developlcy-oss/Lv2_Cartlidar_Assignment/workspace/ros2_ws/src/opencr_firmware/README.md

# opencr_firmware — OpenCR 보드 펌웨어 (Firmware 팀)

로봇에는 OpenCR 이 **2대** 있고, 같은 소스(`opencr_firmware.ino`)를 **역할별로 따로 빌드**해서 올린다.
두 보드의 펌웨어는 서로 바꿔 올리면 안 된다 — 빌드할 때 역할을 꼭 지정해야 하고(기본값 없음), 지정하지 않으면 빌드가 실패한다.

## 한눈에 — 주행 보드 vs 팔 보드

| | **주행 보드 (역할 1)** | **팔 보드 (역할 2)** |
|---|---|---|
| 빌드 | `tools/build_firmware.sh wheel` | `tools/build_firmware.sh arm` |
| 결과 파일 | `~/opencr_builds/opencr_wheel_v5.bin` | `~/opencr_builds/opencr_arm_v5.bin` |
| 빌드 옵션 | `OPENCR_BOARD_ROLE=1` | `OPENCR_BOARD_ROLE=2` |
| 모터 | 바퀴 XM430-W210 **4개, ID 1~4** | 팔 XM430-W350 6개, ID 11~16 |
| 모드 | Velocity (바퀴 각속도 rad/s) | Position (관절각 rad) |
| 그 밖 | IMU · 배터리 전압 | — |
| 패킷 칸 | 바퀴 칸 0~3 (칸 4 · 5 는 비움) | 팔 칸 6~11 |
| 설정 (`config.h`) | "주행 보드 전용" 구역 | "팔 보드 전용" 구역 |
| 명령 무수신 200 ms | 바퀴 0 | 그 자리에서 HOLD (토크 유지) |
| 호스트에서 명령하는 노드 | `drive_node` (`/cmd_vel` → diff_drive_controller) | `manipulator_node` (arm_controller) |

두 보드는 USB VID/PID · 시리얼 번호가 같아서 포트 이름으로는 구별되지 않는다.
**보드가 보내는 STATE 의 `role` 값(1 = 주행, 2 = 팔)으로 구별한다** — 호스트 플러그인(`opencr_hardware`)도 이 값으로 보드를 찾는다.

지금 보드에 무엇이 올라가 있는지 확인 (포트에 쓰지 않음):

```bash
python3 ../opencr_hardware/scripts/opencr_arm_tool.py monitor --port /dev/ttyACM0 --seconds 2
# 출력의 role=1 → 주행 펌웨어, role=2 → 팔 펌웨어. (주행 보드면 끝에 "팔 보드 v5 가 아님" 으로 끝나는 것이 정상)
```

## 빌드 · 업로드

필요: arduino-cli, OpenCR 보드 패키지 (1.5.3 에서 확인), Dynamixel2Arduino (0.8.2 에서 확인).

```bash
cd workspace/ros2_ws/src/opencr_firmware
tools/build_firmware.sh wheel                          # 주행 보드 펌웨어만 빌드
tools/build_firmware.sh arm                            # 팔 보드 펌웨어만 빌드
tools/build_firmware.sh wheel --upload /dev/ttyACM0    # 빌드 후 업로드 — 보드 역할을 yes 로 한 번 더 확인
```

- Arduino IDE 의 업로드 버튼은 쓰지 않는다 (역할 옵션을 넣을 수 없어 빌드가 실패함).
- 업로드가 `opencr_ld` 에서 멈추면 보드를 **Recovery Mode** 로 넣고 다시 실행: PUSH SW2 를 누른 채 Reset 을 눌렀다 떼고, SW2 를 뗀다 (STATUS LED 가 빠르게 깜빡임).
- PC 에서 포트 권한: `dialout` 그룹 + `../opencr_hardware/udev/99-opencr.rules` (ModemManager 가 포트를 잡지 않게 함).

## 주행 보드 (역할 1)

- 바퀴 4개 (2026-10-26 6륜에서 가운데 2개를 뺌). 칸 순서와 모터 ID:

  | 칸 | 바퀴 | ID | 방향 `WHEEL_DIR` |
  |---|---|---|---|
  | 0 | 왼쪽 앞 | 1 | +1 ★ |
  | 1 | 왼쪽 뒤 | 2 | +1 ★ |
  | 2 | 오른쪽 앞 | 3 | −1 ★ |
  | 3 | 오른쪽 뒤 | 4 | −1 ★ |

  호스트 쪽 같은 순서: `../opencr_hardware/urdf/opencr.ros2_control.xacro` (`wheel_count` 기본 4) · `config/controllers_4wd.yaml`.
- **모터 ID 다시 매기기가 필요하다**: 6륜 때 ID 는 왼쪽 1 · 2 · 3, 오른쪽 4 · 5 · 6 이었다. 가운데(2 · 5)를 뺐으므로 남은 모터를
  3 → 2, 4 → 3, 6 → 4 로 바꾼다 (`tools/dxl_setup`, 모터를 **한 대씩** 연결해서. 같은 ID 가 두 대 있으면 둘 다 바뀜).
  바꾸는 순서 주의: 4 → 3 을 하기 전에 3 → 2 를 먼저 (3 이 비어 있어야 함). 6 → 4 는 4 → 3 다음.
- `WHEEL_DIR` (★): 왼쪽 +1 · 오른쪽 −1 은 모터가 서로 마주 보게 달렸다는 가정이다. **바퀴를 띄운 상태에서 실제 회전 방향을 확인**하고 고친다.
  기준 URDF (urdfv2 `teamrobot.urdf`) 의 바퀴 축은 4개 모두 +y 라 + = 앞. 방향 반전은 `WHEEL_DIR` 로만 하고,
  **모터 Drive Mode 의 반전 비트는 0 으로 둔다** (urdfv2 문서의 "Drive Mode 반전" 은 이 펌웨어에서는 하지 않음 — 둘 다 하면 다시 거꾸로).
- `WHEEL_GEAR = 1.0` **고정** — 펌웨어는 모터 축 기준으로 명령 · 상태를 주고받는다. 증속벨트 (v7 1:2.0, 이전 1:1.5) 같은 기어비는
  호스트 `OpenCRHardware` 가 URDF `wheel_gear` 파라미터로 변환한다 (`drive:=belt|direct`). 여기서 바꾸면 두 번 적용된다.
  `WHEEL_VEL_LIMIT_RAW = 313` (★) = 71.7 rpm = 모터 7.51 rad/s → 바퀴 direct ≈ 0.248 m/s · belt ≈ 0.503 m/s (12 V, v7 1:2.0)
  (URDF 바퀴 한계는 11.1 V 기준 direct 7.33 · belt 14.661 rad/s (v7), #15).
  근거: 2026-11-11 T4 (12.1 V 어댑터, 바퀴 띄움) — 네 바퀴를 같은 속도로 앞 · 뒤 6 s 돌려 회전 수가 맞는 최대가 모터 7.61,
  7.71 부터 가장 약한 바퀴가 먼저 포화되어 어긋남 → 한 단계 아래 7.51. 한계가 포화보다 낮아야 D6 비례 축소가 회전 반경을 지킨다.
  배터리 (11.1 V 이하) 에서는 포화가 더 낮아질 것 (전압 비례 추정 약 7.0 · 10.5 V 약 6.6) → 배터리로 다시 재고 정한다 ★.
- 한계 초과 명령 (D6): 한 바퀴라도 넘으면 **모든 바퀴를 같은 비율로 줄인다** (좌우 속도비 = 회전 반경 유지). 개별 clamp 는 안전망으로 남김.
- 부팅 때 바퀴 모터 설정을 맞춘다 (`prepareWheelConfig`, 토크 OFF 상태에서 다를 때만 EEPROM 에 씀):
  **Drive Mode bit0 (반전) → 0**, **Velocity Limit (주소 44) < 313 이면 → 313**. 쓴 뒤 다시 읽어 맞지 않으면
  `ERR_MOTOR_CONFIG` + `ERR_FAULT` 로 토크를 거부한다. 따로 손으로 설정할 필요 없음 (지금 값 확인: `tools/dxl_setup` 의 `x <id>`).
- 부팅 때 바퀴 토크를 끄고 시작한다. 토크는 호스트가 `TORQUE_ON` 을 보낼 때 켜진다.
- **아직 실물에서 돌려 보지 않았다** (주행 보드 없이 SIL 시험만 함). 첫 실기는 바퀴를 띄우고 저속으로.
- **RC-100 리모컨 (2026-11-13, 주행 시험 조작용)**: 주행 보드의 BT-410 슬레이브 (**UART2 커넥터 = Serial4**, 57600, ROBOTIS `RC100` 라이브러리, 마스터는 RC-100B 에) 에서
  버튼을 읽어 STATE 의 빈 팔 칸에 싣기만 한다 — `pos[6]` = 버튼 비트, `pos[7]` = 마지막 패킷 뒤 ms + 1 (0 = 받은 적 없음,
  `opencr_protocol.h` `RC100_SLOT_*`). 길이 · 오프셋 · 버전 (v5) 은 그대로이고 예전 호스트는 이 칸을 읽지 않는다.
  **펌웨어는 리모컨으로 바퀴를 직접 움직이지 않는다** — 호스트 `rc100_joy` 가 `/joy` 로 바꿔 기존 조이스틱 경로 (teleop · E-stop) 로 보낸다
  (`ros2 launch opencr_hardware base_bringup.launch.py rc100:=true`, 방향 = 이동 · 1 = E-stop · 2 + 3 = 풀기). 시험: SIL `WheelForwardsRc100Buttons`.
  실물 (2026-11-13): RC-100B 는 누르는 동안 약 50 ~ 60 ms 마다 같은 패킷을 되풀이하고, 떼면 버튼 0 패킷을 보낸다.

## 팔 보드 (역할 2)

- 관절 칸 · 모터 ID (2026-10-26 실물 확인, **벤치 임시 매핑 ★** — 팀 규격과 다름, `../../../docs/opencr_v5_change_request.md`).
  칸 = STATE 의 관절 칸 (CMD 의 `arm_pos[0..5]` 와 같은 순서):

  | 칸 | 관절 | ID | 범위 (rad) |
  |---|---|---|---|
  | 6 | joint1 (허리) | 11 | −π ~ π (2026-10-27 arm_bench) |
  | 7 | joint2 (어깨) | 12 | −2.14 ~ 1.6 (대기 자세 포함, A안) |
  | 8 | joint3 (팔꿈치) | 13 | −1.6 ~ 1.60 |
  | 9 | joint4 (손목 굽힘) | 16 | −1.92 ~ 2.0 |
  | 10 | joint5 (손목 롤) | 14 | −2.8 ~ 2.8 |
  | 11 | 6 번째 칸 = **그리퍼 개폐 모터** (이름은 gripper_roll 그대로, 열림 1550 · 닫힘 2650 tick, 닫을수록 증가) | 15 | −0.7946 ~ 0.9541 (양 끝 20 tick 여유) |

  호스트 쪽 같은 범위: `../opencr_hardware/urdf/robot.urdf.xacro` (URDF 팔 한계) · `opencr.ros2_control.xacro` (명령 한계) — `test_robot_description` 이 확인.

- 모터 EEPROM 의 Min/Max Position Limit 도 위 범위와 같게 맞춰 두었다. **부팅 점검이 이를 확인**한다 —
  모터 한계가 펌웨어 범위보다 좁으면 범위 밖 목표를 모터가 조용히 버리기 때문에 (실제로 joint2 가 그랬음) FAULT 로 막는다.
- 위치 게인 (P/I/D, 모터 RAM) 은 `config.h` 의 `ARM_POS_*_GAIN` 을 부팅 때마다 쓰고 다시 읽어 확인한다 (다르면 FAULT).
  지금은 공장값 (P 800 · I 0 · D 0) — 중력 처짐 때문에 실물 튜닝 예정 ★. 6 번째 칸 (그리퍼) 은 I = 0 고정.
- **그리퍼 막힘 보호 (2026-10-27 arm_bench, `safety_core.h` GripGuard)**: 그리퍼 목표가 현재보다 `GRIP_STALL_TICKS` (45) 넘게 앞서 있는데
  `GRIP_STALL_MS` (300 ms) 동안 `GRIP_PROGRESS_TICKS` (8) 도 못 움직이면 = 물체를 잡음 → 목표를 "막힌 자리 + `GRIP_SQUEEZE_TICKS` (33)" 로 고정해 약하게 쥔다.
  호스트가 그보다 덜 닫는 쪽 (열기) 을 명령하면 풀린다. 빈 손으로 멀리 움직이는 중에는 (계단 명령이라도) 막힘이 아니다. HOLD 중에도 돈다.
  ESTOP · 토크 OFF 요청 HOLD 때 그리퍼 목표가 현재에서 45 tick 안이면 (쥐는 중) 그대로 둔다 — 퍽을 놓치지 않게.
  실물에서 퍽을 PWM 100 % 로 1.5 s 쥐다가 MOTOR_HW (과부하 추정) 가 나서 넣음. 위치 P 800 기준 1 tick ≈ PWM 6.25 (33 tick ≈ 23 %).
- 부팅 점검: 그리퍼 모터 EEPROM **PWM Limit ≤ `GRIP_PWM_LIMIT_MAX` (400 = 45 %)** — 공장값 885 면 FAULT (`tools/dxl_setup` 의 `w 15 400`).
- 팔은 명령이 끊기거나 ESTOP 이 와도 **토크를 끄지 않고 그 자리에서 HOLD** 한다 (무거운 그리퍼가 떨어지지 않게).
  HOLD 는 호스트의 REARM (리셋 버튼) 으로만 풀린다. 팔 토크를 끄는 방법은 사실상 전원 차단뿐 — 팔을 받친 뒤 끈다.
- 실기 시험 기록 · 알려진 문제: `../../../docs/arm_bench_test_2026-10-26.md` (중력 처짐 · 게인), `arm_bench_test_2026-10-27.md` (범위 · 그리퍼 결합 · 막힘 보호 실물 시험).
- ROS 없이 팔 보드만 시험: `../opencr_hardware/scripts/opencr_arm_tool.py` (monitor = 읽기만, move = 0.1 rad/s 이하 저속, `--yes` 필요).

## 공통 동작 (프로토콜 v5)

프레임 `FF FD | TYPE | LEN | PAYLOAD | CRC16-LE`, CMD 55 B · STATE 192 B (OpenCR 2대용 `role` 바이트 포함). 자세한 것은 `opencr_protocol.h`.

| 상황 | 주행 보드 | 팔 보드 |
|---|---|---|
| 정상 CMD (역할 · 유한값 · 범위 · seq 통과) | 바퀴 속도 적용 | HOLD 가 아니면 관절 목표 적용 |
| 200 ms 무수신 · 잘못된 CMD 만 옴 | 바퀴 0 (`ERR_CMD_TIMEOUT`) | HOLD (`ERR_HOLD`) |
| `FLAG_ESTOP` | 바퀴 0 | 현재 위치에서 HOLD |
| 부팅 점검 실패 (ID · 모델 · Homing 0 · 위치 한계) | `ERR_MOTOR_CONFIG` + `ERR_FAULT`, 토크 거부 | 같음 |

- `FLAG_REARM` (0x08) 상승 에지 = 팔 HOLD 해제. `ERR_HOLD` 0x40 · `ERR_FAULT` 0x80 은 v5 에서 추가.

### 배터리 · 부저 (두 보드, 2026-11-11)

보드마다 전용 배터리 (LiPo 3S 11.1 V 1800 mAh 5C, 만충 12.6 V — XM430 입력 10 ~ 14.8 V 안). 각 보드가 자기 전원 입력 전압을 10 ms 마다 재서
STATE `battery_v` 로 보내고 (예전에는 주행 보드만), 같은 전압으로 OpenCR 부저 (`BDPIN_BUZZER`, `tone()` — 타이머 인터럽트라 루프를 막지 않음) 를 울린다.
판단은 `battery_alarm.h` (1 초 평균 전압, 기준은 `config.h` "배터리 · 부저").

| 상태 | 조건 | 부저 |
|---|---|---|
| 배터리 없음 (USB 만) | 6 V 미만 | 울리지 않음 |
| 켤 때 · 다시 꽂을 때 | 1.5 s 뒤 평균이 자리 잡으면 | 잔량 1500 Hz: 75 % 이상 4 번 · 50 % 이상 3 번 · 25 % 이상 2 번 · 그 아래 1 번 |
| 저전압 (셀 3.70 V, 휴지 약 12 %) | 11.1 V 미만이 10 s | 2000 Hz 1 번, 30 s 마다 |
| 방전 직전 (셀 3.50 V) | 10.5 V 미만이 3 s | 2500 Hz 3 번, 2 s 마다 |

- 가속 때 잠깐 처지는 전압 (몇 초) 에는 울리지 않는다. 한 단계 위로 돌아오려면 기준 + 0.2 V 위가 3 s 이어져야 한다.
- **비프만 한다** — 모터는 건드리지 않는다. 멈추는 것은 호스트: `/diagnostics` `opencr/battery` 가 위험 (ERROR) → mission 정지.
- 쓰는 중 확인: `ros2 topic echo /battery/wheel` · `/battery/arm` (`sensor_msgs/BatteryState`, 1 Hz) 또는 `/diagnostics` 의 `opencr/battery`
  (주행 · 팔 전압 · 잔량 %). 잔량 % 는 휴지 전압 표 추정이라 주행 중에는 낮게 나온다 ★.
- 기준 전압 · 셀 수는 호스트 `../opencr_hardware/urdf/opencr.ros2_control.xacro` 의 `battery_warn_v · battery_error_v · battery_cells` 와 같아야 한다 (`test_robot_description` 이 비교).
- 전압 측정값은 멀티미터와 아직 비교하지 않았다 ★. 부저를 끄려면 `BATTERY_BEEP_ENABLE 0` (판단 · STATE 전압은 그대로).
- 물리 E-stop 회로는 아직 없다 (`ESTOP_PIN` 은 배선 전이라 풀업으로 "해제" 로 읽힘). 소프트웨어 ESTOP 은 물리 비상정지를 대신하지 않는다.
- 팀 규격 `../../../docs/interfaces.md` 의 승인본 (dev) 은 v3 (OpenCR 1대) 이다. 이 브랜치의 USB 패킷 절은 v5 제안이고,
  바뀐 점은 `../../../docs/opencr_v5_change_request.md` (Controller 팀장 승인 전 — dev/main 병합 금지).

## 파일

| 파일 | 내용 |
|---|---|
| `opencr_firmware.ino` | 펌웨어 본체 (두 역할 공용, `OPENCR_BOARD_ROLE` 로 나뉨) |
| `config.h` | ID · 방향 · 한계 · 주소 · 단위 (공통 / 주행 전용 / 팔 전용 구역) |
| `opencr_protocol.h` | 패킷 정의 — `../opencr_hardware/include/opencr_hardware/opencr_protocol.hpp` 와 **바이트 단위로 같아야 함** (시험이 비교) |
| `safety_core.h` | 안전 판단 (CMD 검증 · 타임아웃 · ESTOP · HOLD/REARM · FAULT · 그리퍼 막힘 GripGuard), Arduino 의존 없음 |
| `battery_alarm.h` | 배터리 잔량 표 · 저전압 비프 판단 (Arduino 의존 없음, 호스트도 같은 잔량 표를 씀) |
| `tools/build_firmware.sh` | 역할별 빌드 · 업로드 |
| `tools/dxl_setup/` | 모터 사전 설정 도구 (탐색 `s` · 정보 `r` · 진단 덤프 `x` · ID `i` · 통신 속도 `b` · 위치 한계 `m` · Homing Offset `o` · PWM 한계 `w`). 토크 ON 명령 없음 |

## 시험

ROS 2 (ros2_control) 가 있는 PC:

```bash
cd workspace/ros2_ws
colcon build --packages-up-to opencr_hardware && colcon test --packages-select opencr_hardware && colcon test-result --verbose
```

`test_firmware_sil` · `test_host_firmware_sil` 은 **실제 이 펌웨어 소스**를 PC 에서 컴파일해 가짜 모터 · 가짜 USB 와 돌린다 (두 역할 모두).
`test_battery_alarm` 은 `battery_alarm.h` (잔량 표 · 비프 판단, 실제 config.h 값) 와 호스트 진단 판정 (`../opencr_hardware/src/battery_status.hpp`) 을 본다.
실물 모터 동작을 보장하지는 않는다. ROS 가 없는 PC 에서 돌리는 방법은 저장소 루트 `CLAUDE.md` 의 "빌드 · 테스트".

## 아직 정하지 않은 것 (★)

- 바퀴: 모터 ID 다시 매기기 (실물), `WHEEL_DIR` 실측, 첫 부팅 때 STATE 에 `ERR_MOTOR_CONFIG` 가 없는지 확인 (실물),
  호스트 diff_drive 한계는 `opencr_hardware/config/drive_<direct|belt>.yaml` 에서 바퀴 한계에 맞춤 (D6 — 펌웨어는 비례 축소로 처리),
  실행 후 `ros2 param get /diff_drive_controller wheel_separation` 이 0.317 (belt) · 0.2744 (direct) 인지 확인 (spawner 두 번째 설정 파일 덮어쓰기, 실물 미확인),
  증속벨트 전류 보호 (설계 README: Present Current 약 0.6 A 초과 시 정지 — 제자리 회전 전류 실측 후 값 결정).
- 팔: 6 번째 칸 (그리퍼 개폐) 의 규격 반영 (Controller — `gripper_roll` 이름 · 팔 궤적의 기본값 0.0), 쥐는 힘 33 tick 확인 · 오래 쥘 때 온도,
  위치 게인 튜닝 (중력 처짐), 정밀 영점, J1 ±180° 배선 꼬임. (그리퍼 다시 결합 · 시작 자세 A안은 2026-10-27 끝)
- 공통: 물리 E-stop 배선, v5 · 4륜의 팀 규격 승인, D3 · D4 (`../../../docs/firmware_safety_analysis.md`).
