developlcy-oss/Lv2_Cartlidar_Assignment/workspace/ros2_ws/src/mission_planner/README.md

# mission_planner — 주사위 기억 로봇 할당 · 적재 · 경로 계획기

발제 v5 (2026-11-04) 미션용. ROS 없이도 돌아가는 Python 모듈 + 명령. 위치 추정 (AMCL · loc_monitor) 은 `localization` 패키지.

| 하는 일 | 파일 |
|---|---|
| 경기장 SDF → 정적 점유 지도 2 장 (주행용 `map_nav`, AMCL 용 `map_amcl`) | `mission_planner/arena.py`, `maps/` |
| 접근 자세표 (시작 박스 · L1 ~ L3 · 출발 구역) | `mission_planner/poses.py`, `config/approach_poses.yaml` |
| 신호 · 바코드 → 그룹, 퍽 → 그룹 할당 (전체 탐색, 비교용 순차 선택) | `mission_planner/allocation.py` |
| 팔레트 적재 · 방문 순서 (일반화 TSP, Held-Karp) | `mission_planner/gtsp.py`, `planner.py` |
| 주행 비용 (A* + 시야선 당기기 + 회전) | `mission_planner/pathcost.py` |

## 쓰는 법

```bash
colcon build --packages-select mission_planner && source install/setup.bash
mission_make_maps                                   # worlds/dice_mission.sdf 가 바뀌면 (지도 · 자세표 다시)
mission_plan --problem config/problem_q1_example.yaml --mode hybrid --out /tmp/plan   # plan.json · signal.json · allocation.json
mission_plan --problem <문제>.yaml --mode compare   # 두 운영 방식 비용 비교
mission_submit --problem <문제>.yaml --out <저장소>/submission/review   # 발제 후 검토 제출물 5 종 (problem.md · signals.json · placement.csv · 할당 정답표 · 검증 기록)
mission_challenge_b --out <저장소>/challenge/B      # 도전 B 제출물 (cases.json · expected.json · results.csv · report.md)
python3 -m pytest test                               # 시험 19 개 (할당 6 건 = 도전 B 형식, GTSP 최적성, 지도 · 자세, 계획)
```

문제 파일 (`config/problem_q1_example.yaml` 형식): `signal` (12 점멸), `barcode` (P2-01 ~ 04), `pucks` (id 0 ~ 11 · color red/green · shape cylinder/box · box 1 ~ 6 · side −1/+1).
`placement.csv` 가 나오면 같은 뜻으로 옮겨 쓴다 (설명용 예제의 색 · 모양은 임의).

## 지도 (문서 좌표)

- 원본 `worlds/dice_mission.sdf` = `urdf_and_usd/waffle_4wd_description/worlds/dice_mission.sdf` 복사본 (발제 좌표 mm / 1000, 원점 = 왼쪽 아래 기둥 중심, +Y 위).
- `map_nav`: 바닥 위 0 ~ 0.45 m 와 겹치는 충돌 형상 전부 (벽판 · 기둥 · 박스 70 mm · 장소 상자 · 신호등 · 바코드 받침). 0.025 m 칸.
- `map_amcl`: LiDAR 스캔면 (바닥 위 0.0748 m = LDS-03 브라켓 v2 base_link z 0.0675 + 0.00725, #249) 을 지나는 것만. 박스 · 장소 상자 (0.07 m) 는 스캔에 안 보여 뺌 (틈 4.75 mm, 실물 확인 필요).

## 접근 자세

- 로봇 외곽 (base_link): 앞 +0.1328 · 뒤 −0.2135 (뒤 카메라 기둥) · 폭 ±0.1676 (바퀴), J1 축 x 0.096. 판정은 격자가 아니라 SDF 원래 형상과 사각형 겹침 (분리축).
- 시작 박스: **두 퍽 (박스 중심 X ±40 mm) 을 잇는 선에 수직인 ±Y 면** (S = 남쪽에서 북쪽 보고, N = 북쪽에서). 두 퍽이 J1 앞 0.266 m · 옆 ±0.04 m (거리 0.270) 로 같아 한 번 서서 둘 다 집음.
  ±Y 가 둘 다 막힌 박스만 ±X 면 (inline → 두 퍽 0.227 / 0.306 m).
  지금 맵: B1 S · B2 S · B3 S/N · B4 S/N · B5 N · **B6 W (inline)** (B6 북쪽은 벽, 남쪽은 B2 와 0.53 m 라 대기 자세가 안 들어감).
- L1 · L2 · L3: 장소 태그 면 (L1 서쪽, L2 북쪽, L3 남쪽). 칸마다 J1 거리 → 수직 (≤ 0.23) / 45° 기울여 (≤ 0.35, 팀 URDF IK).
  L2 는 2026-11-04 확정으로 L1 · L3 과 같은 205 상자 (이전 820 받침대). 세 장소 모두 칸 J1 거리 0.206 ~ 0.332 m (45°, Isaac 칸 놓기 미검증).
- final = 집기 · 놓기 자세 = drive FINE 정렬 자리 (렌즈 → 면 0.13 = 앞 끝 − 면 0.1272, #64 안 A: TFmini 는 0.10 m 안을 못 재 더 붙지 않음), stage = nav2 목표 (standoff = 외곽 + 0.05 가 비고 그 자리에서 제자리 한 바퀴 (여유 0.005) 돌 수 있는 가장 큰 값, 0.45 부터 0.01 m 씩, #135), 출발 구역 = 로봇 중심 (0.734, 0.95), −X.

## 계획 (planner)

할당: R = 빨강, G = 초록, 12 개 모두 → Y 에 넣을 빨강 수 = 빨강 − R, 초록 수 = 초록 − G 로 정해짐. 남는 자유 (Y 모양 · ID) 를 전부 나열해 경로 비용 최소를 고름.
비교용 `allocate_greedy` (ID 순 순차 선택) 는 "한 모양 부족" 사례 (cases_b V3) 에서 실패함.

| mode | 내용 | 팔레트 |
|---|---|---|
| `hybrid` (기본, 팀 결정 2026-11-12) | 박스를 돌며 싣다가 어떤 L 의 퍽이 다 실리면 그 L 에 들러 한 번에 다 내리고 이어 감 (L 은 한 번씩) | 퍽 단위 LIFO (나중 배달 퍽이 아래 = 뒤 열). 칸은 `slots.assign` (아래 #230) |
| `per_location` | L 마다 그 그룹 퍽 박스들을 돌고 → L 에 놓기 (3 번 왕복) | 한 번에 6 개 이하 → 2 · 1 열 8 칸만 |
| `single_load` | 12 개 모두 싣고 → L 3 곳 | **팔레트 v5 (10 칸, 2026-11-13) 에서는 못 씀 → MissionError**. v3 (12 칸) 때: 3 열 → 2 열 → 1 열로 싣고 1 → 2 → 3 열로 꺼냄 |

방문 순서 = 일반화 TSP (박스 = 묶음, 접근 면 = 선택지, Held-Karp 정확해). L 순서 · 열 나누기는 전부 나열.
hybrid: L 배달 순서 (a, b, c) 마다 경로는 꼭 `HOME → C1 → B1 → A → La → C2 → B2 → Lb → C3 → Lc` 꼴 (런 = 한 그룹을 박스 순서 자유로 집기,
C2 는 B1 이 비었을 때만). 그룹마다 Held-Karp 표 (`hybrid._hk`, 같은 그룹 구성은 재사용) 를 numpy 로 만들고 (C1, B1) 모든 조합을 배열로 한 번에 셈.
비용 = 경로 + 3 열 칸 × `ROW3_PENALTY_M` 2.8 m (칸당 약 14 s × 0.2 m/s, 가정). 퍽 단위 완전 탐색 (상태 = 실은 퍽 집합) 과 무작위 14 문제에서 경로가 같음,
계산은 할당 전부 봐도 0.01 s 안팎 (PC, 완전 탐색은 할당 3 개에 약 25 s). 비용표 (`hybrid.Nodes`) 는 World 만들 때 (노드 시작) 미리 셈.
비용 = stage 사이 A* (로봇 반지름 0.19 m 부풀림, 시야선 당김) 길이 + 회전 0.1 m/rad + 들어가고 나오기 2 × (standoff − gap).
놓는 칸 순서 = J1 에서 먼 칸부터. 마지막 L 에서 나머지 L 을 다시 들러 새 관측 (재검증) → 출발 구역.

Q1 예제 (설명용 색 · 모양): hybrid 55.8, per_location 62.6 (경로 비용 m, 팔레트 v5 2026-11-13. v3 12 칸 때 hybrid 53.1 · single_load 54.4).
시간 가정 (0.2 m/s, 정차 15 s, 3 열 칸 +7 s) 으로 Q1 + 무작위 13 문제 평균: hybrid 412 s, per_location 470 s, single_load 481 s (14 문제 모두 hybrid 가 가장 빠름).

## AMCL

실행 · 설정은 `localization` 패키지 (`ros2 launch localization localization.launch.py`, `config/amcl.yaml`, 2026-11-04 이 패키지의 AMCL launch · 설정은 지움 — 둘 다 `/map` 을 내서 함께 띄우면 안 되므로).
아래는 이 패키지가 처음 정한 값의 비교 기록 (지금 팀 설정은 Omni 모델 등 5 개 값이 다름, #91). 시험 (`test/amcl_sim.py`: SDF 형상 광선 추적 스캔 + 지도에 없는 박스 위 퍽 12 개 + 오도메트리 눈금 오차 직진 2 % · 회전 6 %, Q1 경로 44 m, 4 배속):

| 설정 | 위치 오차 평균 / 95 % / 최대 | 방향 오차 최대 | 갱신 |
|---|---|---|---|
| **이 설정** (`map_amcl`) | **16 / 24 / 35 mm** | **1.7°** | 1778 |
| 같은 설정 + 박스 넣은 지도 | 17 / 25 / 35 mm | 1.8° | 1778 |
| nav2 기본값 (sigma_hit 0.2, alpha 0.2, update_min_d 0.25 …) | 32 / 69 / 134 mm | 6.0° | 505 |
| 오도메트리만 | 최종 1110 mm | | |

시뮬레이션 결과 (가짜 스캔) — 실물은 벽판 설치 오차 · LDS 잡음 · 바퀴 미끄럼으로 커질 수 있음. 출발 구역에서 시작 자세를 정확히 놓는 것이 전제 (전역 위치 찾기 안 함).

## mission_node 연동 (plan 모드)

```bash
ros2 launch mission_planner planner.launch.py pucks_file:=<퍽 등록표>.yaml [mode:=hybrid] [log_dir:=/tmp/mission_log]
ros2 launch mission mission_bringup.launch.py                    # 기본 source:=plan = mission_plan.yaml 덧씌움 (옛 태그 미션표는 source:=tag)
ros2 service call /mission/start std_srvs/srv/Trigger
```

흐름: `observe` (팔 TAG_VIEW → READ_SIGNAL | READ_BARCODE → /perception/signal CONFIRMED + /perception/barcode READ)
→ `plan` (/mission_planner/plan, std_srvs/Trigger → 단계 문장) → 계획 단계 실행.
robot_interfaces 는 동결 (바꿀 때는 docs/interfaces.md PR + Controller 승인, #160 에서 AlignBase `box_only` 추가). 계획 단계 (`mission_planner/mission_lines.py`):

| 단계 | mission_node 동작 |
|---|---|
| `goto x y yaw` | /drive/navigate (지도 좌표) + 팔 STOW |
| `approach 0.13` | 기존 approach (COARSE → READY → FINE, TFmini 하한 0.13). 집기 (퍽이 있는 박스) 앞 |
| `approach_box 0.13` | 장소 상자 앞 (놓기 · verify, #160): 주행 자세 → /drive/align `box_only` (퍽 없이 지금 방향 유지 + TFmini 로 면 0.13 m). 남는 좌우 · 각도는 measure_box |
| `skill manipulator <이름>` | /manipulator/execute_skill (manipulator_node). 집기 · 놓기는 모두 집게 45°: `target_look:base_footprint:x:y:z` (집기 전 팔 카메라로 퍽을 내려다보고 재서 붙잡음, 회전 뒤 예상 위치 `poses.puck_after_turn`, #82) → `toppick_tilt` (그 위치로 45° 집기), `pallet_load_<열>_<칸>_tilt`, `pallet_unload_<열>_<칸>_tilt` (속도 규칙 #75), `place_<L>_<dx>_<dy>_tilt` (dx, dy = m1 · 0 · p1) |
| `skill drive turn_<p\|m>17` · `turn_0` | /drive/execute_skill — drive_node (#77, 실제 회전 중심 보정 `base.icr_x` = control robot_geometry.yaml). 상자 퍽을 집기 전 FINE 정렬 방향에서 로봇 중심 둘레로 ±17° 제자리 회전 (J1→퍽 = 박스 축 = 퍽 면, ±3°), 집고 실은 뒤 `turn_0` 으로 되돌림. inline (박스 6) 은 회전 없음 |
| `verify L cx cy z expect9 yshape` | 팔 TAG_VIEW → READ_TAG+SEARCH_FRONT → /perception/check_dice (지도 좌표 칸) + /perception/pucks 로 칸별 퍽 ID · 위치 → 기록, 틀려도 계속 (stop_on_fail false) |
| `wait 3` | 복귀 뒤 정지 |

기록: 미션 (/mission/start 로 새로 시작) 마다 mission_node `<log_dir>/<YYMMDD_HHMM>/` 한 폴더 (bringup 기본 log_dir `~/Lv2_Cartlidar_Assignment/mission_log`, 같은 분이면 `_2`, PAUSED 재개는 같은 폴더) 에
mission_log.jsonl (observe · survey · plan · verify (칸 판정 · 칸별 퍽 ID · 위치) · verify_ids (마지막 verify 뒤 12 개 ID 중복 · 누락 판정) · snapshot · finish),
images/ (팔 카메라 사진 사건당 3 장: 이동 전 `<NN>_before_r<회차>_B<박스>_<k>.jpg` = survey_view, 이동 후 `<NN>_after_<L>_<k>.jpg` = verify),
planner/ (계획기 log_dir = `<log_dir>/planner` 의 signal.json · allocation.json · plan.json · mission_lines.txt 를 plan 성공 뒤 복사),
pucks_survey.yaml · 측량 완료 파일 사본. 영상 전체 녹화는 하지 않는다 (최종 제출 전체 영상은 따로).
실패: 점멸 MISMATCH · 미등록 바코드 · 풀 수 없는 문제 = 재시도 없이 FAILED (발제: 오류 기록 후 안전 정지). 그 밖의 단계는 max_retries 재시도.

연동 시험 (`test/mock_robot.py` = 가짜 drive · manipulator · perception): Q1 예제로 /mission/start → DONE (단계 93, 주행 18 · 정렬 30 · drive skill 8 (turn) · manipulator skill 48 · check_dice 3, 26 s),
skill 거절 → 재시도 2 번 뒤 FAILED, 미등록 바코드 → 바로 FAILED.
장소 상자 재기 (#73, 2026-11-04, mock 이 상자를 2 cm · 5° 밀고 돌려 odom 으로 냄, map -> odom 10°): L1 · L2 · L3 마다 첫 pallet_unload 앞 measure_box 1 번,
place_<L>_* 12 개 → place_at:odom (손 계산과 같음), check_dice 3 번 odom 칸 → DONE. --box_fail (측정 실패) → 지도 좌표 그대로 DONE.

Gazebo 주행 연동 (`test/gazebo_mission.sh`, 2026-11-07): 주행만 진짜 (Gazebo 경기장 · Nav2 + AMCL · drive_node), 팔 · 인식 · 정렬 · 회전은 `mock_robot.py --real_nav`.
Q1 예제 105 단계 **DONE** (sim 약 455 s): goto 18 번 모두 도착 (AMCL 추정 기준 xy 31 ~ 112 mm, 중앙값 48 mm, yaw 최대 5.3°),
재시도 1 번 ([14] 첫 시도 "Goal was in lethal cost").
지난번 (2026-11-06) 에는 B3:N → L3 접근이 북쪽 통로 기둥 옆에서 갇혀 [88] 에서 FAILED. 대기 자리 standoff 0.35 → 0.40 으로 해결 (#135).
남은 여유는 작음: 기둥 옆 71 mm, 제자리 회전 8 mm. 실제 회전 중심 확인 전 (#49).

## 남은 것 · 주의

- `placement.csv` 가 나오면 문제 파일로 옮겨 계획을 다시 돌릴 것. 경기장 설치 실측이 발제 좌표와 다르면 SDF (generate_world.py) 를 고치고 `mission_make_maps`.
- 모든 집기 · 놓기 45° (2026-11-03): 팔레트 v5 10 칸 (열마다 4 · 4 · 2, 2026-11-13) 은 Isaac 놓기 · 꺼내기 24/24 (#75 때 v3 12 칸도 24/24). 박스 위 집기 · L 칸 놓기 45° 와 상자 퍽 ±17° 회전 집기는 Isaac · 실물 확인 전.
  J1 거리 범위 0.12 ~ 0.35 m (윗면 70 mm). 모든 final = FINE 자리 (앞 끝 - 면 0.1272, #64 안 A): 박스 퍽 J1 0.270 m, inline 0.227 / 0.306, L1 · L2 · L3 칸 0.206 ~ 0.332 m.
  TopPick 다시 학습 필요 (#78): tilt_prob 1.0, 실제 배치 gap 0.1272, 회전 뒤 상자 퍽은 옆 퍽이 접선 방향. 회전 skill 은 drive #77.
- per_location 은 팔레트 2 · 1 열 8 칸만 씀 (3 열 놓기는 쥔 구간 0.4 rad/s 라 칸당 약 6 s 더 걸림). hybrid 는 동시에 8 개를 넘을 때만 3 열 (벌점으로 피함).
- 누운 퍽 순서 (#193): 등록표 `pose` (standing | lying, 없으면 standing — 측량 등록표 그대로) 를 읽어 같은 박스는 세운 퍽을 먼저 집음.
  같은 정차는 세운 퍽부터 (모든 방식). hybrid 는 런 나누기에서 어기는 후보를 빼서 늘 지킴 (무작위 40 문제: 18 문제 경로가 바뀜, 평균 +0.66 m · 최대 +4.1 m).
  per_location · single_load 는 정차 사이 순서를 보장하지 않아 어기면 경고. inline 박스 (B6 W 면) 에서 먼 세운 퍽을 먼저 집게 되면 경고 (실물 확인).
  미션 줄은 누운 퍽도 아직 `toppick_tilt` (누운 퍽 스킬 연결은 #193 에서 정함, 계획 경고로 알림).
- 싣지 않을 팔레트 칸 (`avoid_slots`, #219): `'열:칸,…'` (예 `2:1,2:2`). 팔레트 v3 · 예전 DRIVE 때 팔꿈치가 G_2 · G_3 퍽에 닿아 만든 우회책.
  2026-11-13 DRIVE = E2 (1796d70, v5 퍽 15 mm) 로 닿는 칸이 없어 기본 빈 값 그대로 씀. 실물에서 닿는 칸이 나오면 그때 지정.
  `mission_plan --avoid_slots` · `planner.launch.py avoid_slots:=` · bringup `planner_avoid_slots:=`, 기본 빈 값 (모두 씀).
  hybrid 는 칸 배정에서 건너뛰고 1 · 2 열 칸 수 (3 열 벌점 기준) · 최대 적재를 줄임, per_location 은 칸 목록에서 빼고 모자라면 3 열,
  single_load 는 v5 10 칸이라 늘 오류. G_2 · G_3 을 빼면 Q1 은 그대로, 무작위 30 문제 hybrid 평균 +0.78 m (최대 +4.5 m), 3 열 사용은 같음.
- 팔레트 칸 모양 · 막는 쌍 (#230, **팔레트 v5 로 다시 정함 2026-11-13**): 칸마다 모양이 정해져 있음 (`slots.SLOT_SHAPE` = control `pallet_place_traj.json`, 10 칸).
  v5 Isaac (팀 URDF · 놓기 궤적, `urdf_and_usd/policy/pallet_v5` 시험본): 칸마다 원기둥 · 직육면체 모두 놓기 · 꺼내기 24/24 → **모양 다름만으로는 실패 없음**.
  이웃 퍽이 손가락에 닿아 밀리는 것은 1 열 바로 옆 칸뿐 (손가락 ↔ 이웃 직육면체 −1.0 mm, 벌림 34 mm 로 줄여도 −0.1) →
  막는 쌍 `slots.BLOCKERS` (꺼낼 칸 ← 먼저 비어야 할 칸): **1_0 ← 1_1, 1_1 ← 1_0, 1_2 ← 1_3**. 2 · 3 열은 칸 사이 5.2 mm 라 +1.5 mm 이상 (v3 의 3_0 ← 3_1 · 2_1 ← 2_2 등은 없어짐).
  같은 열 · 뒤 열을 모두 채운 최악 조건 꺼내기: v3 11/48 · v5 17/40 (원기둥은 Isaac 쥐기 잡음이 커서 상자 퍽 · 이웃이 밀렸는지로 판단).
  벌점 (`hybrid.py`): 2 · 3 열 모양 다름 `SHAPE_PENALTY_M` 2.8 m (3 열 칸 하나 값), 1 열 모양 다름 `SHAPE_PENALTY_ROW1_M` 28 m (원기둥 칸에 든 직육면체가 옆 칸을 막음),
  막힌 채 꺼내기 `BLOCK_PENALTY_M` 28 m. v3 때는 모양 다름 · 막힘 모두 28 m (팔 쪽 추정).
  `slots.assign` (방식 공용) 이 싣기 · 내리기 차례는 그대로 두고 칸을 고름: 열 규칙은 꼭, 그다음 (모양 · 막힘 벌점 + 3 열 칸 × 2.8 m) → 예전 배정과의 차이 순으로 작게
  (분기 한정 탐색, 열 안 차례가 자유면 퍽마다 열 3 가지만 분기하고 열 안은 벌점이 가장 적은 칸). 같은 장소에서 함께 내리는 퍽은 막는 칸이 빈 것부터, 같으면 `UNLOAD_PREF`.
  hybrid 탐색은 모양별 동시 적재가 그 모양 칸 수를 넘으면 퍽마다 `SHAPE_PENALTY_M` (추정) 이라 점수 상위 할당 10 개는 실제 칸 배정 값으로 다시 고름.
  같은 열 안 차례 `row_rule`: `free` (기본) | `fixed` (ROW_ORDER 1,2,0,3, 없는 칸은 건너뜀). 모양 맞추기 끄기 `mission_plan --no_shape_slots` (비교용). 못 맞춘 퍽 · 막힌 퍽은 경고.
  Q1 + 무작위 100 문제 (v5): 막힌 꺼내기 0 (hybrid · per_location), 3 열 사용 hybrid 0.57 · per_location 0.18 칸 (v3 28 m 때 0.85 · 0.51),
  모양 다름은 2 · 3 열에만 (hybrid 1 열 1 번), 경로 평균 hybrid 49.6 m (v3 49.4).
- 시작 박스가 돌아 놓일 때 (#226, 가정 ±45°): 박스 접근마다 `turn_range_deg` (접근 자세표 · pick 단계) = 집기 자리에서 로봇 중심 둘레로 돌아도
  외곽 + 1 cm 가 안 닿는 범위 (박스 요 −45 ~ +45° 를 15° 마다 돌려 본 교집합). 지금 경기장은 모든 박스 접근이 ±45° (가까운 것은 대상 박스뿐,
  여유 5 cm 면 ±28°). mission 이 잰 상자 요 β 로 `turn_deg + β` 를 정하고 이 범위 · drive `turn.max_deg` 30° 로 자르면 됨.
  상자가 돌면 퍽도 박스 중심 둘레로 0.08 sin(β/2) (45° 에서 31 mm) 옮겨지므로 target_look 예상 자리는 잰 상자로 다시 셈 (match_distance 0.04).
- 45° 로 놓은 상자 퍽은 칸에서 J1→칸 방향으로 돌아 앉음 (L1 · L3 최대 23°, L2 16°). 칸 판정에 퍽 방향이 들어가는지 확인.
- manipulator: 위 skill 이름은 manipulator_node 에 있음 (PR #94, 팔레트 구간 순서는 #75 Isaac 확인본). 팔레트 궤적 원본은 `urdf_and_usd/policy/manipulator/pallet_place_traj.json`.
- approach FINE 자리를 그대로 집기 · 놓기 자세로 씀 (#64 안 A). TFmini 는 0.10 m 안을 못 재 obstacle_stop 이 막으므로 더 붙지 않음.
  BOX_VIEW (상자 내려다보기) 가 이 자리 (상자 중심 base x 0.3625) 에서 윗면을 다 보는지 실물 확인 (perception place_box.prior 도 0.3625).
- observe · verify 팔 자세 (TAG_VIEW) 는 바코드 · 칸을 볼 수 있는지 실물 확인 (mission_plan.yaml observe.arm_pose · verify.arm_pose).
