developlcy-oss/Lv2_Cartlidar_Assignment/challenge/B/report.md

# 도전 B. 퍽 할당 알고리즘 비교

- 날짜: 2026-11-09 · 환경: Python 3.12.3 · x86_64
- 사례: `cases_b.yaml` 6 건 (유효 4 · 불가능 2). 불가능 사례는 소프트웨어 오류 시험용 (공식 출제 아님)
- 입력 순서: 퍽 ID 0 ~ 11 (박스 = id // 2 + 1, 짝수 X − 40 · 홀수 X + 40). ID 와 색은 고정 대응 아님
- 정렬 규칙: P2-01 · P2-03 오름차순, P2-02 · P2-04 내림차순, 동률이면 R → Y → G
- 실행 시간: 사례마다 200 번 돌린 평균 (ms)

## 방식

| 방식 | 코드 | 내용 |
|---|---|---|
| 순차 선택 (기본) | `mission_planner/allocation.py` `allocate_greedy` | R 은 빨강을, G 는 초록을 ID 순으로 먼저 가져가고 남은 것을 Y 로. 남은 것이 섞이면 실패 |
| 탐색 (개선) | `mission_planner/allocation.py` `y_options` + `enumerate_allocations` | Y 에 들어갈 빨강 수 = 빨강 − R, 초록 수 = 초록 − G 로 정해짐 → Y 모양 (2 가지) 마다 같은 색 · 모양 안에서 ID 조합 전부 나열. 불가능이면 먼저 명시적 오류 |

## 결과

| 사례 | 방식 | 판정 | 시간 ms | L1 | L2 | L3 | Y 모양 | 실패 원인 |
|---|---|---|---|---|---|---|---|---|
| V1_Q1_오름차순 | sequential | **실패** | 0.0017 |  |  |  |  | 순차 선택 실패: 남은 Y 후보 모양 ['box', 'cylinder'] |
| V1_Q1_오름차순 | search | 통과 | 0.0043 | 0 4 | 2 6 8 10 | 1 3 5 7 9 11 | cylinder |  |
| V2_동률_내림차순 | sequential | **실패** | 0.0016 |  |  |  |  | 순차 선택 실패: 남은 Y 후보 모양 ['box', 'cylinder'] |
| V2_동률_내림차순 | search | 통과 | 0.0047 | 2 3 4 5 | 0 1 6 7 | 8 9 10 11 | cylinder |  |
| V3_한모양_부족_순차실패 | sequential | **실패** | 0.0017 |  |  |  |  | 순차 선택 실패: 남은 Y 후보 모양 ['box', 'cylinder'] |
| V3_한모양_부족_순차실패 | search | 통과 | 0.0049 | 0 2 5 | 8 9 10 11 | 1 3 4 6 7 | cylinder |  |
| V4_내림차순_Y6 | sequential | 통과 | 0.0013 | 3 4 5 9 10 11 | 0 1 2 | 6 7 8 | box |  |
| V4_내림차순_Y6 | search | 통과 | 0.0056 | 0 1 2 6 7 8 | 3 4 5 | 9 10 11 | cylinder |  |
| X1_불가능_색수부족 | sequential | 통과 | 0.0012 |  |  |  |  | 빨강 · 초록 수 부족 |
| X1_불가능_색수부족 | search | 통과 | 0.0008 |  |  |  |  | 빨강 2 · 초록 10 로는 R 3 · G 6 를 못 채움 |
| X2_불가능_한모양없음 | sequential | 통과 | 0.0019 |  |  |  |  | 순차 선택 실패: 남은 Y 후보 모양 ['box', 'cylinder'] |
| X2_불가능_한모양없음 | search | 통과 | 0.0017 |  |  |  |  | Y 6 개를 한 모양으로 못 만듦 (Y 에 빨강 5 · 초록 1 필요) |

## 요약

| 방식 | 통과 / 6 | 유효 4 건 성공 | 불가능 2 건 명시적 오류 | 평균 시간 ms |
|---|---|---|---|---|
| sequential | 3 | 1 / 4 | 2 / 2 | 0.0016 |
| search | 6 | 4 / 4 | 2 / 2 | 0.0037 |

## 순차 선택: 사례별 성공 · 실패 이유

- V1_Q1_오름차순: **실패** — 순차 선택 실패: 남은 Y 후보 모양 ['box', 'cylinder']. 탐색 방식은 Y 모양을 먼저 정해 같은 퍽으로 성공
- V2_동률_내림차순: **실패** — 순차 선택 실패: 남은 Y 후보 모양 ['box', 'cylinder']. 탐색 방식은 Y 모양을 먼저 정해 같은 퍽으로 성공
- V3_한모양_부족_순차실패: **실패** — 순차 선택 실패: 남은 Y 후보 모양 ['box', 'cylinder']. 탐색 방식은 Y 모양을 먼저 정해 같은 퍽으로 성공
- V4_내림차순_Y6: R · G 를 ID 순으로 가져간 뒤 남은 Y 후보 [3(rb), 4(rb), 5(rb), 9(gb), 10(gb), 11(gb)] 가 모두 box

## 결론

- 탐색 방식: 유효 4 건 모두 12 개를 중복 · 누락 없이 할당, 불가능 2 건은 할당 전에 y_options 에서 원인을 밝힌 명시적 오류 (안전 정지).
- 순차 선택: 유효 사례 3 건 실패 (V1_Q1_오름차순, V2_동률_내림차순, V3_한모양_부족_순차실패). R · G 가 ID 순으로 먼저 가져가면서 Y 에 필요한 모양을 써 버려 남은 후보 모양이 섞임.
- 순차 선택도 불가능 2 건에서 오류를 내지만, 할당 가능 여부를 먼저 따지지 않아 "불가능한 문제" 와 "순서 때문에 실패" 를 구별하지 못한다 (V1 · X2 의 실패 원인 문구가 같음).
- 12 개라 탐색 비용은 작다 (조합 수 = 같은 색 · 모양 안 선택뿐). 경기 계획기는 이 나열에서 경로 비용 최소를 고른다 (`planner.plan`).

## 파일

- `cases.json` 입력 6 건 · `expected.json` 기대 결과 · `results.csv` 방식 × 사례 12 행
- 다시 만들기: `ros2 run mission_planner mission_challenge_b --out challenge/B`
