developlcy-oss/Lv2_Cartlidar_Assignment/workspace/docs/frames_tf.md

# 좌표 (TF) · 카메라 연결 규약

실물과 Isaac Sim 이 같은 프레임 이름 · 토픽 · 축 규약을 쓰게 하는 기준이다 (2026-10-28, tutor-s-robot `docs/CAMERA_AND_TF.md` 형식 참고).
URDF 는 `opencr_hardware/urdf/robot.urdf.xacro`. 시뮬레이션 참고본 (`~/Downloads/urdf_test/`):

| 참고본 | 쓰는 것 |
|---|---|
| `waffle_4wd_usd_261027_1711/waffle_4wd/waffle_4wd.usda` | Isaac Sim 6.2 시뮬레이션 USD (`workspace/tools/isaac_sim/waffle_bridge.py`) |
| `urdf_261027_1711/waffle_4wd_description_261027_1711/` | 위 USD 의 원본 URDF. 센서 프레임 근거는 `simulation_metadata.json` |
| `URDF_USD_IsaacSim62_v4/` | URDF → USD 변환 규칙 (`code/convert_urdf62.py`). `output/robot.urdf` (10-22) 는 LiDAR roll 0 인 옛 값이라 근거로 쓰지 않는다 |

## 축

- `base_link`: +X 앞 · +Y 왼쪽 · +Z 위 (ROS REP 103). 원점 = 하판 윗면 중심, 바닥 위 56.25 mm.
- 광학 프레임 (`*_optical_frame`): +X 영상 오른쪽 · +Y 영상 아래 · +Z 앞 (보는 방향). 몸체 프레임 기준 rpy (-π/2, 0, -π/2).

## 프레임

| 프레임 | 부모 | 발행 | 쓰는 곳 | 상태 |
|---|---|---|---|---|
| `map` → `odom` | — | slam_toolbox | nav2 | |
| `odom` → `base_link` | — | **ekf 만** (diff_drive `enable_odom_tf: false`) | perception · manipulator (`fixed_frame`) | |
| `base_footprint` | base_link | robot_state_publisher (URDF) | perception 찾기 · 바코드 (`base_frame`) | |
| `imu_link` | base_link | URDF | imu_sensor_broadcaster · ekf | 뒤집어 장착 반영 (roll π) |
| `laser_front` · `laser_rear` | base_link | URDF | LiDAR 드라이버 frame_id · slam_toolbox | ★ roll π 미적용, 이름 · 위치 추후 확정 |
| `camera_front_link` · `camera_rear_link` | base_link | URDF | — | ★ C: 이름 불일치 |
| `top_camera_front_link` → `top_camera_front_color_optical_frame` (뒤도 같음) | (URDF 에 없음) | realsense2_camera (`<camera_name>_link` 아래만) | perception D435 | ★ C: base_link 와 끊김 |
| `arm_base_link` → `link1` ~ `gripper_roll_link` | base_link | URDF + /joint_states | manipulator (`arm_base_frame`) | |
| `arm_camera_link` → `arm_camera_optical_frame` | gripper_roll_link | URDF | Arducam UVC 드라이버 frame_id · perception 태그 | 그리퍼 장착 확인 (2026-10-28) |
| `tfmini_link` | gripper_roll_link | URDF | manipulator (`tfmini_frame`) | ★ 차체 1층 플레이트로 옮길 것 (위치 실측) |
| `tool_link` | gripper_roll_link | URDF | manipulator | |

## 저장소 ↔ USD (261027) 대응

| 저장소 | USD 261027 | 비고 |
|---|---|---|
| `base_link` (뿌리) → `base_footprint` (z -0.05625) | `base_footprint` (뿌리) → `base_link` (z +0.00675) | **부모 · 자식 방향이 반대.** 저장소 방향을 유지한다 (ekf 가 `odom → base_link` 를 발행하므로 base_link 가 뿌리여야 부모가 하나) |
| `top_camera_front_link` · `top_camera_rear_link` | 같은 이름. 아래에 `_optical_frame` → `_infra1/2_optical_frame` · `_color_optical_frame` | 원점 규약이 다름 (아래 D435 원점) |
| `arm_camera_link` → `arm_camera_optical_frame` | `camera_link` → `camera_optical_frame` (arm_link_5 아래) | Arducam |
| `laser_front` · `laser_rear` | `lidar_front` → `lidar_front_scan` (뒤도 같음) | 드라이버 frame_id 이름 추후 확정 |
| `imu_link` | 없음 | 브리지가 저장소 `imu_link` 축으로 계산해 `/imu/data` 발행 |
| `tfmini_link` | 없음 | 시뮬레이션에 TFmini 센서 없음 |
| 관절 `wheel_{left,right}_{front,rear}_joint` · `joint1~5` · `gripper_roll` | `Wheel_Revolute_*` · `RMX52_*` (팔 부호 반대) · 손가락 `gripper_left/right_joint` | 대응 · 부호 · 그리퍼 변환은 `waffle_bridge.py` |

### D435 원점 (C 를 고칠 때)

- realsense2_camera 의 `<name>_link` 는 **깊이 원점 = 왼쪽 IR (infra1)** 이다. 드라이버가 컬러를 거기서 몸체 +y 약 0.015 m 에 발행한다.
- USD · 261027 의 `top_camera_*_link` 는 **두 IR 렌즈 가운데** (CAD 렌즈 원통 중간점) 다. infra1 은 몸체 +y 0.025 m (USD 확인: 앞 +0.0250, 뒤 -0.0250 — 뒤는 요 180°).
- 그래서 저장소 URDF 의 `top_camera_*_link` 는 261027 link 위치가 아니라 **infra1 위치** (앞 y +0.025, 뒤 y -0.025 만큼 옮긴 곳) 에 둔다. 그대로 쓰면 실물에서 컬러가 25 mm 어긋난다.
- 261027 의 컬러 외부보정 (`_optical_frame` 기준 (-0.04012, 0.00007, -0.00018), rpy (-0.0064, -0.0035, 0.0037)) 은 실물 D435 serial 261822072247 공장값 (rs-enumerate-devices -c, 2026-10-22). 둘째 D435 도 같다고 가정. 실물에서는 드라이버가 자기 공장값을 발행한다.

### 위치값을 그대로 옮기지 않는다

USD 위치는 저장소 URDF 와 기준이 달라 값을 바로 쓰지 않는다 (★ 어느 쪽이 실물인지 확인 필요).

| 항목 | 저장소 | USD 261027 |
|---|---|---|
| base_link 원점 높이 | 바닥 위 56.25 mm | 바닥 위 6.75 mm |
| 바퀴 | x ±0.100, y ±0.1585 (belt, 간격 0.317) | x ±0.08, y ±0.1546 (간격 0.3092) |
| D435 기울기 | `camera_*_link` 0.35 rad (자리값) | 35.2° (0.6144 rad) |
| LiDAR 스캔 프레임 | (±0.15, 0, 0.08) | (±0.1855, ±0.05, 0.0609) — 중심에서 옆으로 50 mm |

## 적용할 것 (주석으로 남김)

| 항목 | 내용 | 위치 |
|---|---|---|
| C | realsense 의 TF 뿌리는 `<camera_name>_link` (`top_camera_front_link` · `top_camera_rear_link`, infra1 = 깊이 원점). URDF 는 `camera_front_link` · `camera_rear_link` 라 `base_link → top_camera_*_color_optical_frame` 이 끊겨 perception `tf_->fixed()` 가 실패한다. 위치는 위 D435 원점대로 | robot.urdf.xacro, test_robot_description.cpp |
| LiDAR roll π | LDS-03 은 3층 아래에 뒤집어 매달림 (261027 `simulation_metadata.json`: "LDS hangs upside down under floor 3 in CAD and hardware", USD `lidar_*_scan` roll 180°). 미적용이면 스캔 좌우가 뒤집힌다. 이름 · 위치와 함께 추후 확정 | robot.urdf.xacro |
| TFmini | 차체 1층 플레이트 장착 (2026-10-28 확인). 261027 · USD 에 프레임이 없어 위치는 실측. 옮기면 manipulator pick ① `range_offset` 가정을 다시 본다 | robot.urdf.xacro, manipulator.yaml, test_robot_description.cpp |
| A | manipulator STOW joint3 -2.3 이 펌웨어 범위 밖 → STOW 명령 거부 | manipulator.yaml |
| B | manipulator `lower/upper_limits` 가 URDF · config.h 보다 넓음 | manipulator.yaml |

## TF 발행 원칙

- 한 변환은 한 노드만 발행한다. `odom → base_link` 는 ekf, `map → odom` 은 slam_toolbox.
- realsense2_camera 는 `<camera_name>_link` 아래 (`_color_optical_frame` 등) 만 발행한다. URDF 는 그 아래 프레임을 만들지 않는다 (시험이 확인).
- 시뮬레이션의 정답 자세 (ground truth) 는 `/tf` 에 넣지 않는다. `sim_world` 프레임이나 별도 토픽으로 기록해 추정값과 비교한다.
- 로봇 TF 는 실물 · 시뮬레이션 모두 robot_state_publisher 가 저장소 URDF 로 만든다. 시뮬레이션은 `sim:=true` 로 TopicBasedSystem 이 `/isaac_joint_states` 를 받아 joint_state_broadcaster 가 `/joint_states` (저장소 이름) 를 내므로 팔 · `arm_camera_optical_frame` TF 도 같은 방식으로 생긴다.
- 시뮬레이션에는 realsense 드라이버가 없으므로 **브리지가 드라이버 대신 `top_camera_*_link → top_camera_*_color_optical_frame` 을 `/tf_static` 으로 발행**한다 (값은 위 D435 원점 · 공장 외부보정, 실물 드라이버와 같은 관계).
- C 를 고치기 전까지 시뮬레이션 시험은 임시로 잇는다 (`camera_*_link` 는 자리값이라 위치는 USD 카메라와 다르다):

  ```bash
  ros2 run tf2_ros static_transform_publisher --frame-id camera_front_link --child-frame-id top_camera_front_link
  ros2 run tf2_ros static_transform_publisher --frame-id camera_rear_link --child-frame-id top_camera_rear_link
  ```

## Isaac Sim 발행 규약

`workspace/tools/isaac_sim/run_bridge.sh` (Isaac Sim 6.2 단독, 내장 jazzy rclpy) ↔ 호스트 `ros2 launch bringup bringup.launch.py sim:=true use_sim_time:=true use_teleop:=false`.

| 토픽 | 방향 | 타입 | frame_id · 내용 |
|---|---|---|---|
| `/isaac_joint_states` | Isaac → 호스트 | sensor_msgs/JointState | 저장소 관절 이름 (TopicBasedSystem 이 받음) |
| `/isaac_joint_commands` | 호스트 → Isaac | sensor_msgs/JointState | 바퀴 velocity · 팔 position. 0.5 s 끊기면 바퀴 정지 |
| `/clock` | Isaac → 호스트 | rosgraph_msgs/Clock | 시뮬레이션 시간 |
| `/imu/data` | Isaac → 호스트 | sensor_msgs/Imu | `imu_link` (뒤집어 단 보드 축) |
| `/e_stop` | Isaac → 호스트 | std_msgs/Bool | false 10 Hz (실물은 OpenCRHardware) |
| `/top_camera_front/color/image_raw` · `/color/camera_info` | Isaac → 호스트 | Image · CameraInfo | `top_camera_front_color_optical_frame` |
| `/top_camera_front/aligned_depth_to_color/image_raw` | Isaac → 호스트 | Image 32FC1 m (컬러와 같은 크기, 맞은 곳 없으면 0) | `top_camera_front_color_optical_frame` |
| `/top_camera_rear/...` | Isaac → 호스트 | 위와 같음 | `top_camera_rear_color_optical_frame` |
| `/arm_camera/image_raw` · `/arm_camera/camera_info` | Isaac → 호스트 | Image · CameraInfo | `arm_camera_optical_frame` |

카메라 · 깊이 줄은 아직 브리지에 없다 (규약만).

- 토픽 · frame_id 는 실물 드라이버와 같은 이름 (perception.yaml 을 바꾸지 않고 쓰기 위해).
- Isaac 카메라 prim 은 link 가 아니라 **컬러 광학 프레임 위치** (USD `top_camera_*_color_optical_frame`, link 에서 약 40 mm) 에 둔다. 그래야 영상과 TF 가 맞는다.
- CameraInfo 는 렌더러 값으로 계산한다: fx = 폭 × focalLength / horizontalAperture, fy = 높이 × focalLength / verticalAperture. D435 컬러 640×480 (실물 perception 설정) 은 HFOV 약 55° · VFOV 42°, fx ≈ 615 (Isaac Lab 3 시험 fx 614.7). 실물 이전 때는 realsense 의 CameraInfo 를 쓴다.
- 영상 · 깊이 · CameraInfo 는 같은 시뮬레이션 스텝의 stamp (perception `depth.sync_tol_s` 0.02 s). 노드는 `use_sim_time: true`.
- URDF → USD 변환은 `merge_fixed_joints=False` 로 한다 (v4 `convert_urdf62.py`). 고정 관절을 합치면 센서 프레임 prim 이 사라진다. `validate_usd.py` 가 그 prim 들을 확인한다.

Isaac Lab 3 (Isaac Sim 6.1) 에서 확인한 것 (2026-10-28, Sim 6.2 단독 실행은 확인 안 함):

- OmniGraph ROS 카메라 도우미 (ROS2CameraHelper) 는 못 쓴다. Camera 센서는 타일 렌더 프로덕트라 넘길 수 없고, 따로 만든 렌더 프로덕트는 그려지지 않아 빈 영상만 나간다.
- `OnPlaybackTick` 은 발화하지 않고 (Kit 타임라인을 재생하지 않음), 창이 없으면 `app.update()` 도 불리지 않는다. 확장을 실행 중에 켜면 USD 스키마 등록이 깨진다 (`--kit_args "--enable ..."` 로 시작할 때 켬).
- 해결: Camera 센서 값을 Isaac 내장 jazzy rclpy (`exts/isaacsim.ros2.core/jazzy/rclpy`) 로 직접 발행 — 30 Hz (시뮬레이션 시간), 영상 · info · 깊이 stamp 일치, 카메라 3대 VRAM 5.1 GB.
- Kit 뷰포트 창을 더 열지 않는다 (모든 뷰포트가 지오메트리를 못 그림).

## 점검

```bash
ros2 run tf2_ros tf2_echo base_link top_camera_front_color_optical_frame   # C 가 남아 있으면 실패 (시뮬레이션은 임시 연결 후)
ros2 run tf2_ros tf2_echo base_link arm_camera_optical_frame
ros2 run tf2_tools view_frames                                            # 부모가 둘 · 끊긴 나무 확인
ros2 topic echo /top_camera_front/color/camera_info --once
ros2 topic hz /top_camera_front/color/image_raw
```

정적 검사:

- URDF: `colcon test --packages-select opencr_hardware` (test_robot_description — 나무 구조 · 프레임 · 광학 축 · 구동 설정).
- USD: `workspace/tools/validate_usd.py <usd>` (usd-core 만 필요, Isaac 없이). 결과 `PASS_STATIC_ONLY` 는 물리 · 렌더링 · ROS 연결을 보지 않았다는 뜻이다.
