developlcy-oss/Lv2_Cartlidar_Assignment/workspace/urdf_and_usd/policy/manipulator/정책_학습기록.md

# Waffle 4WD 정책 학습 기록

정책을 바꾸거나 다시 학습할 때마다 이 문서를 갱신합니다 (Claude 가 작업할 때 함께 고침).
- **1절 요약 표**: 정책마다 지금 쓰는 회차·결과·파일 한 줄
- **2절 이후**: 정책마다 설정 (관측·행동·보상·PPO) 과 회차 기록 (무엇을 바꿨고, 결과가 어땠고, 왜)
- 학습 결과 폴더는 `sim/isaac/logs/rsl_rl/<experiment>/<시각>/` (컨테이너에서 학습 후 `./sim/tools/sync_to_docker.sh --pull` 로 가져옴)
- 로봇·시뮬레이터 구성과 실행 명령은 [README.md](README.md)

마지막 갱신: 2026-10-29 밤 (팀 공유본: 집기 SP-T1 61 %, 옮기기 ST-T1 (N 통 + 손 IK 46/47, MuJoCo 시작), 이어 붙이기 0/64 = **새 팔 높이 한계 (dz 15 mm 면 퍽 바닥이 입구보다 0.6 mm 위가 최대)**, 결정 필요 4.14 절)

> **위치 (2026-11-04 부터)**: 팔 과제 코드 · 이 기록은 저장소 `workspace/urdf_and_usd/policy/manipulator/` 한 곳 (`isaac/rl/` 은 주행 · 도킹만, 예전 팔 사본은 지움). `robot_cfg.py` 가 `../../isaac` 의 팀 설정을 찾음, docker 는 `sync_to_docker.sh` -> `waffle_shared_261028/manipulator`.
> **자동 기록 (2026-11-05 부터)**: 학습 회차 · 평가 · 정책 등록은 `record_md.py` 가 [학습기록_자동.md](학습기록_자동.md) 에 표 한 줄씩 (run_rl.sh toppick · toppick_eval · chain_eval · register 가 끝나면). 등록 목록 원본 `policies/registry.json`. 이 문서에는 원인 · 결정만.
> TopPick 다시 학습 설정 (모두 45° · 실제 배치 A · B · C · 인식 ±10 mm 와 좌표 고정 · 옆 퍽 성공 조건, #71 · #78 · #82) 은 `toppick_env_cfg.py` 머리말.
> 이전 위치 (2026-10-29 ~ 11-03): 팀 공유본 `urdf_261028/isaac/rl/` (로봇 설정 = 팀 `isaac/waffle_4wd_isaac`, 물리값 = 팀 `isaac/robot_params.json`).
> 그 전 기록 (주행 · 옛 팔 261027 · 새 팔 261028 첫 이식) 은 아래 그대로 두고, 그때 경로 `sim/...` 는 이전 패키지 (`~/Downloads/urdf_261027_1711/...`, `~/Downloads/urdf_261028/waffle_4wd_description_261028/sim/`) 기준.

## 1. 정책 요약

### 1-A. 지금 URDF (261028, 새 팔 arm_bench) - **이 표가 현재 상태** (2026-10-29 밤부터 팀 공유본 물리값으로 다시 학습 중, 4.14 절)

| 순서 | 정책 (과제 ID) | 하는 일 | 상태 | 지금 회차 · 결과 | 정책 파일 |
|---|---|---|---|---|---|
| **B1** | **위에서 집기 `Waffle-TopPick-Direct` (B안 팔레트, 2026-11-02)** | 상자 위 퍽을 집게 45° 기울여 집어 세운 채 들기 (2026-11-04 부터 12칸 모두 45°, 실제 배치 A · B · C, 물리 무작위화) | **TP8 latest, TP9 (벌림 50 mm) 등록, 미션은 고정 동작 집기 사용 (정책 보류, 2026-11-09)** (4.15 절) | **TP8 (`2026-11-08_17-33-38/model_40300`, 손 안 반경 보상): 집기 평가 시드 2 150/256 (59 %), 물리 집기 62 %** (TP6 56 %). TP9 (`2026-11-09_22-14-33/model_59250`): 벌림 50 mm 이어서 39/192 (TP8 같은 벌림 23) | `policies/toppick_latest.pt` = `toppick_TP8.pt`, ROS `robot_policy/config/models/toppick_tilt.onnx` |
| **B1+B2** | **집기 -> 칸 궤적 이어서 `chain_pallet_eval.py`** | 상자 위 퍽을 집어 칸에 넣기 (2026-11-05). 2026-11-09 **고정 동작 집기로 바꿈** (ROS `toppick_tilt` approach_mode top) | **시뮬레이션 확인, 실물은 target_look 퍽 자리 측정 σ 2 mm 안 필요** (4.15 절) | **고정 집기 (벌림 50 mm) 시드 2 = 172/192 (측정 오차 0) · 146 (σ 2 mm)**, 실제 배치 84 · 69/88. TP8 정책 57, TP8 + 다시 쥐기 113, 벌림 50 mm 에서 TP8 23 · TP9 39 (11-10). 등록부 `toppick_scripted` | `chain_pallet_eval.py --scripted_pick 2 --grip_open 0.0042` |
| **B2** | **팔레트 놓기 (고정 궤적, 학습 없음)** | 쥔 퍽을 팔레트 칸 12곳에 놓기 (`pallet_traj.py`) | **확인됨** (4.15 절) | Isaac 24/24 (기둥 옆 4칸 45° 기울여) | `pallet_place_traj.json` |
| 1 | 정렬·집기 `Waffle-SidePick-Direct` | 상자 위 퍽을 옆에서 집어 세운 채 3 ~ 5 cm 들기 | **학습됨** (직교 행동 + IK, 팀 물리값, 4.14 절) | **SP-T1: 실제 과제 39/64 (61 %)**, 넘어뜨림 8/64 | `policies/sidepick_latest.pt` |
| 2 | 옮기기·맞추기 `Waffle-Store-Direct` | 집은 퍽을 높이 들어 1 번 180° 돌려 뒤 통 위에 맞춤, 팔이 몸체에 닿으면 강한 벌점 | **학습됨, 실제 집기에서 오면 통 4 cm 앞까지** (팀 물리값 ST-T1·T2, 4.14 절) | ST-T1: MuJoCo 시작에서 N 통 + 손 IK 46/47. 실제 집기 결과에서 오면 통 축 약 4 cm 앞에서 멈춤 = **새 팔 높이 한계** | `policies/store_latest.pt` |
| 3 | 넣기 `Waffle-Insert-Direct` | 통 위에 맞춘 퍽을 통 안에 넣고 놓고 빼기 | **학습함, 아직 약함** (IN-N3) | 강화 학습 6 % (놓은 퍽이 11 mm 에서 끼임). **손 IK 10 mm 넣고 놓기 = 맞춘 대 8/11 통 안** | `waffle_insert/2026-10-29_19-18-49` |
| - | 이어 붙이기 `chain_play.py` | 1 -> 2 -> 3 을 이어 실행 (ROS 상태 머신의 시뮬레이션 판, 4.11 절) | **돌려 봄, 0/64** | 집기 28 ~ 35/64 -> 통 근처 19 ~ 26/64 -> 통 안 0. **새 팔 높이 한계 (퍽 바닥을 입구 위로 못 올림) - 결정 필요** | `./run_rl.sh chain_eval` |

### 1-B. 이전 URDF (261027_1711, 옛 팔 RM-X52) - 기록용 (이 모델들은 새 팔에서 못 씀, `policies/old_261027/`)

| 정책 (과제 ID) | 하는 일 | 결과 | 정책 파일 (이전 패키지) |
|---|---|---|---|
| 주행 `Waffle-Drive-Direct` | 1 ~ 2.5 m 무작위 목표점까지 4륜 스키드 주행 | D1: 목표 도달 100 % (학습 중 지표) | `logs/rsl_rl/waffle_drive/2026-10-28_11-43-50/model_299.pt` |
| 정렬·집기 `Waffle-SidePick-Direct` | 상자 위 퍽을 옆에서 집어 세운 채 들기 | SP3: 진단 8/8 들기 | `waffle_sidepick/2026-10-28_20-45-44` |
| 옮기기·맞추기 `Waffle-Store-Direct` | 높이 들어 180° 돌려 통 위 맞춤 | ST3: 맞춤 86 %, 순수 강화 학습 넣기 0 %, ST3 + 손 IK 내리기 = 21/32 ~ 73/96 통 안 | `store_ST3.pt` |
| 넣기 `Waffle-Insert-Direct` | 통 위 퍽을 통 안에 넣기 | IN1: 통 위에서 62 % (IN2 47 %) | `insert_latest.pt` (= IN1) |
| 이어 붙이기 | 집기 -> 옮기기 -> 넣기 | 집기 60/64 -> 맞춤 7/64 -> 넣기 0 (이어 받는 상태 차이, 4.12 절) | - |
| 주사위 2 만들기 (집기 `Waffle-Pick-Direct` -> 놓기 `Waffle-Place-Direct`) | A 상자의 퍽을 B 상자 대각선 칸에 | 보류 (과제 범위 변경). 집기 G1 88 %, 놓기 L1·L2 실패 | `waffle_pick/2026-10-28_14-33-21/model_300.pt` |

## 2. 주행 `Waffle-Drive-Direct`

파일: `sim/isaac/waffle_isaac/drive_env_cfg.py` (설정), `drive_env.py` (구현), `agents/rsl_rl_ppo_cfg.py: WaffleDrivePPORunnerCfg`

### 2.1 설정 (D1)

| 항목 | 값 |
|---|---|
| 로봇 | `WAFFLE_CFG` (`robot_cfg.py`, 게인은 `sim_params.json`): 바퀴 속도 제어 감쇠 0.5, 팔 강성 19 / 감쇠 0.85, 자기 충돌 끔 |
| 장면 | 바닥 + 로봇, 64 환경, 간격 6 m |
| 시작 | 원점, 요 무작위 (−π ~ π), 팔·집게 = `sim_params.json` init_pose (URDF 0 자세) |
| 목표 | 시작점에서 1 ~ 2.5 m, 방향 무작위. 0.15 m 안에 들어오면 도착 (종료) |
| 제어 | 30 Hz (물리 120 Hz / 4), 에피소드 12 s |
| 행동 2 | 왼쪽·오른쪽 바퀴 속도 [−1, 1] x 10.996 rad/s (앞뒤 바퀴 같은 값) |
| 관측 11 | 몸체 속도 (x, y), 요 각속도, 중력 방향 (3), 몸체 좌표 목표 (x, y), 목표 거리, 이전 행동 (2) |
| 보상 | 거리 줄어든 만큼 x 20, 도착 +10, 행동 변화² x −0.05, 스텝마다 −0.02, 넘어짐 (약 53° 이상) −10 (종료) |
| PPO | MLP 64-64 (ELU), 관측 정규화, lr 1e-3 adaptive (KL 0.01), γ 0.99, λ 0.95, 32 스텝 x 64 환경, 미니배치 4, 에폭 5, 엔트로피 0.005, 초기 std 0.6 |

### 2.2 회차 기록

| 회차 | 날짜 · 결과 폴더 | 바꾼 것 | 결과 | 비고 |
|---|---|---|---|---|
| D1 | 2026-10-28 · `2026-10-28_11-43-50` | 처음 (예전 로봇의 주행 과제를 Waffle 관절 이름·속도 한계로 옮김) | `train 64 300` 3 분 13 초 (반복당 0.66 s, RTX 5060 Laptop). 평균 보상 −0.9 (0) → 37.5 (50) → 39.4 (250) → 37.4 (299). 에피소드 길이 14 → 157 ~ 173 스텝 (5 ~ 6 s). 학습 중 도착 비율 50 반복부터 100 % | 50 반복이면 이미 수렴. 평가 스크립트 (여러 대 x 60 s 도착 비율·시간) 는 아직 없음 |

### 2.3 남은 일

- 평가 스크립트 (도착 비율, 걸린 시간, 넘어짐) 를 만들어 회차마다 같은 기준으로 비교.
- 실물 바퀴 게인·바닥 마찰 실측 후 다시 학습 (`sim_params.json`).

## 3. 주사위 2 만들기: 집기 P2 + 놓기 P1 (A 방식 = 정책 2개 이어 쓰기)

시작: 2026-10-28. 미션 (mission.pdf, 주사위 기억 로봇) 의 '주사위 눈 배치' (장소당 10 점) 를 로봇 제자리에서 먼저 연습하는 과제.

### 3.1 과제 정의

- 로봇은 움직이지 않음 (바퀴 속도 0). 팔만 씀.
- A 상자 (205 x 205 x 70 mm, 미션 시작 상자) 위에 퍽 2 개 (상자 중심에서 지도 X ±40 mm), 그중 A 퍽 1 개를 집음.
- B 상자 (205 x 205 x 70 mm) 위에 B 퍽 1 개가 주사위 2 의 한 칸에 있음. A 퍽을 다른 칸에 놓아 **주사위 2** 완성.
  - 주사위 2 = 3 x 3 격자 (간격 60 mm, 격자 중심 = 상자 중심) 의 왼쪽 위 (−60, +60) 와 오른쪽 아래 (+60, −60), 지도 +Y 가 위, 돌려서 대체 불가. 두 퍽 거리 약 170 mm.
- 성공 (미션 채점 기준): 각 칸 중심 오차 ≤ 10 mm, 퍽 바닥 = 상자 윗면 (70 mm), 똑바로 서서 2 s 안정, 다른 칸 비어 있음. 정책 목표는 시뮬레이션에서 ≤ 5 mm.
- 퍽: 3 x 3 x 6 cm 원기둥 (지름 30) · 직육면체, 빨강·초록 (질량 45 / 55 g 추정 → 2026-11-13 실측 원기둥 13 · 사각기둥 17 g 으로 바꿈, TP3 ~ TP12 는 45 · 55 g 으로 학습).

### 3.2 방식 (A: 정책 2 개)

| 정책 | 시작 상태 | 끝 (성공) |
|---|---|---|
| P2 집기 `Waffle-Pick-Direct` | 팔 준비 자세, 집게 열림, A 상자 위 퍽 2 개 | A 퍽을 3 cm 이상 들고 유지, 옆 퍽 그대로 |
| P1 놓기 `Waffle-Place-Direct` | A 퍽을 쥐고 든 상태 (학습 때는 바로 이 상태로 시작) | 목표 칸 오차 ≤ 5 mm, 똑바로, 놓고 집게가 빠진 뒤 2 s 유지, B 퍽 그대로 |

이어 쓰기: P2 성공 판정 → P1 시작. 평가 = 두 정책을 이어 '주사위 2 완성률' 과 오차 분포.

### 3.3 진행 단계

| 단계 | 내용 | 상태 |
|---|---|---|
| 0 | 배치 정하기 (A·B 상자를 팔이 닿는 자리에), 손으로 푼 IK 로 집기 -> 옮기기 -> 놓기가 물리적으로 되는지 | **끝 (2026-10-28)**: 3.6 절 |
| 1 | P2 집기 환경·학습 | **끝 (G1, 300 반복)** |
| 2 | P1 놓기 환경·학습 | L1·L2 실패 (목표 위 10 cm 에서 멈춤). L3 (선형 높이 보상 + 역방향 커리큘럼) 준비했으나 **과제 범위 변경으로 보류** (4 절) |
| 3 | 이어서 평가 | 대기 |

### 3.4 집기 P2 `Waffle-Pick-Direct` 설정 (G1)

파일: `sim/isaac/waffle_isaac/pick_env_cfg.py`, `pick_env.py`, `dice2_cfg.py` (배치·상자·퍽), `agents/rsl_rl_ppo_cfg.py: WafflePickPPORunnerCfg`. 실행: `./run_isaac.sh pick [환경] [반복]`, `pick_play`.

| 항목 | 값 |
|---|---|
| 장면 | 바닥, 로봇 (자기 충돌 켬), A·B 상자 (kinematic), 목표 A 퍽 (원기둥·상자 반반, 다른 하나는 치움), 옆 퍽 A2 (원기둥), B 퍽 (원기둥), 256 환경 |
| 시작 | 준비 자세 [−0.488, −0.523, 1.285, −1.97, 2.626] rad (A 퍽 위 10 cm, 집게 수직, 닫는 축 = 지도 y) ±0.1 rad, 집게 0.015. 상자 위치 ±1.5 cm, A 퍽 ±0.8 cm, 퍽 요 무작위 |
| 제어 | 30 Hz, 에피소드 5 s |
| 행동 6 | 팔 5 관절 목표 += 0.04 rad x 행동 (실제 각 ±0.25 rad 안 = 짓누르기 방지), 집게 (> 0 벌림 0.015 = 49.6 mm, ≤ 0 닫기 −0.0014) |
| 관측 32 | 팔 위치 (준비 자세 기준) 5 · 속도 5, 왼손가락 1, A 퍽 위치 3, 잡는 점 3, 퍽 − 잡는 점 3, 상자 퍽 손가락-면 각도차 (cos 4δ, sin 4δ) 2, 상자 여부 1, A2 − A (x, y) 2, 집게 수직도 1, 이전 행동 6 (위치는 base_link 좌표) |
| 잡는 점 | arm_link_5 + (0, 0, −0.108) |
| 보상 | 접근 1 − tanh(d/0.1) + 1 − tanh(d/0.02), 수직도 0.5 · 면 맞춤 0.5 (8 cm 안), **잡음 3** (d < 2 cm, 손가락 0.0005 ~ 0.010, 차체 기울기 3° 안), 들었음 6 (2 cm 이상, 3 cm 안), **들기 높이 10** (1 mm 부터 연속, 6 cm 위로 깎임), 행동 변화² −0.02, 관절 속도² −0.001, **옆 퍽 (A2·B) 밀림 −20/m**, 넘어짐 −0.5/스텝, 차체 기울기 −8/rad, 상자에서 떨어짐 −5 (종료) |
| 성공 | 3 cm 이상 들고 잡는 점 3 cm 안에 1 s 유지 (기록용, 종료 안 함) |
| PPO | MLP 256-128-64, lr 1e-4 adaptive, γ 0.98, λ 0.95, 24 스텝 x 256 환경, 미니배치 4, 에폭 5, 엔트로피 0.006, 초기 std 1.0, **300 반복** (반복 1 회 = 256 대 x 24 스텝 경험으로 한 번 갱신, 1.8 s) |

### 3.4-2 놓기 P1 `Waffle-Place-Direct` 설정 (L1, 준비됨)

파일: `sim/isaac/waffle_isaac/place_env_cfg.py`, `place_env.py`, 시작 상태 `sim/isaac/place_starts.json` (`sim/mujoco/place_starts.py` 가 만듦), `agents/rsl_rl_ppo_cfg.py: WafflePlacePPORunnerCfg` (집기와 같은 PPO). 실행: `./run_isaac.sh place`, `place_play`, `place_attach_check`.

| 항목 | 값 |
|---|---|
| 장면 | 바닥, 로봇 (자기 충돌 켬), A·B 상자, 쥔 퍽 (원기둥·상자 반반), B 퍽, 256 환경 |
| 시작 | MuJoCo IK 로 미리 구한 팔 자세 600 개 중 하나 (반은 A 퍽 위 3 ~ 8 cm = 집기가 끝나는 자리, 반은 A ~ 목표 사이 2 ~ 8 cm, 집게 수직). 쥔 퍽 = 그 자세의 잡는 점 + 손 안 어긋남 (집게 방향 ±4 mm, 손가락 폭 방향 ±3 mm), 손가락 0.0052 (30 mm). B 상자 ±1 cm (목표 칸도 같이) |
| 에피소드 | 6 s, 30 Hz |
| 행동 6 | 집기와 같음 (집게 > 0 = 열어 놓기) |
| 관측 33 | 목표 칸 (x, y, 놓인 퍽 중심 z) 3, 퍽 위치 3, 퍽 − 목표 3, 퍽 직립도 1, 잡는 점 3, 팔 위치 5 · 속도 5, 왼손가락 1, B 퍽 − 목표 (x, y) 2, 상자 여부 1, 이전 행동 6 |
| 보상 | 수평 거리 2·(1 − tanh(d/0.05)) + **3·(1 − tanh(d/0.005))**, 높이 1·(1 − tanh(|바닥 − 70 mm|/0.02)) (d < 1 cm 일 때만), 디딤돌 3 단: **앉음** +3 (d < 5 mm, 바닥 ±2 mm, 직립) -> **열음** +3 (앉음 + 손가락 > 0.008) -> **뺌** +3 (열음 + 잡는 점이 퍽 윗면보다 3 cm 위), 행동 변화² −0.02, 관절 속도² −0.001, B 퍽 밀림 −20/m, 넘어짐 −0.5/스텝, 차체 기울기 −8/rad, 퍽이 바닥으로 떨어짐 −5 (종료) |
| 성공 | '뺌' 상태 1 s 유지 (오차 5 mm = 미션 10 mm 의 절반) |

시작 상태 확인 (`place_attach_check`, 32 대, 집게 닫고 1 s):
- 1 차: 미리 구한 자세에 관절 잡음 ±0.03 rad 를 더했더니 퍽-잡는 점 평균 7.6 mm, 최대 17 mm (손 위치만 바뀌고 퍽은 안 따라감) -> 관절 잡음 0
- 2 차: 평균 2.5 mm, 최대 4.7 mm (= 의도한 손 안 어긋남), 32/32 가 1 s 동안 쥐고 있음 (떨어짐 0)

### 3.5 회차 기록

| 회차 | 날짜 · 결과 폴더 | 바꾼 것 | 결과 | 원인 / 비고 |
|---|---|---|---|---|
| G1 | 2026-10-28 · `waffle_pick/2026-10-28_14-33-21` (`model_300.pt`) | 처음 (3.4 절 설정), 1500 반복으로 시작했다가 **300 반복에서 멈춤** | 반복당 1.8 s (256 환경), 300 반복 ≈ 9 분. 들어 올린 비율 0 (0) -> 2 % (50) -> 70 % (100) -> 80 % (150) -> **88 % (250)**, 평균 보상 2 -> 1730 (100) -> 약 2000 (150 이후 평평). 학습 중 성공률 (순간값) 150 반복부터 1.0, 최대 들기 9 ~ 11 cm, 옆 퍽 밀림 0.05 ~ 0.1 mm/스텝, 넘어짐 3.5 % | 150 ~ 250 반복에서 수렴 -> 이 과제는 **300 반복이면 충분** (기본값 300 으로 바꿈). 시작 자세가 이미 퍽 위라 빨리 배움. 평가 (이어서 평가) 는 놓기 학습 뒤 |
| L1 | 2026-10-28 · `waffle_place/2026-10-28_14-42-38` (`model_299.pt`) | 처음 (3.4-2 절 설정), 300 반복 (반복당 1.73 s, 약 9 분) | 평균 보상 −1.8 (0) -> 406 (100) -> 669 (200) -> 729 (299). 수평 오차 (에피소드 평균) 141 -> 22 (100) -> 8 ~ 12 mm. 넘어짐 24 % (0 ~ 50) -> 0 % (250). **앉음·열음·뺌 0 %, 성공 0** | `place_diag` (16 대): 퍽을 1 ~ 2 s 만에 **목표 칸 바로 위 (수평 오차 0 mm) 까지 옮기지만, 퍽 바닥이 상자 윗면 104 ~ 112 mm 위에서 멈추고** 2 s 뒤로 팔이 전혀 안 움직임. 집게는 계속 쥠 (퍽-잡는 점 1 ~ 5 mm). 원인: 높이 보상 1 − tanh(|높이 오차|/0.02) 가 10 cm 에서 거의 0 (tanh(5) ≈ 1) 이라 **내려갈 이유 (기울기) 가 없음** = 이전 로봇의 '계단식 보상' 문제가 높이 축에서 다시 남. 수평 보상 (최대 5/스텝) 만 받으며 정지 |
| L2 | 2026-10-28 · `waffle_place/2026-10-28_15-09-38` (`model_400.pt`) | L1 `model_299` 에서 이어서, 높이 보상을 넓힘: 2·(1 − tanh(|h|/0.08)) + 2·(1 − tanh(|h|/0.01)) (d < 1 cm 일 때). 첫 시도는 15:09 컨테이너 재시작으로 318 반복에서 끊겨 다시 시작 | 300 -> 416 반복 (약 4 분): 보상 729 -> 800, 수평 오차 11 -> 6 mm, **앉음·열음·뺌 여전히 0 %** -> 416 에서 멈춤 | `place_diag` (L1 정책): 멈춘 자세 [0.52, 0.15, 0.35, **−1.97**, 3.14] (손목 피치가 한계). 스크립트가 놓을 때 자세는 [0.51, 0.08, **−0.43**, **−1.22**, 3.14] -> 한계 때문이 아니라 팔꿈치·손목을 같이 크게 바꾸는 협응이 필요한데, 10 cm 에서 높이 보상 기울기가 cm 당 0.06 뿐이라 수평 보상 (5/스텝) 에 묻혀 못 찾음. 또 학습 중 GUI 재생 (`pick_play`) 이 GPU 메모리 부족 (8 GB 중 학습 3.8 GB) 으로 실패 -> 학습과 GUI 를 동시에 돌리지 말 것 |

### 3.6 0 단계: 배치와 물리 확인 (2026-10-28)

**집게 기하** (MuJoCo 모델, `arm_link_5` 좌표): 집게 방향 = −z, 손가락 닫는 축 = x.
- 손가락 패드 z −0.075 ~ −0.123. 벌림 = 19.6 + 2000 x q [mm] (q = gripper_left_joint, −0.0014 ~ 0.0262 -> 16.8 ~ 72 mm).
- 패드 안쪽 z −0.055 ~ −0.075 에 손가락 구동부가 가운데로 튀어나옴 -> **퍽 중심을 z −0.108 에 둠** (잡는 점, 퍽 윗면이 구동부에 안 닿음).
- 손가락을 다 벌리면 바깥 폭 약 130 mm -> 이 과제는 **벌림 0.015 (49.6 mm)** 로 제한. 30 mm 퍽을 쥐면 q ≈ 0.003 ~ 0.004.
- 끝까지 닫으면 두 손가락 구동부가 서로 닿아 −0.0005 에서 멈춤 (빈손).

**도달 거리** (`sim/mujoco` 모델로 계산): 상자 위 퍽 (중심 높이 100 mm) 을 집게를 세워 (기울기 5° 안) 잡는 거리 = joint1 축에서 최대 0.263 m (10° 면 0.275).
로봇은 상자 (높이 70) 옆에 joint1 축이 정면 0.137 / 30° 비스듬히 0.112 m 까지 붙음 (앞 라이다 받침 x 0.218 이 걸림). 옆쪽은 바퀴 때문에 0.17 m 이상.
-> 상자 2 개를 로봇 옆에 두면 닿지 않아 **로봇 앞에 나란히** 둠. A 상자의 먼 퍽 (0.288 m) 은 닿지 않아 **로봇 쪽 퍽을 집음** (먼 퍽은 옆 장애물).

**배치** (base_link = 지도 좌표, 로봇은 원점에서 +x, 지도 +Y = 로봇 왼쪽):

| | 중심 (x, y) [m] | joint1 축에서 |
|---|---|---|
| A 상자 (앞 왼쪽) | (0.335, +0.110) | — |
| A 퍽 (집음, 로봇 쪽) | (0.295, +0.110) | 0.235 m |
| A2 퍽 (옆 장애물) | (0.375, +0.110) | 0.308 m (안 닿음) |
| B 상자 (앞 오른쪽) | (0.255, −0.120) | — |
| B 퍽 (주사위 2 오른쪽 아래 칸) | (0.315, −0.180) | — |
| 목표 칸 (왼쪽 위) | (0.195, −0.060) | 0.123 m |

**손으로 푼 IK 시험** (`~/.venvs/mujoco/bin/python sim/mujoco/dice2_check.py --shape cyl|box --image`): 위 10 cm -> 내려가 쥠 -> 8 cm 들기 -> 목표 위 8 cm -> 내려 놓기 -> 놓고 8 cm 빼기 -> 2 s.
IK = 위치 + 집게 수직 + 손가락 닫는 축 = 지도 y (옆 퍽 반대 방향), 직선 경유점 10 개, 끝에서 잡는 점 처짐을 재서 보정.

| 시도 | 결과 | 원인 / 조치 |
|---|---|---|
| 1 (원기둥) | 실패: A 퍽 쓰러짐, 옆 퍽 43 mm 밀림 | 시작 자세 -> 'A 위 6 cm' 를 관절 공간으로 바로 가며 경로가 처져 손가락이 퍽을 침. 6 cm 위도 손가락 끝이 퍽 윗면 1.5 cm 위뿐 -> 직선 경유점 + 10 cm 위에서 접근 |
| 2 (원기둥) | **성공**: 놓은 오차 **9.4 mm**, 바닥 70.0 mm, 똑바로, B·A2 퍽 이동 0 | 오차가 한계 (10 mm) 에 가까움: 퍽이 손가락 안에서 3 ~ 5 mm 어긋나고 놓을 때 조금 밀림. 스크립트는 잡는 점만 보고 퍽은 안 봄 -> **퍽 위치를 보며 고치는 놓기 정책 (P1) 이 필요한 이유** |
| 2 (상자) | **성공**: 오차 **6.6 mm**, 바닥 70.0, 똑바로, 이동 0 | — |

**Isaac (PhysX) 재생** (`./run_isaac.sh dice2_replay --shape cyl|box [--self_collision] --image`): MuJoCo 에서 성공한 관절 명령 순서
(`sim/isaac/dice2_traj_<모양>.json`, 82 구간) 를 그대로 재생.

| 모양 | 들기 | 놓은 오차 | 바닥 | B·A2 이동 | 판정 |
|---|---|---|---|---|---|
| 원기둥 | 85 mm | **1.2 mm** | 70.0 | 0 / 0 | 성공 |
| 원기둥 + 자기 충돌 켬 | 85 mm | 1.2 mm | 70.0 | 0 / 0 | 성공 (팔이 차체에 안 닿음) |
| 상자 | 83 mm | **10.3 mm** | 70.0 | 0 / 0 | 실패 (한계 10 mm 를 0.3 mm 넘음) |

-> Isaac 물리에서도 집기·옮기기·놓기가 됨. 오차는 퍽이 손가락 안에서 미끄러지는 정도에 따라 1 ~ 10 mm 로 들쭉날쭉 -> 정책은 퍽 위치를 보고 고쳐야 함.

## 4. 새 범위: 상자 위 퍽 집기 -> 퍽 스토리지 넣기 / 빼기 (2026-10-28 결정, 설계 중)

사용자 결정 (2026-10-28):
- 맡은 RL 은 **주행 안 함**. 실제 미션에서 상자는 로봇 바로 옆에 있지 않음 (주행 담당이 상자 앞에 데려다 줌).
- 학습 대상: **상자 위 퍽 집기 -> 로봇 뒤 퍽 스토리지에 정확히 넣기**, **스토리지에서 퍽 빼내기**.
- 집기 단계: (1) 인식이 준 퍽 사진 정보로 퍽 중심 위에 자리 잡기 -> (2) 잡기 좋은 자세로 바꾸기 -> (3) 집기 -> (4) 스토리지에 넣기.
- 3 절 주사위 2 (로봇 옆 두 상자) 는 보류. 집기 G1 의 보상 구조·교훈과 놓기 L1·L2 의 실패 원인은 그대로 참고.

### 4.1 퍽 스토리지 형상 (URDF base_link 충돌 메쉬, base_link 좌표, mm)

| 부품 | x | y | z | 크기 |
|---|---|---|---|---|
| 세로 통 아래 칸 3 개 (part022·140·141) | −115 ~ −61 | 중심 +65 / 0 / −65 | 180 ~ 290 | 약 54 x 57 x 110 |
| 세로 통 위 칸 3 개 (part025·026·029) | −117 ~ −56 | 중심 +65 / 0 / −65 | 290 ~ 400 | 약 62 x 62 x 110 |
| rail_lo / rail_hi | −134 ~ −44 | ±141 | 175 ~ 206 / 285 ~ 316 | 90 x 282 x 31 |

REVISION 문서: housing 3 개 · magazine 3 개 (구멍 뚫은 판), rail 2 개. 퍽 12 개 (통 3 개 x 4 개로 추정, 미확인).

### 4.2 팔 도달 확인 (MuJoCo, 집게 잡는 점 = arm_link_5 + (0, 0, −0.108))

- 집게를 세운 채 (기울기 < 10°) 잡는 점이 갈 수 있는 최고 높이 = **base_link 위 0.214 m**.
- 통 자리 (joint1 축 뒤 0.173 / 0.185 m) 에서 높이별 최소 집게 기울기: 0.30 m 41°, 0.35 m 56°, **0.40 m 74°**, 0.45 m 90°.
- -> **위에서 집기 (집게 수직, 퍽 축 = 집게 방향) 로는 통 위 입구 (z 0.40) 에 퍽을 세운 채 넣을 수 없음.**

사용자 확인 (2026-10-28): 넣기 = **통 위 입구**, 통 안에서 **세워서 쌓임**, 빼기 = **맨 아래에 쌓인 퍽을 뽑음**, 인식 = **YOLO 결과**를 받음,
주행이 상자 앞에 데려다 줌 (**로봇 몸체가 상자에 닿으면 절대 안 됨**), 빼낸 퍽은 **L1 ~ L3 상자 격자 칸에 놓음**.

### 4.3 통 단면 (base_link.dae 를 잘라 봄)

- 위 입구 (z 395): 사각 통, 바깥 약 44 mm · 안 약 36 ~ 38 mm (퍽 30 mm -> 한쪽 3 ~ 4 mm). 양옆 통은 약 ±20° 돌아가 있음.
- 위 칸 (z 290 ~ 400): 앞면 (팔 쪽) 이 가로 막대 격자. 아래 칸 (z 180 ~ 290): 뒤판만 있고 **앞이 열림** (약 z 205 ~ 265) -> 맨 아래 퍽을 앞에서 뽑는 구조로 보임.

### 4.4 옆에서 집기 (집게 수평, 손가락 좌우로 닫음 -> 퍽은 세워진 채) IK·충돌 확인 (MuJoCo, 2026-10-28)

| 동작 | IK (위치 / 집게 방향 오차) | 팔·집게 충돌 (퍽 형상 제외) |
|---|---|---|
| 통 위 넣기 (퍽 바닥 = 입구 + 5 mm, 퍽 중심 z 0.435) 가운데 / ±y 통 | 0 mm / 0 ~ 0.5° (joint1 ±160 ~ 180°) | 없음. 단 **가운데 통은 퍽 윗면 (0.465) 과 카메라 가로대 아래면 (0.467) 사이 약 2 mm** -> 사실상 양옆 통만 |
| 통 아래 뽑기 (퍽 중심 z 0.235 가정) | 0 mm / 0.3 ~ 0.5° (가운데 통은 어깨 1.5·팔꿈치 −1.4 = 한계) | 벌린 채는 없음. **쥐려고 닫으면 손가락이 통 구조물에 1 ~ 3 mm 파고듦** |
| 상자 위 퍽 옆에서 집기 (퍽 중심 월드 z 0.10) | x 0.40: 0 mm / 0°, 0.35: 0.7 mm / 8°, 0.30: 1.6 mm / 20°, 0.25: 4.8 mm / 11° | (미확인) |

-> 사슬 전체를 **옆에서 집기** 로 하면 넣기·빼기가 기구학적으로 가능 (위 표의 '통 아래 뽑기' 는 퍽 중심 z 0.235 가정. 실제 받침은 4.5 절).

사용자 확인 (2026-10-28 추가): 인식 = YOLO 학습 안 함, **집을 퍽의 좌표만 받음** (집게 카메라 Arducam 으로 검출). 통 **3 개 모두** 써야 함. 맨 아래 퍽은 URDF 대로. **정렬·집기부터** 시작.

### 4.5 통 속 통로·받침 계산 (URDF, 2026-10-28)

방법: 통 축 근처에서 높이마다 '통 안에 들어가는 가장 큰 원' (수평 광선 72 방향, 중심 ±14 mm 탐색), 통 안에서 아래로 광선 (받침), 위로 광선 (위 장애물). 겉모양 (base_link.dae) 과 충돌 형상 둘 다.

| 높이 (base_link, mm) | 가운데 통 (중심 x −82.5, y 0) | 양옆 통 (x −87, y ±65, ±20° 회전) |
|---|---|---|
| 310 ~ 395 (위 칸) | 반지름 15.8 ~ 17.3 (퍽 15 -> 한쪽 1 ~ 2 mm) | 15.9 ~ 16.7 |
| **288 ~ 300 (위·아래 칸 이음매, rail_hi 높이)** | 16.2 ~ 16.5 (통과) | **10.2 ~ 13 (지름 약 23 mm -> 퍽 못 지나감)** |
| 210 ~ 260 (아래 칸) | 앞이 열림 (반지름 25 ~ 31) | 앞이 열림 (28 ~ 33) |
| 180 ~ 200 (아래 끝) | 부분 받침 (윗면 z 200), 가운데는 차체 윗판 (z 111) 까지 뚫림 | 같음 |
| 입구 테두리 / 위 장애물 | 401.5 / 카메라 가로대 470 ~ 489 (퍽을 입구 바로 위에서 놓으면 약 8 mm 여유) | 399 / 없음 |

**떨어뜨려 보기** (MuJoCo, 충돌 형상, 원기둥 퍽을 통마다 4 개 차례로 입구 위 z 0.47 에서 놓음):
- 가운데 통: 퍽 바닥 **200** (중심 230) / 260 / 332 mm 에 쌓임 -> 맨 아래 퍽은 앞이 열린 아래 칸에 있어 뽑기 가능. 단 **첫 퍽은 받침 틈으로 빠져 통 밖으로 굴러 나감**.
- 양옆 통: 퍽이 **바닥 303 mm (이음매) 에서 걸림**, 그 위 363 에 하나 더, 3 번째부터 입구 위로 넘쳐 바닥으로 떨어짐. 걸린 높이 (위 칸) 는 앞면이 격자 막대라 **뽑을 수 없음**.
- -> **지금 URDF 형상대로는 양옆 통 2 개를 못 씀.** REVISION 1711: 새 rail 을 옛 rail 자리에 놓았고 'housing·magazine 과 최대 2.5 mm 겹침' -> 새 rail_hi 구멍 위치가 어긋났을 가능성. 실물·CAD 확인 필요 (사용자에게 알림).

### 4.6 정렬·집기 0 단계: 옆에서 집기 물리 확인 (MuJoCo, `sim/mujoco/side_grasp_check.py`, 2026-10-28)

순서 (손으로 푼 IK, 직선 경유점 + 처짐 보정): 퍽 정면 6 cm 앞·4 cm 위 -> 정면 6 cm 앞 -> 수평으로 다가감 -> 쥠 -> 5 cm 들기 -> 1 s.
IK 조건: 집게 방향 (arm_link_5 −z) = 수평 (joint1 축 -> 퍽), 손가락 닫는 축 = 수평, (2 차부터) 카메라 브래킷이 위 (arm_link_5 y = 아래).
상자 205 x 205 x 70 은 로봇 앞, gap = 로봇 앞 끝 (라이다 받침 x 0.218) 과 상자 사이, 퍽 2 개 = 상자 중심 ± 0.04 (상자 x 축).

| 시도 | 결과 | 원인 / 조치 |
|---|---|---|
| 1 (gap 0.03, 여러 각도, 6 가지) | 전부 실패: 퍽 쓰러뜨림, 집게가 상자에 0.2 ~ 1.2 mm 파고듦 | 퍽이 joint1 축에서 0.22 ~ 0.28 m 면 상자 높이에서 집게를 수평으로 못 만듦 (정면 앞 지점 IK 방향 오차 11 ~ 26°) -> 아래로 기운 채 다가가 퍽을 침 |
| 2 (gap 0.06 ~ 0.10) | gap 0.10 (퍽 0.336 m) 등 2 가지 쥐고 6 cm 들기 성공, 방향 오차 0 ~ 3° | 손목 아래 **카메라 브래킷 (arm_link_5 part_332) 이 상자에 0.5 mm 닿음** -> 손목 롤을 돌려 카메라를 위로 |
| 3 (카메라 위, 8 가지) | 7/8 쥐고 33 ~ 45 mm 들기, 직립 0.998, 옆 퍽 0 mm. 상자 45° 1 건은 퍽 쓰러뜨림. 대부분 손가락이 상자에 0.1 ~ 0.2 mm 스침 | 잡는 높이를 퍽 중심 + 18 mm 로 |
| 4 (잡는 높이 +18 mm, 6 가지: gap 0.06 ~ 0.10, 상자 45° / 90°, 원기둥·상자) | **6/6 쥐고 43 ~ 45 mm 들기, 직립 0.999, 옆 퍽 0 mm**. 손가락-상자 −0.2 ~ +2.2 mm (스침) | 스침은 학습에서 상자 접촉 벌점으로 피하게 함 |

-> **옆에서 집기는 퍽이 joint1 축에서 약 0.29 ~ 0.34 m 일 때 됨** = 로봇 앞 끝 (라이다 받침) 과 상자 사이 **약 6 ~ 10 cm** 를 두고 서야 함 (주행 쪽 요구 조건). 더 가까우면 (3 cm) 집게를 수평으로 못 만듦.

### 4.7 정렬·집기 `Waffle-SidePick-Direct` 설정 (SP1)

파일: `sim/isaac/waffle_isaac/sidepick_env_cfg.py`, `sidepick_env.py`, `agents/rsl_rl_ppo_cfg.py: WaffleSidePickPPORunnerCfg` (집기 G1 과 같은 PPO, 300 반복).
실행: `./run_isaac.sh sidepick [환경] [반복]`, `sidepick_play` (학습 중에는 GPU 8 GB 부족 -> 학습 끝난 뒤).

| 항목 | 값 |
|---|---|
| 장면 | 바닥, 로봇 (자기 충돌 켬, 접촉 보고 켬), 상자 1 개 (kinematic), 집을 퍽 (원기둥·상자 반반), 옆 퍽, 접촉 센서 2 개 (팔 링크 2 ~ 5·손가락 vs 상자, 차체·바퀴 vs 상자), 256 환경 |
| 배치 | 상자 = 로봇 앞 끝 (x 0.218) 에서 gap 5 ~ 11 cm, 가로 ±6 cm, 요 0 ~ 180° (가장 가까운 면·모서리 기준 gap). 퍽 2 개 = 상자 중심 ± 0.04 (상자 x 축). 집을 퍽 = joint1 축 거리가 0.33 m 에 가까운 쪽 |
| 시작 | 자세 [0.12, −0.49, −1.07, 1.56, 0.0] (옆에서 집기 '퍽 정면 앞' 자세) ±0.15 rad, 집게 0.015 |
| 인식 좌표 | 퍽 참값 + 에피소드 치우침 ±4 mm + 스텝마다 ±1 mm |
| 제어 | 30 Hz, 에피소드 6 s |
| 행동 6 | 팔 5 관절 += 0.04 rad x 행동 (앞섬 ±0.25 rad), 집게 > 0 벌림 0.015 / ≤ 0 닫기 |
| 관측 35 | 팔 위치 5·속도 5, 왼손가락 1, 인식 퍽 좌표 3, 잡는 점 3, 퍽 − 잡는 점 3, 집게 방향 3, 손가락 닫는 축 3, 옆 퍽 − 퍽 2, 상자 퍽 여부 1, 이전 행동 6 |
| 잡는 점 목표 | 퍽 중심 + 18 mm (4.6 절), **SP3 부터 + 6 mm** (`grasp_dz`) |
| 보상 | 접근 1 − tanh(d/0.1) + 1 − tanh(d/0.02), (12 cm 안) 집게 수평 0.5 · 카메라 위 0.3, 집게가 퍽을 향함 0.5 (2 ~ 12 cm), 상자 퍽 면 맞춤 0.5, **잡음 3** (2 cm 안, 손가락 0.0015 ~ 0.010, 차체 기울기 3° 안, 퍽 직립 0.9), 들었음 6, **들기 높이 10** (1 mm 부터 연속, 5 cm 위로 깎임, 퍽 직립 0.95 일 때), 퍽 기울기 −2·(1 − |축 z|), **팔·손가락-상자 접촉 −2/스텝 (1 N 넘으면)**, **차체-상자 접촉 −20 + 종료**, 차체 1 cm 밀림 −10 + 종료, 행동 변화² −0.02, 관절 속도² −0.001, 옆 퍽 밀림 −20/m, 넘어짐 −0.5/스텝, 차체 기울기 −8/rad, 상자에서 떨어짐 −5 + 종료 |
| 성공 | 3 cm 이상, 퍽 직립 (|축 z| > 0.95), 잡는 점 3 cm 안으로 1 s |

시험 (64 환경 5 반복): 반복당 1.4 s, 무작위 동작에서 팔-상자 접촉 4.7 %, 차체-상자 0 %.

| 회차 | 날짜 · 결과 폴더 | 바꾼 것 | 결과 | 원인 / 비고 |
|---|---|---|---|---|
| SP1 | 2026-10-28 · `waffle_sidepick/2026-10-28_16-29-56` (`model_299.pt`) | 처음 (위 설정), 256 환경 300 반복 (약 10 분) | 보상 274 (154) -> 414 (202) -> 1305 (250) -> **1410 (299)**. 잡는 점 거리 6.9 cm (58) -> 2.9 cm. 쥔 비율 0 (~ 150) -> 6.6 % (202) -> **36 %**, 들어 올린 비율 0.4 % (154) -> **43 %**, 최대 들기 8 cm, 집게 수평도 0.91 ~ 0.95, 퍽 넘어짐 2 % -> 23 % (202) -> 11 %, 팔-상자 접촉 0 ~ 3 %, **차체-상자 접촉 0 %** | 150 반복까지 퍽 정면 앞 (거리 5 ~ 7 cm) 에서 머물다 200 반복 무렵 쥐기·들기를 찾음. 300 반복에도 계속 오르는 중 -> SP2 로 이어서 학습 |
| SP2 | 2026-10-28 · `waffle_sidepick/2026-10-28_16-38-42` (`model_498.pt` = 마지막, exported/policy.pt) | SP1 `model_299` 에서 이어서 200 반복 (설정 같음, 약 7 분) | 보상 1410 -> 1849 (351) -> 2272 (417) -> **2594 (499)**, 들어 올린 비율 43 -> 63 % (351) -> **66 %**, 잡는 점 거리 2.4 cm, 퍽 넘어짐 11 -> **4.7 %**, 팔-상자 접촉 0 ~ 1.6 %, **차체-상자 0 %**, 에피소드 길이 177 / 180 (중간 종료 거의 없음) | `sidepick_diag` (8 대, 6 s): **7/8 이 1 ~ 2 s 안에 퍽을 쥐고 6 ~ 7 cm 들어 세운 채 유지** (퍽 직립 0.97 ~ 1.0), 팔-상자 접촉 0. 1 대는 퍽을 쓰러뜨렸다가 다시 세워 쥠. 집게는 6 ~ 12° 아래로 기움, 상자 모양 퍽 일부는 모서리 대각선으로 쥠 (손가락 0.011 = 벌림 42 mm). 퍽을 로봇 쪽으로 당겨 듦 (joint1 축 0.19 ~ 0.2 m). 아직 평가 스크립트 (여러 대 x 시간, 성공률) 없음 |
| SP3 | 2026-10-28 · `waffle_sidepick/2026-10-28_20-45-44` (`model_697.pt` = 마지막, exported/policy.pt) | **쥐는 높이 grasp_dz +18 -> +6 mm** (넣을 때 손가락이 카메라 가로대에 안 걸리게, 4.9 절 정정 표). SP2 `model_498` 에서 이어서 200 반복 (약 8 분). 처음엔 `model_499.pt` 로 이으려다 파일이 없어 실패 (마지막은 498) | 보상 (이어 받은 첫 반복 305) -> 2545 (550) -> 2734 (600) -> 2751 (650) -> 2645 (697), 들어 올린 비율 68 -> **75 % (550) -> 69 ~ 73 %**, 쥔 비율 54 -> 64 %, 넘어짐 2 ~ 5 %, 팔-상자 접촉 0 ~ 1.2 %, **차체-상자 0 %**. 550 반복 뒤 평평 -> 멈춤 | `sidepick_diag` (8 대, 6 s, `sim/isaac/sidepick_diag_SP3.log`): **8/8 이 2 s 안에 쥐고 약 5 cm 들어 유지**, 퍽 직립 7 대 0.97 ~ 1.0, 1 대 0.89, 팔-상자 접촉 0. 잡는 점 높이 오차 −10 ~ +20 mm (목표 +6 기준), 집게 6 ~ 12° 아래로 기움 (SP2 와 같음). 든 뒤 퍽을 joint1 축 0.19 ~ 0.2 m 로 당김 |

### 4.9 스토리지 넣기 0 단계: 손으로 푼 IK 로 통 위 입구에 넣기 (MuJoCo, `side_grasp_check.py --store C|P|N`, 2026-10-28)

옆에서 집어 든 퍽 (4.6 절, gap 0.08 상자 90°) 을 통 위 입구로 가져가 놓기 (퍽 바닥 = 입구 + 5 mm -> 잡는 점 z = 입구 + 0.035 + 0.018).

| 시도 | 경로 | 결과 | 원인 |
|---|---|---|---|
| 1 | 앞에서 0.30 까지 올림 -> joint1 축 둘레 원호 -> 통 위 2 cm -> 입구 + 5 mm | 3 통 실패 (퍽 떨어짐) | '통 위 2 cm' (잡는 점 0.472) 는 집게를 수평으로 못 감 (IK 40 mm / 47°) -> 다른 자세로 튀며 퍽 던짐. **통 위치에서 집게 수평 최대 높이 = 잡는 점 0.44 m (0.45 면 2° 기움)** |
| 2 | 원호 -> 통 앞 5 cm (joint1 축 0.135 m) -> 통 위 | −y 통: 통 위 도착, 놓았으나 축에서 11 mm 벗어나 입구에 걸려 기움. ±y·가운데 실패 | 통 앞 지점은 축에 너무 가까워 수평 불가 (IK 43 ~ 71°). 통 안 여유 한쪽 2 mm -> 퍽 위치를 안 보는 개루프로는 못 넣음 |
| 3 | 원호 끝 = 통 위 + 퍽 위치로 2 번 보정 | 3 통 실패 | 보정 IK 가 무작위 시작점으로 다른 자세로 튐 (스크립트 문제) |
| 4 | 같음 + 지금 자세 근처 IK 만 | 3 통 실패 (보정 IK 80 ~ 230 mm) | 처짐 의심 -> 통 위 자세에서 2 s 처짐 0 ~ 4 mm (팔이 거의 서 있어 중력 토크 작음) -> **처짐 아님** |
| 5 | 통 위 자세를 전역 IK 로 구하고 관절 공간으로 곧장 보간 | 퍽을 쥔 채 이동은 됨 (IK 0.1 mm). 그러나 **실제 잡는 점이 목표보다 6 cm 앞·4.4 cm 위 (z 0.49) 에 멈춤** | 그림 (`sim/mujoco/store_P_top.png`): **집게가 위 카메라 가로대·앞 카메라 (D435) 에 걸림**, 퍽은 가로대 위에 얹힘 |

**영상 (팀 공유용, 2026-10-28)**: `sim/mujoco/videos/store_fail_tube_P.mp4` (+y 통), `store_fail_tube_C.mp4` (가운데 통). 왼쪽 = 옆에서 본 전체, 오른쪽 = 스토리지 가까이, 20 s.
다시 만들기: `~/.venvs/mujoco/bin/python sim/mujoco/side_grasp_check.py --yaw 90 --gap 0.08 --store P --video sim/mujoco/videos/store_fail_tube_P.mp4`.
결과 (시도 5 경로): +y 통 = 퍽이 가로대에 걸렸다가 놓으니 입구에 기울어 걸림 (축에서 11.5 mm, 바닥 382 mm, 직립 0.30), 가운데 통 = 퍽이 로봇 위로 떨어짐. 둘 다 집게가 카메라 가로대 (static_436) 에 0.2 ~ 0.9 mm 닿음.

**원인 (형상)**: 통 위 입구 z ≈ 400 mm 바로 위에 카메라 가로대 (아랫면 z 467 ~ 489 mm, x −0.2 ~ −0.04, y ±0.045) 와 앞 카메라가 있어 **위아래 틈이 약 67 mm**.
옆에서 쥔 퍽을 넣으려면 퍽 60 mm + 입구 위 여유 5 mm + 퍽 윗면 위로 나온 손가락 (잡는 점 = 퍽 중심 + 18 mm, 손가락 위아래 ±29 mm -> 약 17 mm) ≈ **82 mm** 필요 -> **약 15 mm 모자람**. 양옆 통도 가로대·카메라 가장자리에 걸림.
-> **지금 URDF 로는 통 위 입구에 퍽 넣기가 기구적으로 막힘** (스토리지 넣기 학습 보류, 사용자에게 알림).

**정정 (2026-10-28, 사용자 제안 반영)**: 위 '약 15 mm 모자람' 은 손가락 크기를 넉넉히 잡은 어림셈이었음. 정적 검사 (팔 자세 + 쥔 퍽을 놓고 MuJoCo 접촉) 로 다시 확인:
- 통마다 퍽을 세운 채 입구 위에 두는 팔 자세는 **두 갈래뿐**: 앞에서 넘겨 뻗기 [0.36, 0.22, 1.39, 1.49, 0] 와 **사용자 제안 = 1 번 모터 180° 돌리고 3·4 번 굽힘** [−2.78, 0.15, 1.39, −1.49, 0] (±y 통은 대칭, 가운데 통 1 번 ±π). 이 URDF 는 1 번 관절 각 = −(팔이 향하는 방향).
- 둘 다 **손가락이 카메라 가로대 충돌 상자 (static_436) 에 2.1 ~ 2.5 mm** 겹침 (퍽은 안 닿음). 모자란 건 2 ~ 3 mm.
- 쥐는 높이 (잡는 점 = 퍽 중심 + dz) 와 놓는 높이 (퍽 바닥 = 입구 + gap) 별 가장 깊은 겹침:

| dz \ gap | 5 mm | 3 mm | 2 mm | 1 mm |
|---|---|---|---|---|
| +18 mm (지금 집기 정책) | ±y −2.6, 가운데 −2.4 | −2.7 / −0.8 | −2.8 / 0 | −2.9 / 없음 |
| +12 mm | −2.8 / 없음 | −2.5 / 없음 | −2.2 / 없음 | −1.9 / 없음 |
| +8 mm | −1.9 / 없음 | −1.2 / 없음 | −0.7 / 없음 | 없음 / 없음 |
| **+4 mm** | **없음 / 없음** | 없음 | 없음 | 없음 |

- 집기 (상자에서, 6 가지 배치) 는 dz +18: 6/6, **+8: 5/6** (손가락-상자 스침 0.1 ~ 0.4 mm), +4: 4/6 (최대 1.7 mm 닿음) -> 집기·넣기 둘 다 되는 쥐는 높이 = 약 +6 mm.
- **경로 (`--path shape_then_rotate`, dz +6 mm, gap 0.06)**: (가) 앞에서 2·3·4 번을 넣기 자세 모양으로 먼저 바꿔 높이 듦 -> (나) 1 번 모터를 통 쪽으로 돌림 (높은 곳에서 돌아 통·rail 위로). 결과: **퍽을 쥔 채 통 3 개 위까지 옴** (잡는 점 목표에서 3 ~ 5 mm, rail·통에 안 걸림). 그러나 도는 동안 퍽이 손 안에서 약 1.5 cm 아래로 미끄러져 퍽 바닥이 입구보다 낮은 채 옆에서 다가가 테두리에 부딪혀 기움 (직립 0.23 ~ 0.77) -> 놓으니 축에서 10 ~ 15 mm 입구에 걸림. 영상 `sim/mujoco/videos/store_shape_rotate_tube_{P,C,N}.mp4`.
  (먼저 시도한 `--path rotate` = 1 번을 낮은 자세에서 돌린 뒤 3·4 번 굽히기는 집게가 rail_hi 바깥에 걸려 통 옆 z 0.21 에 멈춤.)
- -> **하드웨어를 안 바꿔도 넣기 가능성 있음** (쥐는 높이 약 +6 mm, 사용자 제안 갈래, 높게 다가가 내리기 + 퍽 위치 보정 = 넣기 정책이 배울 것).

가능한 해결 (사용자 결정 필요, 위 정정 전 판단): (1) 카메라 가로대·앞 카메라를 올리거나 통 위를 비킴, (2) 통을 낮춤 (위 입구를 가로대 아래 82 mm 이상), (3) 퍽을 더 낮게 쥠 (잡는 점 = 퍽 중심 − 10 mm -> 손가락이 퍽 윗면 아래로, 필요한 틈 약 65 mm) - 단 상자 위에서 집을 때 손가락이 상자에 닿을 수 있어 집기와 맞지 않음, (4) 입구에 깔때기·옆 투입구.

**시도 6 ~ 9 (2026-10-28 저녁, `--path shape_rotate_final`, 쥐는 높이 +6 mm)**: 앞에서 팔 모양 바꿈 -> 1 번을 통 20° 앞까지 4 s 에 천천히 (퍽 바닥 입구 + 10 mm) -> 마지막 20° 는 짧은 원호로 입구 + 4 mm 로 내림 -> 퍽 실제 위치로 2 번 보정 -> 놓기 -> 7 cm 안으로 빼기.

| 시도 | 바꾼 것 | 가운데 C | +y P | −y N | 원인 |
|---|---|---|---|---|---|
| 6 | 위 경로, 상자 gap 0.06 | 원호 중 퍽 떨어짐 | 축 12.8 mm, 바닥 384, 직립 0.04 | 바닥 96 (떨어짐) | 도는 동안 퍽이 손 안에서 9 -> 12 mm, 마지막 원호에서 21 ~ 45 mm 밀림 |
| 7 | 상자 gap **0.10** (같은 경로) | **통 위까지 쥔 채 옴** (밀림 10.5 mm, 직립 1.00), 축 2.3 mm 에서 놓음 -> 입구에 걸림 (축 9.2 mm, 바닥 385, 직립 0.93) | 마지막 원호에서 퍽 기움 (직립 0.88), arm_link_5 가 가로대 (static_436) 에 닿음 | 원호 끝에서 기움 (0.81) -> 떨어짐 | gap 0.10 이 집을 때 퍽을 더 깊이 쥠 (든 뒤 밀림 9.3 mm 로 안정) |
| 8 | **쥔 채 통 안으로 15 mm 내린 뒤 놓기** (`--insert_depth`) + 놓을 때 0.2 s 마다 퍽 접촉 기록 | 쥔 채 바닥 393 까지만 들어감 (축 1.3 mm, 직립 0.998) -> 놓자 0.2 s 안에 기울어 바닥 384 에 끼임 (직립 0.64) | 7 과 같음 | 7 과 같음 | 놓기 직전 퍽이 이미 통 벽 (base_link convex_26_1) 에 닿음: **쥔 퍽이 3.6° 기울어 있어 통에 끼임** (아래 계산) |
| 9 | 퍽 기울기를 손목으로 상쇄 (퍽 축을 재서 집게 방향을 돌림) + 퍽 **바닥 중심** 을 축에 맞춤, 비틀림 마찰 0.005 / 0.01 / 0.02 m (`--torsion`) | 기울기 2.5 ~ 4° 까지만 줄고 IK 오차 19 ~ 37 mm -> 끼임 | 원호에서 이미 24 ~ 27° 기움 | 떨어짐 | **가운데 통 = 1 번 관절 한계** (아래). 비틀림 마찰을 키워도 나아지지 않음 (0.02 는 오히려 원호에서 떨어짐) |

**찾은 원인 (형상, 2026-10-28)**:
1. **통 틈이 한쪽 1.0 ~ 1.2 mm**: 통 반지름 (실제 메쉬 `geometry_check.py` 5 번, MuJoCo 충돌 형상 광선 측정 둘 다) 높이 330 ~ 390 mm 에서 15.8 ~ 16.2 mm (−y 통 380 ~ 390 은 15.2), 퍽 반지름 14.8 mm (모델 지름 29.6, 실제 30 이면 틈 1.0 mm 이하). 입구는 395 mm 에서 17.6, 400 mm 에서 28.6 으로 약 5 mm 높이 모따기만 있음.
   지름 29.6 · 높이 60 퍽이 지름 32 통에 들어가려면 29.6·cosθ + 60·sinθ ≤ 32 -> **기울기 2.3° 안**. 옆에서 쥔 퍽은 중력으로 손 안에서 2 ~ 4° 기욺 -> 쥔 채 밀어 넣거나 입구 위에서 놓으면 끼임. (입구 위 축 위에서 똑바로 떨어뜨리면 들어감 = 4.5 절 떨어뜨리기 시험.)
2. **가운데 통 C 는 joint1 축 바로 뒤 (180°)** 이고 1 번 관절 한계가 ±180° (URDF ±3.142) -> 통 위에서 퍽을 옆 (y) 한쪽으로 1 ~ 2 mm 옮기려면 한계를 넘어야 함 (반대쪽 +π 로 360° 돌아야 함). 5 자유도 팔이라 옆으로 옮기는 건 1 번 관절뿐. 퍽이 손 안에서 옆으로 2 mm 치우치면 못 맞춤.
3. **카메라 가로대 아래 틈**: 퍽 바닥 = 입구 + 4 mm 일 때 퍽 윗면 465.5 mm, 가로대 아랫면 467 mm -> 1.5 mm. 양옆 통은 가로대 밖이지만 마지막 원호에서 손목 (arm_link_5) 이 가로대에 닿아 퍽이 기욺.

**정책 학습 판단**: 손 IK + 폐루프 보정으로도 2.3° · 1 mm 정밀도가 안 나와, 지금 형상 그대로 넣기 정책을 학습해도 성공 보상을 거의 못 받을 가능성이 큼 (MuJoCo 기준, Isaac PhysX 접촉은 아직 안 봄).
가능한 해결 (사용자·팀 결정): (가) 통 위에 깔때기 (입구 40 mm 이상, 높이 10 mm 이상) 또는 통 안지름 34 ~ 35 mm, (나) 가운데 통을 joint1 축 바로 뒤에서 옮기거나 1 번 관절을 ±180° 넘게 쓸 수 있는지 확인 (다이나믹셀이면 다중 회전 모드), (다) 카메라 가로대를 10 mm 이상 올림, (라) 하드웨어 그대로면 Isaac 에서 같은 넣기를 먼저 확인 (PhysX 는 접촉이 덜 뻣뻣해 끼임이 덜할 수 있음).

넣기 정책 시작 상태 (쥔 채 통 쪽으로 가는 도중) 를 미리 뽑아 둠: `side_grasp_check.py --dump_starts <json>` -> `sim/isaac/store_starts/starts_{C,P,N}_gap{0.06,0.10}.json` (0.2 s 마다 팔 관절·잡는 점·arm_link_5 자세·손 안 퍽 위치, 단계 reshape/rotate/final 표시, 경로마다 66 개).
영상 (팀 공유용): `sim/mujoco/videos/store_final_tube_{C,P,N}.mp4` (시도 6, gap 0.06), `store_final_gap10_tube_{C,P,N}.mp4` (시도 7), **`store_jam_tube_C.mp4` (시도 9, 쥔 채 넣다 통에 끼임)**.
다시 만들기: `MUJOCO_GL=egl ~/.venvs/mujoco/bin/python sim/mujoco/side_grasp_check.py --yaw 90 --gap 0.10 --grasp_dz 0.006 --store C --path shape_rotate_final --insert_depth 0.015 --video sim/mujoco/videos/store_jam_tube_C.mp4`.

### 4.10 스토리지 넣기 `Waffle-Store-Direct` (2026-10-28, 사용자 요청: "집었을 때 팔을 더 들어 올려 스토리지에 넣게 학습, 몸체에 부딪히면 강한 음의 보상")

파일: `sim/isaac/waffle_isaac/store_env_cfg.py`, `store_env.py`, `agents/rsl_rl_ppo_cfg.py: WaffleStorePPORunnerCfg` (집기와 같은 망, **gamma 0.99** = 에피소드 10 s), 시작 상태 `sim/mujoco/store_starts.py` -> `sim/isaac/store_starts.json`, 확인 `store_check.py`, 진단 `store_diag.py`.
실행: `./run_isaac.sh store_check`, `store [환경] [반복]`, `store_play [환경]`, `store_diag [환경]`.

**0 단계 확인 (Isaac PhysX, `store_check.py`)**
- 팔-몸체 접촉 센서 (같은 관절체 안 arm_link_2 ~ 5·손가락 vs base_footprint = 합쳐진 base_link): 앞 자세 0 N, 앞으로 접어 몸체에 누르면 31 ~ 678 N -> **센서 됨**. (처음 시험 자세 [π, 1.2, 1.4, 0.3, 0] 은 MuJoCo 에서도 안 닿는 자세라 0 N 이었음.)
- 퍽 접촉 거리 (contact_offset) 기본값 -> 0.002 m, rest 0 (통 틈 1.2 mm). 바꿔도 아래 결과 같음.
- 퍽 떨어뜨리기 (퍽 반지름 15 mm):

| 놓는 높이 | 가운데 C | +y P | −y N |
|---|---|---|---|
| 입구 + 5 mm, 축 위 | 입구 아래 24 mm 에 걸림 (직립 0.99) | 테두리에 기울어 걸림 (0.73) | 걸림 (0.94) |
| 입구 + 5 mm, 1.5 mm·3° | 바닥으로 튕김 | 걸림 | 걸림 |
| 입구 + 3 mm | 튕김 | 걸림 | 걸림 / 튕김 |
| **입구 아래 10 mm (통 안), 축 위** | 14 mm 에 걸려 기욺 (0.67) | **통 안 303 까지 내려감 (좁아진 곳)** | **303 까지** |
| **입구 아래 10 mm, 1.5 mm·3°** | 걸림 | **303 까지** | **303 까지** |

- 축 둘레 7 x 7 격자 (1.5 mm 간격, 입구 + 5 mm): 결과가 1.5 mm 마다 들쭉날쭉 (통 안 끝까지 / 테두리 걸림 / 바닥으로 튕김) -> 입구 위에서 놓는 건 Isaac 에서도 불안정. 반지름 14.8·14 mm 퍽도 비슷.
- -> **설계: 쥔 채 퍽 아래쪽을 통 안으로 15 mm 넣은 뒤 놓음**. **양옆 P·N 통부터 학습** (가운데 C 는 Isaac 충돌 형상에서 14 mm 깊이에 걸림: MuJoCo 에서는 통과 -> URDF 충돌 메쉬 part026 (가운데 통) 확인 필요).

**시작 상태 (`store_starts.py`, MuJoCo IK, 1900 개)**: 집게 수평 (± 기움)·카메라 위·닫는 축 수평, 퍽은 잡는 점 6 mm 아래 세워 쥠, 몸체와 겹치는 자세 버림 (IK 1210·충돌 1644 버림).
A 집은 직후 976 (앞, joint1 축 0.19 ~ 0.34 m, 퍽 중심 z 0.12 ~ 0.24, 목표 통 무작위), B 가는 도중 437, C 통 위 487 (축 ± 3 cm, 퍽 바닥 입구 + 2 ~ 30 mm). 뽑는 비율 A 45 %, B 30 %, C 25 %.

| 항목 | 값 |
|---|---|
| 장면 | 바닥, 로봇 (자기 충돌 켬, 접촉 보고 켬, 접촉 거리 2 mm), 원기둥 퍽 1 개 (상자 퍽 30 x 30 은 대각선 42 mm 라 통에 안 들어감), 접촉 센서 2 개 (팔·손가락 vs 몸체, 퍽 vs 몸체), 256 환경 |
| 제어 | 30 Hz, 에피소드 10 s, 행동 6 (집기와 같음: 팔 += 0.04 rad x 행동, 집게 > 0 벌림) |
| 관측 41 | 팔 위치·속도 10, 손가락 1, 잡는 점 3, 퍽 − 잡는 점 3, 퍽 축 3, 목표 통 입구 3, 퍽 바닥 − 입구 3, 집게 방향 3, 닫는 축 3, 통 one-hot 3, 이전 행동 6 (퍽 자세 = 시뮬레이션 참값: 실제 로봇엔 센서 없음, 나중에 빼거나 추정) |
| 보상 (넣기 전, 쥐고 있을 때) | 쥠 0.5, **들기 2 x (퍽 바닥이 입구 − 30 cm -> 입구 + 12 mm, 연속)**, 다가가기 1.5 x (1 − tanh(d/0.15)) + 2 x (1 − tanh(d/0.01)) **x 높이 게이트 (퍽 바닥이 입구 − 10 cm 아래면 0 -> 입구에서 1) = 먼저 들어야 다가가기 보상**, 직립 1 |
| 보상 (넣기) | 축 4 mm 안·직립 0.99 에서 내린 깊이 4 x (입구 + 10 -> 입구 − 30 mm), 통 안 (입구 − 15 mm, 축 6 mm) +5, 통 안에서 놓음 +5, 넣기 끝 (입구 − 60 mm, 놓고 빈손) +10, 놓은 뒤 집게 뺌 +2 |
| **벌점** | **팔·손가락-몸체 접촉 −15 / 스텝 (1 N 넘으면), 세게 부딪힘 (15 N 넘으면) −50 + 종료**, 퍽이 통 밖에서 몸체에 닿음 −3, 넣기 전에 퍽 놓침 −20 + 종료, 퍽 기울기 −2 x (1 − 축 z), 차체 1 cm 밀림 −10, 행동 변화² −0.02, 관절 속도² −0.001, 차체 기울기 −8 |
| 성공 | 넣기 끝 상태로 0.5 s |

시험 (64 환경 5 반복): 반복당 1.5 s, 무작위 동작 쥠 86 %, 팔-몸체 접촉 1.6 ~ 6 %, 퍽-몸체 9 ~ 11 %.

| 회차 | 날짜 · 결과 폴더 | 바꾼 것 | 결과 | 원인 / 비고 |
|---|---|---|---|---|
| ST1 | 2026-10-28 · `waffle_store/2026-10-28_21-31-18` (`model_299.pt`, exported/policy.pt) | 처음 (위 설정), P·N 통, 256 환경 300 반복 (약 9 분) | 보상 −26 -> 693 (50) -> 875 (100) -> 1059 (200) -> **1140 (299)**, 에피소드 7 -> 290 스텝 (중간 종료 거의 없음), **쥠 100 %, 팔-몸체 접촉 17 % (0 반복) -> 0 %**, 퍽 최고 높이 입구 + 30 ~ 80 mm, 통 축까지 최소 22 ~ 50 mm, **맞춤·넣기 0 %** | `store_diag` (A 집은 직후 8 대, `sim/isaac/store_diag_ST1.log`): 2 s 안에 퍽을 입구 + 20 ~ 40 mm 로 들고 1 번 관절을 ±2.4 ~ 2.6 rad 로 돌림 (P·N 통 방향 ±2.78 쪽, 부호 맞음), **통 축 6 ~ 8 cm 앞에서 멈춰 머묾**, 팔-몸체 최대 힘 0 N, 퍽 직립 0.96 ~ 0.99. 원인: 더 가려면 손목이 카메라 가로대 옆을 지나야 하는데 (MuJoCo 에서도 arm_link_5-static_436 0 mm) 8 -> 4 cm 다가가도 보상이 +0.3 / 스텝뿐이고 접촉 −15 위험 -> 머무는 게 이득 |
| ST2 | 2026-10-28 · `waffle_store/2026-10-28_21-41-32` (`model_598.pt`, exported/policy.pt) | ST1 `model_299` 에서 이어서 300 반복. 다가가기 중간 항 3 x (1 − tanh(d/0.03)) 추가, 가까운 항 2 -> 3 (d/0.008), **통 5 cm 안 높이 맞춤 2 x (1 − tanh(\|퍽 바닥 − (입구 + 8 mm)\|/0.01))** 추가, 맞춤 조건 4 -> 5 mm·직립 0.99 -> 0.98, 시작 비율 A·B·C 0.45·0.30·0.25 -> 0.35·0.25·0.40 | 보상 1140 -> 1114 (312) -> 1307 (362) -> 1632 (422) -> 1898 (482) -> 2485 (537) -> **2510 (598)**. 통 축 최소 거리 36 -> 14 (422) -> **0.2 ~ 0.4 mm**, **맞춤 (5 mm·직립 0.98) 0 -> 15 (482) -> 55 ~ 58 %**, 퍽 바닥 평균 입구 − 0.5 mm, 퍽 직립 0.995, 팔-몸체 접촉 0 ~ 2 %, 퍽-몸체 3 ~ 5 %, **넣기 0 %**. 행동 표준편차 0.93 (안 줄어듦) | `store_diag` (결정적 행동, A 시작 8 대, `store_diag_ST2.log`): **4/6 이 4 s 안에 통 축 2 ~ 5 mm·입구 위 3 ~ 5 mm 에 직립 1.0 으로 와서 머묾** (팔-몸체 0 N) -> 내리지 않음 (통 틈 한쪽 1 mm 라 2 ~ 5 mm 로는 테두리에 걸림, 4 -> 1 mm 보상 차이 작음). 2 대는 목표 N 인데 P 로 감 (1 번 −2.78, 123 mm = P-N 간격). 2 대는 중간 종료 (팔-몸체 13 ~ 14 N 세게 부딪힘) |
| ST3 | 2026-10-28 · `waffle_store/2026-10-28_21-51-56` (`model_897.pt`, exported/policy.pt) | ST2 `model_598` 에서 이어서 300 반복. **정밀 항 4 x (1 − tanh(d/0.002))** 추가, 내리기 보상 = 깊이 x (1 − tanh(d/0.003)) x 직립 (5 mm 켜고 끄기 -> 연속), 4 -> 6, entropy 0.006 -> 0.003 | 보상 2510 -> 2741 (636) -> 2982 (691) -> 3346 (750) -> **3518 (897)**, **맞춤 (5 mm) 58 -> 68 -> 82 -> 86 %**, 퍽 바닥 평균 입구 −0.8 ~ +1.4 mm, 직립 0.990 ~ 0.996, 행동 표준편차 0.91 -> 0.73, 팔-몸체 0 ~ 1 %, **넣기 0 %** | 맞추지만 입구 위 5 ~ 9 mm·축 1 ~ 2.5 mm 에서 머물고 안 내림. 아래 '정책 + 손 IK' 확인으로 원인 = **손가락이 통 위에 닿는 것 (4 ~ 10 N) 까지 팔-몸체 −15 로 벌점** -> 내리기를 피하도록 배움 |
| ST4 | 2026-10-28 · `waffle_store/2026-10-28_22-04-29` (`model_1196.pt`) | ST3 `model_897` 에서 이어서 300 반복. **접촉 센서를 팔 링크 2 ~ 5 / 손가락으로 나눔**: 팔 링크-몸체 −15 / 스텝·15 N 넘으면 −50 + 종료 (그대로), **손가락-몸체는 넣는 자리 (통 축 8 mm·입구 위 3 cm 안) 에서만 −1** (밖에서는 −15·종료 그대로) | 보상 3518 -> 3662 (935) -> 3694 (990) -> 3604 (1050) -> 3803 (1150) -> **3696 (1196)** = 평평, 맞춤 80 ~ 87 %, 축 최소 0.03 ~ 0.09 mm, **퍽 바닥 평균 입구 −0.6 ~ −5.6 mm (모따기 안까지 내려옴)**, 손가락-넣는 자리 접촉 0 ~ 2 %, 팔-몸체 0 %, 행동 표준편차 0.67 -> 0.65, **넣기 0 %** | 손가락 벌점을 풀자 모따기 안 (입구 아래 2 ~ 6 mm) 까지는 내림. 더 못 들어감 = 탐색 흔들림 (0.65 x 0.04 rad ≈ 5 mm / 스텝) > 통 틈 1 mm |
| ST5 | 2026-10-28 · `waffle_store/2026-10-28_22-14-39` (`model_1495.pt`, exported/policy.pt) | ST4 `model_1196` 에서 이어서 300 반복. **정밀 모드: 통 축 15 mm·입구 위 3 cm 안에서 행동 크기 x 0.25 (0.04 -> 0.01 rad)** | 보상 3696 -> 3750 (1234) -> 3617 (1289) -> 3527 (1400) -> **3655 (1495)** = 평평, 맞춤 77 ~ 84 %, 퍽 바닥 평균 입구 −0.2 ~ −8.2 mm, 손가락-넣는 자리 접촉 6 ~ 13 %, 팔-몸체 0 ~ 1 %, 행동 표준편차 0.66, **넣기 0 %** | 정밀 모드로 모따기 안까지 더 자주 내려오지만 (손가락 접촉 늘어남) 15 mm 까지는 못 넣음. **순수 강화 학습은 '1 mm 틈에 내려 넣기' 단계에서 막힘 (ST2 ~ ST5, 1200 반복)** |

**정책 + 손 IK 확인 (`store_hybrid.py`, ST3 정책, 16 대, 2026-10-28)**: 정책이 퍽을 축 위에 맞추면 (조건 아래) 그 뒤는 야코비안 IK 로 퍽 바닥을 축에 맞추며 1 mm / 스텝 내려 쥔 채 입구 아래 18 (또는 10) mm -> 집게 열기 0.5 s -> 위로 4 cm 뺌.

| 맞춤 조건 · 내리는 깊이 | 맞춤까지 | **통 안 (입구 아래 60 mm 넘게)** | 팔 링크-몸체 | 손가락-몸체 |
|---|---|---|---|---|
| 축 1.5 mm · 직립 0.995 · 18 mm | 3/16 | **3/3** (입구 아래 90 ~ 96 = 양옆 통 좁아진 곳 303 mm 까지, 직립 0.999) | (나누기 전) 6 ~ 8 N | - |
| 축 2.5 mm · 직립 0.985 · 18 mm | 12/16 | **9/12** (실패 3 = 입구 아래 11 ~ 49 mm 에서 기울거나 아직 쥠) | **0 N** | **4 ~ 10 N** (내리기·열기 때), 1 대 52 N (열기) |
| 축 2.5 mm · 직립 0.985 · 10 mm | 11/16 | 7/11 (얕게 넣으면 4 대가 입구에 기울어 걸림) | 0 N | 4 ~ 9 N |

| **ST3 정책 · 32 대** (축 2.5 mm · 직립 0.985 · 18 mm, 손가락 센서 나눈 뒤) | **32/32** | **21/32 = 66 % (P 11/16, N 10/16)** | **0 N** | 보통 약 11 N, 최대 66 N (1 대) |
| ST5 정책 · 32 대 (같은 조건) | 16/32 | 11/32 (P 6/17, N 5/15) | 최대 20 N (1 대) | 최대 44 N |

-> **Isaac 에서 쥔 채 통 안으로 내려 넣기는 물리적으로 됨** (양옆 통). 정책이 안 내린 건 보상 문제 (손가락-통 위 접촉 벌점). 18 mm 넣고 놓는 게 10 mm 보다 나음.
실행: `./run_isaac.sh store_hybrid [환경]` (창: `store_hybrid_play [환경]`), 기본 정책 = `sim/isaac/policies/store_ST3.pt` (ST3 exported 복사본), 기본 조건 축 2.5 mm · 직립 0.985 · 18 mm.

**지금 결론 (2026-10-28, ST1 ~ ST5 1500 반복)**:
- 강화 학습이 하는 것: 집은 퍽을 쥔 채 **높이 들고 (입구 + 1 ~ 3 cm), 1 번을 ±2.78 rad 로 돌려, 3·4 번을 굽혀 통 축 위 2.5 mm 안에 세움** (ST3 결정적 32/32), **팔 링크-몸체 접촉 0 N** (강한 벌점 −15 / 스텝, 15 N 넘으면 −50 + 종료).
- 강화 학습이 못 하는 것: 통 틈 1 mm 에 마지막 15 mm 내려 넣기 (ST2 ~ ST5 넣기 0 %). 탐색 흔들림이 틈보다 크고, 정밀 모드 (ST5) 도 효과 없음.
- **쓸 것 = ST3 정책 (옮기기·맞추기) + 손 IK (내리기 18 mm·놓기·빼기) = 66 %**. 실패 34 % 는 맞춘 뒤 내리는 중 테두리에 기울어 걸림 (입구 아래 5 ~ 22 mm).
- 남은 것: 가운데 C 통 (Isaac 충돌 형상 확인), 성공률 올리기 (IK 내리기 때 퍽 기울기 보정, 통 입구 깔때기 = 하드웨어), 실제 로봇엔 퍽 자세 관측이 없음 (관측에서 빼고 다시 학습 필요), 스토리지 맨 아래 퍽 빼기 · L1 ~ L3 놓기.

### 4.11 매니퓰레이터 모델 구성 · ROS 연결 규칙 (2026-10-29 결정)

단계마다 모델 (정책 파일) 을 따로 만들고, ROS 노드 하나가 모두 불러 상태 머신으로 골라 씀 (합치기 = 실행할 때 이어 붙이기. 모델 하나로 증류는 전체가 다 된 뒤 필요하면).
'에피소드' 는 학습 때 시도 1 번 (리셋 -> 끝) 일 뿐, 결과물은 모델 파일 (가중치) 하나. 실제 로봇은 에피소드 없이 30 Hz 로 계속 관측 -> 행동.

| 순서 | 단계 | 모델 (과제 ID) | 상태 | 다음 단계로 넘어가는 조건 |
|---|---|---|---|---|
| 1 | 상자 위 퍽 정렬·집기 | `Waffle-SidePick-Direct` | 있음 (SP3) | 퍽을 쥐고 3 cm 이상 듦 |
| 2 | 들고 돌려 통 위 맞추기 | `Waffle-Store-Direct` | 있음 (ST3, 맞춤 32/32) | 퍽 바닥-통 축 2.5 mm 안, 입구 위 12 mm 안 |
| 3 | 통 안에 넣기 (놓고 빼기까지) | `Waffle-Insert-Direct` (4.12 절) | **IN1 통 위에서 62 %** (IN2 47 %) | 퍽이 통 안 (입구 아래 60 mm) + 집게 뺌 |
| 4 | 스토리지 맨 아래 퍽 빼기 | (먼저 손 IK 고정 궤적으로 시험, 안 되면 강화 학습) | 아직 | 퍽을 쥐고 통 밖 |
| 5 | L1 ~ L3 칸에 정밀하게 놓기 | (강화 학습, 3.x 놓기 경험 참고) | 아직 | 놓고 집게 뺌 |

- 강화 학습이 꼭 필요한 곳 = 매번 위치가 바뀌는 단계 (1 인식 좌표, 5 상자·칸 위치). 스토리지는 몸체에 고정이라 4 (와 깔때기가 생기면 2·3) 은 고정 궤적으로 될 수 있음.
- 통 입구에 깔때기가 생기면 2 와 3 을 합칠 수 있음 (모델 4 개).

**ROS 연결 규칙 (manipulator 노드, 30 Hz)**
1. 관측은 학습 때와 똑같이: 순서, 좌표계 (base_link), 단위 (m, rad), 기준 자세 (관측 = 관절 − 과제의 기준 자세). 관측 정규화는 내보낸 모델 (`exported/policy.pt`·`policy.onnx`) 안에 있음.
2. 행동 해석도 같게: 1·2 = 팔 관절 목표 += 0.04 rad x 행동, 실제 각 ±0.25 rad 안, 관절 한계 안. 3 = 집게 끝 (잡는 점) 위치 변화 (아래 4.12) -> IK. 집게 = 행동 > 0 이면 벌림 0.015, 아니면 닫기 −0.0014 (gripper_left_joint).
3. **실제 로봇에서 못 재는 값은 관측에 넣지 않음**: 퍽 자세 (시뮬레이션 참값) 는 2 (ST3) 가 아직 씀 -> 나중에 빼고 다시 학습. 3 부터는 실제로 얻을 수 있는 것만 (관절 위치·속도·토크 (= 다이나믹셀 전류), 정기구학 잡는 점, 통 위치 (고정), 손가락).
4. 단계 전환 조건은 위 표 (정기구학 + 인식 + 집게 값으로 판단).

### 4.12 넣기 전용 `Waffle-Insert-Direct` (2026-10-29, 모델 3 번째 단계)

파일: `sim/isaac/waffle_isaac/insert_env_cfg.py`, `insert_env.py` (장면·접촉 판정은 store_env 를 이어 씀), `agents/rsl_rl_ppo_cfg.py: WaffleInsertPPORunnerCfg`, 시작 상태 `sim/isaac/insert_starts.json`.
실행: `./run_isaac.sh insert [환경] [반복]`, `insert_play [환경]`, `insert_eval [환경]` (결정적 행동, 시작 위치별 성공률·종료 이유·몸체 접촉 힘).

**왜 따로 만드나** (4.10 절 결론): ST1 ~ ST5 는 관절 공간 행동 (0.04 rad) 이라 탐색 흔들림 ≈ 5 mm > 통 틈 1 mm, 그리고 통 안에 들어간 적이 없어 넣기 보상을 못 봄 -> 넣기 0 %.
바꾼 것 3 가지: (1) **행동 = 집게 끝 (잡는 점) 위치 변화 x 1 mm / 스텝 + IK** (자세는 유지), 탐색 표준편차 0.5, (2) **역방향 커리큘럼** (통 안·모따기에서 시작하는 것 섞음), (3) **정책은 실제 로봇에서 얻을 수 있는 관측만** (평가 critic 만 시뮬레이션 참값 = asymmetric actor-critic).

**시작 상태 (`store_hybrid.py --collect`, ST3 + 손 IK 96 대 = 이 실행에서 통 안 73/96)**: 통 축 6 mm·입구 위 20 mm 안에서 쥔 상태를 3 스텝마다 기록 -> 2341 개 (통 위 390, 모따기 (입구 −2 ~ +6 mm) 119, 통 안 1832). 뽑는 비율 통 위 50 %, 모따기 25 %, 통 안 25 %.

| 항목 | 값 |
|---|---|
| 장면 | 스토리지 넣기와 같음 (원기둥 퍽, 접촉 센서 팔 링크 2 ~ 5 / 손가락 / 퍽 vs 몸체, 접촉 거리 2 mm), 256 환경, 양옆 통 P·N |
| 제어 | 30 Hz, 에피소드 4 s, 행동 4 = 잡는 점 (x, y, z) 변화 x 1 mm (base_link) -> 감쇠 최소제곱 IK (arm_link_5 자세 유지 가중치 0.3), 집게 > 0 벌림 |
| 정책 관측 35 (실제 로봇에서 얻을 수 있는 것) | 팔 위치 (기준 자세 [2.78, 0.35, 0.97, −1.32, 0] 기준) 5, 속도 5, **토크 5 (= 다이나믹셀 전류, 테두리 닿음 느낌)**, 손가락 1, 잡는 점 3, 통 입구 3 (**에피소드마다 ±0.5 mm 보정 오차**), 추정 퍽 바닥 (잡는 점 − (0, 0, 36 mm)) − 통 입구 3, 집게 방향 3, 통 one-hot 3, 이전 행동 4 |
| 평가 (critic) 관측 + 12 (시뮬레이션 참값) | 퍽 중심 − 잡는 점 3, 퍽 축 3, 참 퍽 바닥 − 통 입구 3, 손가락·팔 링크·퍽 -몸체 접촉 힘 3 |
| 보상 | 쥐고 넣기 전: 축 맞춤 2 x (1 − tanh(d/2 mm)) + 깊이 4 x (입구 + 5 -> 입구 − 20 mm) x (1 − tanh(d/4 mm)); 통 안 (15 mm) 쥔 채 +5, 통 안에서 놓음 +5, **넣기 끝 (입구 − 60 mm, 빈손) +20**, 놓은 뒤 집게 뺌 3 x (6 cm 까지) |
| 벌점 | **팔 링크-몸체 −15 / 스텝, 세게 (15 N) −50 + 종료** (스토리지 넣기와 같음), 손가락-몸체 넣는 자리 밖 −15 / 안 −1, 손가락 끼임 (넣는 자리에서 15 N 넘게) −2, 퍽 통 밖 몸체 접촉 −3, 넣기 전 놓침 −20 + 종료, 퍽 기울기 −5 x (1 − 축 z), 시간 −0.05 / 스텝, 행동 변화² −0.01, 차체 기울기 −8 |
| 성공 | 넣기 끝 상태로 0.5 s |
| PPO | 256-128-64, 학습률 3e-4, gamma 0.99, entropy 0.003, 탐색 시작 표준편차 0.5, 300 반복 |

시험 (64 환경 5 반복): 반복당 1.8 s, 무작위 동작에서 통 안 73 % (통 안 시작), 넣기 끝 22 %, 팔-몸체 접촉 5 %.

| 회차 | 날짜 · 결과 폴더 | 바꾼 것 | 결과 | 원인 / 비고 |
|---|---|---|---|---|
| IN1 | 2026-10-29 · `waffle_insert/2026-10-29_09-39-40` (`model_299.pt`, exported/policy.pt) | 처음 (위 설정), 256 환경 300 반복 (약 10 분) | 보상 111 -> 1113 (34) -> 1404 (89) -> 1309 (189) -> 1600 (239) -> **1606 ~ 1711 (299)**, 통 안 65 -> 75 %, 넣기 끝 41 -> 50 %, 팔-몸체 0.4 ~ 2 %, 행동 표준편차 0.5 -> 0.16. **`insert_eval` (결정적, 192 대): 통 위 시작 62 % (58/93) = 처음으로 강화 학습만으로 넣음**, 모따기 43 %, 통 안 73 %, 전체 60 %, P 57 % · N 62 %. 팔 링크-몸체 1 N 넘은 대 4/192 (최대 15 N) | 실패: 시간 끝 (입구 아래 10 ~ 23 mm 에서 기울어 끼인 채 안 놓음) 24 + 6 + 14, 넣기 전 놓침 (모따기에서 일찍 열어 기욺) 9 + 15 + 7, **넣은 뒤 뒤로 빼다 팔 링크가 몸체에 15 N (2 대)** = 빼기 보상이 '아무 방향 6 cm' 라서 |
| IN2 | 2026-10-29 · `waffle_insert/2026-10-29_09-52-25` (`model_598.pt`) | IN1 `model_299` 에서 이어서 300 반복. **빼기 보상 = 위로만** (잡는 점 입구 + 3 -> + 8 cm), **잘 놓음 +3** (통 안 10 mm 넘게·축 3 mm·직립 0.99 에서 열기), 에피소드 4 -> 6 s | 보상 (척도 바뀜) 1126 -> 2649 (353) -> 2785 (403) -> 2610 (500) -> 2505 (598), 통 안 81 ~ 84 %, 넣기 끝 54 ~ 61 %, 끼임 6 ~ 10 % (IN1 1 %), 행동 표준편차 0.16. **`insert_eval`: 통 위 47 % (IN1 62 % 보다 나쁨)**, 모따기 32 %, 통 안 71 %, 전체 47 %, P 38 % · N 55 %. **팔 링크-몸체 최대 2.2 N (1 대) = IN1 (15 N) 보다 좋아짐** | 실패: 시간 끝 37 + 14 + 5 (끼인 채), 넣기 전 놓침 17 + 22 + 6 (늘어남: '잘 놓음 +3' 이 일찍 열기를 부추긴 듯). 손가락-통 위 힘 평균 7 -> 14 N (더 세게 누름). **이어 붙이기는 IN1 을 씀** (`policies/insert_latest.pt` = IN1) |

**이어 붙여 실행 (`chain_play.py`, 2026-10-29, 64 대, 25 s, 정렬·집기 장면 + 스토리지)**: 집기 SP3 -> (쥐고 3 cm 0.5 s) -> 옮기기·맞추기 ST3 -> (통 축 2.5 mm·입구 위 12 mm·직립) -> 넣기 IN1.

| 단계 | 결과 |
|---|---|
| 1 집기 (SP3) | **60/64 성공** |
| 2 옮기기·맞추기 (ST3) | **7/64 만 통 위 맞춤**. 많은 대가 옮기다 퍽을 떨어뜨림 (바닥 391 mm, 통 옆 273 mm), **팔 링크-몸체 24 ~ 137 N (1 N 넘은 스텝 합 4916)** |
| 3 넣기 (IN1) | 0/7 (맞춘 7 대도 입구 위 −28 ~ +12 mm 에 머묾) |

**원인 = 이어 받는 상태가 학습 때와 다름**: ST3 는 MuJoCo IK 로 만든 '퍽을 잡는 점 6 mm 아래 딱 맞게 쥔' 시작 상태 (store_starts.json) 로만 학습. 실제 SP3 가 끝난 상태는
팔 자세 (팔꿈치 한계 −1.4 근처, 집게 6 ~ 12° 아래로), 손 안 퍽 위치 (높이 오차 −10 ~ +20 mm), 상자 옆이 달라 ST3 가 처음 보는 상태 -> 퍽을 놓치거나 몸체에 부딪힘. 넣기 IN1 도 ST3 + 손 IK 상태로만 학습.
**고칠 것**: 앞 모델이 실제로 끝나는 상태를 모아 (이음 실행에서 기록) 다음 모델의 시작 상태로 써서 이어서 학습 (ST3 -> ST6, IN1 -> IN3). 실제 로봇 이음도 같은 문제라 꼭 필요.

### 4.13 URDF 261028 로 옮김 (2026-10-29, 패키지 `~/Downloads/urdf_261028/waffle_4wd_description_261028/`)

사용자가 새 패키지 폴더에 이전 `sim/` 을 복사 -> 이전 정책들을 이어서 다시 학습. 이전 폴더 (`urdf_261027_1711`) 는 그대로 (백업).
바뀐 것 (`REVISION_261028.md`): **팔이 통째로 바뀜 (arm_bench)**, 루트 링크 base_footprint -> **base_link**, 바퀴 이름 `wheel_{left,right}_{front,rear}_joint`, J1 축 x 87 -> 96 mm,
옛 라이다 -> LDS-03 2 개, TFmini·Jetson·OpenCR·배터리가 따로 링크. **퍽 스토리지 통·카메라 가로대는 그대로** (geometry_check 5·6 이전과 같음).

**새 팔 (261028)**: joint1 요 (z, **부호 뒤집힘 없음** = 각 = 팔이 향하는 방향), joint2·3·4 피치 (y), joint5 손목 롤 (x). 영 자세 = 팔 수평 앞 (+x), 카메라 위.
집게 몸 `gripper_roll_link`: **집게 방향 +x, 닫는 축 y, 카메라 위 +z**. 손가락 `gripper_left/right_joint` 각자 prismatic (mimic 없음, 시뮬레이션은 같은 값으로 대칭 구동), `gripper_roll` = 그리퍼 개폐 모터 각 (빈 링크, 시뮬레이션 0 고정, 손가락과의 관계 미정 = ROS 연결 때 정해야 함).

| 값 | 261027 | **261028** | 근거 |
|---|---|---|---|
| 집게 몸 · 잡는 점 | arm_link_5 (0, 0, −0.108) | **gripper_roll_link (0.14, 0, 0)** | 손가락 패드 x 0.125 ~ 0.155 |
| 벌림 | 19.6 + 2000 q mm | **41.6 + 2000 q mm** (패드 가운데 띠 y ±20.8 mm) | 충돌 상자 단면 |
| 집게 벌림 / 닫기 / 쥠 (30 mm) | 0.015 / −0.0014 / 0.0032 | **0.004 / −0.011 / −0.0058** | 49.6 mm 벌림 같게 |
| **손가락끼리 충돌** | - | **끔** (MuJoCo exclude, USD FilteredPairs) | 랙 충돌 상자가 가운데를 넘어 겹쳐 −0.0046 (32 mm) 에서 멈춤 -> 30 mm 퍽 못 쥠 |
| 로봇 앞 끝 (상자 높이) | 0.218 (라이다 받침) | **0.140** (TFmini) | geometry_check 1 |
| joint1 축 x | 0.087 | **0.096** | geometry_check 2 |
| 집게 수평 도달 (joint1 축) | 0.28 ~ 0.38 m | **0.26 ~ 0.36 m** | geometry_check 4 |
| 상자 gap · sweet_radial | 5 ~ 11 cm · 0.33 | **9 ~ 17 cm · 0.30** | side_grasp_check: gap 10 ~ 18 cm 에서 집기·5 cm 들기 됨 (손목 joint4 가 한계 −1.92 근처) |
| 통 위 집게 수평 최대 높이 | 잡는 점 0.44 m | **0.44 m** (0.45 면 2°) | IK |
| 정렬·집기 시작 자세 READY | [0.12, −0.49, −1.07, 1.56, 0] | **[0, 1.07, 0.60, −1.66, 0]** (N3) | IK (잡는 높이·joint1 축 0.28 m) |
| **잡는 높이 grasp_dz** | +6 mm | **+15 mm** (N3) | 손가락이 집게 축 아래 29 mm |
| 옮기기 관측 기준 START / 넣기 INSERT | [0.3, −0.5, −1.2, 1.6, 0] / [2.78, 0.35, 0.97, −1.32, 0] | **[0, 0.72, 0.61, −1.33, 0] / [2.80, −0.49, −0.52, 1.01, 0]** | IK (통 위 = 팔을 뒤로 젖힘) |
| 팔 토크·속도 한계 | 3.8 N·m · 4.5 rad/s | **4.1 · 4.8** | URDF |
| **팔 강성·감쇠** | 19 · 0.85 | **60 · 2.0** (N4) | 새 팔 처짐 10 ~ 18 mm -> 0 ~ 6 mm |
| 접촉 센서 팔 / 손가락 / 몸체 | arm_link_[2-5] / … / base_footprint | **(link[2-5]\|gripper_roll_link) / gripper_*_link / base_link** | Isaac 은 고정 링크를 base_link 에 합침 |

**옮기며 고친 것** (다음에 URDF 가 바뀌면 이 두 파일만 먼저 볼 것): `sim/tools/arm_def.py` (MuJoCo 스크립트 공용: 집게 몸·잡는 점·축·손가락 값·몸체 몸 목록), `sim/isaac/waffle_isaac/robot_cfg.py` (Isaac: 같은 값 + `ee_axes` = 이전 arm_link_5 축 뜻으로 맞춘 순서).
그 밖: `prepare_sim.py` (Gazebo 태그 뺌, 남은 메쉬 지움), `build_mjcf.py` (루트 base_link, 손가락 대칭 equality, gripper_roll 고정, inertial pos), `convert_urdf.py` (새 이름 게인, 손가락 충돌 끔), 세 환경 (집게 축·손가락 두 개 구동·몸체 이름), `side_grasp_check.py`·`geometry_check.py`·`store_starts.py` (새 팔 IK 씨앗).
**이전 정책 파일 (.pt) 은 못 씀**: 관절 뜻·길이·집게 좌표가 달라 같은 관측이 다른 자세를 뜻함 -> 설계 (보상·커리큘럼·시작 상태·접촉 벌점·넣기 전용 모델) 를 이어받아 가중치는 새로 학습.

Isaac 확인 (`store_check`): 통 안 10 mm 에서 놓으면 P·N 통 303 mm 까지 (1.5 mm·3° 어긋나도), C 는 14 mm 에 걸림 (이전과 같음). 팔-몸체 접촉 센서: 뒤로 돌려 스토리지에 누르면 33 ~ 179 N (됨).
`store_starts.py` (새 팔): 1900 개 (A 1018, B 424, C 458), IK 1365·충돌 1918 버림.

**버그 고침 (2026-10-29): Isaac·MuJoCo 에서 팔이 투명하게 (대부분 안) 보임**. 원인 = URDF·USD 변환 아님, **`sim/tools/prepare_sim.py` 버그**: 261028 팔은 링크 하나에 겉모양 메쉬가 여러 개 (link2·3·4·5 2 개, gripper_roll_link 8 개, 손가락 3 개) 인데,
줄인 메쉬를 링크 이름 하나 (`link2.stl`) 로 저장해 조각들이 서로 덮어써져 **마지막 조각만 남음** (gripper_roll_link 는 작은 조각 하나만 8 번 그려짐). 이전 팔은 링크마다 겉모양 1 개라 안 드러남.
고침: 조각마다 `<링크>_v<번호>.stl` 로 따로 저장 + **검사 추가** (원본 조각 수 = 만든 파일 (나눈 것 포함), 겹치는 파일이면 멈춤) -> 원본 34 조각 -> 38 파일, MuJoCo 그림·USD 에서 팔 링크별 조각 수 (2·2·2·2·8·3·3) 확인.
**충돌 형상은 원본을 그대로 써서 물리·학습 결과 (정렬·집기 N10) 에는 영향 없음** (겉모양만). URDF 가 바뀌면 4.8 절 1 번 (prepare_sim) 출력의 '겉모양 원본 조각 N 개 -> 파일 M 개' 와 검사 통과를 볼 것.

**재부팅으로 멈춘 자리 (2026-10-29 저녁)**: 집기 SP-N10 + 옮기기·맞추기 ST-N5 까지 학습됨. 넣기 (Insert) 는 아직. 다시 시작할 명령 (컨테이너 안 `sim/isaac`):
1. ST-N5 내보내기·고정: `isaaclab.sh -p $PWD/play.py --task Waffle-Store-Direct --num_envs 1 --checkpoint $PWD/logs/rsl_rl/waffle_store/2026-10-29_15-43-01/model_2195.pt --viz none` (exported 생기면 끄기) -> `policies/store_latest.pt` 로 복사
2. 넣기 시작 상태: `isaaclab.sh -p $PWD/store_hybrid.py --num_envs 96 --depth 0.015 --collect $PWD/insert_starts_raw.json` -> 호스트 `sim/isaac/insert_starts.json` 으로 복사 (새 손가락은 퍽 바닥 위 16 mm 라 18 mm 내리면 통 윗면에 닿음 -> 15 mm)
3. `./run_isaac.sh insert 256 300` -> `insert_eval` -> 4. `chain_eval` (집기 N10 -> 옮기기 N5 -> 넣기)

**지금 상태 (2026-10-29, 사용자 지시로 여기서 멈춤)**: 261028 새 팔에서 **정렬·집기 = N10 (실제 과제 52 %)** 까지 학습. **옮기기·맞추기 (Store)·넣기 (Insert) 는 새 팔로 아직 학습 안 함** (환경·시작 상태 `store_starts.json`·PPO 설정은 새 팔용으로 준비됨, 이전 팔 모델 `policies/old_261027/` 은 못 씀). 이어 붙이기 (`chain_play`) 도 새 팔 Store·Insert 모델이 생긴 뒤에 됨.
다음에 할 순서: (1) `chain_play.py --collect_handover sim/isaac/store_handover.json` (집기 N10 이 끝난 실제 상태) (2) `./run_isaac.sh store 256 300` (3) `store_hybrid.py --collect sim/isaac/insert_starts.json` (4) `./run_isaac.sh insert 256 300` (5) `chain_eval`.
새 팔에서 배운 것: 손가락 충돌 끄기, 손가락이 집게 축 아래 29 mm 라 잡는 높이 +15 mm, 팔 강성 60, **관절 공간 행동은 수평 다가가기를 못 배움 -> 직교 행동 + IK**, **탐색 표준편차 0.5 (1.0 은 정밀 동작을 못 배움)**, 역방향 커리큘럼 (퍽을 손가락 앞에) 을 거리 단계적으로.

| 회차 (261028) | 날짜 · 결과 폴더 | 바꾼 것 | 결과 | 비고 |
|---|---|---|---|---|
| SP-N1 정렬·집기 | 2026-10-29 · `waffle_sidepick/` (261028 첫 회) | 새 팔, 위 값 (READY = 퍽 6 cm 앞·4 cm 위 [0, 0.75, 0.60, −1.35, 0], gap 9 ~ 17 cm), 처음부터 500 반복 | 보상 87 -> 191 (130) -> 228 (238) -> 255 (499), **잡는 점 거리 8.4 ~ 9.5 cm 에서 안 줄어듦, 쥠 0 ~ 0.8 %**, 행동 표준편차 1.0 -> 1.23 (오름) | `sidepick_diag`: 집게는 수평·퍽을 향하지만 **목표보다 45 ~ 55 mm 위에서 멈춤, 손목 joint4 가 −1.82 (Isaac 소프트 한계 = −1.92 x 0.95) 에 붙음**. 퍽 높이로 내려가려면 팔 모양을 다른 갈래 (어깨 앞으로, 팔꿈치 덜 굽힘) 로 바꿔야 하는데 못 찾음. IK: 퍽 높이에서 집게 수평은 joint1 축 0.27 m 이상만 됨 |
| SP-N2 정렬·집기 | 2026-10-29 | **READY = 퍽 높이·joint1 축 0.28 m [0, 1.16, 0.53, −1.69, 0]** (이미 맞는 갈래), **gap 11 ~ 19 cm, sweet_radial 0.33**, 처음부터 500 반복 | 보상 156 -> 236 (466), **잡는 점 거리 8.6 ~ 9.8 cm 그대로, 쥠 0 %**, 표준편차 1.02 -> 1.16 | 리셋 확인 (`sp_reset_check.py`): 리셋 직후 집게는 수평·퍽 4 ~ 6 cm 뒤·퍽 높이 = 맞음. IK 자세로 직접 움직여 보니 **처음부터 팔-상자 접촉** -> 원인: 새 손가락은 집게 축 아래로 29 mm (패드는 ±15 mm) 라 잡는 높이 +6 mm 면 손가락 밑이 상자 위 2 ~ 7 mm (처짐 포함 닿음). 팔-상자 −2 / 스텝이 계속 나와 퍽에서 멀어지게 배움 |
| SP-N3 정렬·집기 | 2026-10-29 | **잡는 높이 +6 -> +15 mm** (손가락 밑 16 mm 띄움, 패드가 퍽 위쪽 절반 쥠, 넣을 때 손가락이 통 위에 닿으면 퍽 16 mm 들어감 (이전 팔은 7 mm)), READY = 그 높이·0.28 m [0, 1.07, 0.60, −1.66, 0], 처음부터 500 반복 | 잡는 점 거리 9 -> 6.4 cm (나아짐), **쥠 0 %** | 진단: 집게를 퍽 위 4 ~ 7 cm 로 들어 수평 유지 (손목 다시 한계). 옆에서 정확한 높이로 다가가야 하는데 위에서 내려오면 손가락이 퍽 윗면을 쳐 넘어뜨림 -> 한 번도 못 쥐어 부분 보상 (수평·향함·거리) 에 머묾. 그리고 **행동 0 에서도 팔이 0.6 s 에 10 ~ 18 mm 처져 손가락이 상자에 닿음** (팔 강성 19 N·m/rad = 이전 팔 추정값, 새 팔을 앞으로 숙이면 중력 토크 약 1 N·m -> 정지 오차 4 ~ 5°) |
| SP-N4 정렬·집기 | 2026-10-29 · `waffle_sidepick/2026-10-29_12-26-55` (`model_499.pt`) | (1) **팔 강성 19 -> 60 N·m/rad, 감쇠 0.85 -> 2.0** (`sim_params.json`, 실물 다이나믹셀 정지 오차 약 1° 에 가깝게, MuJoCo·Isaac 같이) -> 처짐 0 ~ 6 mm·상자 안 닿음 확인. (2) **역방향 커리큘럼 40 %**: 집을 퍽을 시작 자세 잡는 점 바로 앞 (0 ~ 3.5 cm, 가로 ±8 mm) 에 두고 상자를 그 아래로 (시작 잡음 0.03 rad) -> 쥐고 들기 보상을 일찍 경험. 처음부터 500 반복 | 보상 100 -> 307 (136) -> 433 (244) -> 755 (352) -> **946 (499)**, **새 팔로 처음 쥐고 듦**: 쥠 0 -> 3 -> 8 -> 17 -> 20 %, 들어 올린 비율 0 -> 7 -> 14 -> 26 %, 넘어짐 34 -> 20 %, 팔-상자 0 ~ 1 %, 표준편차 0.98 -> 0.79. 500 에서도 오르는 중 | 커리큘럼·강성으로 풀림 -> N5 로 이어서 |
| SP-N5 정렬·집기 | 2026-10-29 · `waffle_sidepick/2026-10-29_12-41-32` (`model_998.pt`) | N4 `model_499` 에서 이어서 500 반복 (설정 같음) | 보상 947 -> 688 (629) -> 961 (839) -> 1507 (947) -> 1079 (998), 쥠 18 ~ 24 %, 들어 올린 비율 23 ~ 33 %, 넘어짐 14 ~ 23 % (학습 중 지표, 커리큘럼 40 % 포함). **실제 과제 평가 (`sidepick_diag --near 0`, 64 대, 6 s): 세워 든 대 2/64 (3 %), 넘어진 퍽 11** | 퍽이 손가락 사이에 있는 경우만 배움. 시작 자세에서 퍽까지 (4 ~ 8 cm + 옆으로) 다가가기는 못 배움, 다가가며 손가락으로 퍽을 침 |
| SP-N6 정렬·집기 | 2026-10-29 · `waffle_sidepick/2026-10-29_12-58-43` | N5 에서 이어서 500 반복. **커리큘럼 거리 단계적으로** (퍽 = 시작 잡는 점 앞 0 ~ 8 cm, 옆 ±3 cm, 50 %), **집게 벌림 49.6 -> 61.6 mm** (퍽 양옆 틈 10 -> 16 mm) | 들어 올린 비율 15 ~ 20 %, 넘어짐 18 ~ 23 % (학습 중 지표). **실제 과제 평가: 세워 든 대 4/64 (6 %), 넘어진 퍽 16** | 진단: 시작하자마자 어깨 (joint2) 를 1.07 -> 0.78 로 젖혀 퍽 5 ~ 6 cm 앞·2 ~ 5 cm 위에서 머묾. **새 팔에서 집게를 수평으로 앞으로 미는 건 관절 2·3·4 를 같이 (손목은 한계 근처) 움직여야 해서 관절 공간 행동으로는 못 찾음** |
| SP-N7 정렬·집기 | 2026-10-29 · `waffle_sidepick/2026-10-29_13-16-02` | **행동을 직교로 바꿈 (넣기 전용과 같은 방식)**: 행동 4 = 잡는 점 x·y·z 변위 x 5 mm / 스텝 + 집게, 집게 자세는 IK 가 수평·joint1 축에서 바깥 방향·카메라 위로 유지 (감쇠 최소제곱, 자세 가중치 0.3). 관측 35 -> 33 (이전 행동 6 -> 4). 손 제어 확인 (`cart_check.py`, 다가가기 -> 닫기 -> 들기): **32 대 중 20 대 세워 듦**, 집게 수평 0.97 ~ 1.00. 처음부터 400 반복, 커리큘럼 (50 %, 0 ~ 8 cm) 그대로 | 잡는 점 거리 9.5 -> 5.1 cm (다가가기는 배움), **쥠 0 % (커리큘럼 판에서도)**, 표준편차 1.05 -> 1.34 (커짐). 실제 과제 0/64 | 탐색 흔들림: 직교 5 mm x 표준편차 1.3 = 스텝마다 약 6 mm 무작위 + 집게 열고 닫기가 뒤섞여 손가락이 닫히기 전에 퍽을 밀거나 넘어뜨림 |
| SP-N8 정렬·집기 | 2026-10-29 · `waffle_sidepick/2026-10-29_13-28-36` (`model_399.pt`) | N7 + **탐색 설정을 넣기 전용과 같게** (시작 표준편차 0.5, entropy 0.003, 학습률 3e-4), 처음부터 400 반복 | 표준편차 0.5 -> 0.35, 잡는 점 거리 8.4 -> 4.8 (200) -> 3.5 cm (300), 쥠 0 -> 12 % (300) -> 11 %, 들어 올린 비율 0 -> **15 % (399)**, 보상 213 -> 315 (300) -> **699 (399)** = 마지막에 빠르게 오름. **실제 과제 평가: 세워 든 대 11/64 (17 %)**, 넘어진 퍽 16 | 새 팔에서 처음으로 실제 과제 (먼 시작) 가 됨 -> N9 로 이어서 |
| SP-N9 정렬·집기 | 2026-10-29 · `waffle_sidepick/2026-10-29_13-41-11` (`model_898.pt`, `policies/sidepick_N9.pt`) | N8 `model_399` 에서 이어서 500 반복 (설정 같음) | 보상 699 -> 1271 (500) -> 1381 (600) -> 1599 (700) -> 1454 (800) -> **1607 (898)**, 들어 올린 비율 15 -> 40 -> 50 -> **55 ~ 61 %**, 쥠 28 ~ 38 %, 넘어짐 13 ~ 23 %, 표준편차 0.35 -> 0.20. **실제 과제 평가: 세워 든 대 24/64 (38 %)**, 넘어진 퍽 24 | 남은 실패 대부분 = 다가가며 퍽을 넘어뜨림 |
| SP-N10 정렬·집기 | 2026-10-29 · `waffle_sidepick/2026-10-29_13-57-50` (`model_1297.pt`, **`policies/sidepick_N10.pt` = 지금 가장 좋음**) | N9 에서 이어서 400 반복. **넘어짐 벌점 −0.5 -> −2 / 스텝**, 커리큘럼 50 -> 30 % | 보상 1576 -> 1657 (1050) -> 1340 (1150) -> 1455 (1250) -> 1230 (1297), 들어 올린 비율 44 ~ 56 %, 쥠 20 ~ 23 %, 넘어짐 13 ~ 20 %, 표준편차 0.20 -> 0.17 (학습 중 지표, 커리큘럼 30 % 포함). **실제 과제 평가 (64 대, 6 s): 세워 든 대 33/64 (52 %)**, 넘어진 퍽 12/64 (N9 24) | 넘어짐 벌점으로 넘어뜨림 절반으로. 학습 중 지표는 평평 -> 여기서 멈춤 (사용자: 더 진행하지 말 것, 2026-10-29) |
| ST-N1 옮기기·맞추기 | 2026-10-29 · `waffle_store/2026-10-29_14-30-18` (`model_399.pt`) | 새 팔 처음. 관절 공간 행동 6 (180° 돌리기), 시작 = MuJoCo IK (A 1068·B 406·C 426, 잡는 높이 +15 mm) + **H = 집기 N10 이 실제로 끝난 상태 93 개** (`chain_play --collect_handover`, 256 대 12 s 중 93 대 성공) 비율 A 0.15·H 0.25·B 0.25·C 0.35, 탐색 표준편차 0.5·학습률 3e-4·entropy 0.003, 양옆 통 P·N, 400 반복 | 보상 575 -> 810 (100) -> 1019 (200) -> 1088 (300) -> 1044 (399), 쥠 100 %, 퍽 최고 높이 입구 위 +5 ~ +34 mm, 통 축 최소 19 ~ 51 mm, **맞춤 0 %**, 팔-몸체 0 ~ 0.4 %, 표준편차 0.44 -> 0.32 | 이전 팔 ST1 과 비슷 (들고 돌려 통 쪽으로, 맞추기 전). 이전 팔은 ST2·ST3 (총 900 반복) 에서 맞춤 86 % -> 이어서 |
| ST-N2 옮기기·맞추기 | 2026-10-29 · `waffle_store/2026-10-29_14-44-41` (`model_898.pt`) | N1 에서 이어서 500 반복 (설정 같음) | 보상 1294 -> 1347 (600) -> 1549 (700) -> 2006 (800) -> **2042 (898)**, **맞춤 0 -> 13 % (800) -> 5 % (898)**, 퍽 바닥 평균 입구 −3 ~ +3 mm, 퍽 직립 0.97 (약 13° 기욺), 팔-몸체 0 ~ 1 % | 맞추기 시작. 새 집게는 퍽 위쪽 절반을 쥐어 퍽이 조금 기욺 (넣기에 영향 가능) -> 이어서 |
| ST-N3 옮기기·맞추기 | 2026-10-29 · `waffle_store/2026-10-29_15-03-34` (`model_1397.pt`) | N2 에서 이어서 500 반복 | 보상 2165 -> 2243 -> 1970 -> 2131 -> 2198 (1397) = 평평, **맞춤 0 ~ 1.6 % (N2 보다 줄어듦)**, 퍽 직립 0.957 ~ 0.966 (약 15 ~ 17° 기욺), 팔-몸체 0 ~ 1 % | 맞춤은 축 5 mm + **직립 0.98** 이어야 하는데 직립이 0.96 에 머묾. 행동 0 으로 쥐고만 있으면 직립 0.9925 (`zero_check.py`) -> 손 안 처짐이 아니라 정책이 옮기며 집게를 기울임. 직립 보상 (1 x 축 z) 이 0.96 과 0.99 를 거의 구분 못 함 |
| ST-N4 옮기기·맞추기 | 2026-10-29 · `waffle_store/2026-10-29_15-24-22` (`model_1796.pt`) | N3 에서 이어서 400 반복. **직립 보상 = 2 x (1 − tanh((1 − 축 z)/0.005))** (2° -> 1.8, 5° -> 0.7, 16° -> 0) | 보상 1954 ~ 2153 (평평), 맞춤 0.4 ~ 2.3 %, 퍽 직립 0.950 ~ 0.959 (안 나아짐) | **진단 (store_diag 기울기 분해)**: 퍽 기울기 17 ~ 22° = **집게 피치 약 11° + 집게 롤 12 ~ 19° (관절 5 = 0.22 ~ 0.34)**, 차체 0°. 퍽이 손 안에서 도는 게 아니라 정책이 집게를 기울임 (이 과제엔 롤 불필요). 그리고 목표 P 통 대들이 모두 P 축 92 mm 같은 자리에 멈춤 (통 구분 못 함) |
| ST-N5 옮기기·맞추기 | 2026-10-29 · `waffle_store/2026-10-29_15-43-01` (`model_2195.pt`) | N4 에서 이어서 400 반복. **손목 롤 (관절 5) 0 고정**, **집게 수평 보상 1.5 x (1 − tanh(\|집게 방향 z\|/0.03))** | 보상 1583 -> 2055 (1950) -> 2198 (2150) -> 2194 (2195), **맞춤 0 ~ 2 % -> 10 ~ 30 %**, **퍽 직립 0.95 -> 0.982 ~ 0.986**, 팔-몸체 0 ~ 3 %, 퍽 바닥 평균 입구 −3 ~ −8 mm | 손목 롤 고정 효과가 바로 남. 넣기 시작 상태 모으기 가능 수준 |
| 넣기 시작 상태 (손 IK) | 2026-10-29 | 옮기기 ST-N5 맞춤 + 손 IK 내리기 (`store_hybrid.py`, 96 대) | **깊이 15 mm: 맞춤 15/96, 통 안 0/15** (손가락이 퍽 바닥 위 16 mm 라 10 ~ 13 mm 에서 통 윗면에 닿아 (약 6 N) 누르며 퍽이 기울어 (직립 0.64 ~ 0.92) 입구에 끼임). **깊이 10 mm: 맞춤 11/96, 통 안 8/11** (6 대 바닥 90 ~ 96 mm, 2 대 내려가는 중 49 mm, 실패 3 대 = 축 6 ~ 8 mm 어긋남). -> 새 집게는 10 mm 넣고 놓기. 시작 상태 4081 개 (`insert_starts.json`) | **맞춤 대는 모두 N 통**: 옮기기 ST-N5 가 P 통 목표일 때 못 맞춤 (통 구분 못 함, 고칠 것) |
| IN-N1 넣기 | 2026-10-29 · `waffle_insert/2026-10-29_18-51-03` (`model_299.pt`) | 새 팔 처음, 위 시작 상태, 넣기 전용 설정 그대로 (직교 1 mm + IK, 실제 로봇 관측만), 300 반복 | 보상 802 -> 1532 (200) -> 1718 (299), 통 안 30 -> 47 %, 넣기 끝 14 -> 26 % (학습 중). **insert_eval (192 대): 통 위 5 %, 모따기 10 %, 통 안 24 %, 전체 11 %**, 팔 링크-몸체 0 N, 실패 대부분 시간 끝 (끼임) | 보상이 이전 집게 기준 (쥔 채 15 ~ 20 mm 넣기) 이라 새 집게 (13 mm 에서 손가락이 통 윗면에 닿음) 에서 밀어 넣다 끼임 |
| IN-N2 넣기 | 2026-10-29 · `waffle_insert/2026-10-29_19-04-41` (`model_598.pt`) | N1 에서 이어서 300 반복. 새 집게 깊이로: **'통 안' 15 -> 8 mm, 깊이 보상 20 -> 10 mm, 잘 놓음 10 -> 6 mm** | 통 안 (8 mm) 91 ~ 96 %, 넣기 끝 18 ~ 25 % (학습 중). **insert_eval: 통 위 3 %, 모따기 0 %, 통 안 19 %, 전체 7 %**, 대부분 시간 끝 | 쥔 채 통 안 +5 / 스텝이 커서 놓지 않고 머묾 (놓아야 하는 이유가 약함) |
| IN-N3 넣기 | 2026-10-29 · `waffle_insert/2026-10-29_19-18-49` (`model_897.pt`) | N2 에서 이어서 300 반복. **쥔 채 통 안 +5 -> +1, 잘 놓음 +3 -> +6, 넣기 끝 +20 -> +40** | 통 안 91 ~ 95 %, **놓음 89 ~ 94 %** (놓기는 배움), 넣기 끝 20 ~ 21 %. **insert_eval: 통 위 1 %, 모따기 0 %, 통 안 19 %, 전체 6 %** | 놓은 퍽이 입구 아래 11 ~ 12 mm 에서 기운 채 끼어 안 떨어짐. 손 IK (축 1.5 mm·직립 0.985 로 맞춘 뒤 똑바로 10 mm) 는 8/11 -> 넣기 강화 학습은 아직 손 IK 만큼 정밀하지 않음 |
| **이어 붙여 실행 (261028)** | 2026-10-29 | `chain_eval` 64 대: 집기 N10 -> 옮기기 ST-N5 -> **넣기 = 손 IK (10 mm 넣고 놓기)** (`chain_play.py --insert_ik`), 목표 통 P·N 번갈아, 25 s | **집기 23/64 (36 %) -> 통 위 맞춤 1/64 -> 통 안 0/64**. 옮기기에서 퍽을 떨어뜨림 (바닥 391 mm 다수), 팔 링크-몸체 최대 287 N (1 N 넘은 스텝 합 4171) | **병목 = 옮기기 (Store)**: (1) 실제 집기가 넘겨주는 상태 (H) 가 시작 상태의 25 % (93 개) 뿐이라 거기서 시작하면 퍽을 놓치거나 몸체에 부딪힘, (2) P 통 목표를 못 맞춤 (통 구분 못 함), (3) 집기도 이어 실행에선 36 % (따로 평가 52 %) |

### 4.14 팀 공유본으로 옮김 · 팀 물리값으로 다시 학습 (2026-10-29 밤)

사용자: 새 공유본 `~/Downloads/urdf_261028 (1)/urdf_261028/` 을 받아 "위 내용 모두 반영해서 다시 학습, md 에도 정책 수정".
공유본 구성 (팀 `AGENTS.md`): ROS 패키지 `waffle_4wd_description_261028/` + Isaac 폴더 `isaac/` (USD 가벼운·정밀 2 개, `robot_params.json`, `waffle_4wd_isaac/robot_cfg.py`, 센서 설정). **학습 과제 코드는 없음** -> 우리 과제를 `isaac/rl/` 에 넣고 팀 설정을 불러 씀.
**URDF 는 이전 261028 과 같음** (관절 · 링크 · 질량 비교: 차이 없음) -> 이전 정책을 이어서 학습 가능. 팀 생성 파일 (`isaac/urdf`, `usd`, `results`) 은 안 고침 (AGENTS.md).

| 바뀐 것 | 이전 (내 sim/) | **팀 공유본 (지금)** | 근거 |
|---|---|---|---|
| 로봇 설정 | 내 변환 USD + `sim_params.json` | **팀 `WAFFLE_4WD_FULL_CFG`** (정밀 충돌, 차체 볼록 메시 423) | 공유본 = 팀 기준 |
| 팔 강성 · 감쇠 | 60 · 2.0 (처짐 줄이려고 올렸음) | **18.88 · 0.851** (펌웨어 P 800 · I 0 환산 = 실물처럼 처짐) | 실물과 같게 학습해야 실물에서 됨. 직교 행동 + IK 는 실제 위치를 보고 고쳐 가므로 처짐을 따라감 |
| 손가락 | 1000 N/m · 20 N | **6500 N/m · 13 N · 41 mm/s** | 펌웨어 쥐는 힘 환산 |
| 자기 충돌 | 손가락끼리만 끔 | **팔 몸체끼리 (손가락 포함) 끔**, 팔 ↔ 차체 · 바퀴 켬 | 팀 convert |
| 솔버 | 위치 8 | **16** | 팀 설정 |
| gripper_roll | 0 고정 (강성 1) | 팀 팔 구동 (강성 18.88) 으로 0 유지 | 팀 설정 |

`isaac/rl/` 구성: `waffle_isaac/` (과제 3 개, `robot_cfg.py` = 팀 설정 어댑터), `run_rl.sh` (명령), `sync_to_docker.sh` (컨테이너 `/workspace/isaaclab/scripts/waffle_shared_261028/isaac/rl`), `policies/*_latest.pt`, `checkpoints/` (이어 학습 출발점), 진단·평가 스크립트, `store_starts.json` (MuJoCo IK, URDF 같아 그대로).
확인: `store_check` (팀 USD) 통 떨어뜨리기 P·N 통 안 303 mm·C 걸림 (이전과 같음), 팔-몸체 접촉 센서 37 ~ 50 N, 정렬·집기 학습 정상.

**정책 수정 (이어 붙이기 0/64 원인 반영, 4.13 끝 · 1-A 표)**:
1. 정렬·집기: N10 에서 이어서 팀 물리값으로 (T1).
2. **이어 받기 상태를 크게 늘림**: 집기 결과 (H) 를 수백 개 모아 옮기기 시작 상태의 절반 이상으로 (이전 93 개 · 25 %).
3. **P 통 문제 진단·수정**: 옮기기 ST-N4·N5 는 목표 P 통을 못 맞춤.
4. **넣기 = 손 IK (10 mm 넣고 놓기) 를 기본**으로 이어 붙이기, 넣기 강화 학습은 그 뒤 정밀하게 다듬음 (IN-N3 6 %).
5. 이어 붙여 평가 (`./run_rl.sh chain_eval`).

| 회차 (팀 공유본) | 날짜 · 결과 폴더 | 바꾼 것 | 결과 | 비고 |
|---|---|---|---|---|
| SP-T1 정렬·집기 | 2026-10-29 · `rl/logs/rsl_rl/waffle_sidepick/2026-10-29_21-28-07` (`model_1696.pt`, **`policies/sidepick_latest.pt`**) | N10 (`checkpoints/sidepick_N10_model_1297.pt`) 에서 이어서 400 반복, 팀 물리값 (팔 강성 18.88 = 처짐, 손가락 6500 N/m · 13 N) | 들어 올린 비율 36 ~ 55 %, 넘어짐 9 ~ 17 % (학습 중, 커리큘럼 30 % 포함). **실제 과제 평가 (64 대): 세워 든 대 39/64 (61 %)**, 넘어진 퍽 8 (N10 은 52 % · 12) | 팀 물리값 (처짐 있음) 에서도 직교 행동 + IK 가 따라감. 손가락이 세져 (13 N) 넘어뜨림도 줄어듦 |
| 이어 받기 상태 | 2026-10-29 | `chain_play.py --collect_handover` 3 번 x 256 대 x 12 s (집기 SP-T1) | **352 개** (120 + 119 + 113) -> `store_handover.json` (이전 93 개) | |
| P 통 진단 | 2026-10-29 | 옮기기 ST-N5 를 팀 물리값에서 `store_diag` (8 대) | **목표 P 통 대들도 관절 1 을 − 로 돌려 −3.14 (한계) 에 막힘**, 잡는 점 (−0.046, 0) = 바로 뒤 (P 축에서 68 ~ 70 mm). P 는 +2.80 으로 돌아야 닿음 | 한쪽으로 도는 습관만 배움 (목표 통에 따라 방향을 못 바꿈) |
| ST-T1 옮기기·맞추기 | 2026-10-29 · `waffle_store/2026-10-29_21-44-52` (`model_2694.pt`, `policies/store_latest.pt`) | ST-N5 (`checkpoints/store_N5_model_2195.pt`) 에서 이어서 500 반복, 팀 물리값. **관절 1 방향 보상 1.5 x (1 − \|q1 − 목표 각\|/π)** (P +2.80 · N −2.80), **시작 비율 A 0.10 · H 0.45 (352 개) · B 0.20 · C 0.25** | 맞춤 0 -> 26 % (2450) -> 25 %, 직립 0.97 ~ 0.98, 팔-몸체 1 ~ 5 %. **P 통: 관절 1 을 + 로 돌림 (2.58 ~ 2.61, 목표 2.80) -> 축 42 ~ 49 mm 앞에서 멈춤** (이전 −π 한계 68 ~ 70 mm). **옮기기 + 손 IK 10 mm (`store_hybrid`, 96 대, MuJoCo 시작): N 통 맞춤 47/47 · 통 안 46/47**, P 0/49 | N 통은 해결. P 는 방향은 맞고 마지막 0.2 rad 를 못 감 |
| 이어 붙이기 T1 | 2026-10-29 | `chain_eval` 64 대 (집기 SP-T1 -> 옮기기 ST-T1 -> 손 IK). 처음엔 **이어 붙이기 스크립트가 옮기기 환경의 행동 처리 (손목 롤 0 고정 · 통 근처 정밀 모드) 를 안 따라** 손목이 돌아 퍽을 떨어뜨림 (팔-몸체 최대 938 N) -> 고침 | 고친 뒤: 집기 30/64 -> 맞춤 1/64 -> 통 안 0. N 목표는 통 축 18 mm·입구 위 17 mm 에서 머묾, P 목표는 44 ~ 50 mm | MuJoCo 시작 (store_hybrid) 에선 N 47/47 인데 실제 집기 끝 상태 (H) 에선 덜 익숙 -> H 비중 올려 이어서 |
| ST-T2 옮기기·맞추기 | 2026-10-29 · `waffle_store/2026-10-29_22-09-47` (`model_3293.pt`, `policies/store_latest.pt`) | T1 에서 이어서 600 반복, **H 45 -> 60 %** (A 0.05 · H 0.60 · B 0.15 · C 0.20) | 맞춤 12 ~ 19 % (T1 보다 낮음), 직립 0.975. 이어 붙이기 (맞춤 2.5 mm 기준): 집기 34/64 -> 맞춤 0 (P·N 모두 통 축 약 40 mm·입구 높이에서 머묾) | 아래 '높이 한계' 가 원인 |
| 이어 붙이기 + 손 IK 마지막 맞춤 | 2026-10-29 | `chain_play.py --insert_ik` 에 **옮기기가 통 축 5 cm·입구 근처까지 오면 손 IK 가 (입구 위 8 mm 에서 축 맞춤 -> 10 mm 넣기 -> 놓기 -> 빼기)** 추가, 끝 판정 = 퍽 통 축 6 mm·입구 아래 60 mm + 집게 벌림 (집게 6 cm 위로 빼기는 높이 한계로 못 채워 뺌) | 집기 28 ~ 35/64 -> 손 IK 넘김 19 ~ 26/64 (P 14 ~ 15, N 5 ~ 11) -> **통 안 0/64**, 떨어뜨림 41. 손 IK 도 통 축 35 ~ 42 mm 에서 못 다가감 | **높이 한계 (아래)** |

**새 팔 높이 한계 (2026-10-29 밤, MuJoCo IK, P 통 축 위, 팔 처짐 없을 때)**: 집게를 수평으로 두면 잡는 점 최대 z 0.445 m.
퍽 바닥 − 입구 = **잡는 높이 dz 15 mm 면 +0.6 mm (틈 거의 0)**, dz 6 mm 면 +9.6 mm. 집게를 2° 숙이면 −4.4 mm (dz 15) / +4.6 mm (dz 6), 4° 면 −11.9 / −2.9 mm.
-> 지금 설정 (dz 15 mm, 팀 팔 강성 18.88 = 몇 mm 처짐) 에서는 **퍽 바닥이 통 입구보다 높은 채로 통 축 위에 갈 수 없음** -> 통 안쪽 (joint1 축 쪽) 에서 입구 높이로 다가가다 퍽 바닥이 통 테두리에 걸려 4 cm 앞에서 멈춤 (옮기기 정책·손 IK 모두).
(store_hybrid 에서 N 통 46/47 이 된 건 MuJoCo IK 시작 상태 (통 위 C 종류 = 이미 통 위에 있는 자세) 에서 시작해서. 실제 집기에서 오면 그 자리에 못 감.)
dz 15 mm 는 **집기** 때문에 정함: 새 손가락은 집게 축 아래로 29 mm 라 dz 6 mm 면 손가락 밑이 상자 위 7 mm (처짐 넣으면 닿음, SP-N1 ~ N3 실패 원인).
=> **집기 (손가락이 상자에 안 닿게 = 높게 쥠) 와 넣기 (퍽을 통 입구보다 높이 = 낮게 쥠) 가 새 팔 높이 한계에서 서로 부딪힘.** 사용자·팀 결정 필요:
(가) 하드웨어: 스토리지 통을 약 1.5 ~ 2 cm 낮추거나 팔 받침 (J1) 을 그만큼 높임 -> dz 15 mm 그대로 넣기 됨 (가장 확실).
(나) 다시 쥐기: 상자에서 dz 15 mm 로 집어 든 뒤 퍽을 잠깐 내려놓고 (상자 위 또는 차체 위 받침) dz 0 ~ 6 mm 로 다시 쥠 (모델 하나 더).
(다) 퍽을 더 짧게 / 통 입구 높이를 낮춤 (대회 규격이면 불가).
(라) 손가락 패드가 아래로 덜 나오게 집게 바꿈 (손가락 밑 29 mm -> 줄이면 dz 를 낮출 수 있음).

### 4.15 B안 상판 팔레트로 전환: 위에서 집기 + 고정 궤적 놓기 (2026-11-02)

사용자 결정: 퍽 보관 = **B안 상판 팔레트 v3** (칸 12, `../../waffle_4wd_description/config/pallet_slots.yaml`), 집는 방식 = **위에서 집기**. 옛 통 (C · P · N) 기준 과제 (SidePick · Store · Insert, 4.4 ~ 4.14 절) 는 쓰지 않음 (코드 · 정책은 기록용으로 둠).

**왜 위에서 집나 (팀 URDF IK, `pallet_traj.py` 의 `Arm`)**: 옆에서 쥔 퍽 (집게 수평) 은 3열 4칸만 수평으로 들어감 (1 · 2열은 J2 한계로 집게 5 ~ 31° 기욺).
위에서 쥐면 12칸 모두 놓는 자세가 됨 (1 · 2열 기울기 0 ~ 1.2°, 3열 1.5°), 손가락 닫는 축 = 칸 접선 = 팔레트 손가락 홈 방향.
대신 **상자 위 퍽을 수직으로 집을 수 있는 거리는 J1 축에서 약 0.23 m 까지** (0.25 m 에서 3.6°, 0.28 m 13°) -> 주행이 상자 앞 0 ~ 5 cm 에 바짝 세워야 함.

**놓기 = 고정 궤적 (학습 없음)**: 팔레트는 몸체에 고정이라 칸마다 관절 경유점을 미리 계산 (`python3 pallet_traj.py` -> `pallet_place_traj.json`).
- 집게를 아래로 둘 수 있는 TCP 높이는 약 0.20 m 까지 (퍽 바닥 0.16) -> 칸에 든 퍽 (윗면 0.174 ~ 0.196) 위로 쥔 퍽을 못 옮김
  -> **칸은 바깥 열부터 (3 -> 2 -> 1열), 같은 열은 J1 각이 큰 칸부터** 채움 (가는 길의 칸이 늘 비어 있음).
- J1 회전은 퍽 바닥 반경 0.10 m · 높이 0.156 m (J1 서보 브라켓 밖, 2열 칸 안쪽, 1열 칸 벽 위), 그다음 지나는 열 칸 벽 + 12 mm 위로 계단식으로 올리며 칸 반경까지, 내려 놓고, 37.6 mm 벌려 뺌.
- 경로는 쥔 퍽 바닥 가운데 (gripper_roll_link x 0.185) 를 맞춤 (3열은 J4 한계 2.0 이라 운반 중 집게 약 12° 기욺 -> 기울어도 퍽 바닥이 칸 축 위).

**Isaac 확인 (`./run_rl.sh pallet_check`, 칸 12 x 원기둥 · 상자, 정밀 USD, 2026-11-02)**:

| 회차 | 바꾼 것 | 결과 |
|---|---|---|
| 1 ~ 2 | 처음 | 0/24: 퍽을 손가락 사이에 둔 뒤 닫는 0.4 s 동안 퍽이 떨어짐 -> 확인 스크립트가 손가락 관절을 30.4 mm 로 바로 써 넣게 고침 |
| 3 ~ 4 | J1 회전 반경 0.05 m | 0/24: J1 ±60° 쯤 퍽이 **J1 서보 브라켓**에 걸림 -> 회전 반경 0.10 m |
| 5 ~ 6 | 반경 0.10, 칸 벽 + 5 -> 12 mm | 4/24: **팔 처짐** (팀 강성 18.88, 펌웨어 P 800 · I 0) 6 ~ 13 mm 로 퍽이 칸 테두리에 걸림 |
| 7 ~ 8 | 호스트 적분 보정 (목표 = 계획 + ∫ki (계획 − 측정), ki 4) | 8/24: 원기둥 1열 4/4 · 2열 ±169° 2 · 3열 ±172° 2. 놓은 퍽 수평 0.1 ~ 1.3 mm, 높이 −1.0 ~ +0.2 mm, 기울기 0 ~ 0.8° |
| 9 | 팔레트 충돌 조각 꼭짓점 60 이하 (B안 생성기) | 10/24 (상자 2 늘어남) — 부풀림은 주원인이 아니었음 |
| 12 | **손목 롤 180° (joint5 = ±π) 로 ±147° · ±155.6° 4칸** (`--roll_pi 2:0,2:3,3:0,3:3`, Isaac 에서 joint5 한계 ±3.3 rad 로 늘려 시험) | **24/24 (원기둥 12 · 상자 12)**, 수평 0.8 mm 안, 높이 0.0 mm, 기울기 0°, 팔-몸체 0 N. 결과 `pallet_place_check_roll_pi.json` |
| 10 ~ 11 | **칸 충돌 조각을 칸 모양대로 나눔** (CoACD 대신, 칸마다 9 조각) + **퍽 마찰 0.5** (`--puck_mu`, 기본) | **14/24: 1열 8/8 (원기둥 · 상자), 2열 ±169° 4/4, 3열 ±172° 2/4**, ±147° · ±155.6° 0/8 (아래 2). 떨어뜨리기 23/24 (마찰 0.3 이면 24/24) |
| 13 | **기둥 옆 4칸을 집게 45° 기울여 놓기** (퍽은 세운 채, 집게 윗부분 J1 쪽, joint5 0 그대로, `pallet_traj.py` TILT_SLOTS) + 확인 스크립트 쥐기 고침 (아래) + 그 4칸만 0.4 rad/s (`--tilt_speed`) | **24/24 (기본값 그대로 `./run_rl.sh pallet_check`)**, 수평 0.9 mm 안, 높이 0.0 mm, 기울기 0°, **팔-몸체 0 N**. 결과 `pallet_place_check.json`. 같은 쥐기 · 수직이면 17/24 (실패 7 = 모두 4칸, 기둥 190 N). 모두 0.8 rad/s 면 22/24 (3열 상자 2 대가 칸 벽에 걸림) |

남은 실패 원인 (확인한 것):
1. ~~상자 퍽 12/12 실패 = 시뮬 팔레트 충돌 형상~~ **(고침, 회차 9 ~ 11)**: CoACD 조각이 칸 안 둥근 모서리 (r 2) 를 메워 상자 퍽 모서리가 칸 바닥 위 13 ~ 20 mm 에 걸렸음
   (조각 꼭짓점 > 64 부풀림도 있었으나 주원인 아님). B안 생성기 `geom.py` `cup_pieces()` 로 칸을 받침 · 벽 넷 · 손가락 홈 벽 셋으로 나눠 볼록 껍질 -> 상자 · 원기둥 퍽 자리 침범 0 (USD 안 형상으로 확인).
   그다음 끼임은 마찰: 팀 접촉 재질 1.0 이면 틈 1 mm 칸에서 퍽이 끼임 -> 확인 스크립트는 퍽 마찰 0.5 (PLA 어림, **실측 필요**).
2. **±147° · ±155.6° 칸 (2 · 3열 0 · 3번)**: 위에서 놓는 자세 (팔 평면 = 칸 방향, 집게 수직) 에서 집게 몸 (gripper_roll_link) 이 칸 반경 바깥쪽을 향해 **뒤 프로파일 기둥** (`static_433` · `434`, base_link (−0.128, ±0.1295)) 에 닿음:
   URDF 충돌 형상으로 3열 −5.7 mm (파고듦), 2열 +0.2 mm (처지면 닿음). 계산한 대안 (회차 12 이전):
   - 팔을 반대로 접기 (J1 = 칸 방향 − 180°): 집게 46 ~ 79° 기욺 + 차체와 3 ~ 14 mm 겹침 -> 안 됨.
   - 손목 롤 ±160° (팀 한계 안): 닫는 축이 접선에서 20° 틀어져 손가락이 칸에 1.4 ~ 1.8 mm 파고듦 · 상자 면 안 맞음 -> 안 됨.
   - **손목 롤 180°**: 롤 축 = 집게 방향이라 퍽 자리 그대로 (0.0 mm), 닫는 축 = 접선 그대로, 집게 몸만 안쪽 (J1 쪽) 으로 -> 경로 최소 틈 +0.4 ~ +1.1 mm (손가락-칸, 다른 칸과 같은 수준). Isaac 24/24 (회차 12).
   -> joint5 한계를 ±180° 넘게 늘려야 함: 위치 모드 한 바퀴 (0 ~ 4095) 경계 · 케이블 감김 때문에 대칭 ±3.3 은 안 됨 (2026-11-02 검토).
   - **집게 45° 기울여 놓기 (채택, 회차 13)**: 퍽은 세운 채 집게 윗부분을 J1 쪽으로 (손끝이 반경 바깥) -> 기둥 틈 +13 ~ +53 mm, 손가락-칸 +1.9 mm, joint5 · 펌웨어 그대로.
     대신 **이 4칸 퍽은 상자에서 집을 때부터 45° 로 쥐어야** 함 (쥔 퍽은 집게에 붙어 있어 쥔 뒤 손목만 기울이면 퍽도 기욺) -> TopPick 기울임 모드 (아래).
   - 확인 스크립트 쥐기 고침 (회차 13, 수직 칸에도 해당): (a) 팀 `FINGER_CLOSE` −0.011 이면 한쪽 손가락만 힘 한계 13 N 에 걸려 (왼 −0.0092 · 오른 −0.0032) 퍽이 닫는 축으로 3 ~ 4 mm 치우침
     -> `--grip_close −0.0075` (퍽에서 2 mm 더, 약 12 N) 면 두 손가락 −0.0062 로 같고 치우침 0.1 mm. (b) 퍽을 처짐 보정 전에 쥐면 보정이 집게를 2 ~ 3° 돌려 기울인 칸 퍽 바닥이 3 mm 밀림
     -> `--settle_ki` (기본): 보정을 1.5 s 먼저 돌린 뒤 쥠 (실물도 집을 때 이미 보정 중).
3. **손가락 폭 vs 손가락 홈**: 놓을 때 손가락이 칸에 10 ~ 29 N 으로 닿음. 팀 손가락 끝 폭 (충돌 상자) 약 26 mm, 팔레트 홈 24 mm (설계는 손가락 20 mm 가정).
4. **처짐 보정**: 고정 궤적은 호스트 쪽 적분 보정이 있어야 맞음 (실물 ROS 노드에서 측정 관절값으로 목표를 고쳐 줘야 함).

**집기 = 새 과제 `Waffle-TopPick-Direct`** (`waffle_isaac/toppick_env*.py`, 학습 TP2 아래): SidePick 구조 그대로, 행동 4 (잡는 점 변위 + 집게), 관측 35 (+ 기울임 모드 = 36).
IK 집게 자세 목표 = 아래 방향 + 닫는 축 = J1 접선 (상자 퍽은 인식한 면 방향, 닫는 축은 앞뒤 대칭이라 가까운 부호), 자세 오차는 축 외적 (쿼터니언은 180° 근처에서 NaN).
상자는 로봇 앞 0.5 ~ 4 cm, 집을 퍽 = 로봇 쪽. 시작 자세 = TCP 가 J1 앞 0.20 m · 잡는 높이 5 cm 위.
손 제어 시험 (8 대, 학습 없음): 집게 아래 1.00 · 롤 맞음 1.00 유지, 7/8 이 퍽을 50 ~ 77 mm 들어 올림 (손 제어라 1 s 유지 판정은 못 채움) -> 환경 · IK 동작 확인.

**TopPick 기울임 모드 (2026-11-02)**: 팔레트 기둥 옆 4칸에 넣을 퍽 (채우는 순서 3 · 4 · 7 · 8 번째) 은 집게를 45° 기울여 집음. 에피소드마다 `tilt_prob` 0.5 로 모드를 정하고 관측 끝에 모드 (0 / 1) 를 붙임 (관측 36).
- IK 집게 방향 목표 = 아래에서 닫는 축 둘레로 45° (손끝이 J1 에서 먼 쪽), 시작 자세 `READY_TILT` (잡는 점은 수직 판과 같은 자리). 퍽 쥐는 점 = 퍽 축 위 중심 + 15 mm (놓기 궤적과 같음).
- 5 축 팔이라 기울인 집게 방향은 팔 평면 안에만 둘 수 있음 -> 기울임 모드 닫는 축 = 늘 J1 접선. 상자 퍽 면 방향 (±6°) 을 따르게 했더니 IK 가 자세를 맞추느라 위치를 4 ~ 12 mm 옆으로 양보하며 퍽 위에서 멈춤 -> 접선으로 고정.
  상자 퍽은 면이 접선과 맞아야 하므로 기울임 모드에서는 상자 x 축 (두 퍽 잇는 선) 을 집을 퍽의 J1 반경 방향 ±3° 로 둠 (주행이 차체를 돌려 맞춘다고 가정, 옆 퍽은 집을 퍽 바로 뒤).
- 손가락 닫기 목표 `gripper_closed` −0.0075 (위 쥐기 고침 (a) 와 같음). 성공 판정에 집게 방향 (목표와 cos > 0.95) 추가.
- 손 제어 시험 (16 대, 학습 없음, 퍽 위 4 cm -> 잡는 높이 -> 닫기 -> 6 cm 들기): **기울임 14/16, 수직 10/16 이 1 s 들기 성공**, 집게 방향 0.98 ~ 1.00, 쥔 퍽 닫는 축 어긋남 0.0 ~ 0.2 mm.
  기울여 집는 IK 는 J1 축에서 0.12 ~ 0.30 m (옆 ±6 cm) 모두 풀리고 팔-차체 틈 +14 mm 이상 (URDF 충돌 형상).

**TopPick 학습 (2026-11-02, 512 대, 관측 36, 수직 · 기울임 반반)**:

| 회차 | 날짜 · 로그 | 바꾼 것 | 결과 | 비고 |
|---|---|---|---|---|
| TP1 | `waffle_toppick/2026-11-02_16-23-17` (`model_899.pt`) | 처음부터 900 반복 (SidePick N8 탐색 설정, 커리큘럼 30 %) | 쥠 0 % (400) -> 26 % (500) -> 56 % (600), 들어 올림 0 -> 56 % (700) -> 63 % (899), 표준편차 0.50 -> 0.40. **실제 과제 평가 (먼 시작 256 대): 190/256 (74 %)**, 기울임 82 % · 수직 67 %, 넘어짐 47 | 500 반복 쯤부터 쥐기를 찾음 |
| TP2 | `waffle_toppick/2026-11-02_16-57-00` (`model_1398.pt`, **`policies/toppick_latest.pt`**) | TP1 `model_899` 에서 이어서 500 반복 (설정 같음) | 보상 2536 (999) -> 2725 (1398), 들어 올림 67 -> 73 %, 넘어짐 7 -> 5 %, 표준편차 0.37 -> 0.53. **실제 과제 평가 (256 대): 219/256 (86 %)**: **기울임 114/124 (92 %)** (상자 87 % · 원기둥 98 %), 수직 105/132 (80 %) (상자 74 % · 원기둥 84 %), 넘어짐 29 (기울임 7 · 수직 22). 중간 `model_1100` 은 77 % | 기울임 모드가 오히려 잘 됨 (닫는 축 고정 · 상자 퍽 면을 미리 맞춤) |

평가: `./run_rl.sh toppick_eval [환경 수]` (`toppick_eval.py`, 기본 `policies/toppick_latest.pt`, 먼 시작만, 대마다 첫 에피소드).
남은 것: 수직 · 상자 퍽 (74 %) 과 넘어짐 (대부분 수직 모드), 집기 -> 앞 운반 자세 (`q_front` / `q_front_tilt`) -> 놓기 궤적을 이어서 한 번에 확인 (지금은 놓기 확인이 퍽을 손에 넣고 시작),
상자 퍽 기울임 모드는 주행이 상자 퍽 면을 J1 반경 ±3° 로 맞춘다고 가정 (실물 주행 정렬 정밀도 확인 필요).

```bash
python3 pallet_traj.py                 # 놓기 궤적 (URDF · pallet_slots.yaml 이 바뀌면)
./run_rl.sh pallet_check               # Isaac 놓기 확인 -> pallet_place_check.json (약 2 분)
./run_rl.sh pallet_drop                # 팔 없이 칸 충돌 형상 확인
./run_rl.sh toppick 512 900            # 위에서 집기 학습 (수직 + 기울임 모드)
```

**TP3 (2026-11-05, 학습 `waffle_toppick/2026-11-04_20-46-45`, 256 대 15000 반복, #71 · #78 · #82 설정 + 물리 무작위화)**:
- 학습 중 성공률은 9000 ~ 12000 반복에 약 52 % 에서 멈추고, 그 뒤 **행동 표준편차가 0.65 -> 3.4 로 폭주** (entropy 가 이김) -> 마지막 체크포인트가 최선 아님.
- 체크포인트 고르기 (`toppick_eval` 256 대, 시드 1): 6000 32 % · 9000 51 · 10000 49 · 10250 51 · **10500 56** · 10750 50 · 11250 40 · 12000 44 · 13500 41 · 14999 47 %, 옛 TP2 14 %.
  -> `model_10500` = **TP3** 등록 (`./run_rl.sh register ... toppick_TP3 --latest --ros toppick_tilt`, 옛 latest (TP2) 는 `policies/toppick_prev_20261105.pt`).
- 보고 (시드 2): **133/256 (52 %)**, A 65 · B 54 · C 65 · 무작위 44 %, 상자 53 · 원기둥 51 %, 좌표 고정 48 % · 따라감 64 %, 넘어짐 54, 옆 퍽 30.
- 다음 학습: entropy 계수를 낮추거나 표준편차 상한, 좌표 고정 (48 %) 이 약함.

**집기 -> 칸 이어 평가 (`chain_pallet_eval.py`, 2026-11-05, TP3, 192 대 = 칸마다 16, 시드 2, 퍽 마찰 0.5)**: 정책 6 s 집기 -> 관절 직선 0.5 rad/s 로 q_front -> 처짐 보정 1.5 s -> 칸 궤적 (pallet_place_check 와 같은 `pallet_timeline`).
- **이어서 30/192 (16 %)** = 집기 81/192 (42 %, 환경 성공 108 중 27 은 6 s 끝에 이미 놓침) x 넣기 30/81 (37 %). 실패 단계: 넘겨받기 1 · **운반 중 미끄럼 39** · 안 앉음 11.
- 칸별 이어서 성공 (열:칸): 3:1 4 · 3:2 5 · 3:0 1 · 3:3 6 · 2:1 0 · 2:2 0 · 2:0 2 · 2:3 7 · 1:1 0 · 1:2 3 · 1:0 0 · 1:3 2 (각 /16).
- **손 안 어긋남 (넘겨받을 때, 중앙값 / p95)**: 닫는 축 0.1 / 1.1 mm (손가락이 가운데로 맞춤), **집게 축 4.4 / 11.9 mm, 옆 5.9 / 13.1 mm**, 퍽 기울기 1.9 / 10.4°, 상자 면 0.5 / 8.0°.
  놓기 확인 (퍽을 가운데 손에 넣어 줌) 은 0.1 mm 라 24/24 였음 -> **정책이 퍽을 손가락 끝 · 옆으로 치우쳐 얕게 쥠** 이 원인. 어긋남 3 mm 넘는 78 대 중 넣기 36 %.
- 다음: TopPick 성공 · 보상에 손 안 가운데 (집게 축 · 옆 2 ~ 3 mm 안, 퍽 기울기) 를 넣고 다시 학습, 또는 넘겨받기 전 다시 쥐기 (벌려 내려놓고 고정 궤적으로 가운데 쥐기).

**TP4 (2026-11-05 오후, `waffle_toppick/2026-11-05_11-44-16`, TP3 `model_10500` 에서 2000 반복)**: 손 안 가운데 보상 (`rew_center` 4 · `rew_hand_tilt` −4), 성공에 손 안 4 mm · 퍽 5° 추가, 행동 표준편차 상한 0.8 (`ClampedGaussianCfg`).
- 학습 중 손 안 어긋남 (`Metrics/hand_center_mm`) 12 mm 에서 안 줄어듦, 엄격 성공 3 %. 표준편차는 상한 0.8 에 붙음.
- 이어 평가 첫 판은 "환경 성공" 대만 넘겨 TP4 가 1 % 로 보였음 (기준이 달라 불공정) -> `chain_pallet_eval.py --gate physical` (끝에 쥐고 · 들고 · 세움 · 옆 퍽 그대로) 로 같은 잣대:
  **TP3 28/192 (14.6 %) · TP4 `model_12499` 29/192 (15.1 %) · `model_12000` 14/192**, 손 안 어긋남 모두 5 ~ 6 mm -> **효과 없음, latest 는 TP3 그대로**.
- 인식 치우침 0 으로 TP3 이어 평가해도 어긋남 같음 (집게 축 4.8 · 옆 5.3 mm) -> 인식 오차가 원인 아님.
- 그 뒤 TopPick 기본값은 이전 성공 기준 · 보상 0 으로 되돌림 (`strict_success = False`), 표준편차 상한은 남김.

**손 안 어긋남 허용치 측정 (2026-11-05, `pallet_place_check.py --hand_offset`, 결과 `pallet_hand_offset_check.json`)**: 놓기 확인에서 쥔 퍽을 집게 축 (x) · 옆 (z) 으로 일부러 옮겨 쥐어 줌 (칸 12 x 원기둥 · 상자).
앞 운반 자세 (45°) 에서 집게 x = 반경 바깥 · 아래, z = 반경 바깥 · 위 -> **반경 = (x + z) / √2, 높이 = (z − x) / √2**.

| 반경 어긋남 (mm, + = J1 에서 먼 쪽) | −5 | −4 | −3 | −2 | −1 | 0 | +1 | +2 | +4.2 (x 6) | +4.2 (z 6) |
|---|---|---|---|---|---|---|---|---|---|---|
| 앉음 /24 (잡는 높이 0.015) | 21 | 24 | 24 | 24 | 24 | 24 | 20 | 12 | 6 | 0 |

- 높이 ±4 mm (반경 −2 에서) 는 24/24, x −6 · z −6 (반경 −4.2) 도 24/24 -> **놓기는 반경 −4 ~ 0 mm 만 받음, 바깥으로 1 mm 넘으면 무너짐**.
  실패 모습 = 운반 중 퍽이 손 안에서 10 ~ 15 mm 미끄러지며 50 ~ 60° 기욺 (놓을 때 손가락-칸 10 ~ 25 N). 반경 바깥이면 손가락 패드 (45° 띠, 집게 x 0.121 ~ 0.158 · 폭 ±7 mm) 와 퍽 옆면이 닿는 자리가 손끝 쪽으로 가 지지가 약함.
- **퍽 윗부분 잡기** (잡는 높이 `pallet_traj.py --grasp_dz` 0.018 · 0.020 · 0.022 · 0.024): 패드 띠는 잡는 점 ±10 mm 에서 퍽과 닿아 0.020 이면 윗면 가장자리까지 쥠.
  결과는 어긋남별로 0.015 와 거의 같고 (높이 방향은 원래 여유가 큼), 어긋남 0 에서 상자 퍽 4 대가 오히려 실패 (20/24) -> **도움 안 됨, 0.015 유지**.
- **놓는 높이** (`--place_gap` 4 · 6 · 8 mm, 지금 1): 바깥 어긋남 실패는 그대로, 안쪽 −6 은 오히려 나빠짐 (8 mm 에서 14/24) -> 1 mm 유지.
- 이어 평가 (TP3, 물리 판정) 실제 반경 어긋남 = 평균 −1.4 · 표준편차 6.0 mm. 반경 +2 mm 넘는 대는 넣기 4/24, 0 ~ 2 mm 6/8, −4 ~ 0 10/20.
  쥐는 목표를 반경 안쪽으로 2 ~ 3 mm 옮겨도 −4 ~ 0 안 비율은 20 -> 15 ~ 18/82 (퍼짐이 문제, 치우침이 아님).
- **결론**: 칸 넣기는 손 안 반경 ±2 mm 를 요구하고 정책 집기는 ±6 mm (1σ). 보상 · 잡는 높이 · 놓는 높이로는 못 메움 -> 팀 결정 필요:
  (1) 손가락 패드에 세로 V 홈 (닫으면 원기둥 · 상자 퍽이 반경 방향 가운데로 모임, 기구 변경), (2) 넘겨받은 뒤 반경 어긋남을 재는 수단 (팔 카메라 · D435) 과 궤적 보정,
  (3) 칸 입구 깔때기 · 틈 확대 (지금 틈 1 mm). (1) 이 가장 직접적 — Isaac 손가락 충돌 형상만 바꿔 같은 측정으로 먼저 확인 가능.

```bash
python3 pallet_traj.py --grasp_dz 0.020 --place_gap 0.004 --out /tmp/t.json       # 잡는 높이 · 놓는 높이 바꾼 궤적 (기본은 지금 궤적 그대로)
$ISAACLAB_PY pallet_place_check.py --traj /tmp/t.json --hand_offset=0:0,1.41:1.41,-2.83:-2.83   # 음수는 = 로 붙여 씀
```

**B · C 검토 (2026-11-06, 위 결론의 (2) · (3), 임시 사본으로 시험)**: 반경 r = 손 안 반경 어긋남 (mm, + = J1 에서 먼 쪽), 앉음 /24.

| r | 0 | +1 | +2 | +3 | +4 | +5 | +6 |
|---|---|---|---|---|---|---|---|
| 지금 (틈 1 mm, 보정 없음) | 24 | 20 | 12 | - | 6 ~ 0 | - | - |
| (2) 놓는 경로를 반경 안쪽 3 mm (r +3 이 보정 딱 맞음) | 16 | 16 | 12 | 12 | 12 | 8 | 7 |
| (3) 틈 +1 mm (퍽 28 mm, 손가락 값도 맞춤) | 24 | 24 | 20 | 14 | 10 | 7 | 1 |

- (2) 재서 **궤적만** 보정은 나빠짐: 칸 축에 맞춰도 손 안에서 바깥이면 내릴 때 칸 테두리에 걸려 기욺 (칸 대비가 아니라 손 안 위치가 결과를 정함).
  잰 값은 **다시 쥐기** (상자에 내려놓고 어긋남만큼 옮겨 쥠, 약 10 s) 와 함께여야 쓸모. 손 안 반경을 −2 ± 1.5 mm 로 모으면 넣기 거의 다 -> 이어서 상한 = 집기 성공률 (추정, 다시 쥐기는 미시험).
  재는 수단: 팔 카메라는 집게에 붙어 좌표 오차가 적지만 쥔 퍽이 카메라 축에서 약 40° 벗어난 화면 가장자리 -> 실물 화각 확인 필요.
- (3) 틈 1 mm 당 바깥 허용 약 1 mm. TP3 반경 분포 (평균 −1.4 · 표준편차 6 mm) 로 환산한 이어서: 지금 약 10 % -> +1 mm 12 % · +2 mm 15 % · +4 mm 19 % (+2 이상은 추세) -> **단독으로 부족**.
  (퍽 26 mm 시험 0/24 는 손가락 값을 안 맞춰 놓친 무효 시험.)
- **권장: (2) 다시 쥐기 또는 (1) V 홈**. 어느 쪽이든 상한이 집기 성공률이라 집기 학습도 계속 의미 있음.

**TP5 (2026-11-06, `waffle_toppick/2026-11-05_13-34-43`, TP3 `model_10500` 에서 50000 반복, 256 대 19.4 h)**: 설정 = 이전 성공 기준 · 가운데 보상 0 · 표준편차 상한 0.8.
- 학습 성공률 (마지막 10 %) 65 % (TP3 학습 51 %), A 72 · B 63 · C 72 · 무작위 61 %. 표준편차는 0.8 상한에 붙은 채 폭주 없음. 500 반복 창 최고 56500 (67.5 %) · 36500 (67.4 %).
- 후보 이어 평가 (시드 1, 물리 판정, 192 대): **37000 35 (18.2 %)** · 56500 33 · 57000 31 · 52500 29 · 60499 29 · 55500 26, TP3 17 (8.9 %) -> 37000 선택. 37000 뒤로는 학습 성공률만 오름 -> 다음 학습은 20000 ~ 30000 반복이면 충분.
- 보고 (시드 2): 집기 평가 144/256 (56.2 %, TP3 53.5 %), 이어서 29 ~ 30/192 (TP3 28, GPU 물리라 같은 시드도 ±1). 두 시드 합 65/384 (16.9 %) vs TP3 45/384 (11.7 %).
  이득은 물리 집기 49 % (TP3 36 ~ 43 %) 가 전부. 집은 뒤 넣기 31 ~ 37 % 그대로 (운반 중 미끄럼 46 대) -> 손 안 반경 문제 그대로.
  학습 성공 (환경 판정) 127 대 중 물리 판정 통과 95 -> 학습 성공률이 실제 집기를 부풀림.
- **TP5 등록** (`policies/toppick_TP5.*` = `toppick_latest.pt`, ROS `toppick_tilt.onnx`). 같이 고침:
  `run_rl.sh` 평가는 결과 json 이 이번 실행에서 써졌을 때만 md 기록 (Isaac 은 예외로 죽어도 종료 코드 0),
  `register_policy.py` ONNX 비교를 상대 차로 (범위 밖 무작위 입력에서 출력이 수천이라 float32 반올림만으로 절대 차 1e-4 를 넘음).

**TP6 (2026-11-06, `waffle_toppick/2026-11-06_10-47-23`, TP5 `model_37000` 에서 2000 반복, 약 45 분)**: `hold_dist = 0.015` -> 들기 · 높이 보상과 성공을 손 안 15 mm 안에서만 (TP5 까지 `near_dist` 30 mm).
- 왜: TP5 의 "환경 성공인데 물리 판정 실패" 39 대를 진단하니 놓친 게 아니라 **손 안 15 ~ 26 mm 로 비뚤게 쥔 채** 들고 있었음 (33 대는 끝에 1 s 넘게 쥠).
  학습 쪽 거리 (퍽 중심 + 잡는 높이 − TCP) 와 이어 평가 손 안 어긋남은 같은 양이라 15 mm = 물리 판정과 같음. (성공 값은 보상에 안 쓰여 성공 판정만 바꾸면 학습이 안 바뀜)
- 학습 중: 성공률 (15 mm 기준) 49 -> 53 ~ 59 %, `hand_center_mm` 12.1 -> 10.6, 들어 올림 41 -> 49 %. 끝까지 오르는 중.
- 이어 평가 (물리 판정): 시드 1 38250 35 · **38500 43** · 38750 35 · 38999 43, 시드 2 38500 47 · 38999 43 /192. 등록 뒤 다시 잰 38500 시드 2 = 41 (GPU 물리라 같은 시드도 ±6).
  물리 집기 56 ~ 57 %, 집은 뒤 넣기 39 ~ 44 %, **환경 성공인데 물리 실패 32 -> 3 대** (학습 성공률을 믿을 수 있게 됨). 운반 중 미끄럼은 44 ~ 48 대로 여전히 가장 큼.
- 집기 평가 시드 2 144/256 (56.2 %) 는 TP5 와 같은 수지만 성공 기준이 15 mm 로 엄격해진 값.
- **TP6 등록** (`policies/toppick_TP6.*` = `toppick_latest.pt`, ROS `toppick_tilt.onnx`). 다음: 이 설정으로 장시간 학습.

**11-07 이어 학습 2 회차 · TP7 되돌림 (2026-11-07 ~ 08)**:
- `2026-11-07_14-31-18`: TP6 `model_38500` 에서 5000 반복 (1.9 h, 표준편차 상한 0.8). 학습 성공률 (마지막 10 %) 56 %. 41750 이어평가 시드 2 = 51 (11-07) · 21 · 42 · 52 (11-08).
- `2026-11-07_18-26-18`: 41750 에서 2000 반복, 표준편차 상한 0.4 (명령줄 덮어쓰기). 학습 성공률 59 % 지만 43300 이어평가 시드 2 = 35 · 19/192, 집은 뒤 넣기 31 · 19 % -> 행동 잡음을 줄여도 손 안 반경은 안 모임.
- 43300 을 `toppick_TP7` 로 등록 (latest · ROS) 했다가 11-08 TP6 로 되돌림 (등록부에 실패 · latest 아님으로 남김).
- **평가 재현성**: 같은 날 연달아 재면 같은 값 (11-09 6 정책 x 3 번 거의 모두 같음). 날이 바뀌거나 재부팅하면 값이 옮겨 감 (TP6 시드 1: 11-06 43 -> 11-09 31, 41750 은 11-08 재부팅 직후 21).
  -> **후보는 기준 정책과 같은 날 나란히 재서 비교** (날이 다른 기록 숫자와 비교하지 말 것). 이어평가 1 회 약 1 분.
- **손 안 반경이 넣기를 정함** (43300 집은 112 대, r = (집게 축 + 옆)/√2 at 넘겨받기, + = J1 에서 먼 쪽):

| r (mm) | ≤ −10 | −8 | −6 ~ −1 | 0 | +2 | ≥ +4 |
|---|---|---|---|---|---|---|
| 넣기 | 0/17 (모두 운반 중 미끄럼) | 3/16 | 26/36 | 5/9 | 1/7 | 0/30 |

  TP4 가운데 보상이 안 들은 까닭: 3 차원 거리에 tanh 폭 4 mm, 평균 어긋남 12 mm 라 tanh ≈ 1 (기울기 0).

**TP8 (2026-11-08, `waffle_toppick/2026-11-08_17-33-38`, TP6 `model_38500` 에서 3000 반복, 2.2 h)**: 손 안 반경 보상 `rew_radial = 5`
  = 쥔 동안 (1 − tanh(max(|r − (−3 mm)| − 2 mm, 0) / 6 mm)), r 은 위 표와 같은 식. 지표 `Metrics/hand_radial_mm` · `hand_radial_ok` (−7 ~ +1 mm 비율).
- 학습 중: `hand_radial_ok` 36 -> 38 ~ 39 % 로 거의 안 오름, 성공률 54 -> 약 60 %, 들어 올림 49 -> 52 %.
- 후보 이어평가 (11-09 같은 날, 각 3 번, 192 대): 시드 1 TP6 31 · 39250 34 ~ 39 · **40300 44** · 40450 38 · 40600 39 · 41499 36. 시드 2 TP6 47 · **40300 57**.
- 40300 시드 2: 집기 120/192 (TP6 108), 집은 뒤 넣기 47.5 % (43.5 %), 반경 −7 ~ +1 mm 52 % (46 %), 운반 중 미끄럼 47 (40) 대. 집기 평가 150/256 (58.6 %, TP6 147).
- **TP8 등록** (`policies/toppick_TP8.*` = `toppick_latest.pt`, ROS `toppick_tilt.onnx`).
  반경 보상 효과는 작음 (구간 비율 +6 %p), 이득 대부분은 집기 증가. 운반 중 미끄럼이 여전히 가장 큰 실패 -> 다시 쥐기 또는 V 홈.

**다시 쥐기 (2026-11-09, `chain_pallet_eval.py --regrasp`)**: 정책이 집어 든 뒤 넘겨받기 전에 고정 동작으로 다시 쥠. 학습 없음, 팔 이동은 환경 IK (`_ik_step`, 45° 자세 · 닫는 축 유지) 그대로.
- 순서 (약 4.7 s): 처음 퍽 자리 위로 수평 이동 0.6 s -> 내려놓기 1 s -> 벌림 0.5 s -> 잰 퍽 자리 + 잡는 높이 − 목표 반경 (−2 mm) 로 옮기기 1 s -> 쥠 0.6 s -> 3 cm 들기 1 s.
  벌린 손가락은 패드 면과 나란히 움직여 퍽에 안 닿음. 측정은 상자 위 퍽 자리 (시뮬레이션 = 참값 + `--regrasp_noise` σ).
- 시험 (TP8, 시드 2, 192 대, 같은 날):

| 설정 | 이어서 | 다시 쥔 뒤 쥠 | 집은 뒤 넣기 | 운반 중 미끄럼 | 다시 쥐다 놓침 |
|---|---|---|---|---|---|
| 다시 쥐기 없음 | 57 | 120 | 47.5 % | 47 | - |
| 이득 1 (남은 오차 전부), 그 자리 내림 | 53 | 88 | 60 % | 5 | 32 |
| 이득 1, 시간 x2 | 74 | 102 | 72.5 % | 3 | 18 |
| 이득 0.3, 그 자리 내림 | 108 | 109 | 99 % | 1 | 11 |
| **이득 0.3, 처음 자리로 옮겨 내림 (기본)** | **113** | 117 | **97 %** | 1 | 3 |

  - 이득 1 은 팔이 따라오기 전에 관절 목표가 쌓여 잡는 점이 ±4 mm 흔들림 -> 스텝마다 남은 오차의 30 % (`--regrasp_gain 0.3`) 로 ±0.4 mm (p5 ~ p95). 시간 x2 는 이득 없음.
  - 그 자리 내림 실패: 정책이 든 채 퍽을 옆으로 옮겨 둠 (처음 자리에서 중앙 62 · 최대 107 mm) -> 상자 모서리에 걸쳐 기울거나 떨어짐. 처음 자리로 옮기면 11 -> 3 대.
- **측정 오차 (상자 위 퍽 자리, σ)**: 0 mm 113 · 1 mm 107 · 2 mm 94 · 3 mm 84 /192 (집은 뒤 넣기 97 · 92 · 82 · 70 %).
  -> 실물 카메라는 **σ 2 mm 안** 이면 큰 이득 (3 mm 여도 다시 쥐기 없음 57 보다 나음). 3 mm 회차만 집기 127 대 (다른 회차 120): 같은 날에도 가끔 값이 옮겨 감.
- 시뮬레이션에서 처음 자리는 참값 (실물은 집을 때 인식 좌표, 치우침 ±perc_bias). 퍽이 상자 위에만 놓이면 되어 수 mm 오차는 상관없음 (미시험).
- 이어서 상한이 이제 **정책 집기 성공률 (62 %)** -> 집기 학습 개선이 다시 의미 있음. 남은 일: 실물 퍽 자리 측정 (팔 카메라 · D435) 정확도 확인, ROS `manipulator_node` 에 다시 쥐기 동작.

```bash
HEADLESS=1 $ISAACLAB_PY chain_pallet_eval.py --num_envs 192 --seed 2 --regrasp always [--regrasp_noise 2] --out /tmp/rg.json   # 기본 이득 0.3 · 처음 자리로 · 목표 반경 −2 mm
```

**고정 동작 집기로 바꿈 (2026-11-09)**: 다시 쥐기가 "잰 퍽 자리로 고정 동작 쥐기" 라서, 처음부터 정책 없이 같은 동작으로 집어 봄 (`--scripted_pick σ`).
- 경로: 시작 자세 (READY_TILT) 에서 잡는 점 (잰 퍽 + 잡는 높이, J1 에서 먼 쪽 2 mm) 위 5 cm · J1 쪽 3 cm 로 벌린 채 -> 직선으로 내려옴 -> 쥠 -> 5 cm 들기 (약 4.6 s).
- 결과 (TP8 시드 2, 192 대, 같은 날, 실제 배치 = 미션 배치 A · B · C 88 대):

| 방식 | 측정 오차 σ | 이어서 (전체) | 실제 배치 |
|---|---|---|---|
| TP8 정책만 | (학습 인식 오차) | 57 | 30 |
| TP8 + 다시 쥐기 | 0 · 2 mm | 113 · 94 | 60 (σ 0) |
| 고정 집기, 벌림 61.6 mm, 들기 4 cm (임시 사본) | 0 · 2 · 4 · 6 mm | 164 · 147 · 110 · 80 | 84 · 69 · 52 · 37 |
| **고정 집기, 벌림 50 mm (실물), 들기 5 cm** | 0 · 2 mm | **172 · 146** | **84 · 69** |
| 집게 축 반대로 6 cm 접근 (ROS 이전 `beginPick`, 임시 사본) | 0 · 2 mm | 93 · 140 | 48 · 69 |

  - 집기 실패는 대부분 학습용 무작위 배치 (실제 배치는 2 ~ 4 대). 집게 축 접근은 운반 중 미끄럼이 많음 (σ 0 에서 63 대, σ 0 이 σ 2 보다 나쁜 까닭은 미확인).
  - 벌림 50 mm 는 손가락 값 0.0042 (61.6 mm = 0.010 에서 비례 환산, 실측 아님).
- **결정**: 미션 집기는 고정 동작 (ROS `control/config/manipulator.yaml` `toppick.approach_mode: top` · `approach_height 0.05` · `approach_inward 0.03` · `radial_offset 0.002`, `manipulator_node.cpp` `beginPick` · `finalApproach`).
  강화학습 집기 (TP8) 는 보류 (`skill.enabled false` 그대로).
- **성패는 퍽 자리 측정**: 실물 측정 오차 기록 없음 (손눈 보정 없음, 모의 렌더 퍽 중심 중앙 3.6 · p95 8 mm). σ 4 mm 면 실제 배치 52/88.
  -> 다음: 실물 target_look 자세로 지그 위 퍽을 재서 σ 확인, 필요하면 손눈 보정. Gazebo · 실물로 top 경로 관절 한계 확인.

```bash
HEADLESS=1 $ISAACLAB_PY chain_pallet_eval.py --num_envs 192 --seed 2 --scripted_pick 2 --grip_open 0.0042 --out /tmp/sp.json   # 고정 동작 집기 (σ 2 mm, 벌림 50 mm)
```

**TP9 = 벌림 50 mm 로 다시 학습 (2026-11-10)**: TP8 40300 에서 `env.gripper_open=0.0042` 로 20000 반복 (`2026-11-09_22-14-33`, 7.8 h, 학습 성공률 끝 구간 54 %).
- 후보 4 개 (반경 보상 가장 좋은 50250, 끝 구간 58250 · 59250 · 60299) 를 시드 1 로 고르고 시드 2 로 보고. 모두 같은 날, 192 대, 벌림 50 mm (TP8 61.6 mm 줄만 학습 때 벌림).

| 정책 | 벌림 | 시드 1 이어서 | 시드 2 집기 | **시드 2 이어서** | 운반 미끄럼 · 덜 들어감 |
|---|---|---|---|---|---|
| TP8 40300 | 61.6 mm (학습 때) | 44 | 120 | 57 | 47 · 16 |
| TP8 40300 | 50 mm (실물) | - | 74 | **23** | 41 · 10 |
| TP9 50250 | 50 mm | 33 | 92 | 33 | 49 · 9 |
| TP9 58250 | 50 mm | 29 | 98 | 36 | 39 · 23 |
| **TP9 59250** | 50 mm | **35** | 95 | **39** | 37 · 15 |
| TP9 60299 (마지막) | 50 mm | 29 | 98 | 37 | 31 · 25 |
| **고정 동작 집기** σ 0 · 2 mm | 50 mm | - | 174 · 173 | **172 · 146** | 2 · 0 / 13 · 14 |

- 실물 벌림에서 TP9 는 TP8 보다 낫지만 (23 -> 39) 집기가 반 정도에서 막힘. 고정 동작 집기 (11-09 값 172 · 146 과 같음) 와는 차이가 큼.
- **등록**: `toppick_TP9` (59250) 는 latest · ROS 아님 (미션은 고정 동작 집기, RL 꺼짐). 고정 동작 집기도 등록부에 `toppick_scripted` (kind scripted, 정책 파일 없음, 경로 매개변수 + 평가) 로.
  비교에 쓴 결과 JSON 은 `policies/evals/2026-11-10_chain_*.json` (chain_pallet_eval.json 은 매번 덮어써짐).
- **다음**: RL 을 더 돌리기보다 실물 퍽 자리 측정 σ 확인이 먼저 (σ 2 mm 를 넘으면 고정 동작 집기도 146 아래).

**TP9 이어 학습 · TP10 (밀림 벌점) · TP11 (곧게 들기) (2026-11-10 ~ 11-12)**: 모두 벌림 50 mm (`env.gripper_open=0.0042`), 이어 평가 = 192 대 · 벌림 50 mm · 인식 치우침 10 mm (임시 사본 `PERC_BIAS`), 같은 날 나란히.
- 평가 인식 치우침만 바꿔 봄 (TP9 59250 시드 2, 이어서): 10 mm 39 · 5 mm 43 · 2 mm 52 · 0 mm 46. **인식 0 이어도 집기 115/192** -> 인식보다 정책 동작이 막음.
- 11-10 학습 (`2026-11-10_22-25-34`, 59250 에서 28000, 설정 그대로, 11.2 h): 학습 성공률 47 ~ 57 % 제자리. 이어서 시드 1 · 2 = 77750 20 · 37, **78250 33 · 47**, 87249 29 · 38 (TP9 59250 35 · 39). 등록 안 함.
- TP10 (`2026-11-11_12-39-26`, 78250 에서 28000, 11.4 h): `rew_puck_push -300` (들기 전 퍽이 처음 자리에서 5 mm 넘게 밀린 거리, 스텝마다) · `perc_bias 0.010 -> 0.005`.
  학습 성공률 65 -> 58 % (80k 근처 최고, 인식 5 mm 라 쉬워진 몫 포함), `puck_push_mm` 3.9 -> 4.4 로 안 줄어듦.
  이어서 시드 1 · 2 = 79750 33 · 36, 80750 24 · 36, **82750 33 · 41**, 87250 30 · 39, 106249 30 · 38 -> 나아지지 않음. 등록 안 함.
- **원인 (TP10 82750 시드 2, 진단용 임시 사본)**: 쥐기 시작할 때 퍽 밀림 중앙 0 ~ 1 mm (쥐기 전에는 안 밈), 들기 (2 cm) 전 최대 밀림 25 ~ 38 mm = **쥔 뒤 상자 위에서 끌기**.
  닫기 시작 높이 = 잡는 점 + 17 ~ 18 mm (넣기 성공 대도 같음). 집기 실패 78 = 상자 밖 떨어뜨림 25 · 옆 퍽 건드림 18 · 손 안 15 mm 넘음 17 · 일찍 끝남 14 · 넘어짐 4.
  TP10 벌점은 처음 자리에서 멀어진 양이라 끄는 순간의 방향을 못 가르침. 고정 동작 집기 (쥔 뒤 곧게 5 cm) 는 밀림 2 mm.
- **TP11 (`2026-11-12_00-26-11`, TP10 82750 에서 14500, 약 6 h)**: `rew_lift_straight -2000` = 퍽 3 cm 안 · 닫은 채 · 들림 2 cm 전에 잡는 점이 스텝마다 수평으로 움직인 거리 [m] (`Metrics/closed_slide_mm`). TP10 두 변경은 그대로.
  가중치: 5 cm 들기 전까지 · −3000 이면 에피소드 −1000 (보상 대부분), 2 cm 전 · −2000 이면 −50 ~ −150 (들기 보상 약 900 의 5 ~ 15 %).
  끝나면 TP10 82750 · 11-10 78250 과 같은 날 이어 평가 (들기 전 밀림 · 실패 원인 같이).
  코드 변경은 커밋 e368698 (mission_planner #197) 에 같이 들어감.
- **TP11 결과 (11-12, 97249 까지 5.8 h)**: 학습 중 `closed_slide_mm` 0.29 -> 0.23, `puck_push_mm` 3.5 -> 3.0, 학습 성공률 0.67 -> 0.70 (91k 근처 최고).

| 정책 | 시드 1 | 시드 2 | 집기 실패 (두 시드) | 상자 밖 떨굼 | 손 안 15 mm 넘음 | 옆 퍽 | 들기 전 밀림 중앙 |
|---|---|---|---|---|---|---|---|
| 11-10 78250 | 33 | 47 | 171 | 69 | 35 | 25 | 28 mm |
| TP10 82750 | 33 | 41 | 169 | 60 | 39 | 34 | 31 mm |
| TP11 89250 | 44 | 45 | 170 | 73 | 37 | 28 | 26 mm |
| TP11 89750 | 38 | 48 | 168 | 71 | 50 | 21 | 25 mm |
| **TP11 90750** | **42** | **52** | **157** | 68 | 40 | **19** | 24 mm |
| TP11 91250 | 37 | 52 | 164 | 68 | 42 | 20 | 24 mm |
| TP11 97249 (마지막) | 35 | 30 | 183 | 74 | 56 | 28 | 24 mm |

  - 89250 · 90750 · 91250 이 두 시드 모두 기준 이상 -> 효과로 봄 (평균 40 -> 47). 옆 퍽 건드림 · 덜 들어감이 줄었음. 상자 밖 떨굼 (68) 은 그대로, 91k 지나면 다시 나빠짐.
  - **등록**: `toppick_TP11` (90750, latest · ROS 아님). 결과 JSON `policies/evals/2026-11-12_chain_*.json`.
  - TP8 -> TP11 네 번에 벌림 50 mm 넣기 23 -> 47. 고정 동작 집기 146 (σ 2 mm) 과는 3 배 -> 미션은 고정 동작 집기 그대로, 실물 σ 측정이 먼저.

**TP12 (`2026-11-12_19-52-40`, TP11 90750 에서 22000, 설정 그대로 · 학습률 0.0003, 8.9 h)**: 학습 성공률 0.69 (90k) -> 0.62 (끝), 들기 전 밀림 2.8 -> 4.4 mm.
이어 평가 (192 x 시드 1 · 2 = 384, 벌림 50 mm, 같은 날, 앉음): TP11 90750 v3 119 · v5 123 / TP12 98500 110 · 114, 99500 105 · 101, 103500 112 · 110, 112749 118 · 131.
한 시드 안 흔들림 ±10 (112749 v3 48 · 70) -> **나아지지 않음, 등록 안 함**. TP8 -> TP12 벌림 50 mm 넣기 약 32 % 에서 멈춤 (고정 동작 집기 72 ~ 80 %) -> 장시간 RL 은 멈추고 고정 동작 집기 + 실물 σ 측정.

**팔레트 v5 · Jetson 배터리 · 바퀴 R31.5 반영 (2026-11-13)**: 저장소 URDF · USD 를 v5 (10 칸 4 · 4 · 2) 로 (`waffle_4wd_description/CHANGES_B.md`), `pallet_place_traj.json` 10 칸 (새 URDF 로 다시 계산해도 관절 차 0).
- Isaac (새 USD): 놓기 · 꺼내기 24/24, 고정 동작 집기 이어서 σ0 170 · σ2 137 (시드 2). TopPick 정책은 다시 학습할 필요 없음 (관측 · 집는 곳에 팔레트 없음, TP11 v3 119 · v5 123).
- 쥐는 값 (고정 동작 집기 σ2, 시드 1 + 2, v5 시험 폴더): −0.0075 281 · −0.009 296 · −0.010 310 /384 (v3 288 · 287 · 302). −0.010 은 닫는 축 치우침 0.1 -> 1.9 mm (한 손가락 한계 조짐).
  실물 쥐는 힘은 펌웨어 `GRIP_SQUEEZE_TICKS` 33 이 정함 -> 실물 미끄럼 비교 후 정할 것 (아직 바꾸지 않음).
- 이웃 칸 퍽 (시험본 `policy/pallet_v5/policy/manipulator/pallet_nb_check.py --neighbors pairs|slot|behind`): 막는 쌍 = 1 열 1_0 ↔ 1_1 · 1_2 ← 1_3 만 (이웃 퍽이 밀림, 손가락 ↔ 이웃 직육면체 −1.0 mm).
  원기둥 목표는 이웃이 가만히 있어도 실패가 많음 (쥐기 시뮬레이션 잡음) -> 상자 퍽 · 이웃 속도로 판단. 계획기 `slots.BLOCKERS` · 벌점 (모양 2.8 / 1 열 모양 28 / 막힘 28 m) 에 반영.
- **퍽 무게 실측 반영 (2026-11-13)**: 원기둥 13 g · 사각기둥 17 g (이전 Isaac 추정 45 · 55 g, `dice2_cfg.PUCK_MASS`). 같은 조건 (v5 · 새 USD · 시드 2 · 192 대) 앉음:
  고정 동작 집기 σ0 170 -> **174**, σ2 137 -> **168** (운반 미끄럼 35 -> 4), TP11 90750 61 -> **85**. 놓기 · 꺼내기 24/24 그대로.
  -> 지금까지 운반 미끄럼의 큰 몫은 퍽을 3 배 무겁게 둔 탓. 쥐는 값 시험 (−0.009 · −0.010 이 좋음) 은 무거운 퍽 기준이라 다시 볼 것. TP3 ~ TP12 는 45 · 55 g 으로 학습 (다시 학습하면 실측 무게로).
- **관절 3 ↔ 1열 퍽 충돌 (2026-11-13 실물)**: 원인 = 주행 자세 DRIVE `[-0.0245, -1.6122, 1.2901, 1.1888]` (관절 2 −1.6 으로 뒤로 접혀 관절 3 모터가 퍽 윗면 높이, 계산 2_1 −9 · 1_1 −1 mm, #219).
  팔레트 놓기 · 꺼내기 궤적은 18 mm 넘음, 상자 위 45° 집기는 J1 축 0.14 m 이상 33 mm 넘음 (0.10 ~ 0.12 m 로 당기면 −5 ~ 12 mm).
  -> control `poses.DRIVE` = ALIGN E2 `[0, -1.37, -0.01, 1.85]` (퍽 15 · 차체 23 mm, 관절 2 영점 −5° 면 8 mm), 켤 때 순서 `startup.stages` J3 → J2 → **J4 → J1** (이전 순서면 J4 단계 집게가 위 카메라 기둥과 −20 mm). 실물 0.1 rad/s 로 첫 확인.
- **TP13 설정 (TP11 90750 에서, 퍽 13 · 17 g)**: `rew_pallet_clear −5` = link3 충돌 상자 겉면 점 (5 mm, 2286 개) ↔ v5 칸 10 곳 퍽 기둥 (모두 찬다고 봄, 원기둥 r 15 · 직육면체 21.2 mm) 최소 틈이 20 mm 아래면 −5 × (20 − 틈) / 20,
  `Metrics/pallet_clear_mm` (가장 가까운 환경) · `pallet_close_ratio`. 장면에 팔레트 퍽은 없음 (계산만). 짧은 확인 (64 대 3 반복): TP11 정책 틈 최소 30 ~ 35 mm, 벌점 0 -> 지금 정책은 대부분 지키고 있음, 몸 가까이 당기는 경우만 막음.

**장시간 학습 -> 고르기 -> 등록 (TP5 · TP6 · TP8 때 쓴 순서)**:

```bash
export ISAACLAB_PY=$HOME/pa-course/IsaacLab-6.1/.venv/bin/python   # 학습 중에는 평가 · 창 띄우지 말 것 (GPU 8 GB)
nohup ./run_rl.sh toppick 256 20000 --checkpoint $PWD/logs/rsl_rl/waffle_toppick/2026-11-08_17-33-38/model_40300.pt > logs/toppick_long.log 2>&1 &   # TP8 에서, 약 1.4 s/반복
tail -f logs/toppick_long.log | grep -E "Learning iteration|success_rate|hand_center|Mean action std"   # 멈추기: pkill -f "train.py --task Waffle-TopPick"

# 고르기: 학습 성공률 500 반복 창 상위 5 + 마지막 -> 시드 1 이어 평가 (임시 폴더에만 씀, md 안 건드림)
RUN=$(ls -d logs/rsl_rl/waffle_toppick/*/ | sort | while read d; do ls $d/model_*.pt >/dev/null 2>&1 && echo ${d%/}; done | tail -1); echo $RUN; C=/tmp/cand; mkdir -p $C   # 체크포인트 있는 가장 최근 폴더
CANDS=$($ISAACLAB_PY - "$RUN" <<'PY'
import sys, glob, re, numpy as np
from tensorboard.backend.event_processing.event_accumulator import EventAccumulator as E
e = E(sys.argv[1], size_guidance={"scalars": 0}); e.Reload(); s = e.Scalars("Metrics/success_rate")
st = np.array([x.step for x in s]); v = np.array([x.value for x in s])
have = sorted(int(re.search(r"model_(\d+)\.pt", f)[1]) for f in glob.glob(sys.argv[1] + "/model_*.pt"))
w = sorted(((v[(st >= a) & (st < a + 500)].mean(), a) for a in range(int(st.min()), int(st.max()) - 499, 500)), reverse=True)[:5]
print(" ".join(map(str, sorted({min(have, key=lambda h: abs(h - (a + 250))) for _, a in w} | {have[-1]}))))
PY
); echo "후보: $CANDS"
cp policies/toppick_latest.pt $C/mlatest.pt   # 기준 정책도 같은 날 나란히 (날이 다르면 값이 옮겨 감)
for it in latest $CANDS; do
  [ $it = latest ] || $ISAACLAB_PY -c "import sys; sys.path.insert(0,'.'); import register_policy as R; m,_,od,_,_,_=R.build_actor('$RUN/model_$it.pt'); R.export(m,od,'$C/m$it.pt','$C/m$it.onnx')" > $C/export_$it.log 2>&1
  HEADLESS=1 $ISAACLAB_PY chain_pallet_eval.py --num_envs 192 --seed 1 --policy $C/m$it.pt --out $C/chain_s1_$it.json > $C/chain_$it.log 2>&1
  python3 -c "import json; s=json.load(open('$C/chain_s1_$it.json'))['summary']; print('$it', '집기', s['pick']['pct'], '% 이어서', s['chain']['ok'], '/192')"
done

# 가장 좋은 번호를 BEST 에 (같은 날 잰 latest 보다 나을 때만) -> 시드 2 보고 -> 등록
BEST=<번호>
./run_rl.sh toppick_eval 256 --seed 2 --policy $C/m$BEST.pt
./run_rl.sh chain_eval 192 --seed 2 --policy $C/m$BEST.pt          # TP8 = 57/192 (11-09), 같은 날 latest 도 재서 비교
./run_rl.sh register $RUN/model_$BEST.pt toppick_TP9 --latest --ros toppick_tilt --eval toppick_eval.json chain_pallet_eval.json --note "..."
```

### 4.8 URDF 가 바뀌면 (Waffle, 2026-10-28)

순서 (패키지 맨 위 폴더에서):

```bash
~/.venvs/mujoco/bin/python sim/tools/prepare_sim.py          # 1. 시뮬레이션용 URDF·겉모양 메쉬 (출력 '겉모양 원본 조각 N 개 -> 파일 M 개' + 검사 통과 확인)
~/.venvs/mujoco/bin/python sim/mujoco/build_mjcf.py          # 2. MuJoCo 모델
~/.venvs/mujoco/bin/python sim/tools/geometry_check.py       # 3. 정책 설정에 박힌 기하 값 다시 계산 (아래 표와 비교, 약 3 분)
~/.venvs/mujoco/bin/python sim/mujoco/side_grasp_check.py --yaw 90 --gap 0.08   # 4. 옆에서 집기 물리 확인 (여러 --gap --yaw)
./sim/tools/sync_to_docker.sh                                # 5. 컨테이너로 복사
docker exec isaac-lab-base bash -c 'cd /workspace/isaaclab/scripts/waffle_4wd_description_261027_1711/sim/isaac && ./run_isaac.sh convert && ./run_isaac.sh check'   # 6. USD·물리 확인
docker exec isaac-lab-base bash -c 'cd /workspace/isaaclab/scripts/waffle_4wd_description_261027_1711/sim/isaac && ./run_isaac.sh sidepick 256 500'                 # 7. 정렬·집기 다시 학습 (약 17 분)
```

변화가 작으면 7 은 지금 정책에서 이어서 학습 (`train.py --task Waffle-SidePick-Direct --checkpoint <절대경로>/2026-10-28_20-45-44/model_697.pt --max_iterations 200`, 관측 35·행동 6 이 같을 때만. 이어 받을 파일 이름은 `ls` 로 확인: 마지막이 499 가 아닐 수 있음).

URDF 에 따라 확인할 값 (자동으로 안 따라감):

| 값 | 파일 | 지금 값 | 다시 구하는 곳 |
|---|---|---|---|
| 관절·링크 이름 | `waffle_isaac/robot_cfg.py`, `sim_params.json`, env 들 (`"arm_link_5"`) | RMX52_*, Wheel_Revolute_*, gripper_left/right_joint, arm_link_5 | URDF |
| 게인·armature·마찰 | `sim/sim_params.json` | 팔 강성 19 / 감쇠 0.85, 바퀴 감쇠 0.5 (추정) | 실측 |
| 잡는 점 (손가락 패드 가운데) | `waffle_isaac/dice2_cfg.py: GRASP_OFFSET_A5` | arm_link_5 (0, 0, −0.108) | geometry_check 3 (패드 z −0.075 ~ −0.123, 구동부 −0.055 ~ −0.075) |
| 집게 벌림·닫기 | `sidepick_env_cfg.gripper_open/closed`, `grasp_finger_range` | 0.015 (49.6 mm) / −0.0014, 쥠 0.0015 ~ 0.010 | geometry_check 3, URDF 손가락 한계 |
| 로봇 앞 끝, joint1 축 | `sidepick_env_cfg.robot_front`, `joint1_x` | 0.218, 0.087 | geometry_check 1·2 |
| 옆에서 집기 거리·상자 gap | `sidepick_env_cfg.sweet_radial`, `gap_range` | 0.33 m, 5 ~ 11 cm | geometry_check 4 (오차 0 인 거리 0.28 ~ 0.38), side_grasp_check |
| 잡는 높이 | `sidepick_env_cfg.grasp_dz` | 퍽 중심 + 6 mm (SP3 부터) | side_grasp_check (손가락-상자 거리) + 4.9 절 정정 표 (손가락-카메라 가로대) |
| 시작 자세 | `sidepick_env_cfg.READY_POSE` | [0.12, −0.49, −1.07, 1.56, 0.0] | side_grasp_check 출력 `q_pre` |
| 퍽 스토리지 통 축·통로·받침 | `geometry_check.py: TUBES`, `side_grasp_check.py: TUBE` (입구 z 도), 4.5 절 | 가운데 (−0.0825, 0), 양옆 (−0.087, ±0.065), 입구 0.4015 / 0.3994 / 0.3992, 받침 z 0.19 ~ 0.20, **통 반지름 15.8 ~ 16.2 mm (퍽 14.8)** | geometry_check 5·6 (축이 바뀌면 단면 그림으로 다시 찾음). 통 틈·가운데 통 각도 (joint1 축 바로 뒤 = ±180° 한계) 가 바뀌면 넣기 다시 시험 (4.9 절 시도 9 명령) |

## 5. 다음 정책 자리

새 정책을 시작하면 여기 앞에 2절과 같은 형식 (설정 표 + 회차 기록 표 + 남은 일) 으로 절을 추가하고 1절 요약 표에 한 줄 넣습니다.

## 부록 A. 회차 기록 쓰는 법

- 회차 이름: 정책 머리글자 + 번호 (주행 D1, D2 …, 잡기 G1 …). 이어서 학습한 것도 새 회차로 (어느 회차 몇 반복에서 이어졌는지 적음).
- 실패한 회차도 지우지 않고 남김: **무엇을 바꿨는지 · 숫자 결과 · 원인 (확인한 방법)** 을 같이.
- 결과는 학습 중 지표 (보상·에피소드 길이·Metrics/*) 와 평가 결과를 구분해서 적음.

## 부록 B. 이전 로봇 (TeamRobot, 2026-10-26 퍽 잡기) 에서 배운 보상 설계 교훈

로봇이 달라 설정값은 그대로 쓰지 않지만, 잡기 같은 정책을 만들 때 다시 확인할 원칙입니다.
- 실패하면 **종료 + 큰 벌점** 을 주면 정책이 아예 아무것도 안 하는 해로 감 → 실패 상태는 스텝 벌점으로.
- 단계 사이가 멀면 (접근 → 들기) **중간 디딤돌 보상** ('잡음': 손가락이 물체에 막혀 멈춤) 이 필요. 단, 꼼수로 채울 수 없게 조건을 건다 (차체가 기울면 안 줌 등).
- 위치 제어 **목표각이 실제보다 크게 앞서면** 큰 힘이 나와 바닥을 짓누르는 꼼수가 생김 → 앞섬 제한 (±0.25 rad) + 차체 기울기 벌점.
- 다음 단계 보상은 **계단식 (3 cm 넘어야) 이 아니라 연속형 (1 mm 부터)** 으로. 계단식이면 잡기까지 배운 정책도 들기를 못 찾음.
- 막히면 정책이 한 단계를 해 놓은 상태에서 **스크립트로 다음 단계를 해 보는 진단** 으로 물리 문제인지 탐색 문제인지 가른다.
- 학습 전에 **손으로 푼 IK 스크립트로 같은 동작이 물리적으로 되는지** 먼저 확인.
