developlcy-oss/Lv2_Cartlidar_Assignment/workspace/urdf_and_usd/policy/manipulator/기록/1c_누운퍽_세우기_LieUpright.md

# ★ 2026-11-11 밤: 지금 판은 r2g2 (`lieupright_r2g2.onnx` · `.pt`) — r2e 는 아래 옛 설명

- **r2g2** 는 `Waffle-LieUprightB7-Direct` 에서 학습했습니다. 순서는 r2e → B6 (r2g) 500 반복 → B7 500 반복입니다.
- **관측이 미션 노드와 같습니다.**
  - 퍽 자리 · 긴 축 · 옆 퍽은 시작 때 잰 값으로 고정합니다.
  - 상자 · 세울 자리 D 는 잰 상자(±3 mm · ±1°)로 냅니다. 옆 퍽이 없으면 상자 중심 대칭입니다.
  - 쥠 칸은 손가락 범위만 봅니다.
  - 칸 번호 · 순서는 아래 표와 같고, 값을 만드는 방법만 위처럼 바뀌었습니다.
- **관절 속도**: 노드 비례 축소(scale)를 넣었고, 학습 중 상한은 에피소드마다 2 ~ 4 rad/s 무작위입니다. 노드 기본은 3.0 입니다. **3.0 넘게 올리려면 다시 평가해야 합니다**(v 4.0 평가 90.3 % 불통과: 창 밖 벌림 · badspot · 자기 충돌 증가).
- **노드 놓음 규칙**도 학습에 넣었습니다. 든 뒤 처음 벌림이 (잡는 점 + a × 0.011) – D 수평 > 30 mm · 위 > 60 mm · β < 1.4 면 종료합니다.
- ONNX 는 한 파일이고(226 965 B, md5 0c6e20cabce0), TorchScript 와 출력 차이는 최대 2.2e-4 입니다(무작위 입력 256 개).
- 결과(Isaac 모의, 3 seed × 512, 팔-상자 접촉 없는 성공):
  - P1(B7 관측): v 2.0 93.6 % · v 3.0 95.7 % · v 4.0 90.3 %(기록 항목, 결과를 본 뒤 기준 변경)
  - **미션 순서 정책 단계 M3: 98.9 %**(r2e 90.2 %), 시간 끝 2/1536
- 정답 벡터는 `r2g2_parity/` 에 있습니다.

---

# 누운 직육면체 세워 놓기 정책 (r2e, 앞 판 r2d) — 넘겨줄 묶음 (#192, 모의 시험 결과)

2026-11-11 Onbeom. Isaac Lab 3.0 · Isaac Sim 6.1 모의 환경에서 학습했습니다. **지금 쓰는 판은 r2e** (`Waffle-LieUprightB4-Direct`, r2d 에서 500 반복 이어 학습, 옆 퍽 닿음 종료 벌점 −30 → −60). 앞 판 r2d (`Waffle-LieUprightB3-Direct`) 파일도 그대로 둡니다. 실물에서는 아직 돌리지 않았습니다.

## 파일

| 파일 | 내용 |
|---|---|
| `lieupright_r2e.onnx` | **지금 판.** 정책 (입력 `obs` [1, 45] float32 → 출력 `actions` [1, 6]). 외부 데이터 없이 한 파일 (226 965 B). TorchScript 와 출력 차이 최대 1.5e-4 (무작위 입력 256 개, 범위 ±1.5, 한 줄씩) |
| `lieupright_r2e.pt` | 같은 정책 TorchScript (rsl_rl `exported/policy.pt`, 학습 `logs/rsl_rl/waffle_lieupright/2026-11-11_04-38-44/model_1997.pt`) |
| `lieupright_r2d.onnx` | 앞 판 r2d. TorchScript 와 출력 차이 최대 7.6e-5 |
| `lieupright_r2d.pt` | 앞 판 r2d TorchScript (`2026-11-11_02-09-37/model_1498.pt`) |

**r2e 와 r2d 는 관측 (45, 아래 표) · 행동 (6) · 제어 30 Hz (물리 1/120 s × 4) 정의가 같습니다** (환경 설정 `WaffleLieUprightB4EnvCfg` 는 B3 에서 보상 `rew_nb` 하나만 바꿈, 관측 · 행동 · 물리 설정은 상속 그대로, 두 ONNX 입출력 모양 같음 확인). 학습 중 환경 차이: r2e 는 NaN 보호 (깨진 대 = 보상 0 · 종료) 가 있는 환경으로 학습.

관측 정규화는 정책 안에 없습니다 (rsl_rl 기본, 아래 값을 그대로 넣음).

## 하는 일 · 끝 상태

상자 위에 누운 직육면체 퍽 (30 × 30 × 60 mm) 을 위에서 쥐고 → 3 cm 넘게 (보통 6 ~ 10 cm) 들고 → 손 안에서 세우고 → 상자 위 세울 자리 D 에 세워 놓고 → 손가락을 벌려 손을 3 cm 넘게 뺌. 그 뒤 다시 잡기 (45° 집기 정책 n5) 는 이 정책 밖입니다.

- 시작: 팔 = 집기 시작 자세 `READY_POSE_45` (joint1 ~ 5 = 0, −0.338, 0.559, 0.564, 0 rad), 집게 벌림. 차체는 미션 계획기 정지 · 회전 접근 자리 (앞 끝 → 상자 면 0.1272 m, 퍽 쪽으로 17.06° 돈 상태).
- **성공 (끝 상태)** = 놓고 손가락을 벌린 뒤 1 s 동안 다음이 모두 맞음: 퍽 기울기 5° 안, 퍽 바닥 − 상자 윗면 3 mm 안, 잡는 점이 퍽 중심에서 3 cm 넘게 떨어짐, 퍽이 상자 위. 그리고 놓은 자리가 '다시 잡을 수 있는 자리': D 에서 3 cm 안, 퍽 중심 → 상자 가장자리 25 mm 넘게, 옆 퍽에서 7 cm 넘게.
- 실패로 끝나는 것: 떨어뜨림 (3 cm 넘게 든 뒤 놓침 · 퍽이 상자 밖), 놓은 뒤 넘어짐 (20° 넘음), 옆 퍽 닿음 · 3 mm 넘게 밀림 · 넘어짐, 자기 충돌, 팔-몸체 · 몸체-상자 접촉, **팔-상자 접촉 1 N 넘음**, 나쁜 자리에 놓음, 12 s 시간 끝.
- 성공 시각 중앙 3.5 s (모의).

## 제어 주기 · 행동 (6)

- 제어 30 Hz (물리 1/120 s × 4). 행동은 [−1, 1] 로 자름.
- 행동 = (잡는 점 변위 base x, y, z × 5 mm, 집게 숙임 β 변화 × 0.05 rad, 집게 롤 ρ 변화 × 0.06 rad, 집게 (> 0 벌림 · ≤ 0 닫음)).
  - β, ρ 는 적분 상태: β 범위 −0.15 ~ 1.75 rad (시작 π/4), ρ ±2.6 rad (시작 0). 집게 방향 a = −cos β z + sin β h (h = 관절1 축 → 잡는 점 수평 방향), 닫는 축은 t = z × h 를 a 둘레로 ρ 돌림.
  - 관절 목표 = 감쇠 최소제곱 IK (감쇠 1e-4, 자세 가중 1.0) 로 낸 관절 변화 + 이전 목표, 측정 관절 ± 0.25 rad 안 · 관절 한계 안으로 자름.
  - 집게: 벌림 = 손가락 관절 0.010 m, 닫음 = 팀 FINGER_CLOSE (−0.011 m). 한 번 놓은 뒤 (세워 놓고 벌림) 는 늘 벌림.

## 관측 (45, 순서대로, base = 로봇 root 좌표, m · rad)

| 번호 | 개수 | 내용 |
|---|---|---|
| 0 ~ 4 | 5 | 팔 관절 1 ~ 5 위치 − 기본 자세 (READY_POSE_45) [rad] |
| 5 ~ 9 | 5 | 팔 관절 1 ~ 5 속도 [rad/s] |
| 10 | 1 | 왼 손가락 관절 위치 [m] |
| 11 ~ 13 | 3 | **인식한** 누운 퍽 중심 (base xyz). x · y = 인식값 (아래 잡음 모델), z = 상자 윗면 높이 + 15 mm (상자 높이 70 mm 가정, ±3 mm 치우침) |
| 14 ~ 15 | 2 | 누운 퍽 긴 축 요 θ 의 cos 2θ, sin 2θ (180° 대칭, 에피소드 치우침 ±3°) |
| 16 ~ 18 | 3 | 잡는 점 (base xyz) |
| 19 ~ 21 | 3 | 집게 방향 a (base 단위 벡터, 집게 몸 x 축) |
| 22 ~ 24 | 3 | 닫는 축 (base 단위 벡터, 집게 몸 y 축) |
| 25 ~ 27 | 3 | 세울 자리 D (base xyz, 세운 퍽 중심) |
| 28 ~ 29 | 2 | 옆 퍽 (세운 원기둥) xy − 인식 퍽 xy (없으면 0) |
| 30 | 1 | 옆 퍽 있음 (0 / 1) |
| 31 ~ 32 | 2 | 상자 중심 xy (base) |
| 33 ~ 34 | 2 | 상자 요의 cos, sin |
| 35 | 1 | 쥠 (0 / 1): 손가락이 −10.8 ~ −3 mm 이고 퍽 중심 – 잡는 점 3 cm 안이 연속 8 스텝이면 1, 아니면 연속 3 스텝 뒤 0 |
| 36 ~ 38 | 3 | cos ρ, sin ρ, β |
| 39 ~ 44 | 6 | 이전 행동 (자른 값, 놓은 뒤 집게 = 1) |

- 세울 자리 D: 상자 가장자리 30 mm 안 14.5 mm 격자 중, 관절1 축에서 0.27 ~ 0.32 m · 옆 퍽 (없으면 '있었다면' 자리) 에서 7 cm 밖, 점수 |r − 0.285| − 0.2 · min(옆 퍽 거리, 0.12) 가 가장 작은 점. z = 상자 윗면 + 32 mm (base).
- **인식 입력 (#191 실측 반영, 학습 · 평가 잡음 모델)**: 퍽 xy 치우침 에피소드마다 ±5 mm 균등 + 스텝마다 ±1 mm, 지연 3 ~ 9 스텝, 갱신 주기 3 ~ 10 스텝, 끊김 확률 0.1 ~ 0.4, 잡는 점이 인식 퍽에서 6 cm 안이거나 쥔 뒤는 인식값 고정 (팔 카메라가 너무 가까움).
- **손가락 관절 (관측 10 · 35 칸 쥠 판정) 의 실물 대응은 아직 정하지 않았습니다.** 모의 값은 프리즘 관절 [m], 벌림 [mm] = 41.6 + 2000 × 손가락 (+0.010 벌림 · −0.011 닫음 · 30 mm 퍽 쥠 약 −0.006, 쥠 범위 −0.0108 ~ −0.003), **값이 클수록 벌어짐**. 실물은 팔 보드 6 번째 칸 (ID 15, `/joint_states` position [rad] · effort) 이고 팀 dev (7cb49b0) `opencr_firmware/config.h` 기준 끝까지 열림 1550 · 완전히 닫힘 2650 tick (범위 −0.7946 ~ 0.9541 rad), **tick · rad 가 클수록 닫힘** (부호 반대). 실물 rad 과 손가락 m 사이 변환은 재지 않았습니다. dev 의 `tools/arm_bench/monitor/gripper_map.py` 는 2650 tick = −0.011 m · 1550 tick = 0.020 m 직선을 **가정** 합니다. 이 가정으로 실물 벤치 (dev `docs/arm_bench_test_2026-10-27.md` 4 장) 에서 퍽을 쥐고 막힌 2377 tick 을 바꾸면 −0.0033 m 로, 모의 쥠 범위 끝 (−0.003) 바로 안쪽이고 모의 30 mm 퍽 쥠 (약 −0.006) 과 2.7 mm 다릅니다. **경계 근처라 실측이 필요합니다** (#201 로 팔 담당에 요청). 실물에서 이 정책을 쓰려면 (1) 벌림 폭 대 6 번째 칸 rad 을 몇 점 재서 변환을 정하고, (2) 관측 10 칸에 그 변환으로 바꾼 m 값을 넣고, (3) 쥠 칸은 실물 판정 (손가락 범위 · 멈춤 · 전류, Issue 제안) 으로 만들어야 합니다.
- **모의에서 참값으로 넣은 것 (실물에서는 따로 정해야 함)**: 상자 중심 · 요, 옆 퍽 위치 · 있음, 긴 축 요 (치우침 ±3° 만), 관절 · 손가락 · 잡는 점 · 집게 축 (FK).

## 모의 시험 결과 (`../README.md` 3 절)

- P1 (세워 놓기만, 처음부터 512 대, seed 777 · 778 · 779, 옆 퍽 반반, 옆 퍽 밀림은 월드 좌표 판정): **r2e 팔-상자 접촉 없는 성공 96.9 · 95.3 · 97.1 % (평균 96.4 %), 옆 퍽 닿음 0 · 0.40 · 0.38 %**. r2d 는 같은 판정으로 93.2 · 92.8 · 95.1 % (평균 93.7 %), 옆 퍽 닿음 0 · 0 · 0.38 %.
- 옆 퍽 밀림 판정을 base 좌표 → 월드 좌표로 바꾼 까닭: base 좌표로 재면 팔 반작용으로 차체가 0.2 ~ 0.4° 돌 때 옆 퍽이 가만히 있어도 2 ~ 3 mm 밀린 것으로 보였음 (`../README.md` 재판정 표). 환경 설정 `nb_move_world` (기본 False = 옛 판정) 를 True 로 해서 평가 · 이어 학습함.
- E1 (세워 놓기 → n5 다시 집기 → 칸 넣기, 512 대, 옆 퍽 없음 seed 777 · 778 · 779 합): **r2e (가) 다시 쥐고 듦 1451/1536 (94.5 %), (나) 칸 넣기까지 (몸체 접촉 1 N 이하) 1198/1536 (78.0 %)**. 같은 회 r2d 1407 (91.6 %) · 1161 (75.6 %). 옆 퍽 반반 (seed 777): r2e 485/512 (94.7 %) · 408/512 (79.7 %). `../README.md` E1-J 행 (옮긴 뒤 확인의 잡는 점 이동 5 mm 는 판정에서 관찰로 옮김, 그 까닭도 거기).
- 관측 35 칸 쥠을 손가락 범위 + 히스테리시스만 (퍽 중심 거리 없음, 실물에서 낼 수 있는 값) 으로 바꿔도 (판정은 그대로, 512 대 · seed 777 · 778 · 779 짝): 접촉 없는 성공 1482/1536 (96.5 %) vs 원래 1481/1536 (96.4 %), 차이 없음. 두 쥠 값이 다른 스텝은 0.7 ~ 1.0 % 이고 대부분 벌림 명령 뒤 몇 스텝. `../README.md` OH 행.
- 끝자세 (손 뺀 뒤 잡는 점, base x): r2e 중앙 0.300 m · 90 % 0.399 m · 최대 0.432 m (0.38 m 넘는 대 21 %). r2d 0.321 · 0.349 · 0.378 m. r2e 는 대부분 덜 뻗지만 다섯에 하나는 더 멀리 뻗은 채 끝남.

## 한계

- 모의 시험 사이 비결정: 같은 seed · 같은 정책이라도 실행마다 옆 퍽과 무관한 종료가 1 ~ 3 대 (512 대 중) 달라짐.
- 팔 반작용으로 차체가 움직임 (모의, 끝날 때 99 % 0.7 ~ 1.4 mm · 0.06 ~ 0.15°, 최대 6 mm · 1.1°, r2e). 세울 자리 · 상자 중심은 리셋 때 차체 기준으로 고정해 두므로 그만큼 (최대 약 5 mm) 어긋날 수 있음.
- 손을 멀리 뻗은 끝자세 (잡는 점 x 0.38 m 넘음, r2e 의 21 %) 에서는 같은 관절 처짐에도 잡는 점이 더 움직임 (모의, 옮긴 직후 한 스텝 5 ~ 7 mm). 실물 팔은 길게 뻗을수록 처짐이 더 클 수 있음 (재지 않음).
- 모의만. 실물 물성 (퍽 마찰 · 질량, 상자 높이) · 지연은 추정값.
- 상자 · 옆 퍽 위치와 긴 축 요는 모의에서 거의 참값. 실물 인식 오차가 이보다 크면 성공률이 떨어질 수 있음 (재지 않음).
- 쥔 뒤 드는 높이가 6 ~ 10 cm (중앙 8.4 cm) 로 설계의 10 cm 보다 낮음 (성공 정의 안).
