developlcy-oss/Lv2_Cartlidar_Assignment/workspace/urdf_and_usd/policy/manipulator/학습기록_자동.md

# 정책 학습 · 평가 자동 기록

`record_md.py` 가 쓰는 파일 (직접 고치지 말 것, 같은 회차를 다시 기록하면 그 줄이 바뀜). 설정 · 원인 분석 · 결정은 손으로 [정책_학습기록.md](정책_학습기록.md) 에.
- 학습 지표는 마지막 10 % 반복의 평균 (학습 중 지표 = 확률적 행동). 평가 (결정적 행동) 와 섞어 읽지 말 것.
- 체크포인트 고르기 시드 1, 보고 시드 2 (#71). 등록 목록 원본은 `policies/registry.json`.

## 정책 등록 (register_policy)

| 기록 | 이름 | 과제 | 원본 체크포인트 | 반복 | sha256 | latest | ROS 모델 | 평가 | 메모 |
|---|---|---|---|---|---|---|---|---|---|
| 2026-11-05 11:19 | `policies/toppick_TP3.pt` | Waffle-TopPick-Direct | `logs/rsl_rl/waffle_toppick/2026-11-04_20-46-45/model_10500.pt` | 10500 | 26b165a63ad62a5b | 예 | `../../../ros2_ws/src/robot_policy/config/models/toppick_tilt.onnx` | toppick_eval.json 133/256 (52 %); chain_pallet_eval.json 30/192 (16 %) | 15000 회차 중 시드 1 최고 (후보 6000~14999), 표준편차 폭주 전 | <!-- register:toppick_TP3 -->
| 2026-11-06 09:51 | `policies/toppick_TP5.pt` | Waffle-TopPick-Direct | `logs/rsl_rl/waffle_toppick/2026-11-05_13-34-43/model_37000.pt` | 37000 | 748558b4ec0568cc | 예 | `../../../ros2_ws/src/robot_policy/config/models/toppick_tilt.onnx` | toppick_eval.json 144/256 (56 %); chain_pallet_eval.json 29/192 (15 %) | TP3 이어 50000 반복(2026-11-05_13-34-43) 중 37000. 이어평가 시드1 35/192(18.2%), 시드2 29~30/192(15.1~15.6%); TP3 시드1 17, 시드2 28. 물리 집기 49% (TP3 36~43%) | <!-- register:toppick_TP5 -->
| 2026-11-08 17:33 | `policies/toppick_TP6.pt` | Waffle-TopPick-Direct | `logs/rsl_rl/waffle_toppick/2026-11-06_10-47-23/model_38500.pt` | 38500 | 752e3277963fc4a2 | 예 | `../../../ros2_ws/src/robot_policy/config/models/toppick_tilt.onnx` | toppick_eval.json 147/256 (57 %); rep_TP6.json 53/192 (28 %) | 2026-11-08 latest 복원 (TP7 43300 이 이어평가 평균 27/192 로 나빠서). 이어평가 시드2 47 · 41 · 53/192 (같은 시드 반복 편차 ±15). 물리 집기 56 % | <!-- register:toppick_TP6 -->
| 2026-11-07 20:20 | `policies/toppick_TP7.pt` | Waffle-TopPick-Direct | `logs/rsl_rl/waffle_toppick/2026-11-07_18-26-18/model_43300.pt` | 43300 | 37e9290256e2cd38 | - | `../../../ros2_ws/src/robot_policy/config/models/toppick_tilt.onnx` | toppick_eval.json 138/256 (54 %); chain_pallet_eval.json 35/192 (18 %) | 실패, latest 아님 (2026-11-08 TP6 로 되돌림). 41750 에서 표준편차 상한 0.4 로 2000 반복 (2026-11-07_18-26-18) 중 43300. 이어평가 시드2 35 · 19/192 (평균 27, TP6 평균 47) | <!-- register:toppick_TP7 -->
| 2026-11-09 17:37 | `policies/toppick_TP8.pt` | Waffle-TopPick-Direct | `logs/rsl_rl/waffle_toppick/2026-11-08_17-33-38/model_40300.pt` | 40300 | 201f9a1a921cdd5e | 예 | `../../../ros2_ws/src/robot_policy/config/models/toppick_tilt.onnx` | toppick_eval.json 150/256 (59 %); chain_pallet_eval.json 57/192 (30 %) | 손 안 반경 보상 (rew_radial 5, 목표 −3 ± 2 mm) 으로 TP6 38500 에서 3000 반복 (2026-11-08_17-33-38) 중 40300. 같은 날 나란히 이어평가 시드1 44 vs TP6 31, 시드2 57 vs 47/192. 반경 −7 ~ +1 mm 비율 46 -> 52 %. 집기 평가 시드2 150/256 (58.6 %, TP6 147) | <!-- register:toppick_TP8 -->
| 2026-11-10 20:46 | `policies/toppick_TP9.pt` | Waffle-TopPick-Direct | `logs/rsl_rl/waffle_toppick/2026-11-09_22-14-33/model_59250.pt` | 59250 | 515ba2a47a9caf65 | - | - | 2026-11-10_chain_TP9.json 39/192 (20 %) | 그리퍼 벌림 50 mm (gripper_open 0.0042) 로 TP8 40300 에서 20000 반복 (2026-11-09_22-14-33) 중 59250. 같은 날 이어평가 50 mm 시드2 39 vs TP8 23 (TP8 61.6 mm 57), 시드1 35 vs 후보 29~33. latest · ROS 아님 (미션은 고정 동작 집기 toppick_scripted) | <!-- register:toppick_TP9 -->
| 2026-11-12 14:13 | `policies/toppick_TP11.pt` | Waffle-TopPick-Direct | `logs/rsl_rl/waffle_toppick/2026-11-12_00-26-11/model_90750.pt` | 90750 | eeeea8624991dcf2 | - | - | 2026-11-12_chain_TP11.json 52/192 (27 %) | 곧게 들기 벌점 (rew_lift_straight -2000, 퍽 3 cm 안 · 닫은 채 · 2 cm 들기 전 잡는 점 수평 이동) + TP10 밀림 벌점 -300 · 인식 5 mm, 벌림 50 mm. TP10 82750 에서 14500 (2026-11-12_00-26-11) 중 90750. 같은 날 이어평가 (192 대 · 벌림 50 mm · 인식 10 mm) 시드1/2 42/52 vs 11-10 78250 33/47 · TP10 82750 33/41. latest · ROS 아님 (미션은 toppick_scripted). 코드는 e368698 에 포함 | <!-- register:toppick_TP11 -->

## 집기 평가 (toppick_eval)

| 기록 | 정책 | 시드 | 배치 | 무작위화 | 대 수 | 성공 | 배치별 rand · A · B · C | 상자 · 원기둥 | 좌표 고정 · 따라감 | 넘어짐 | 옆 퍽 | 결과 파일 |
|---|---|---|---|---|---|---|---|---|---|---|---|---|
| 2026-11-05 11:17 | `policies/toppick_latest.pt` | 2 | mix | all | 256 | 133/256 (52 %) | 59/133 (44 %) · 31/48 (65 %) · 28/52 (54 %) · 15/23 (65 %) | 69/130 (53 %) · 64/126 (51 %) | 90/189 (48 %) · 43/67 (64 %) | 54 | 30 | `toppick_eval.json` | <!-- toppick:policies/toppick_latest.pt:2:mix:all:256 -->
| 2026-11-05 12:38 | `../../../../../../../../tmp/claude-1000/-home-pa8-git-Lv2-Cartlidar-Assignment/bad8723d-c803-4962-9512-1812b456aeb6/scratchpad/tp4/c12499.pt` | 2 | mix | all | 256 | 7/256 (3 %) | 5/133 (4 %) · 0/48 (0 %) · 1/52 (2 %) · 1/23 (4 %) | 5/130 (4 %) · 2/126 (2 %) | 7/189 (4 %) · 0/67 (0 %) | 69 | 32 | `toppick_eval.json` | <!-- toppick:../../../../../../../../tmp/claude-1000/-home-pa8-git-Lv2-Cartlidar-Assignment/bad8723d-c803-4962-9512-1812b456aeb6/scratchpad/tp4/c12499.pt:2:mix:all:256 -->
| 2026-11-06 09:48 | `policies/toppick_TP5.pt` | 2 | mix | all | 256 | 144/256 (56 %) | 63/133 (47 %) · 34/48 (71 %) · 30/52 (58 %) · 17/23 (74 %) | 77/130 (59 %) · 67/126 (53 %) | 104/189 (55 %) · 40/67 (60 %) | 56 | 30 | `toppick_eval.json` | <!-- toppick:policies/toppick_TP5.pt:2:mix:all:256 -->
| 2026-11-08 17:33 | `policies/toppick_TP6.pt` | 2 | mix | all | 256 | 147/256 (57 %) | 62/133 (47 %) · 39/48 (81 %) · 32/52 (62 %) · 14/23 (61 %) | 76/130 (58 %) · 71/126 (56 %) | 112/189 (59 %) · 35/67 (52 %) | 43 | 28 | `toppick_eval.json` | <!-- toppick:policies/toppick_TP6.pt:2:mix:all:256 -->
| 2026-11-07 18:05 | `../../../../../../../../tmp/cand/m41750.pt` | 2 | mix | all | 256 | 144/256 (56 %) | 68/133 (51 %) · 31/48 (65 %) · 29/52 (56 %) · 16/23 (70 %) | 76/130 (58 %) · 68/126 (54 %) | 105/189 (56 %) · 39/67 (58 %) | 41 | 24 | `toppick_eval.json` | <!-- toppick:../../../../../../../../tmp/cand/m41750.pt:2:mix:all:256 -->
| 2026-11-07 20:16 | `../../../../../../../../tmp/cand/m43300.pt` | 2 | mix | all | 256 | 138/256 (54 %) | 70/133 (53 %) · 27/48 (56 %) · 29/52 (56 %) · 12/23 (52 %) | 72/130 (55 %) · 66/126 (52 %) | 106/189 (56 %) · 32/67 (48 %) | 55 | 28 | `toppick_eval.json` | <!-- toppick:../../../../../../../../tmp/cand/m43300.pt:2:mix:all:256 -->
| 2026-11-08 16:41 | `../../../../../../../../tmp/claude-1000/-home-pa8-git-Lv2-Cartlidar-Assignment/42e4e7a7-1996-44bf-8fd8-4c80a8cac9a7/scratchpad/cand/m41750.pt` | 2 | mix | all | 256 | 133/256 (52 %) | 62/133 (47 %) · 31/48 (65 %) · 22/52 (42 %) · 18/23 (78 %) | 67/130 (52 %) · 66/126 (52 %) | 99/189 (52 %) · 34/67 (51 %) | 51 | 28 | `toppick_eval.json` | <!-- toppick:../../../../../../../../tmp/claude-1000/-home-pa8-git-Lv2-Cartlidar-Assignment/42e4e7a7-1996-44bf-8fd8-4c80a8cac9a7/scratchpad/cand/m41750.pt:2:mix:all:256 -->
| 2026-11-09 17:35 | `../../../../../../../../tmp/claude-1000/-home-pa8-git-Lv2-Cartlidar-Assignment/42e4e7a7-1996-44bf-8fd8-4c80a8cac9a7/scratchpad/tp8/m40300.pt` | 2 | mix | all | 256 | 150/256 (59 %) | 68/133 (51 %) · 33/48 (69 %) · 33/52 (64 %) · 16/23 (70 %) | 80/130 (62 %) · 70/126 (56 %) | 114/189 (60 %) · 36/67 (54 %) | 42 | 30 | `toppick_eval.json` | <!-- toppick:../../../../../../../../tmp/claude-1000/-home-pa8-git-Lv2-Cartlidar-Assignment/42e4e7a7-1996-44bf-8fd8-4c80a8cac9a7/scratchpad/tp8/m40300.pt:2:mix:all:256 -->

## 집기 → 칸 이어 평가 (chain_pallet_eval)

| 기록 | 정책 | 시드 | 배치 | 대 수 | 이어서 성공 | 집기 | 집은 것 중 넣기 | 실패 단계 (집기 · 넘겨받기 · 운반 · 안 앉음) | 칸별 이어서 성공 (열:칸) | 손 안 어긋남 넘겨받을 때 닫는 축 · 집게 축 mm (중앙값/p95) | 어긋남별 넣기 <1 · 1-3 · ≥3 mm | 결과 파일 |
|---|---|---|---|---|---|---|---|---|---|---|---|---|
| 2026-11-06 09:21 | `policies/toppick_latest.pt` | 2 | mix | 192 | 28/192 (15 %) | 82/192 (43 %) | 28/82 (34 %) | 110 · 0 · 37 · 17 | 3:1 3/16 3:2 5/16 3:0 1/16 3:3 5/16 2:1 1/16 2:2 1/16 2:0 1/16 2:3 4/16 1:1 1/16 1:2 2/16 1:0 2/16 1:3 2/16 | 0.12/1.31 · 4.92/11.07 | - · 1/2 (50 %) · 27/80 (34 %) | `chain_pallet_eval.json` | <!-- chain:policies/toppick_latest.pt:2:mix:192 -->
| 2026-11-05 12:39 | `../../../../../../../../tmp/claude-1000/-home-pa8-git-Lv2-Cartlidar-Assignment/bad8723d-c803-4962-9512-1812b456aeb6/scratchpad/tp4/c12499.pt` | 2 | mix | 192 | 2/192 (1 %) | 6/192 (3 %) | 2/6 (33 %) | 186 · 0 · 1 · 3 | 3:1 0/16 3:2 0/16 3:0 0/16 3:3 1/16 2:1 0/16 2:2 0/16 2:0 0/16 2:3 0/16 1:1 0/16 1:2 0/16 1:0 1/16 1:3 0/16 | 0.11/0.2 · 2.35/3.05 | - · 2/4 (50 %) · 0/2 (0 %) | `chain_pallet_eval.json` | <!-- chain:../../../../../../../../tmp/claude-1000/-home-pa8-git-Lv2-Cartlidar-Assignment/bad8723d-c803-4962-9512-1812b456aeb6/scratchpad/tp4/c12499.pt:2:mix:192 -->
| 2026-11-06 09:49 | `policies/toppick_TP5.pt` | 2 | mix | 192 | 29/192 (15 %) | 93/192 (48 %) | 29/93 (31 %) | 99 · 2 · 48 · 14 | 3:1 4/16 3:2 2/16 3:0 4/16 3:3 4/16 2:1 1/16 2:2 2/16 2:0 2/16 2:3 2/16 1:1 2/16 1:2 0/16 1:0 3/16 1:3 3/16 | 0.12/0.77 · 6.44/12.63 | - · 2/2 (100 %) · 27/91 (30 %) | `chain_pallet_eval.json` | <!-- chain:policies/toppick_TP5.pt:2:mix:192 -->
| 2026-11-06 19:25 | `policies/toppick_TP6.pt` | 2 | mix | 192 | 41/192 (21 %) | 107/192 (56 %) | 41/107 (38 %) | 85 · 0 · 53 · 13 | 3:1 1/16 3:2 5/16 3:0 3/16 3:3 3/16 2:1 3/16 2:2 6/16 2:0 1/16 2:3 5/16 1:1 3/16 1:2 4/16 1:0 4/16 1:3 3/16 | 0.11/0.84 · 4.96/12.45 | - · 5/5 (100 %) · 36/102 (35 %) | `chain_pallet_eval.json` | <!-- chain:policies/toppick_TP6.pt:2:mix:192 -->
| 2026-11-07 18:06 | `../../../../../../../../tmp/cand/m41750.pt` | 2 | mix | 192 | 51/192 (27 %) | 108/192 (56 %) | 51/108 (47 %) | 84 · 0 · 41 · 16 | 3:1 5/16 3:2 4/16 3:0 1/16 3:3 4/16 2:1 6/16 2:2 2/16 2:0 2/16 2:3 5/16 1:1 6/16 1:2 7/16 1:0 5/16 1:3 4/16 | 0.13/1.11 · 4.89/12.22 | 1/1 (100 %) · 3/4 (75 %) · 47/103 (46 %) | `chain_pallet_eval.json` | <!-- chain:../../../../../../../../tmp/cand/m41750.pt:2:mix:192 -->
| 2026-11-07 20:20 | `../../../../../../../../tmp/cand/m43300.pt` | 2 | mix | 192 | 35/192 (18 %) | 112/192 (58 %) | 35/112 (31 %) | 80 · 0 · 52 · 25 | 3:1 2/16 3:2 2/16 3:0 5/16 3:3 4/16 2:1 3/16 2:2 3/16 2:0 1/16 2:3 5/16 1:1 3/16 1:2 3/16 1:0 3/16 1:3 1/16 | 0.13/0.91 · 5.4/11.69 | 1/1 (100 %) · 4/5 (80 %) · 30/106 (28 %) | `chain_pallet_eval.json` | <!-- chain:../../../../../../../../tmp/cand/m43300.pt:2:mix:192 -->
| 2026-11-08 16:42 | `../../../../../../../../tmp/claude-1000/-home-pa8-git-Lv2-Cartlidar-Assignment/42e4e7a7-1996-44bf-8fd8-4c80a8cac9a7/scratchpad/cand/m41750.pt` | 2 | mix | 192 | 21/192 (11 %) | 101/192 (53 %) | 21/101 (21 %) | 91 · 5 · 68 · 7 | 3:1 0/16 3:2 1/16 3:0 1/16 3:3 3/16 2:1 4/16 2:2 1/16 2:0 1/16 2:3 0/16 1:1 3/16 1:2 4/16 1:0 0/16 1:3 3/16 | 0.23/5.09 · 4.94/10.77 | 1/1 (100 %) · 3/5 (60 %) · 17/95 (18 %) | `chain_pallet_eval.json` | <!-- chain:../../../../../../../../tmp/claude-1000/-home-pa8-git-Lv2-Cartlidar-Assignment/42e4e7a7-1996-44bf-8fd8-4c80a8cac9a7/scratchpad/cand/m41750.pt:2:mix:192 -->
| 2026-11-09 17:36 | `../../../../../../../../tmp/claude-1000/-home-pa8-git-Lv2-Cartlidar-Assignment/42e4e7a7-1996-44bf-8fd8-4c80a8cac9a7/scratchpad/tp8/m40300.pt` | 2 | mix | 192 | 57/192 (30 %) | 120/192 (62 %) | 57/120 (48 %) | 72 · 0 · 47 · 16 | 3:1 2/16 3:2 5/16 3:0 5/16 3:3 5/16 2:1 6/16 2:2 2/16 2:0 2/16 2:3 6/16 1:1 6/16 1:2 7/16 1:0 4/16 1:3 7/16 | 0.13/1.11 · 4.06/11.22 | - · 5/7 (71 %) · 52/113 (46 %) | `chain_pallet_eval.json` | <!-- chain:../../../../../../../../tmp/claude-1000/-home-pa8-git-Lv2-Cartlidar-Assignment/42e4e7a7-1996-44bf-8fd8-4c80a8cac9a7/scratchpad/tp8/m40300.pt:2:mix:192 -->

## 학습 회차

| 기록 | 실행 폴더 | 과제 | 대 수 | 반복 | 이어받음 | 걸린 시간 | 성공률 (마지막 10 %) | 배치별 A · B · C · 무작위 | 들어 올림 | 옆 퍽 흔듦 | 평균 보상 | 행동 표준편차 (처음 → 끝) | 경고 |
|---|---|---|---|---|---|---|---|---|---|---|---|---|---|
| 2026-11-05 11:19 | `logs/rsl_rl/waffle_toppick/2026-11-04_20-46-45` | Waffle-TopPick-Direct | 256 | 14999 / 15000 | 처음부터 | 5.7 h | 51 % | 56 % · 48 % · 62 % · 46 % | 48 % | 17 % | 1692 | 0.50 → 3.43 | 표준편차가 뒤 절반에서 0.38 → 3.43 로 커짐 (탐색 폭주, 마지막 체크포인트가 최선 아닐 수 있음); 성공률 최고 구간 = 반복 10500 ~ 11999 (마지막 아님) -> 그 근처 체크포인트도 평가 | <!-- train:logs/rsl_rl/waffle_toppick/2026-11-04_20-46-45 -->
| 2026-11-05 12:42 | `logs/rsl_rl/waffle_toppick/2026-11-05_11-44-16` | Waffle-TopPick-Direct | 256 | 12499 / 2000 | logs/rsl_rl/waffle_toppick/2026-11-04_20-46-45/model_10500.pt | 0.8 h | 3 % | 3 % · 2 % · 3 % · 4 % | 52 % | 12 % | 1757 | 0.72 → 0.80 | 성공률 최고 구간 = 반복 11700 ~ 11899 (마지막 아님) -> 그 근처 체크포인트도 평가 | <!-- train:logs/rsl_rl/waffle_toppick/2026-11-05_11-44-16 -->
| 2026-11-06 08:58 | `logs/rsl_rl/waffle_toppick/2026-11-05_13-34-43` | Waffle-TopPick-Direct | 256 | 60499 / 50000 | logs/rsl_rl/waffle_toppick/2026-11-04_20-46-45/model_10500.pt | 19.4 h | 65 % | 72 % · 63 % · 72 % · 61 % | 59 % | 8 % | 2000 | 0.72 → 0.80 | - | <!-- train:logs/rsl_rl/waffle_toppick/2026-11-05_13-34-43 -->
| 2026-11-06 11:34 | `logs/rsl_rl/waffle_toppick/2026-11-06_10-47-23` | Waffle-TopPick-Direct | 256 | 38999 / 2000 | logs/rsl_rl/waffle_toppick/2026-11-05_13-34-43/model_37000.pt | 0.8 h | 51 % | 65 % · 50 % · 56 % · 46 % | 45 % | 8 % | 1665 | 0.80 → 0.80 | 성공률 최고 구간 = 반복 38200 ~ 38399 (마지막 아님) -> 그 근처 체크포인트도 평가 | <!-- train:logs/rsl_rl/waffle_toppick/2026-11-06_10-47-23 -->
| 2026-11-07 16:28 | `logs/rsl_rl/waffle_toppick/2026-11-07_14-31-18` | Waffle-TopPick-Direct | 256 | 43499 / 5000 | logs/rsl_rl/waffle_toppick/2026-11-06_10-47-23/model_38500.pt | 1.9 h | 56 % | 65 % · 54 % · 63 % · 50 % | 48 % | 9 % | 1758 | 0.80 → 0.80 | 성공률 최고 구간 = 반복 41500 ~ 41999 (마지막 아님) -> 그 근처 체크포인트도 평가 | <!-- train:logs/rsl_rl/waffle_toppick/2026-11-07_14-31-18 -->
| 2026-11-07 20:08 | `logs/rsl_rl/waffle_toppick/2026-11-07_18-26-18` | Waffle-TopPick-Direct | 256 | 43749 / 2000 | logs/rsl_rl/waffle_toppick/2026-11-07_14-31-18/model_41750.pt | 1.7 h | 59 % | 66 % · 56 % · 67 % · 53 % | 51 % | 9 % | 1849 | 0.40 → 0.40 | 성공률 최고 구간 = 반복 42350 ~ 42549 (마지막 아님) -> 그 근처 체크포인트도 평가 | <!-- train:logs/rsl_rl/waffle_toppick/2026-11-07_18-26-18 -->
| 2026-11-08 19:48 | `logs/rsl_rl/waffle_toppick/2026-11-08_17-33-38` | Waffle-TopPick-Direct | 256 | 41499 / 3000 | logs/rsl_rl/waffle_toppick/2026-11-06_10-47-23/model_38500.pt | 2.2 h | 59 % | 69 % · 60 % · 64 % · 52 % | 51 % | 8 % | 2141 | 0.80 → 0.80 | 성공률 최고 구간 = 반복 40300 ~ 40599 (마지막 아님) -> 그 근처 체크포인트도 평가 | <!-- train:logs/rsl_rl/waffle_toppick/2026-11-08_17-33-38 -->
| 2026-11-10 06:00 | `logs/rsl_rl/waffle_toppick/2026-11-09_22-14-33` | Waffle-TopPick-Direct | 256 | 60299 / 20000 | logs/rsl_rl/waffle_toppick/2026-11-08_17-33-38/model_40300.pt | 7.8 h | 50 % | 62 % · 51 % · 51 % · 43 % | 44 % | 9 % | 1835 | 0.80 → 0.80 | - | <!-- train:logs/rsl_rl/waffle_toppick/2026-11-09_22-14-33 -->
| 2026-11-11 09:38 | `logs/rsl_rl/waffle_toppick/2026-11-10_22-25-34` | Waffle-TopPick-Direct | 256 | 87249 / 28000 | logs/rsl_rl/waffle_toppick/2026-11-09_22-14-33/model_59250.pt | 11.2 h | 53 % | 61 % · 53 % · 58 % · 46 % | 46 % | 9 % | 1962 | 0.80 → 0.80 | 성공률 최고 구간 = 반복 76050 ~ 78849 (마지막 아님) -> 그 근처 체크포인트도 평가 | <!-- train:logs/rsl_rl/waffle_toppick/2026-11-10_22-25-34 -->
| 2026-11-12 00:01 | `logs/rsl_rl/waffle_toppick/2026-11-11_12-39-26` | Waffle-TopPick-Direct | 256 | 106249 / 28000 | logs/rsl_rl/waffle_toppick/2026-11-10_22-25-34/model_78250.pt | 11.4 h | 61 % | 75 % · 63 % · 68 % · 52 % | 54 % | 11 % | 2087 | 0.80 → 0.80 | 성공률 최고 구간 = 반복 78250 ~ 81049 (마지막 아님) -> 그 근처 체크포인트도 평가 | <!-- train:logs/rsl_rl/waffle_toppick/2026-11-11_12-39-26 -->
| 2026-11-12 06:12 | `logs/rsl_rl/waffle_toppick/2026-11-12_00-26-11` | Waffle-TopPick-Direct | 256 | 97249 / 14500 | logs/rsl_rl/waffle_toppick/2026-11-11_12-39-26/model_82750.pt | 5.8 h | 68 % | 77 % · 70 % · 69 % · 62 % | 58 % | 10 % | 2248 | 0.80 → 0.80 | 성공률 최고 구간 = 반복 90000 ~ 91449 (마지막 아님) -> 그 근처 체크포인트도 평가 | <!-- train:logs/rsl_rl/waffle_toppick/2026-11-12_00-26-11 -->
| 2026-11-13 04:58 | `logs/rsl_rl/waffle_toppick/2026-11-12_19-52-40` | Waffle-TopPick-Direct | 256 | 112749 / 22000 | logs/rsl_rl/waffle_toppick/2026-11-12_00-26-11/model_90750.pt | 9.1 h | 65 % | 77 % · 65 % · 64 % · 59 % | 56 % | 8 % | 2152 | 0.80 → 0.80 | 성공률 최고 구간 = 반복 90750 ~ 92949 (마지막 아님) -> 그 근처 체크포인트도 평가 | <!-- train:logs/rsl_rl/waffle_toppick/2026-11-12_19-52-40 -->
