developlcy-oss/Lv2_Cartlidar_Assignment/workspace/urdf_and_usd/docs/puck_plate_placement/1_before_after.png

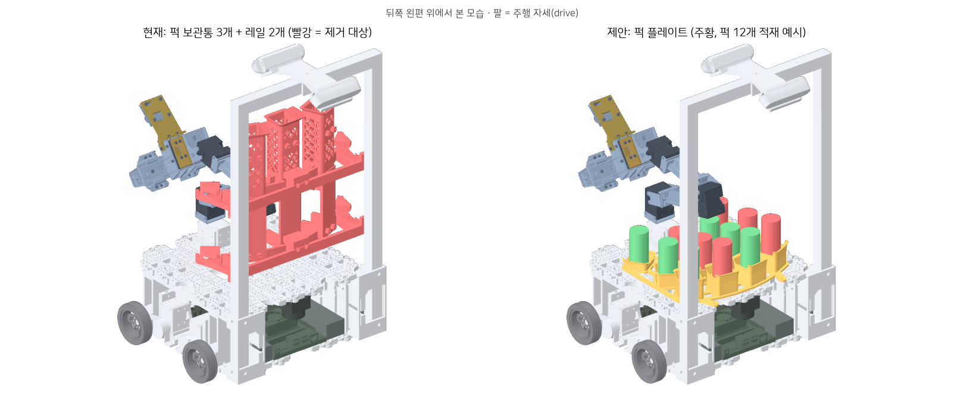
workspace/urdf_and_usd/docs/puck_plate_placement/1_before_after.png
