developlcy-oss/Lv2_Cartlidar_Assignment/workspace/urdf_and_usd/docs/puck_plate_placement/2_top_view.png

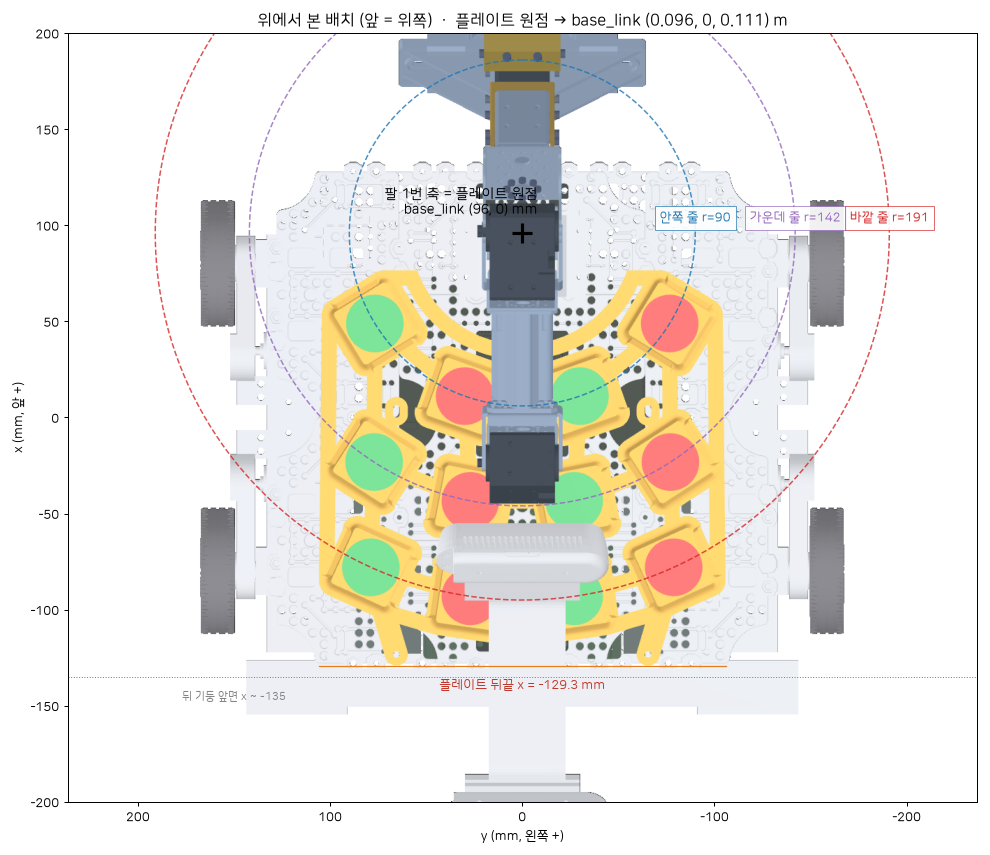
workspace/urdf_and_usd/docs/puck_plate_placement/2_top_view.png
