developlcy-oss/Lv2_Cartlidar_Assignment/workspace/urdf_and_usd/docs/puck_plate_placement/3_side_view.png

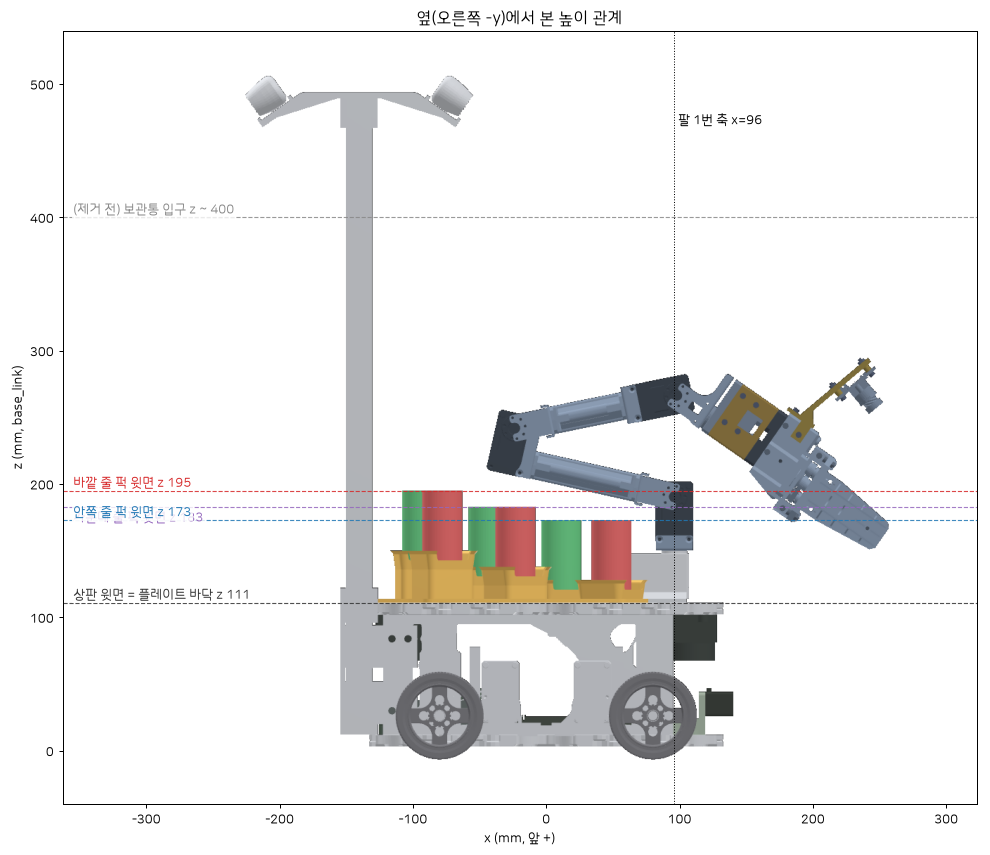
workspace/urdf_and_usd/docs/puck_plate_placement/3_side_view.png
