developlcy-oss/Lv2_Cartlidar_Assignment/workspace/urdf_and_usd/docs/puck_plate_placement/4_final_urdf.png

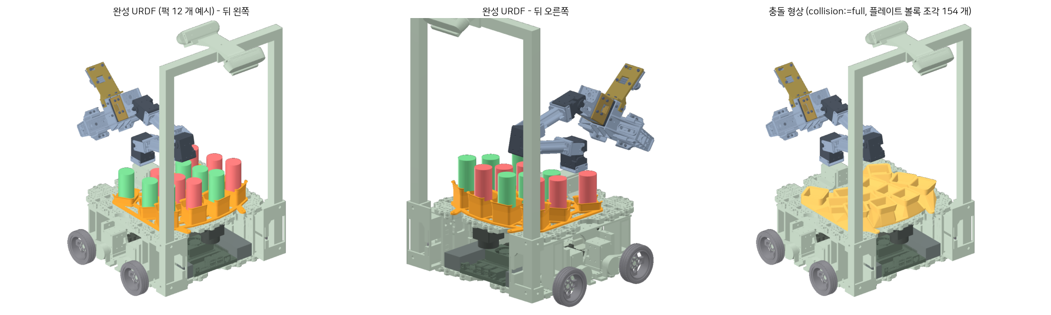
workspace/urdf_and_usd/docs/puck_plate_placement/4_final_urdf.png
