developlcy-oss/Lv2_Cartlidar_Assignment/workspace/urdf_and_usd/docs/puck_plate_placement/5_maze_start.png

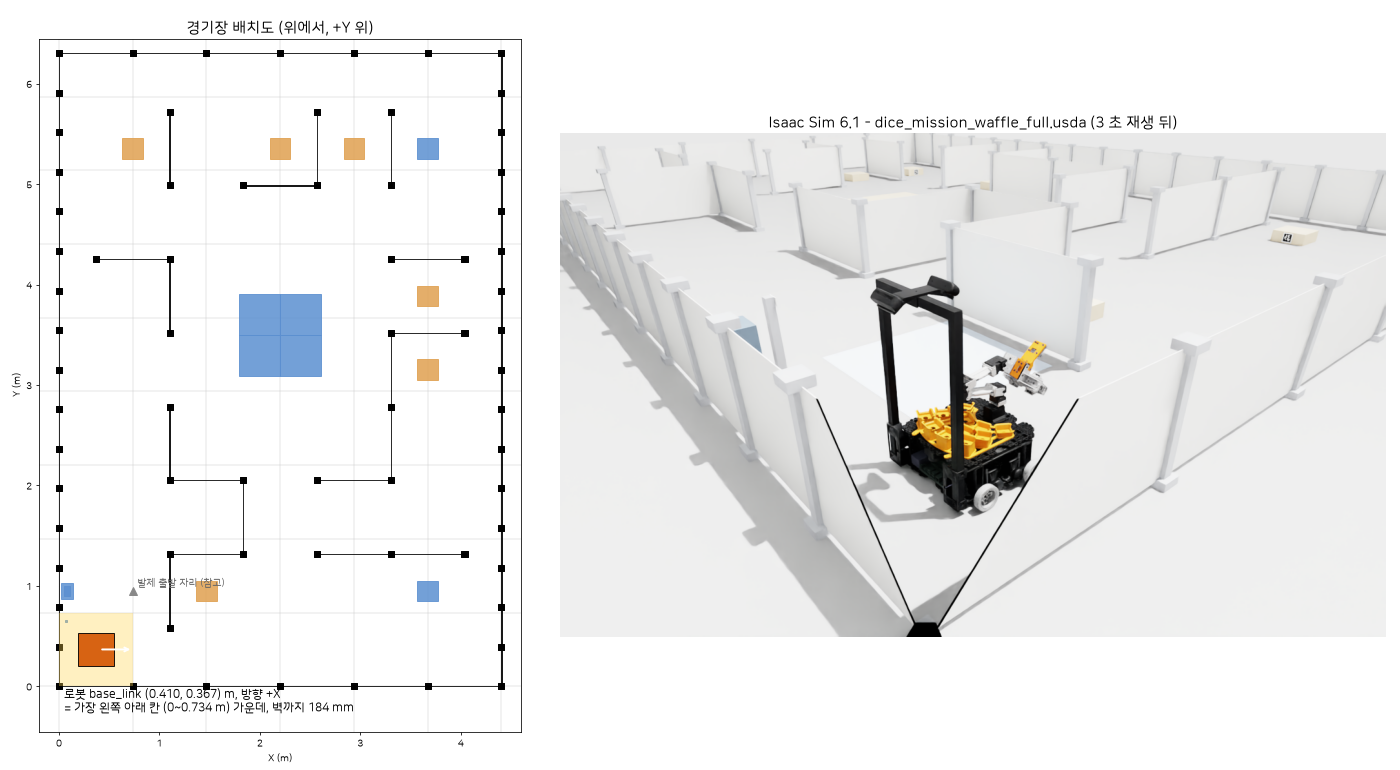
workspace/urdf_and_usd/docs/puck_plate_placement/5_maze_start.png
