developlcy-oss/Lv2_Cartlidar_Assignment/workspace/tools/arm_bench/urdf/meshes/link1_0.stl

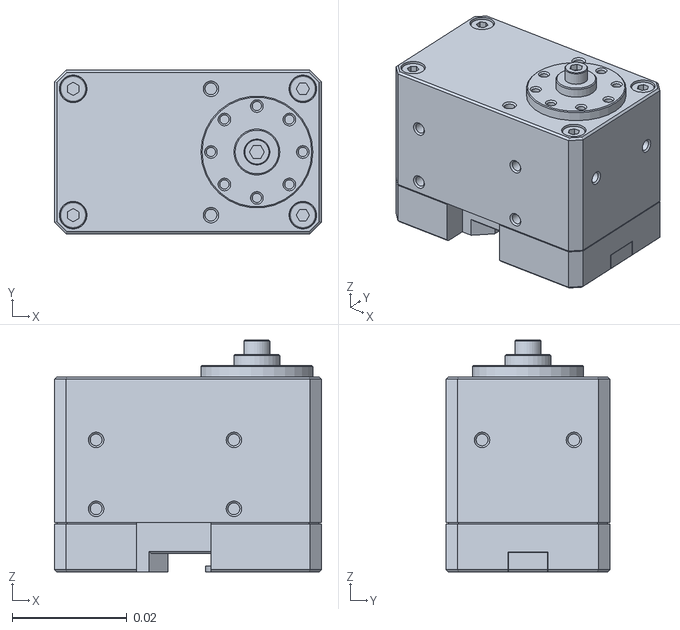
[picture p6: CAD file, 2026-10-27]
workspace/tools/arm_bench/urdf/meshes/link1_0.stl
0.0465 x 0.0285 x 0.0404
