developlcy-oss/Lv2_Cartlidar_Assignment/workspace/urdf_and_usd/waffle_4wd_description/meshes/b/belt_guard.stl

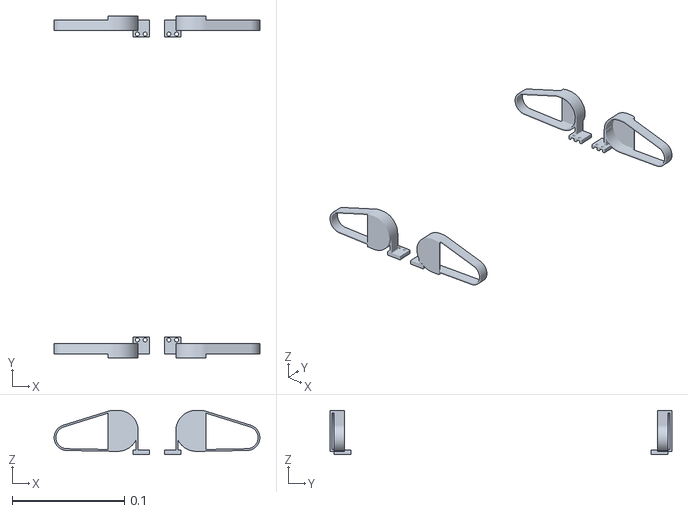
[picture p7: CAD file, 2026-11-14]
workspace/urdf_and_usd/waffle_4wd_description/meshes/b/belt_guard.stl
0.183 x 0.304 x 0.0395
