developlcy-oss/Lv2_Cartlidar_Assignment/workspace/urdf_and_usd/waffle_4wd_description/meshes/b/collision/pallet_cup1_hull04.stl

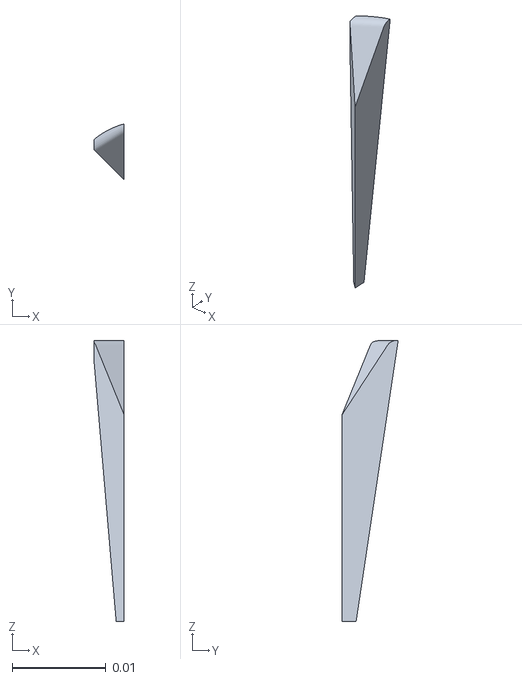
[picture p8: CAD file, 2026-11-14]
workspace/urdf_and_usd/waffle_4wd_description/meshes/b/collision/pallet_cup1_hull04.stl
0.00325 x 0.00602 x 0.03
