developlcy-oss/Lv2_Cartlidar_Assignment/workspace/urdf_and_usd/waffle_4wd_description_261028/meshes/arm/link5_0.stl

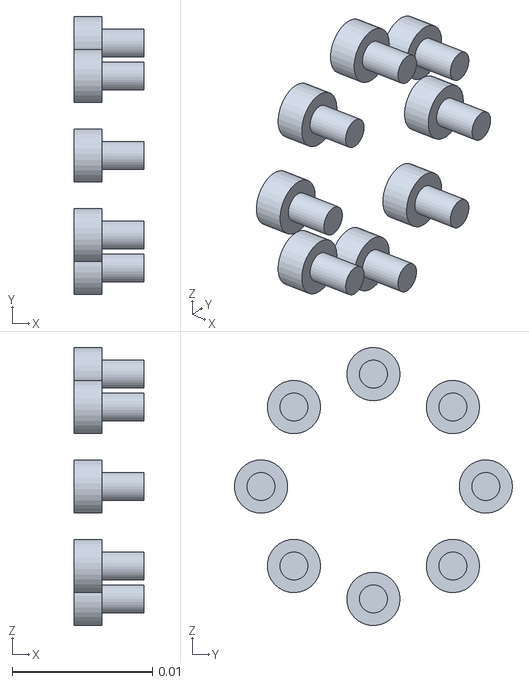
[picture p9: CAD file, 2026-10-27]
workspace/urdf_and_usd/waffle_4wd_description_261028/meshes/arm/link5_0.stl
0.005 x 0.0198 x 0.0198
