developlcy-oss/Lv2_Cartlidar_Assignment/workspace/urdf_and_usd/waffle_4wd_description_261028/meshes/collision/base_link_part157_hull00.stl

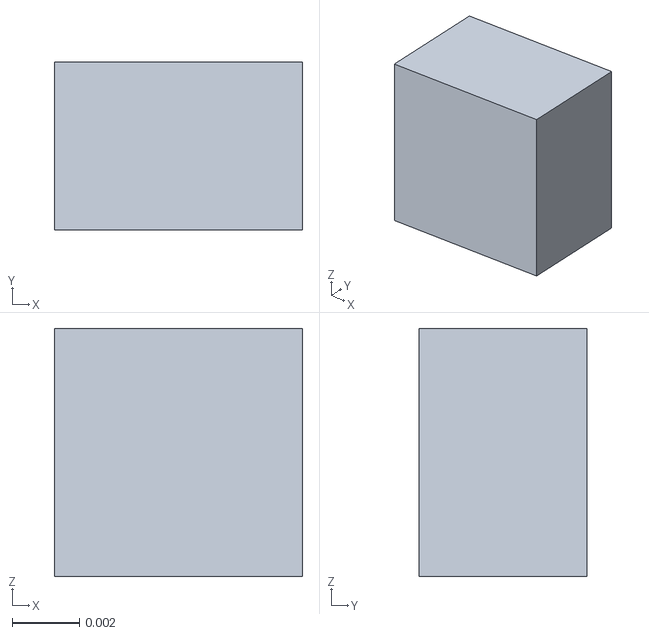
[picture p10: CAD file, 2026-10-30]
workspace/urdf_and_usd/waffle_4wd_description_261028/meshes/collision/base_link_part157_hull00.stl
0.0074 x 0.005 x 0.0074
