developlcy-oss/Lv2_Cartlidar_Assignment/workspace/urdf_and_usd/waffle_4wd_description_261028/meshes/main/opencr_right.stl

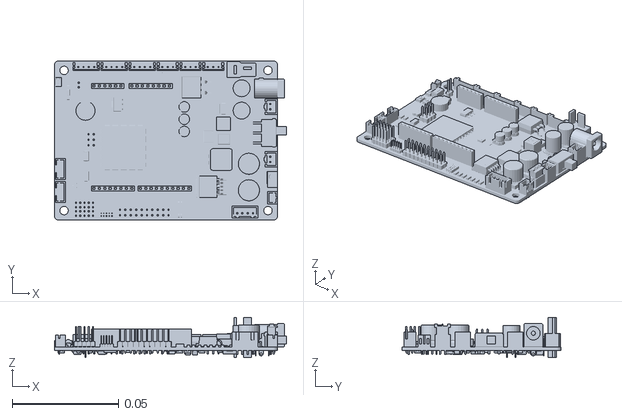
[picture p11: CAD file, 2026-10-30]
workspace/urdf_and_usd/waffle_4wd_description_261028/meshes/main/opencr_right.stl
0.109 x 0.075 x 0.019
