developlcy-oss/Lv2_Cartlidar_Assignment/workspace/urdf_and_usd/waffle_4wd_description_261028/meshes/parts/puck_plate_col/cup_095.stl

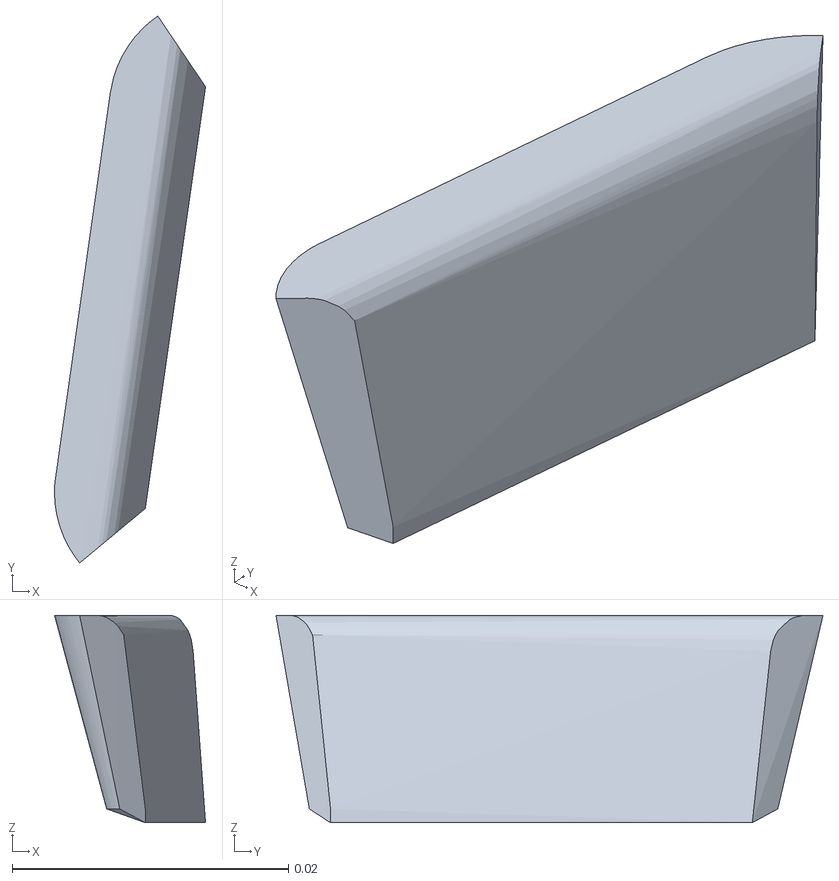
[picture p12: CAD file, 2026-10-30]
workspace/urdf_and_usd/waffle_4wd_description_261028/meshes/parts/puck_plate_col/cup_095.stl
0.0109 x 0.0396 x 0.015
