developlcy-oss/Lv2_Cartlidar_Assignment/workspace/urdf_and_usd/waffle_4wd_description_261028/meshes/parts/tfmini_plus_bracket_v2.stl

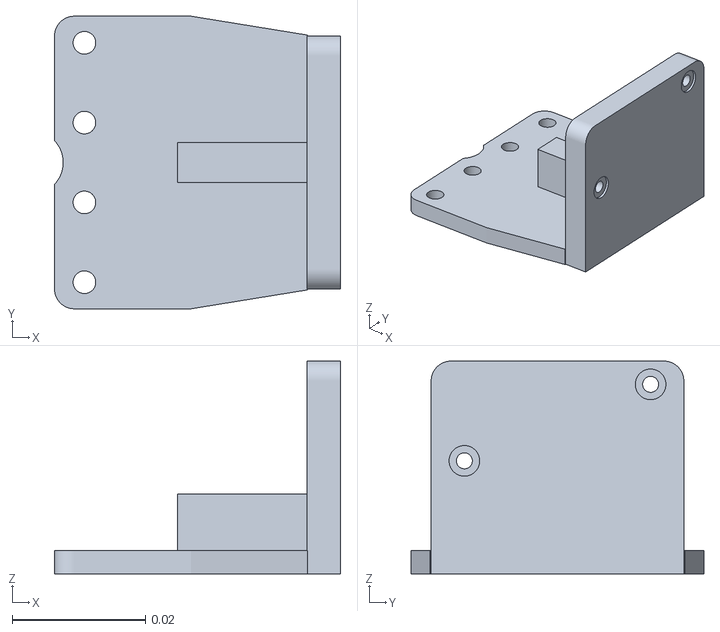
[picture p13: CAD file, 2026-10-30]
workspace/urdf_and_usd/waffle_4wd_description_261028/meshes/parts/tfmini_plus_bracket_v2.stl
0.043 x 0.044 x 0.032
