developlcy-oss/Lv2_Cartlidar_Assignment/workspace/urdf_and_usd/waffle_4wd_description_261028/meshes/puck_pallet.stl

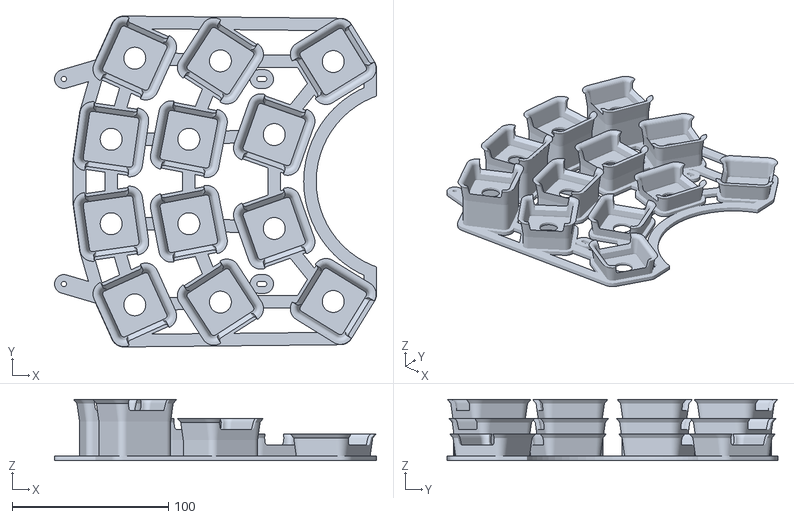
[picture p14: CAD file, 2026-10-30]
workspace/urdf_and_usd/waffle_4wd_description_261028/meshes/puck_pallet.stl
205.8 x 211.5 x 39.0
