developlcy-oss/Lv2_Cartlidar_Assignment/workspace/urdf_and_usd/waffle_4wd_description/meshes/b/brackets.stl

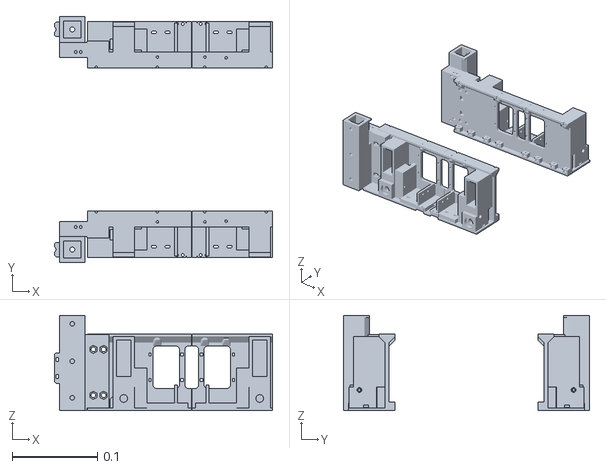
[picture p15: CAD file, 2026-11-14]
workspace/urdf_and_usd/waffle_4wd_description/meshes/b/brackets.stl
0.257 x 0.289 x 0.112
