developlcy-oss/Lv2_Cartlidar_Assignment/workspace/urdf_and_usd/waffle_4wd_description/meshes/b/collision/pallet_cup1_hull19.stl

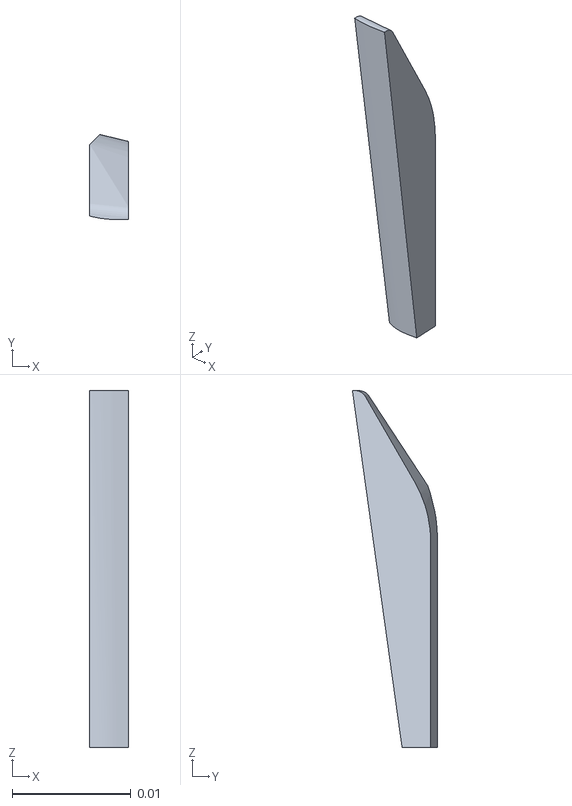
[picture p16: CAD file, 2026-11-14]
workspace/urdf_and_usd/waffle_4wd_description/meshes/b/collision/pallet_cup1_hull19.stl
0.00325 x 0.00716 x 0.03
