developlcy-oss/Lv2_Cartlidar_Assignment/workspace/urdf_and_usd/waffle_4wd_description_261028/meshes/arm/gripper_link_6.stl

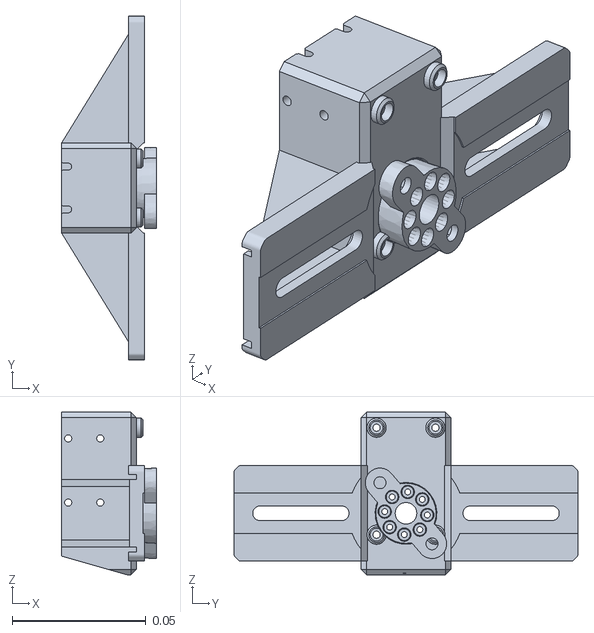
[picture p17: CAD file, 2026-10-27]
workspace/urdf_and_usd/waffle_4wd_description_261028/meshes/arm/gripper_link_6.stl
0.0355 x 0.129 x 0.0608
