developlcy-oss/Lv2_Cartlidar_Assignment/workspace/urdf_and_usd/waffle_4wd_description_261028/meshes/collision/base_link_part157_hull15.stl

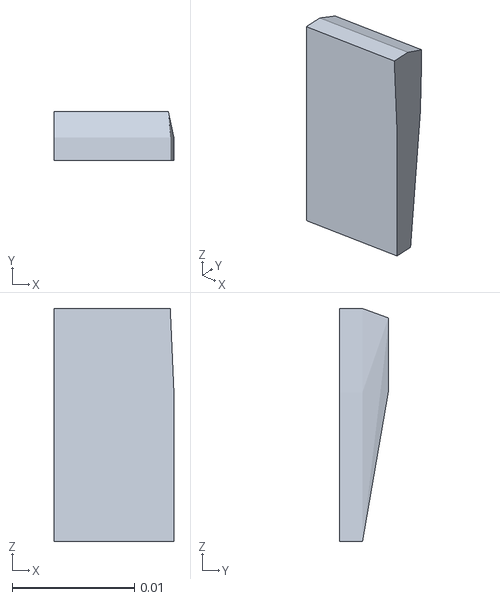
[picture p18: CAD file, 2026-10-30]
workspace/urdf_and_usd/waffle_4wd_description_261028/meshes/collision/base_link_part157_hull15.stl
0.00982 x 0.004 x 0.0191
