developlcy-oss/Lv2_Cartlidar_Assignment/workspace/urdf_and_usd/waffle_4wd_description_261028/meshes/parts/lds03.stl

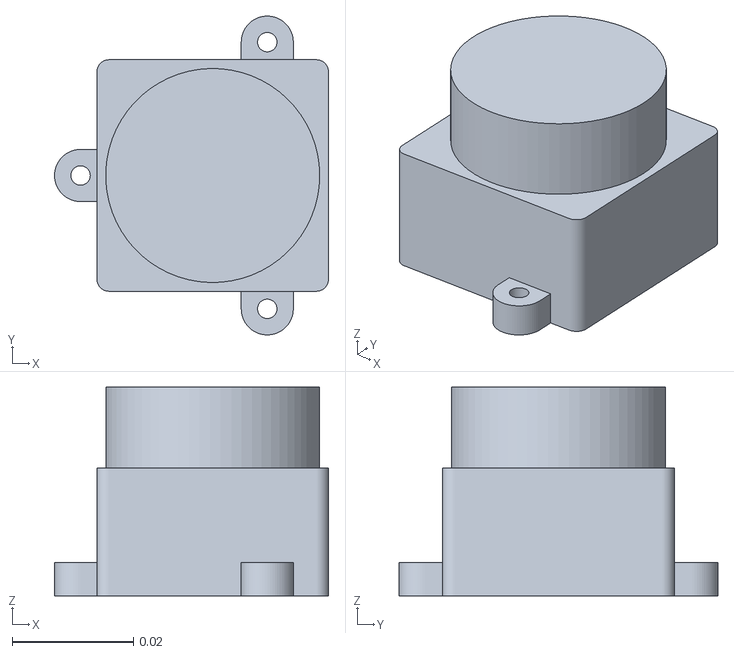
[picture p19: CAD file, 2026-10-30]
workspace/urdf_and_usd/waffle_4wd_description_261028/meshes/parts/lds03.stl
0.0452 x 0.0526 x 0.0344
