developlcy-oss/Lv2_Cartlidar_Assignment/workspace/urdf_and_usd/waffle_4wd_description_261028/meshes/parts/puck_plate_col/cup_086.stl

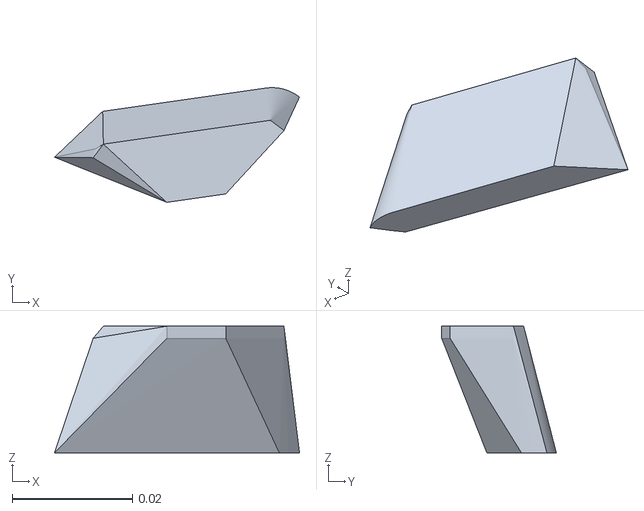
[picture p20: CAD file, 2026-10-30]
workspace/urdf_and_usd/waffle_4wd_description_261028/meshes/parts/puck_plate_col/cup_086.stl
0.0407 x 0.019 x 0.021
