developlcy-oss/Lv2_Cartlidar_Assignment/workspace/urdf_and_usd/waffle_4wd_description/meshes/b/collision/pallet_cup1_hull21.stl

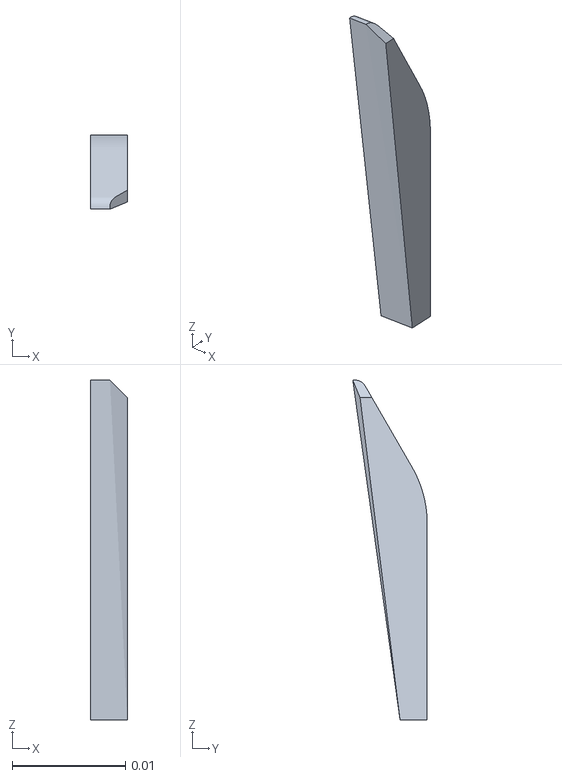
[picture p21: CAD file, 2026-11-14]
workspace/urdf_and_usd/waffle_4wd_description/meshes/b/collision/pallet_cup1_hull21.stl
0.00325 x 0.00657 x 0.03
