developlcy-oss/Lv2_Cartlidar_Assignment/workspace/urdf_and_usd/waffle_4wd_description/meshes/b/tfmini_holder.stl

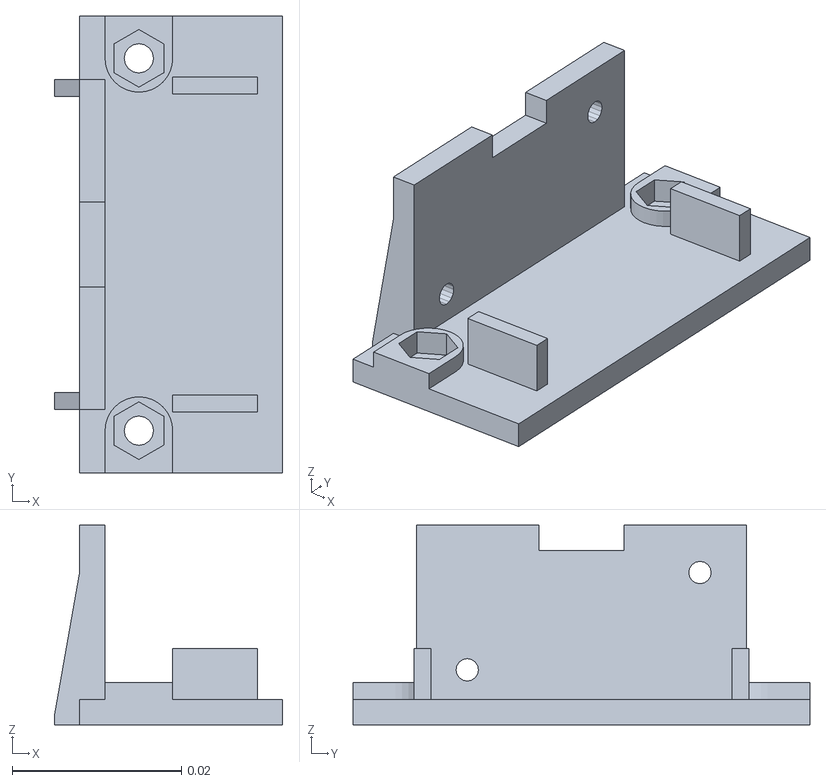
[picture p22: CAD file, 2026-11-14]
workspace/urdf_and_usd/waffle_4wd_description/meshes/b/tfmini_holder.stl
0.027 x 0.054 x 0.0236
