developlcy-oss/Lv2_Cartlidar_Assignment/workspace/urdf_and_usd/waffle_4wd_description_261028/meshes/arm/gripper_link_3.stl

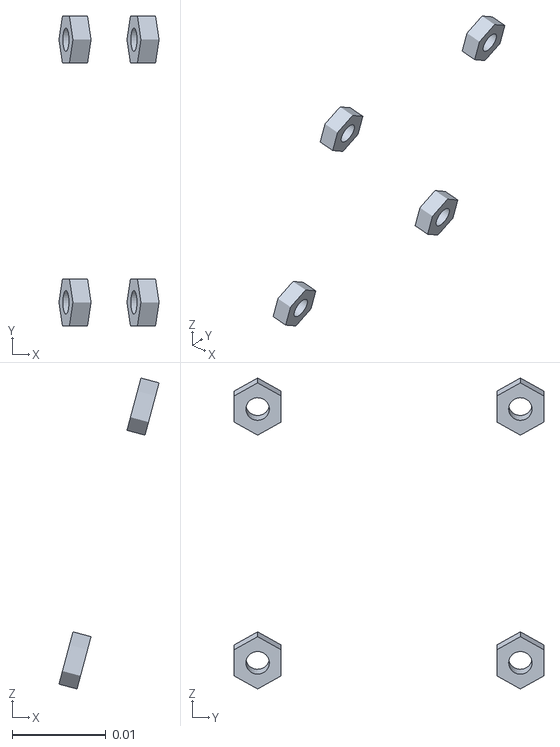
[picture p23: CAD file, 2026-10-27]
workspace/urdf_and_usd/waffle_4wd_description_261028/meshes/arm/gripper_link_3.stl
0.0107 x 0.033 x 0.0331
