developlcy-oss/Lv2_Cartlidar_Assignment/workspace/urdf_and_usd/waffle_4wd_description_261028/meshes/collision/base_link_part157_hull03.stl

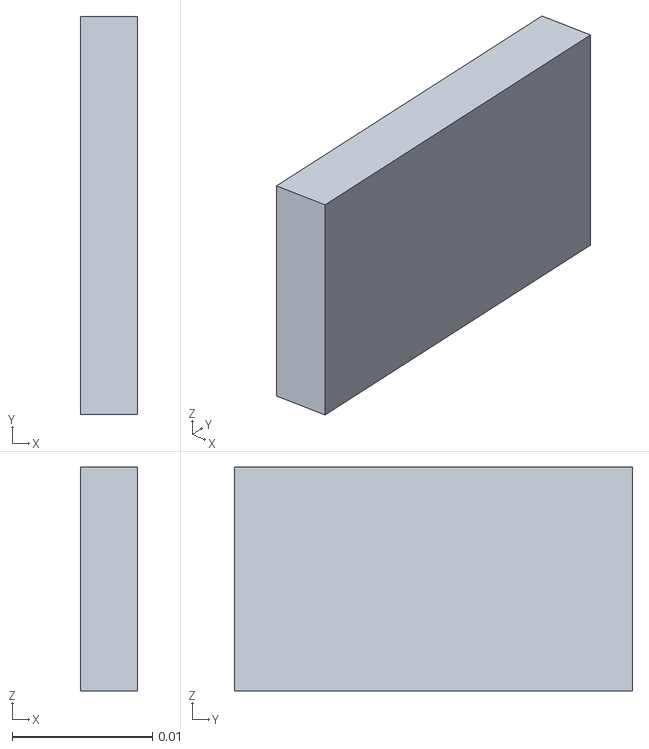
[picture p24: CAD file, 2026-10-30]
workspace/urdf_and_usd/waffle_4wd_description_261028/meshes/collision/base_link_part157_hull03.stl
0.00406 x 0.0284 x 0.016
