developlcy-oss/Lv2_Cartlidar_Assignment/workspace/urdf_and_usd/waffle_4wd_description_261028/meshes/parts/jetson_orin_nano.stl

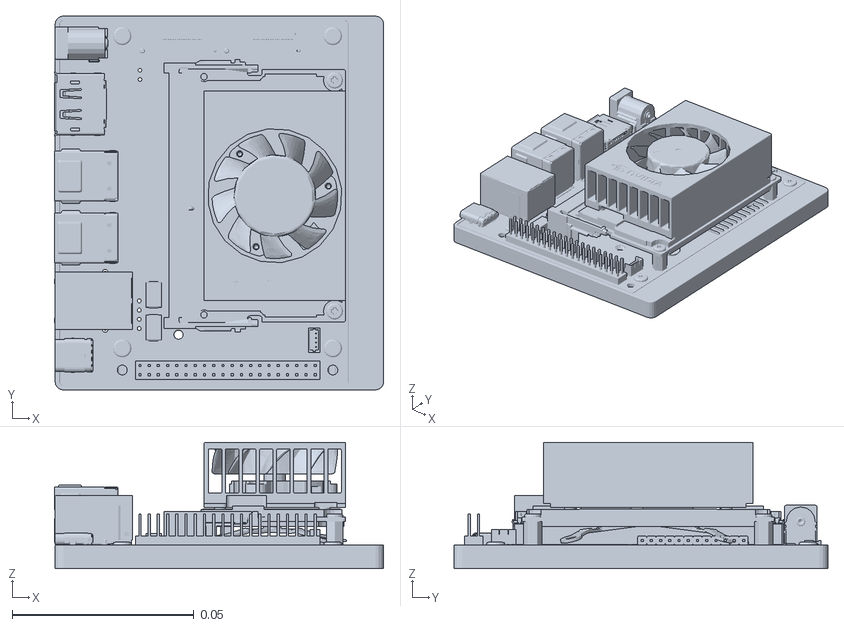
[picture p25: CAD file, 2026-10-30]
workspace/urdf_and_usd/waffle_4wd_description_261028/meshes/parts/jetson_orin_nano.stl
0.0907 x 0.103 x 0.0348
