developlcy-oss/Lv2_Cartlidar_Assignment/workspace/urdf_and_usd/waffle_4wd_description_261028/meshes/parts/puck_plate_col/plate_064.stl

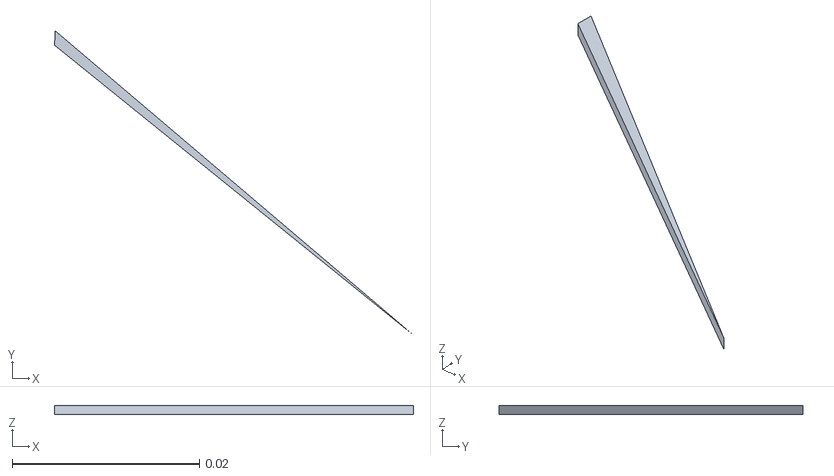
[picture p26: CAD file, 2026-10-30]
workspace/urdf_and_usd/waffle_4wd_description_261028/meshes/parts/puck_plate_col/plate_064.stl
0.0383 x 0.0325 x 0.001
