developlcy-oss/Lv2_Cartlidar_Assignment/workspace/urdf_and_usd/waffle_4wd_description/meshes/b/belt_belt.stl

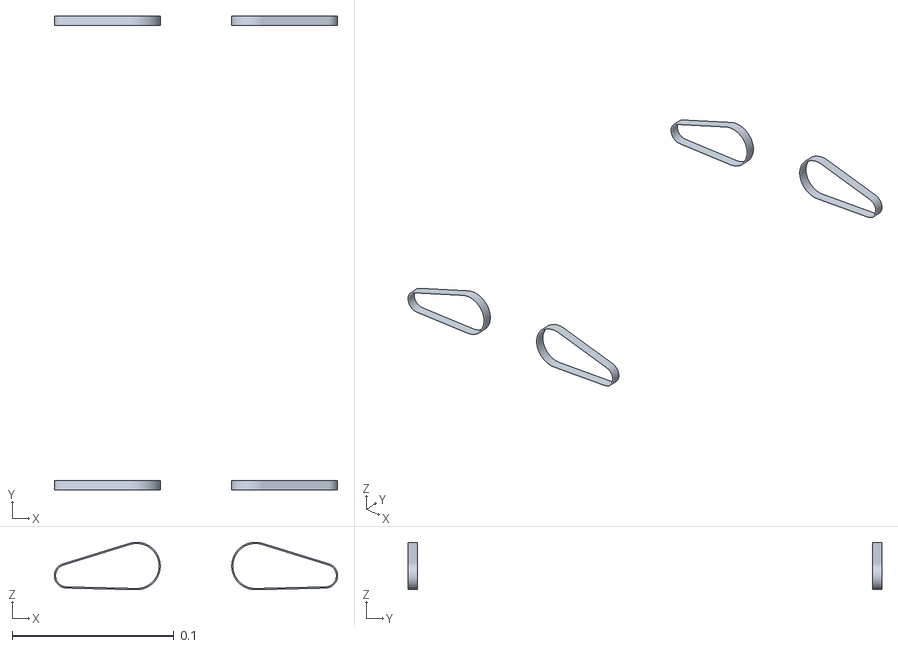
[picture p27: CAD file, 2026-11-14]
workspace/urdf_and_usd/waffle_4wd_description/meshes/b/belt_belt.stl
0.175 x 0.294 x 0.0294
