developlcy-oss/Lv2_Cartlidar_Assignment/workspace/urdf_and_usd/waffle_4wd_description/meshes/b/collision/corner_FL_hull24.stl

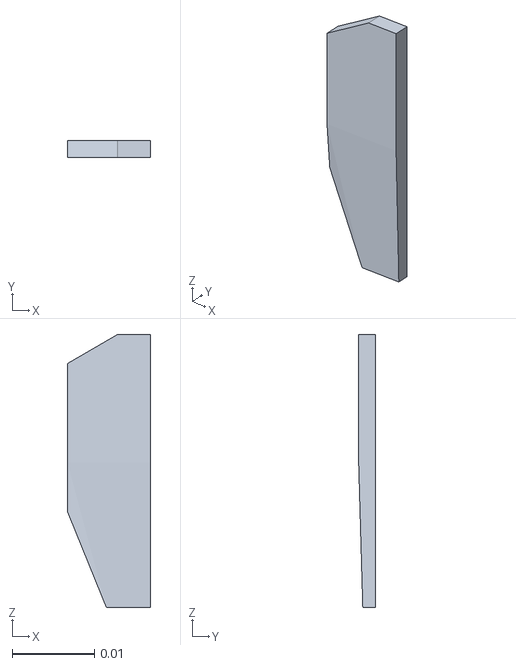
[picture p28: CAD file, 2026-11-14]
workspace/urdf_and_usd/waffle_4wd_description/meshes/b/collision/corner_FL_hull24.stl
0.0101 x 0.00203 x 0.0331
