developlcy-oss/Lv2_Cartlidar_Assignment/workspace/urdf_and_usd/waffle_4wd_description_261028/meshes/arm/gripper_link_4.stl

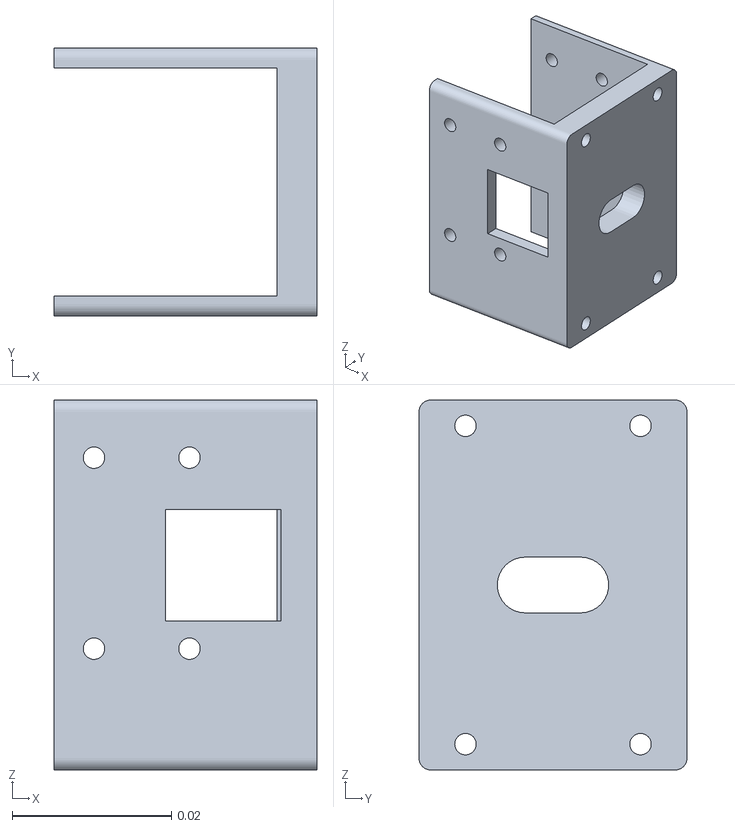
[picture p29: CAD file, 2026-10-27]
workspace/urdf_and_usd/waffle_4wd_description_261028/meshes/arm/gripper_link_4.stl
0.033 x 0.0337 x 0.0465
