developlcy-oss/Lv2_Cartlidar_Assignment/workspace/urdf_and_usd/waffle_4wd_description_261028/meshes/parts/puck_plate_col/cup_080.stl

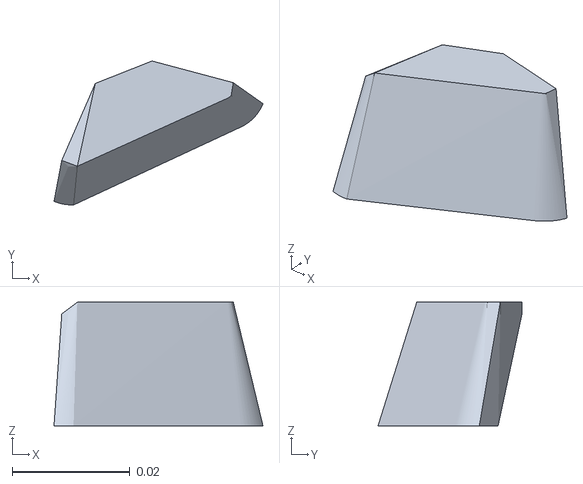
[picture p32: CAD file, 2026-10-30]
workspace/urdf_and_usd/waffle_4wd_description_261028/meshes/parts/puck_plate_col/cup_080.stl
0.0355 x 0.0245 x 0.021
