developlcy-oss/Lv2_Cartlidar_Assignment/workspace/urdf_and_usd/waffle_4wd_description/meshes/b/belt_metal.stl

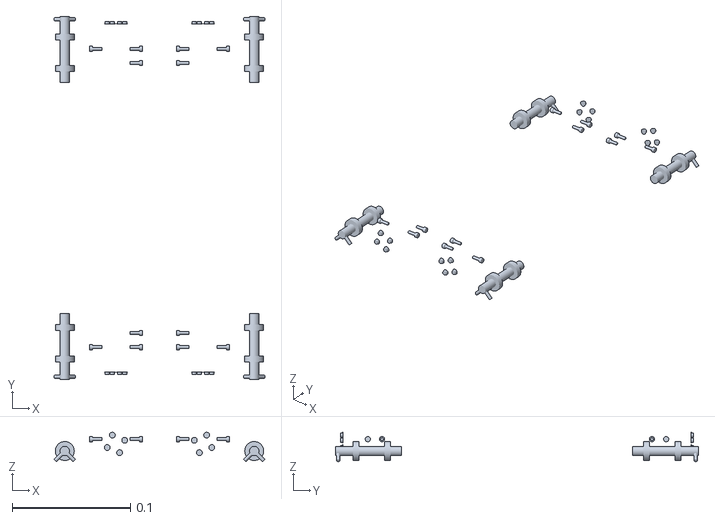
[picture p33: CAD file, 2026-11-14]
workspace/urdf_and_usd/waffle_4wd_description/meshes/b/belt_metal.stl
0.178 x 0.307 x 0.025
