developlcy-oss/Lv2_Cartlidar_Assignment/workspace/urdf_and_usd/waffle_4wd_description/meshes/b/collision/corner_FR_hull28.stl

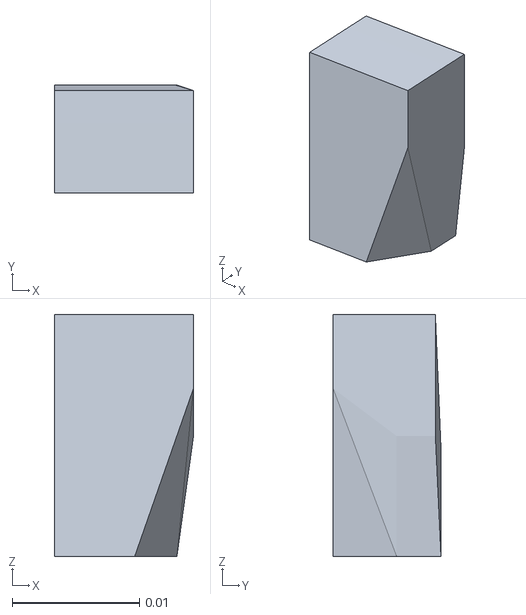
[picture p34: CAD file, 2026-11-14]
workspace/urdf_and_usd/waffle_4wd_description/meshes/b/collision/corner_FR_hull28.stl
0.0109 x 0.00847 x 0.019
