developlcy-oss/Lv2_Cartlidar_Assignment/workspace/urdf_and_usd/waffle_4wd_description_261028/meshes/arm/gripper_left_link_1.stl

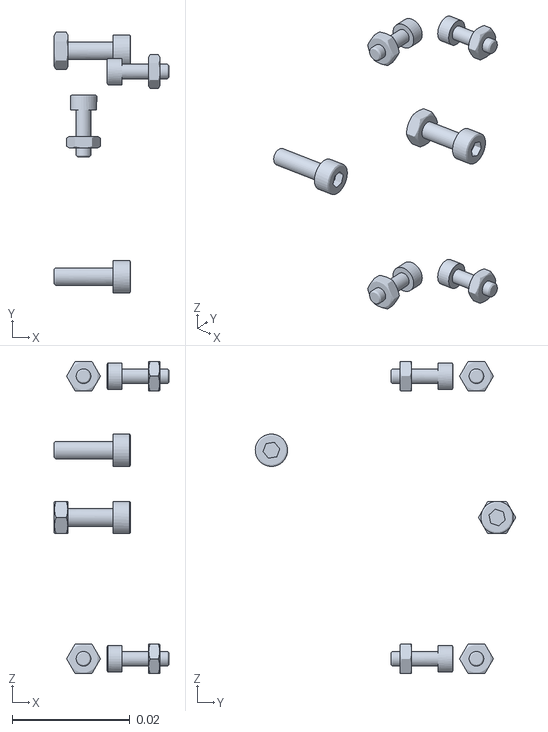
[picture p35: CAD file, 2026-10-27]
workspace/urdf_and_usd/waffle_4wd_description_261028/meshes/arm/gripper_left_link_1.stl
0.0195 x 0.0443 x 0.053
