developlcy-oss/Lv2_Cartlidar_Assignment/workspace/urdf_and_usd/waffle_4wd_description_261028/meshes/collision/base_link_part176_hull13.stl

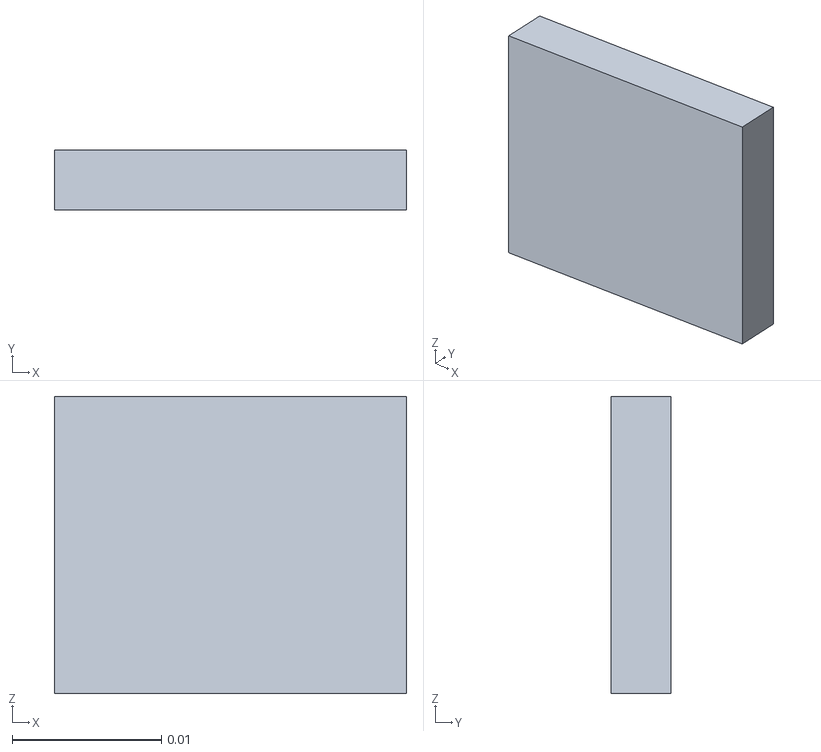
[picture p36: CAD file, 2026-10-30]
workspace/urdf_and_usd/waffle_4wd_description_261028/meshes/collision/base_link_part176_hull13.stl
0.0236 x 0.00401 x 0.0199
