developlcy-oss/Lv2_Cartlidar_Assignment/workspace/urdf_and_usd/waffle_4wd_description/meshes/b/collision/corner_RR_hull31.stl

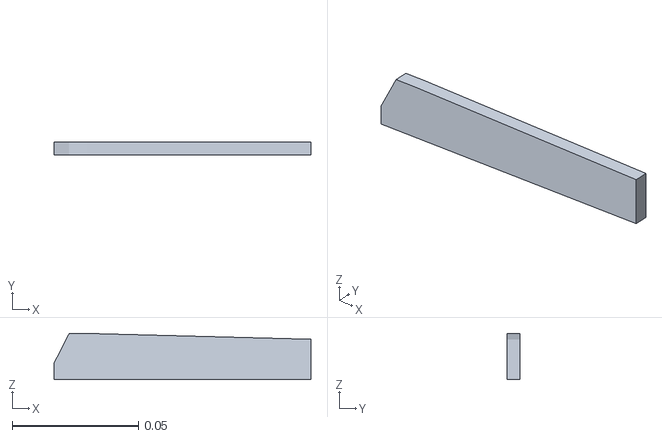
[picture p39: CAD file, 2026-11-14]
workspace/urdf_and_usd/waffle_4wd_description/meshes/b/collision/corner_RR_hull31.stl
0.102 x 0.005 x 0.0183
