developlcy-oss/Lv2_Cartlidar_Assignment/workspace/urdf_and_usd/waffle_4wd_description/meshes/b/lidar_brackets.stl

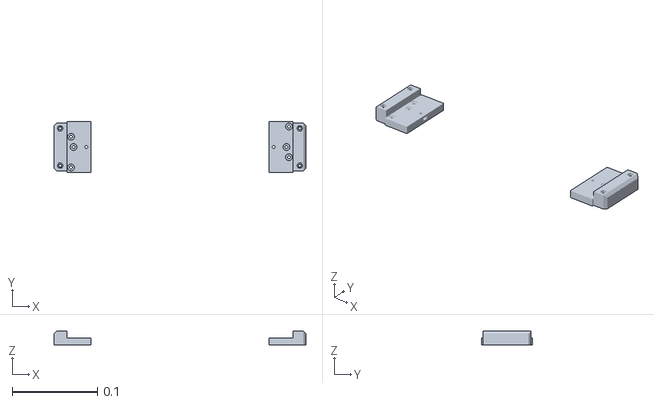
[picture p40: CAD file, 2026-11-14]
workspace/urdf_and_usd/waffle_4wd_description/meshes/b/lidar_brackets.stl
0.296 x 0.06 x 0.016
