developlcy-oss/Lv2_Cartlidar_Assignment/workspace/urdf_and_usd/waffle_4wd_description/meshes/b/collision/pallet_cup0_hull30.stl

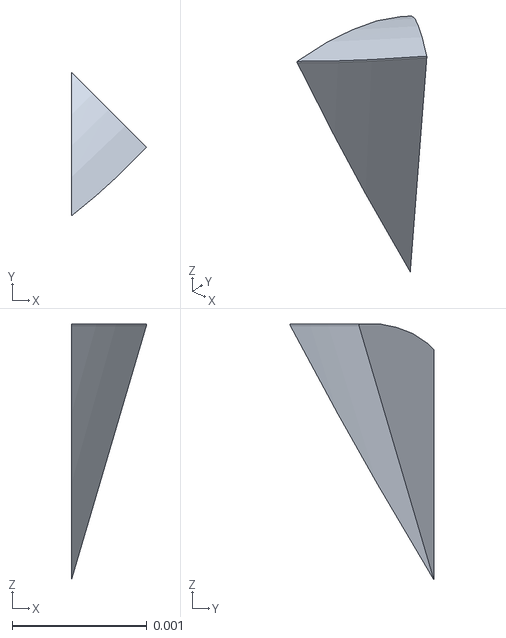
[picture p44: CAD file, 2026-11-14]
workspace/urdf_and_usd/waffle_4wd_description/meshes/b/collision/pallet_cup0_hull30.stl
0.000557 x 0.00107 x 0.0019
