developlcy-oss/Lv2_Cartlidar_Assignment/workspace/urdf_and_usd/waffle_4wd_description/meshes/b/motors.stl

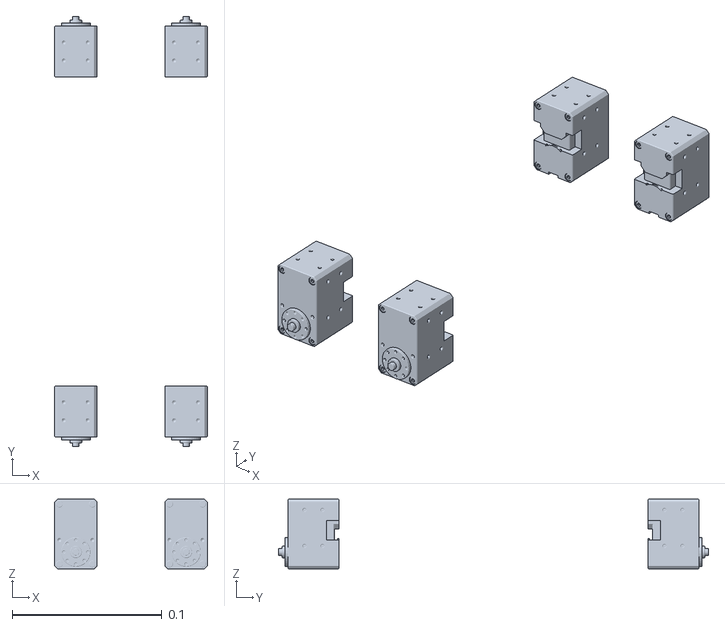
[picture p45: CAD file, 2026-11-14]
workspace/urdf_and_usd/waffle_4wd_description/meshes/b/motors.stl
0.102 x 0.287 x 0.0465
