developlcy-oss/Lv2_Cartlidar_Assignment/workspace/urdf_and_usd/waffle_4wd_description_261028/meshes/arm/gripper_link_2.stl

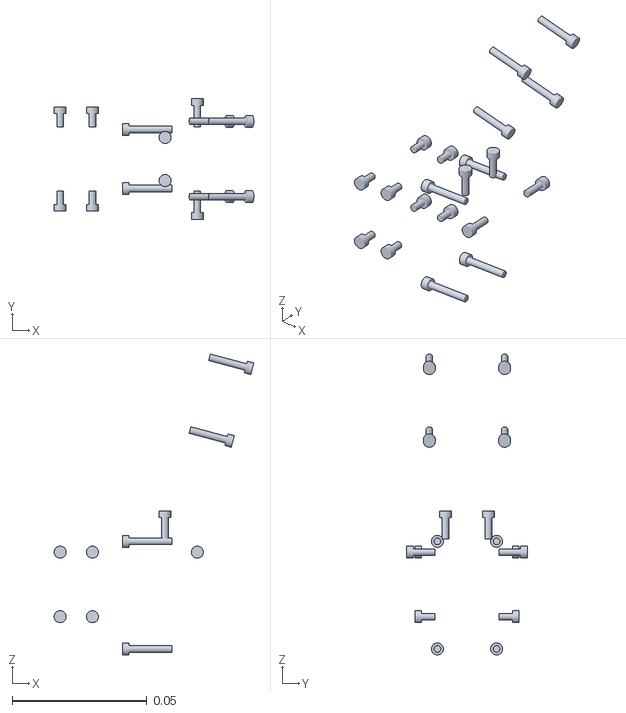
[picture p46: CAD file, 2026-10-27]
workspace/urdf_and_usd/waffle_4wd_description_261028/meshes/arm/gripper_link_2.stl
0.0743 x 0.0448 x 0.112
