developlcy-oss/Lv2_Cartlidar_Assignment/workspace/urdf_and_usd/waffle_4wd_description/meshes/b/belt_printed.stl

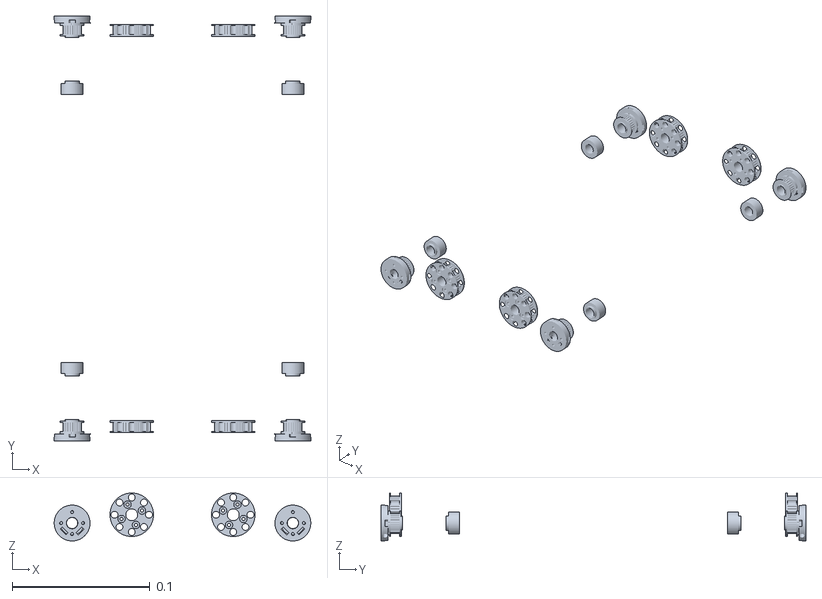
[picture p49: CAD file, 2026-11-14]
workspace/urdf_and_usd/waffle_4wd_description/meshes/b/belt_printed.stl
0.186 x 0.308 x 0.0348
