developlcy-oss/Lv2_Cartlidar_Assignment/workspace/urdf_and_usd/waffle_4wd_description/meshes/b/collision/corner_FR_hull13.stl

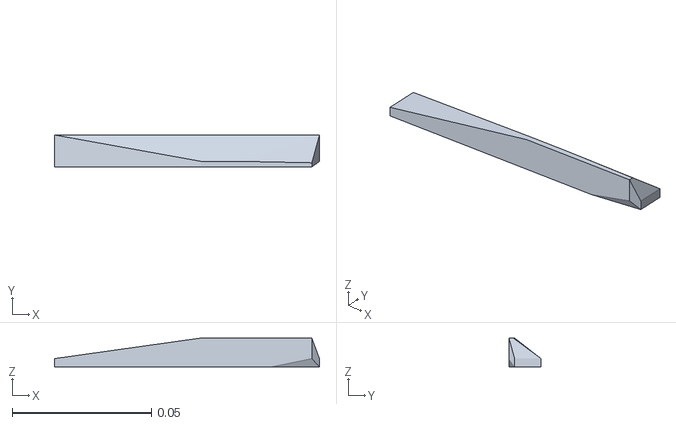
[picture p50: CAD file, 2026-11-14]
workspace/urdf_and_usd/waffle_4wd_description/meshes/b/collision/corner_FR_hull13.stl
0.0951 x 0.0115 x 0.0104
