developlcy-oss/Lv2_Cartlidar_Assignment/workspace/urdf_and_usd/waffle_4wd_description/meshes/b/collision/pallet_cup2_hull25.stl

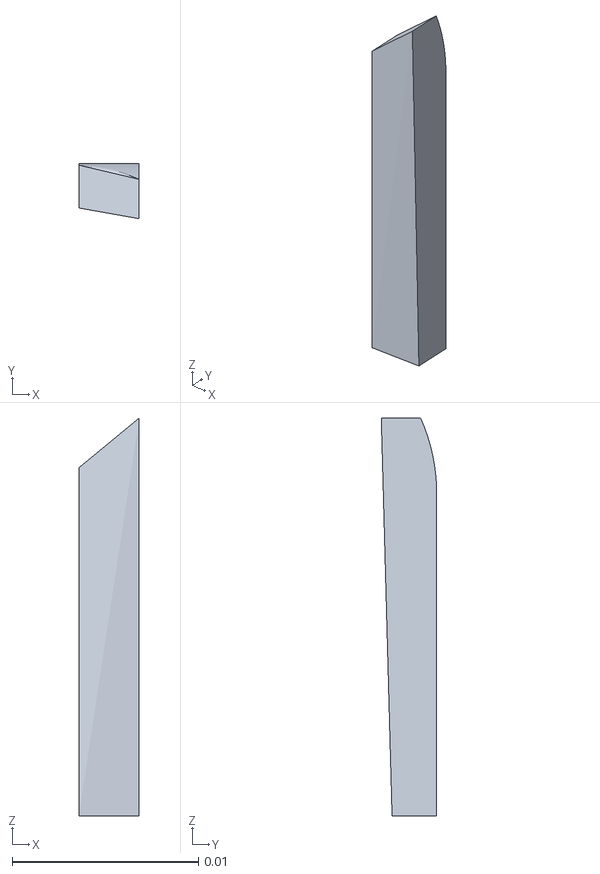
[picture p54: CAD file, 2026-11-14]
workspace/urdf_and_usd/waffle_4wd_description/meshes/b/collision/pallet_cup2_hull25.stl
0.00325 x 0.00298 x 0.0214
