developlcy-oss/Lv2_Cartlidar_Assignment/workspace/urdf_and_usd/waffle_4wd_description/meshes/b/deck_tray.stl

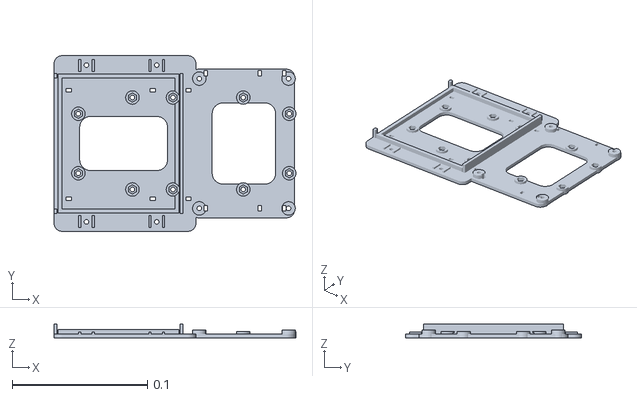
[picture p55: CAD file, 2026-11-14]
workspace/urdf_and_usd/waffle_4wd_description/meshes/b/deck_tray.stl
0.179 x 0.13 x 0.0105
