developlcy-oss/Lv2_Cartlidar_Assignment/workspace/urdf_and_usd/waffle_4wd_description/meshes/b/collision/corner_FR_hull03.stl

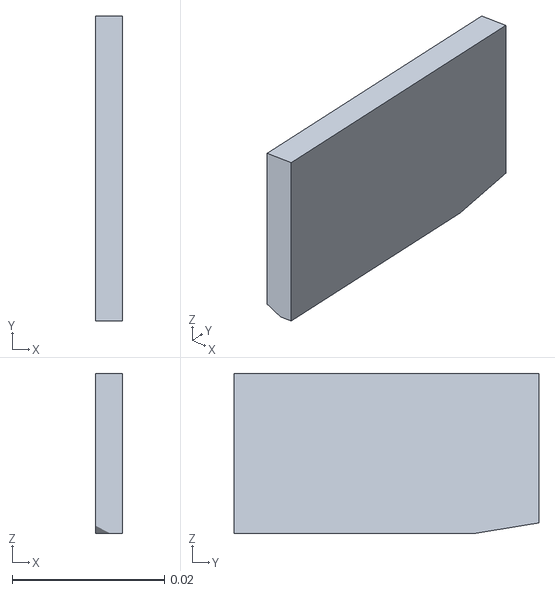
[picture p58: CAD file, 2026-11-14]
workspace/urdf_and_usd/waffle_4wd_description/meshes/b/collision/corner_FR_hull03.stl
0.0035 x 0.04 x 0.021
