developlcy-oss/Lv2_Cartlidar_Assignment/workspace/urdf_and_usd/waffle_4wd_description/meshes/b/pallet.stl

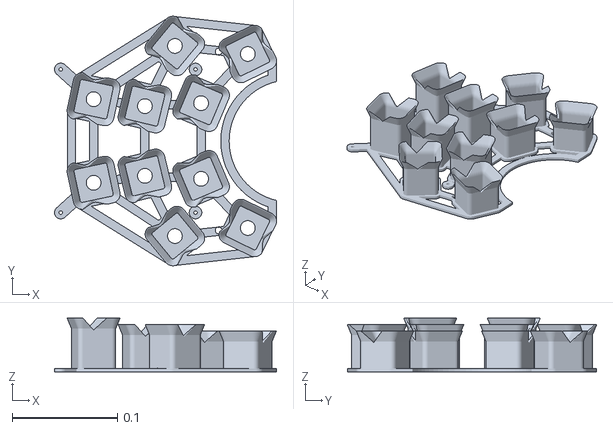
[picture p62: CAD file, 2026-11-14]
workspace/urdf_and_usd/waffle_4wd_description/meshes/b/pallet.stl
0.211 x 0.237 x 0.051
