developlcy-oss/Lv2_Cartlidar_Assignment/workspace/urdf_and_usd/waffle_4wd_description/meshes/b/wheel_rim_left.stl

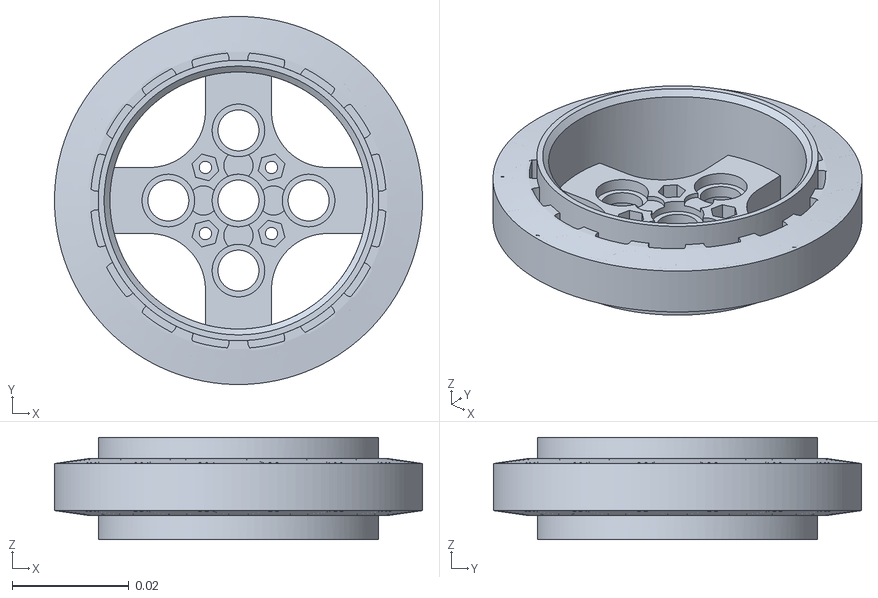
[picture p66: CAD file, 2026-11-13]
workspace/urdf_and_usd/waffle_4wd_description/meshes/b/wheel_rim_left.stl
0.063 x 0.063 x 0.0175
