developlcy-oss/Lv2_Cartlidar_Assignment/workspace/urdf_and_usd/waffle_4wd_description/meshes/b/wheel_tire_right.stl

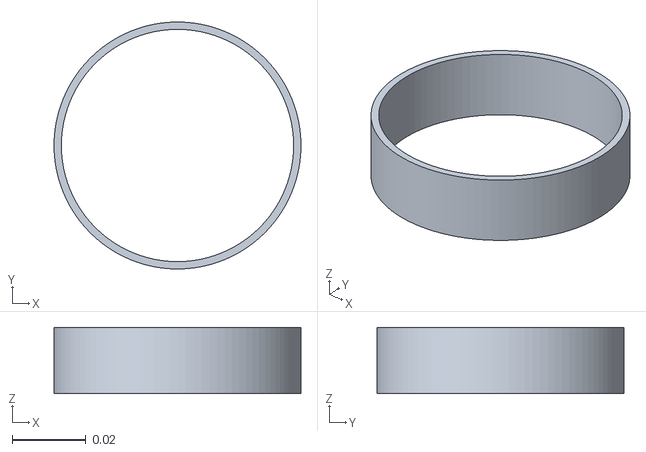
[picture p75: CAD file, 2026-11-13]
workspace/urdf_and_usd/waffle_4wd_description/meshes/b/wheel_tire_right.stl
0.067 x 0.067 x 0.018
