developlcy-oss/Lv2_Cartlidar_Assignment/workspace/urdf_and_usd/waffle_4wd_description/meshes/b/jetson_battery.stl

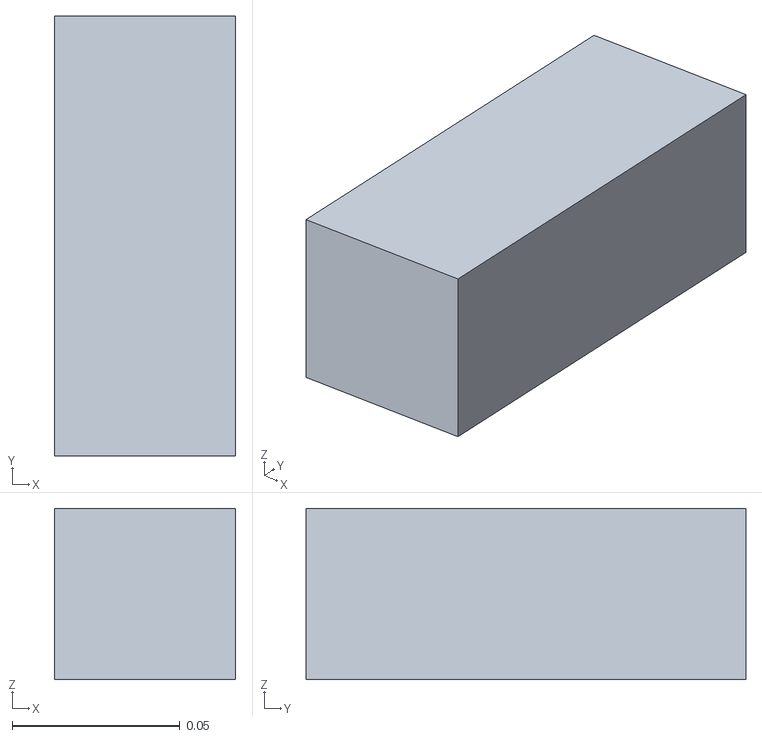
[picture p82: CAD file, 2026-11-13]
workspace/urdf_and_usd/waffle_4wd_description/meshes/b/jetson_battery.stl
0.054 x 0.131 x 0.051
