developlcy-oss/Lv2_Cartlidar_Assignment/(list of files, cad)

Other CAD files:
workspace/urdf_and_usd/waffle_4wd_description_261028/meshes/main/opencr_left.stl
workspace/urdf_and_usd/waffle_4wd_description_261028/meshes/parts/puck_plate_col/cup_092.stl
workspace/urdf_and_usd/waffle_4wd_description/meshes/b/collision/pallet_cup2_hull11.stl
workspace/urdf_and_usd/waffle_4wd_description/meshes/b/collision/pallet_cup1_hull11.stl
workspace/urdf_and_usd/waffle_4wd_description/meshes/b/wheel_rim_right.stl
workspace/urdf_and_usd/waffle_4wd_description/meshes/b/wheel_tire_left.stl
workspace/urdf_and_usd/waffle_4wd_description_261028/meshes/arm/gripper_left_link_0.stl
workspace/urdf_and_usd/waffle_4wd_description_261028/meshes/collision/base_link_part176_hull00.stl
workspace/urdf_and_usd/waffle_4wd_description/meshes/b/collision/pallet_cup2_hull16.stl
workspace/urdf_and_usd/waffle_4wd_description/meshes/b/collision/pallet_cup0_hull24.stl
workspace/urdf_and_usd/waffle_4wd_description_261028/meshes/arm/gripper_left_link_2.stl
workspace/urdf_and_usd/waffle_4wd_description_261028/meshes/arm/gripper_link_5.stl
workspace/urdf_and_usd/waffle_4wd_description/meshes/b/collision/pallet_cup0_hull18.stl
workspace/urdf_and_usd/waffle_4wd_description/meshes/b/collision/pallet_cup0_hull10.stl
workspace/urdf_and_usd/waffle_4wd_description/meshes/b/collision/pallet_cup1_hull05.stl
workspace/urdf_and_usd/waffle_4wd_description/meshes/b/collision/corner_FR_hull02.stl
workspace/urdf_and_usd/waffle_4wd_description/meshes/b/collision/pallet_cup0_hull17.stl
workspace/urdf_and_usd/waffle_4wd_description_261028/meshes/parts/puck_plate_col/cup_091.stl
workspace/urdf_and_usd/waffle_4wd_description_261028/meshes/parts/puck_plate_col/cup_139.stl
workspace/urdf_and_usd/waffle_4wd_description/meshes/b/bolts.stl
workspace/urdf_and_usd/waffle_4wd_description/meshes/b/collision/corner_FL_hull00.stl
workspace/urdf_and_usd/waffle_4wd_description/meshes/b/collision/corner_FL_hull01.stl
workspace/urdf_and_usd/waffle_4wd_description/meshes/b/collision/corner_FL_hull03.stl
workspace/urdf_and_usd/waffle_4wd_description/meshes/b/collision/corner_FL_hull04.stl
workspace/urdf_and_usd/waffle_4wd_description/meshes/b/collision/corner_FL_hull06.stl
workspace/urdf_and_usd/waffle_4wd_description/meshes/b/collision/corner_FL_hull07.stl
workspace/urdf_and_usd/waffle_4wd_description/meshes/b/collision/corner_FL_hull08.stl
workspace/urdf_and_usd/waffle_4wd_description/meshes/b/collision/corner_FL_hull09.stl
workspace/urdf_and_usd/waffle_4wd_description/meshes/b/collision/corner_FL_hull10.stl
workspace/urdf_and_usd/waffle_4wd_description/meshes/b/collision/corner_FL_hull11.stl
workspace/urdf_and_usd/waffle_4wd_description/meshes/b/collision/corner_FL_hull12.stl
workspace/urdf_and_usd/waffle_4wd_description/meshes/b/collision/corner_FL_hull13.stl
workspace/urdf_and_usd/waffle_4wd_description/meshes/b/collision/corner_FL_hull14.stl
workspace/urdf_and_usd/waffle_4wd_description/meshes/b/collision/corner_FL_hull15.stl
workspace/urdf_and_usd/waffle_4wd_description/meshes/b/collision/corner_FL_hull16.stl
workspace/urdf_and_usd/waffle_4wd_description/meshes/b/collision/corner_FL_hull17.stl
workspace/urdf_and_usd/waffle_4wd_description/meshes/b/collision/corner_FL_hull18.stl
workspace/urdf_and_usd/waffle_4wd_description/meshes/b/collision/corner_FL_hull19.stl
workspace/urdf_and_usd/waffle_4wd_description/meshes/b/collision/corner_FL_hull20.stl
workspace/urdf_and_usd/waffle_4wd_description/meshes/b/collision/corner_FL_hull21.stl
workspace/urdf_and_usd/waffle_4wd_description/meshes/b/collision/corner_FL_hull25.stl
workspace/urdf_and_usd/waffle_4wd_description/meshes/b/collision/corner_FL_hull26.stl
workspace/urdf_and_usd/waffle_4wd_description/meshes/b/collision/corner_FL_hull27.stl
workspace/urdf_and_usd/waffle_4wd_description/meshes/b/collision/corner_FL_hull28.stl
workspace/urdf_and_usd/waffle_4wd_description/meshes/b/collision/corner_FL_hull29.stl
workspace/urdf_and_usd/waffle_4wd_description/meshes/b/collision/corner_FL_hull30.stl
workspace/urdf_and_usd/waffle_4wd_description/meshes/b/collision/corner_FL_hull31.stl
workspace/urdf_and_usd/waffle_4wd_description/meshes/b/collision/corner_FR_hull04.stl
workspace/urdf_and_usd/waffle_4wd_description/meshes/b/collision/corner_FR_hull05.stl
workspace/urdf_and_usd/waffle_4wd_description/meshes/b/collision/corner_FR_hull06.stl
workspace/urdf_and_usd/waffle_4wd_description/meshes/b/collision/corner_FR_hull07.stl
workspace/urdf_and_usd/waffle_4wd_description/meshes/b/collision/corner_FR_hull08.stl
workspace/urdf_and_usd/waffle_4wd_description/meshes/b/collision/corner_FR_hull09.stl
workspace/urdf_and_usd/waffle_4wd_description/meshes/b/collision/corner_FR_hull10.stl
workspace/urdf_and_usd/waffle_4wd_description/meshes/b/collision/corner_FR_hull12.stl
workspace/urdf_and_usd/waffle_4wd_description/meshes/b/collision/corner_FR_hull15.stl
workspace/urdf_and_usd/waffle_4wd_description/meshes/b/collision/corner_FR_hull16.stl
workspace/urdf_and_usd/waffle_4wd_description/meshes/b/collision/corner_FR_hull17.stl
workspace/urdf_and_usd/waffle_4wd_description/meshes/b/collision/corner_FR_hull18.stl
workspace/urdf_and_usd/waffle_4wd_description/meshes/b/collision/corner_FR_hull19.stl
workspace/urdf_and_usd/waffle_4wd_description/meshes/b/collision/corner_FR_hull20.stl
workspace/urdf_and_usd/waffle_4wd_description/meshes/b/collision/corner_FR_hull21.stl
workspace/urdf_and_usd/waffle_4wd_description/meshes/b/collision/corner_FR_hull22.stl
workspace/urdf_and_usd/waffle_4wd_description/meshes/b/collision/corner_FR_hull23.stl
workspace/urdf_and_usd/waffle_4wd_description/meshes/b/collision/corner_FR_hull24.stl
workspace/urdf_and_usd/waffle_4wd_description/meshes/b/collision/corner_FR_hull25.stl
workspace/urdf_and_usd/waffle_4wd_description/meshes/b/collision/corner_FR_hull27.stl
workspace/urdf_and_usd/waffle_4wd_description/meshes/b/collision/corner_FR_hull29.stl
workspace/urdf_and_usd/waffle_4wd_description/meshes/b/collision/corner_FR_hull30.stl
workspace/urdf_and_usd/waffle_4wd_description/meshes/b/collision/corner_FR_hull31.stl
workspace/urdf_and_usd/waffle_4wd_description/meshes/b/collision/corner_RL_hull00.stl
workspace/urdf_and_usd/waffle_4wd_description/meshes/b/collision/corner_RL_hull01.stl
workspace/urdf_and_usd/waffle_4wd_description/meshes/b/collision/corner_RL_hull02.stl
workspace/urdf_and_usd/waffle_4wd_description/meshes/b/collision/corner_RL_hull03.stl
workspace/urdf_and_usd/waffle_4wd_description/meshes/b/collision/corner_RL_hull04.stl
workspace/urdf_and_usd/waffle_4wd_description/meshes/b/collision/corner_RL_hull05.stl
workspace/urdf_and_usd/waffle_4wd_description/meshes/b/collision/corner_RL_hull06.stl
workspace/urdf_and_usd/waffle_4wd_description/meshes/b/collision/corner_RL_hull07.stl
workspace/urdf_and_usd/waffle_4wd_description/meshes/b/collision/corner_RL_hull08.stl
workspace/urdf_and_usd/waffle_4wd_description/meshes/b/collision/corner_RL_hull09.stl
workspace/urdf_and_usd/waffle_4wd_description/meshes/b/collision/corner_RL_hull10.stl
workspace/urdf_and_usd/waffle_4wd_description/meshes/b/collision/corner_RL_hull11.stl
workspace/urdf_and_usd/waffle_4wd_description/meshes/b/collision/corner_RL_hull12.stl
workspace/urdf_and_usd/waffle_4wd_description/meshes/b/collision/corner_RL_hull13.stl
workspace/urdf_and_usd/waffle_4wd_description/meshes/b/collision/corner_RL_hull14.stl
workspace/urdf_and_usd/waffle_4wd_description/meshes/b/collision/corner_RL_hull15.stl
workspace/urdf_and_usd/waffle_4wd_description/meshes/b/collision/corner_RL_hull16.stl
workspace/urdf_and_usd/waffle_4wd_description/meshes/b/collision/corner_RL_hull17.stl
workspace/urdf_and_usd/waffle_4wd_description/meshes/b/collision/corner_RL_hull18.stl
workspace/urdf_and_usd/waffle_4wd_description/meshes/b/collision/corner_RL_hull19.stl
workspace/urdf_and_usd/waffle_4wd_description/meshes/b/collision/corner_RL_hull20.stl
workspace/urdf_and_usd/waffle_4wd_description/meshes/b/collision/corner_RL_hull21.stl
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
