developlcy-oss/Lv2_Cartlidar_Assignment/submission/midterm/test_results.md

# 신호 · 바코드 · 집기 시험 결과 (중간 제출)

기준: Integration 브랜치 2026-11-09. 발제 주의대로 **모의 (Isaac 렌더 · 녹화 재생 · Gazebo) 와 실물을 나눠 적는다.** 모의 결과를 실물 성공으로 보지 않는다.
근거는 각 줄의 PR · Issue 에 있다.

## 0. 단위 시험 (colcon test, 2026-11-09 최신 소스로 다시 빌드)

| 패키지 | 시험 수 | 실패 | 이 문서와 관련된 것 |
|---|---|---|---|
| perception | 199 | 0 | SignalLight 10 · SignalLightHistory 1 · SignalSequence 8 · BarcodeLocator 6 · BarcodeReader 8 · Puck · ArmDetect · DiceCheck … |
| control | 49 | 0 | IK · 정렬 · 회전 skill · target_look 자세 · TopPick 관측 · 처짐 보정 |
| opencr_hardware | 107 | 0 | 프로토콜 · 듀얼 보드 · 모델 비교 (#112) |
| robot_policy | 5 | 0 | 정책 입출력 |
| mission_planner (pytest) | 19 | 0 | 할당 (도전 B 6 건) · GTSP · 지도 · 계획 · 제출물 생성 |
| mission | 0 | — | 단위 시험 없음. 흐름은 아래 4 의 mock · Gazebo 연동 시험으로 확인 |

## 1. 신호 (12 회 점멸 기억)

| 구분 | 시험 | 결과 | 근거 |
|---|---|---|---|
| 모의 | R1 렌더 재생 판정 (Isaac, 3000 K · 6500 K 각 160) | **320/320**, 퍽 오인 0 | PR #28 |
| 모의 | R2 렌더 재생 (12 회 순서 확정) | **100/100**, 틀린 확정 0, 모두 78 s 안 | PR #28 |
| 모의 | R2′ 신호등 자리 고정 전 이력 복원 재생 | **40/40**, 이상 입력 150 회 진단 모두 78 s 안 | PR #26 |
| 실물 | 실물 신호등 · 조명에서 12 회 판정 | **미시험** | PR #26 · #28 본문 |

남은 위험: 색 문턱은 렌더와 AWB 흉내로 정함. 실물 초록 LED 의 색상 (H) 은 확인 전 — H 58 ~ 67 초록은 노랑으로 봄 (PR #28). D435 노출은 수동 고정 (노출 80 · gain 128, #89).

## 2. 바코드 (Code 128, P2-01 ~ 04)

| 구분 | 시험 | 결과 | 근거 |
|---|---|---|---|
| 모의 | R3 판정 7 차 (D435 라벨 찾기) | 벽 **92/92**, 윗면 45 ~ 46/46, 헛검출 0, 위치 오차 ≤ 3.44 mm (기준 ≥ 95 %, ≤ 30 mm) | PR #47 |
| 모의 | R3 (팔 카메라 경로로 바꾼 뒤) | **144/144**, 판독 예전과 같음 | PR #130 |
| 실물 | 1 차 판정 (11-04, 팔 Arducam) | **0/1038** — 라벨 흰 여백이 좁고 카펫 무늬로 zbar 가 기호를 못 찾음 | PR #130 |
| 실물 | 고친 뒤 (Jetson, Arducam 1280×720, 약 10 cm, 로봇 없이) | 4 라벨 모두 **100 % (499 장)**, 틀린 문자열 0, p95 64.8 ms (기준 ≥ 90 %, 틀림 0, p95 ≤ 1000 ms) | PR #130 |
| 실물 | 손 · 구부림이 있는 영상 | 1025/1038 | PR #130 |
| 실물 | 로봇에 달고 출발 자세에서 `barcode_look` (라벨까지 약 0.3 m) | **미시험** | #65 · `mission_plan.yaml` |

## 3. 집기 · 놓기

### 3-1. 모의 (Isaac)

| 시험 | 결과 | 근거 |
|---|---|---|
| 팔레트 12 칸 45° 놓기 · 꺼내기 (원기둥 12 · 상자 12) | **24/24**, 놓기 157.8 s · 꺼내기 137.8 s | PR #60 · #79, #75 |
| TopPick 기존 정책, 물리 무작위화 끔 / 켬 (64 대) | 23 % / 17 % → 다시 학습 필요 | PR #106 |
| TopPick TP2, 배치 B (회전 뒤 상자 퍽) 좌표 고정 | **0/46** (좌표를 계속 받으면 15/18) | #78 · #82 |
| **TopPick TP8 (최신, 2026-11-09 학습 40300 회, 커밋 전)** 256 대 · 무작위화 전부 · 배치 섞음 | **150/256 = 58.6 %** (배치 A 68.8 % · B 63.5 % · C 69.6 % · 무작위 51.1 %, 상자 61.5 % · 원기둥 55.6 %), 넘어뜨림 42, 옆 퍽 건드림 30 | `urdf_and_usd/policy/manipulator/toppick_eval.json` · `policies/registry.json` |
| fit1 정책, 상자 가운데 배치 96 대 (원기둥 / 직육면체) | 두 퍽 다 앉음 40 / 22, 집기 넘어뜨림 31 / 38, 칸에 못 앉음 22 / 33 | #141 |
| fit1, 자리 무작위 48 대 | 두 퍽 다 앉음 22 / 12 | #141 |

### 3-2. 실물

| 시험 | 결과 | 근거 |
|---|---|---|
| 팔 OpenCR 단독 벤치 (관절 한계 · 그리퍼 다시 결합 · 대기 자세 토크) | 완료 | `docs/arm_bench_test_2026-10-26.md` · `-10-27.md` |
| 그리퍼 실측 | 2100 tick = 36.4 mm, 30 mm 퍽 쥠 2377 tick | #64 |
| 관절 6 칸 키보드 이동 (접힌 자세 근처 56 s) | RUN 유지, 오류 비트 없음, 정착 오차 최대 0.0079 rad. 방향은 미확인 | #165 |
| 펌웨어 M3 ~ M6 (손 확인 · move · 슬라이더 · 퍽 쥐기) | **진행 중** | #165 · #139 |
| `target_look` → `toppick_tilt` 실물 집기 성공률 | **미시험** | #108 |
| READY · BOX_VIEW 자세에서 팔 카메라가 퍽을 봄 | **실패** — 화면에 안 들어옴 | #154 |
| joint1 영점 | 약 180° 어긋난 것으로 보임 (정면 ±3.2 rad) | #161 |

## 4. 미션 흐름 연동 (모의)

| 시험 | 결과 | 근거 |
|---|---|---|
| mock 연동 (가짜 drive · 팔 · 인식, Q1 예제) | **DONE** 93 단계 26 s. skill 거절 → 재시도 2 번 뒤 FAILED, 미등록 바코드 → 바로 FAILED (의도대로) | `mission_planner/README.md` |
| 장소 상자 재기 mock (상자 2 cm · 5° 밀림) | DONE, 측정 실패 시 지도 좌표로 DONE | #73 |
| Gazebo 주행 연동 (경기장 · Nav2 + AMCL · drive_node 진짜, 팔 · 인식 mock) | **DONE** 105 단계, goto 18 번 도착 오차 중앙값 48 mm (31 ~ 112), yaw 최대 5.3°, 재시도 0 | #135 |
| 실물 전체 미션 | **미시험** | — |

## 5. 요약 — 경기 전에 남은 실물 확인

1. 실물 신호등 12 회 판정 (조명 · 거리)
2. 로봇에 단 팔 카메라로 출발 자세에서 바코드 읽기
3. 팔: #161 J1 영점 → #165 M3 ~ M6 → #154 카메라 시야 → #108 실물 집기 → 팔레트 · 장소 놓기
4. 박스 · 장소 앞 정렬: #157 (FINE 뒤 TFmini 비상 정지), #160 (빈 상자 접근 실패)
