developlcy-oss/Lv2_Cartlidar_Assignment/workspace/ros2_ws/src/perception/models/yolo/E3_train_results.csv

epoch | time | train/box_loss | train/cls_loss | train/dfl_loss | metrics/precision(B) | metrics/recall(B) | metrics/mAP50(B) | metrics/mAP50-95(B) | val/box_loss | val/cls_loss | val/dfl_loss | lr/pg0 | lr/pg1 | lr/pg2 | lr/pg3 | lr/pg4 | lr/pg5 | lr/pg6 | lr/pg7
1 | 86.9186 | 0.64471 | 0.51908 | 0.93951 | 0.97404 | 0.9681 | 0.99118 | 0.92548 | 0.39819 | 0.30945 | 0.80541 | 0.0099823 | 0.00332743 | 0.0099823 | 0.00332743 | 0.0099823 | 0.00332743 | 0.0099823 | 0.00332743
2 | 161.987 | 0.62916 | 0.46154 | 0.90099 | 0.95934 | 0.95924 | 0.98708 | 0.90974 | 0.42844 | 0.36814 | 0.80988 | 0.019735 | 0.00657834 | 0.019735 | 0.00657834 | 0.019735 | 0.00657834 | 0.019735 | 0.00657834
3 | 236.15 | 0.66864 | 0.50599 | 0.90927 | 0.93827 | 0.93241 | 0.98359 | 0.8888 | 0.48226 | 0.4044 | 0.82001 | 0.0292402 | 0.00974675 | 0.0292402 | 0.00974675 | 0.0292402 | 0.00974675 | 0.0292402 | 0.00974675
4 | 310.207 | 0.69109 | 0.5078 | 0.91266 | 0.97106 | 0.94299 | 0.98767 | 0.89723 | 0.47553 | 0.36417 | 0.81751 | 0.0288862 | 0.00962875 | 0.0288862 | 0.00962875 | 0.0288862 | 0.00962875 | 0.0288862 | 0.00962875
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
