developlcy-oss/Lv2_Cartlidar_Assignment/workspace/urdf_and_usd/waffle_4wd_description/CHANGES_B.md

# B안 판 변경 기록 (2026-11-02)

팀 URDF 261028 (`~/Downloads/urdf_test/urdf_261028`) 에 다음 설계를 반영한 판이다. 생성기: 저장소 밖 `~/Downloads/Claude outputs/puck_storage_design/시뮬레이션_모델_B안/` (`README.md` 의 "다시 만들기").

- `구동_증속벨트/`: 증속벨트 v4.2 (베어링 블록 · 모터 받침 · 풀리 · 덮개 · 아이들러 · 축 · 베어링 · 벨트 · 모터)
- `하단_브라켓_전장/`: 바닥 브라켓 v4, TO 캐리어, 전장 받침판, OpenCR 2층, Jetson, TFmini 받침대
- `B안_팔레트/puck_pallet.scad` **v3**: 조인트1 중심 동심원 3열 × 4칸, 열 높이 계단 0 / 10 / 22 mm, 칸 깊이 30 mm

저장소 판 이력:
- **2026-11-13 퍽 무게 실측**: 원기둥 12 → **13 g**, 사각기둥 18 → **17 g** (사용자 실측, 퍽 링크 질량 · 관성만 바뀜, 퍽 10 개 실은 질량 4.899 kg 그대로).
  같이 바꾼 곳: Isaac `policy/manipulator/waffle_isaac/dice2_cfg.py PUCK_MASS` (이전 추정 45 · 55 g), `lieupright_env_cfg.py` (13.5 · 17.5), `tools/arm_bench/rl/arm_pick` (30 g).
- **2026-11-13 팔레트 v5 · Jetson 배터리 · 바퀴 림 R31.5** (생성기 다시 반영, 이전 판 `puck_storage_design/backup/repo_before_v5_battery_wheel_20261113/`):
  팔레트 v3 (12 칸) → **v5** (10 칸 = 열마다 4 · 4 · 2, 칸 사이 5.2 mm, 입구 43.5, 칸 바닥 9 · 15 · 21 mm, 손가락 홈 = 팀 팔 TCP 46, 173.5 g) — `config/pallet_slots.yaml` 10 칸, 퍽 링크 10 개 (`puck_B_3` · `puck_B_4` 없음).
  **Jetson 배터리** (UGREEN 54 × 51 × 131, 실측 466 g): OpenCR ↔ TFmini 받침대 사이 x 48 ~ 102 · z 12 ~ 63, 화면 위로 눕힘 (base_link 겉모양 `jetson_battery` + 충돌 상자).
  바퀴 배터리 2 개 (106 g, 질량만) 는 자리를 내주고 (8, ±67) mm 로 옮김 (자리 어림 ★).
  **바퀴**: 홈 채운 림 `wheel_rim_filled_R31.50_4EA` (출력본) + 타이어 2 mm → 반지름 0.033 → **0.0335** (바퀴 링크 겉모양 = 림 + 타이어 메시, 충돌 원통 r 0.0335 · 폭 0.018, 29.6 g),
  `base_footprint_joint` z −0.00675 → −0.00725, Gazebo DiffDrive `wheel_radius` 0.0335 · `max_linear_velocity` 0.368, `sensors.yaml` `wheel_radius_m` 0.0335.
  질량 4.293 → **4.749 kg** (퍽 10 개 4.899 kg). Isaac 점검 3 판: 직진 0.298 m, 회전 74.4 → **69.0°** (무게 늘어 미끄럼), loaded stow 오차 0.512 rad (v4 · v5 같음).
  Isaac 팔레트 놓기 · 꺼내기 24/24, 고정 동작 집기 이어 평가 σ0 170 · σ2 137 (시드 2).
- **2026-11-12 생성기 다시 반영** (11-09 ~ 11-10 설계 + #220): 증속벨트 v4.2 → **v6.1 모서리 일체형** (충돌 조각 `corner_{FL,FR,RL,RR}_hull*`,
  옛 `bracket_{L,R}_hull*` 지움), 프로파일 캐리어 TO → **v7**, **LDS-03 브라켓 v2** (`lds_front/rear_joint` (±0.1318, 0, 0.0675), 거꾸로 그대로,
  이전 (±0.1089, 0, 0.0755) → 스캔면 바닥 위 82.2 → 74.3 mm, 차체 가림 앞 161.1° · 뒤 193.5°), 팔레트 바닥판 충돌 조각 다시 나눔 (칸 조각 같음).
  **퍽 12 개에 충돌 형상** (원기둥 r 15 · 사각 30, 높이 60, 겉모양과 같음, #220): 고정 관절이라 Isaac 은 base_link 에 합쳐 팔 ↔ 차체 자기 충돌로 잡힘.
  질량 4.264 → **4.293 kg** (base_link 2.992 → 3.022), 퍽 포함 4.473 kg. 팔 카메라 주점은 #147 (557b95e) 값 그대로, `sensors.yaml` 은 저장소 판 (IMU 하나) 그대로.
  Isaac 점검 3 판 값 정상 (직진 0.298 m, 회전 74.4° · loaded 73.6°). loaded 판 stow 자세 오차 0.21 → 0.456 rad (접는 길에 팔이 실린 퍽에 걸림 = 충돌 형상이 잡힘).
  미션 팔 자세 접촉 (Isaac, 팔 몸체 ↔ base_link): DRIVE 빈 판 0 N / loaded link3 12 N, ALIGN 15 / 34 N, TRANSIT_TILT 0 / 0 (#219 · #218).
  ★ 실물 URDF (`opencr_hardware/urdf/robot.urdf.xacro` laser_front · rear) · `docs/frames_tf.md` 는 아직 옛 LDS 자리 — 새 브라켓을 실물에 달면 같이 바꿀 것.
- 2026-10-30 판 (`waffle_4wd_description_261028`, 퍽 플레이트) 은 이 판으로 바뀌었다. 그 퍽 플레이트는 B안 팔레트의 앞 판 (높이 39 mm, 칸 깊이 14) 이라 v3 (높이 55 mm) 으로 대체. 옛 파일은 git 이력에 있다.
- A안 저장소 (원호 레일 · 하우징 · 매거진, `시뮬레이션_모델_A안`) 는 **보류** — 저장소에 넣지 않았다.

## 261028 에서 바뀐 것

| 항목 | 261028 | B안 판 |
|---|---|---|
| 퍽 보관 | 옛 보관통 3 + 레일 2 (z 176~401) | **B안 상판 팔레트 v3** (190.3 g). 원점 = 팀 조인트1 축 (x 96.0) · 상판 윗면 (z 111.0) (사용자 결정: 조인트1 기준). 상판 위라 x +12.5 를 따르지 않음 |
| 바닥 브라켓 · 캐리어 | 옛 브라켓 (CAD), 캐리어 | 브라켓 v4 L/R + TO 캐리어 (설계 자리) |
| 증속벨트 | 옛 모듈, 모터 축 x ±34.5 | v4.2 4곳, 모터 축 x 47.0 / −22.0 |
| 바퀴 관절 x | ±0.080 | **앞 0.0925 · 뒤 −0.0675** (y ±0.1546 · z 0.02625 그대로, 바퀴 간격 0.317 그대로) |
| 프로파일 기둥 · 가로대 · D435 2대 | — | 캐리어를 따라 x +12.5 mm. 팔레트 (\|y\| ≤ 105.8) 와 겹치지 않음 |
| 하판 전장 | Jetson (103 변 y), OpenCR 좌우 2, 배터리 링크 2, TFmini 브라켓 v2 | `lower_deck.scad` v1.1: 받침판, Jetson (103 변 x, (−79.5, 0)), **OpenCR 2층** `opencr_lower/upper_link` ((9.5, 0), z 18 · 59.7, 지지대 40), TFmini 받침대 v4.3, **배터리는 질량만** |
| IMU | `imu_left/right_link` 센서 2, `imu_link` 는 가운데 frame | **`imu_link` = 아래층 OpenCR 칩 (9.5, 0, 20.2) mm, 센서 1개 → `/imu/data`** (위층은 끔) |
| `tfmini_link` | (140.3, 0, 34.8) mm | (130, 0, 24.3) mm |
| 퍽 | — | `pucks:=true` 면 칸마다 퍽 (v5 10 개: `puck_{R,G}_{1..4}` · `puck_B_{1,2}`, 원기둥 13 g · 사각기둥 17 g 실측 번갈아, (열 + 칸) 짝수 = 원기둥). 칸 바닥 z 120 / 126 / 132 mm (v5). 자리는 `config/pallet_slots.yaml` |
| 무게추 | 없음 | 없음 (사용자 결정) |

관절 이름 (바퀴 · 팔 · 손가락) 과 팀 코드 frame 은 그대로이고, `base_link` 원점도 그대로 (판 가운데, 지면 위 6.75 mm) 다.
없어진 링크: `opencr_left/right_link`, `battery_left/right_link`, `imu_left/right_link`, (10-30 판의) `puck_plate_link`.

## 질량

| | 261028 | B안 (빈 팔레트) | B안 (퍽 12개) |
|---|---|---|---|
| 전체 | 4.041 kg | **4.264 kg** | **4.444 kg** |
| base_link | 2.555 kg | 2.992 kg, 무게중심 (−32.5, 1.8, 125.3) mm | 같음 (퍽은 따로 링크) |

- base_link = 받은 값 − 옛 부품 1,055.7 g + 새 부품 1,493.0 g.
- 출력 부품 질량: 껍질 0.8 mm (100 %) + 안쪽 15 %, PLA 1.24 g/cm³ (261027_1711 과 같은 식).
- 금속: XM430 82 g, 축 · 688ZZ · 나사 강철 7.85, 벨트 고무 1.2, 아이들러 3 g · 지지대 4 g × 4 (어림). 배터리 106 g × 2 는 x 76, y ±46, z 25 mm 에 질량만 (자리 어림).
- 프로파일 · 가로대 (2020, 0.45 kg/m 어림 0.53 kg) 는 질량을 바꾸지 않고 자리만 +12.5 mm.

## 충돌 형상

- **가벼운 판** (`collision:=light`, Isaac light · loaded): 브라켓 · 블록 · 받침 · 모터 · 덮개 · 받침판은 상자, 팔레트는 바닥판 외곽 상자 (두께 3) + 칸마다 칸 방향으로 돌린 상자 (칸 바깥 외곽, 칸 속 · 손가락 홈 무시). **집기 시험은 정밀 판으로.**
- **정밀 판** (`collision:=full`, Isaac full): 브라켓 · 팔레트 바닥판 · 열마다 칸 하나를 CoACD 로 볼록 분해 (칸은 같은 조각을 같은 열 4칸에 원점만 바꿔 씀). 전체 478 조각. 캐리어는 261028 볼록 조각 +12.5 mm.

## 점검 결과 (2026-11-02, RTX 5060 Laptop, 생성기 폴더에서)

| 항목 | Gazebo light · 빈 | Gazebo full · 퍽 | Isaac light | Isaac full | Isaac loaded |
|---|---|---|---|---|---|
| 가만히 base_link 높이 | 6.75 mm | 6.75 mm | 6.8 mm, 기울기 0.03° | 같음 | 같음 |
| 직진 0.1 m/s × 3 s | 0.304 m | 0.301 m | 0.298 m | 0.298 m | 0.298 m |
| 제자리 회전 | 0.5 rad/s × 3 s → 68.2° (odom 86.5°) | 67.8° (odom 86.2°) | 74.0° (미끄럼 없을 때 108.4°) | 74.0° | 73.2° |
| 센서 | IMU 100 · TFmini 100 · LiDAR 10 Hz | 같음 | TFmini = 계산값 | 같음 | 같음 |
| 자세 zero · drive 오차 | — | — | 0.059 · 0.047 rad | 같음 | 같음 |
| **자세 stow 오차** | — | — | **0.211 rad** (J1 −0.15, J2 +0.21) | 0.200 | 0.211 |
| USD 값 = robot_params.json | — | — | 같음 (관절 12, 팔끼리 뺀 쌍 28) | 같음 | 같음 |

- Gazebo 주행 점검은 빈 바닥 월드에서 했다 (경기장 출발 자리에서는 영 자세 팔이 신호등에, 뒤로 가면 칸막이 벽에 닿음).
- 경기장 (`worlds/dice_mission.sdf`) 출발 구역 (0.6 m 사각) 안 여유: 차체 x −213.5 ~ +132.8 mm, y ±167.6 mm → 가장자리까지 127 mm (Isaac 장면 `isaac/scenes/`).
- Isaac 로그의 `Pattern '/World/Robot/Geometry/base_link' did not match any rigid bodies` 는 LiDAR 가림 상자를 만들 때 나오는 것이고 결과 값은 정상.

## 확인할 것 ★

1. **stow (전원 켤 때 자세) 로 가는 길에 팔이 팔레트에 걸림.**
   - 최종 stow 자세는 닿지 않지만 가깝다: 위팔 (link3) ↔ 팔레트 4.0 mm (볼록 메시) · 0.9 mm (상자), ↔ 퍽 10.7 mm.
   - 조인트1 이 90° 까지 돌기 전에 J2 · J3 · J4 가 다 접히면 위팔이 팔레트 칸에 최대 25 mm 파고든다 (J1 0 ~ 1.4 rad). Isaac 점검은 모든 관절을 같이 움직여 J1 약 81° 에서 걸려 멈춘다.
   - **zero → stow 는 J1 을 먼저 다 돌린 뒤 접을 것**, 또는 stow 자세를 바꿀 것. 주행 자세 (drive) 는 팔레트 · 퍽과 닿지 않음 (팔 ↔ 퍽 21.7 mm).
2. **팔레트 체결 구멍.** 팔레트는 조인트1 x 92.8 (상판 앞에서 40 mm) 기준으로 설계됐고, 이 모델은 팀 조인트1 x 96.0 에 맞췄다. 실물 상판 구멍에 그대로 놓으면 칸 원호 중심이 조인트1 보다 3.2 mm 앞. 실물 조인트1 위치를 재서 확인.
3. **팔 · 집기 자세.** 설계 `pallet_slots.yaml` 의 관절값은 OM-X 팔 기준. 팀 팔 (RM-X52 + 롤 손목) 로 12칸 집기 · 퍽 든 채 회전 (상판 + 145 mm) 을 다시 확인. 팀 J1 한계 ±180°, 팔레트 설계의 금지 구간 247 ~ 293° (팔 0° = 왼쪽 기준).
4. **회전 중심 12.5 mm.** 브라켓 · 벨트 · 바퀴 · 캐리어가 판보다 x +12.5 mm 앞 (사용자 결정 2026-11-01: 설계 그대로). 제자리 회전 때 `base_link` 가 반지름 12.5 mm 원을 그림 → Nav2 · diff_drive 가 base_link 를 회전 중심으로 보면 약간 어긋남. 실물 바퀴 축 x 를 재서 확인.
5. **LiDAR 가림.** LDS-03 스캔면 (지면 위 82.2 mm) 이 위층 OpenCR (z 59.7~96.4) 을 지남. 차체 가림 앞 139.5° → 179.1°, 뒤 195.3° → 220.5°. → 2026-11-12 브라켓 v2 (스캔면 74.3 mm) 로 앞 161.1° · 뒤 193.5°.
6. **IMU 하나.** 시뮬은 `/imu/data` 를 바로 냄 (frame `imu_link`). 팀의 두 IMU 평균 노드는 시뮬에서 쓰지 말 것. `config/sensors.yaml` 의 `imu` 도 하나 (`opencr_lower_link` → `imu_link`) 로 고침 (2026-11-02).
7. **어림값.** Jetson 포트 방향 (설계 상자에 맞춰 메시를 90° 돌림), 배터리 자리, 지지대 · 아이들러 질량.
8. 바퀴 속도 · 감쇠 등 물리값은 261028 `robot_params.json` 그대로 (벨트 1 : 1.5).
9. **팔레트 충돌 조각 (고침, 2026-11-02)**: 처음 판은 칸을 CoACD (32 조각) 로 나눠 칸 안 둥근 모서리 (r 2) 가 메워짐 -> 상자 퍽이 칸 바닥 위 13 ~ 20 mm 에 걸림, 조각 꼭짓점도 최대 173 (PhysX 한계 64).
   생성기 `geom.py`: 칸은 `cup_pieces()` (받침 · 벽 넷 · 손가락 홈 벽 셋, 칸마다 9 조각), 바닥판 · 브라켓은 CoACD 뒤 `reduce_hull()` (꼭짓점 60 이하, 원래 꼭짓점의 부분 집합). 정밀 판 조각 478 -> 202.
   확인: 상자 · 원기둥 퍽 자리 침범 0 (USD 안 형상), 칸에 떨어뜨리기 23/24 (퍽 마찰 0.5). 팀 접촉 재질 마찰 1.0 그대로면 틈 1 mm 칸에서 퍽이 끼여 8/24 — 퍽 · 팔레트 마찰 실측 필요.
10. **팔레트 · 팀 집게 맞춤 (Isaac 놓기 확인)**: 손가락 끝 폭 (충돌 상자) 약 26 mm > 손가락 홈 24 mm (설계는 손가락 20 mm, 놓을 때 손가락-칸 중앙값 20 N),
    ±147° · ±155.6° 칸 4곳에서 집게 몸 (gripper_roll_link) 이 뒤 프로파일 기둥에 닿음 -> **집게를 45° 기울여 놓아 24/24 (Isaac, 2026-11-02)**, joint5 한계 그대로 (손목 롤 180° 안은 위치 모드 한 바퀴 경계 · 케이블 감김으로 보류).
    이 4칸 퍽은 상자에서 집을 때부터 45° 로 쥠 (`isaac/rl/정책_학습기록.md` 4.15 절).
    자세한 내용은 `../isaac/rl/정책_학습기록.md` 4.15 절.
11. **증속벨트 v7 (2026-11-14)**: 44T → 22T (1 : 2.0), 아이들러 없음, 모터 축 x 46.80 → 49.49 (장공 −0.2 자리 49.29). 바퀴 관절 1.35 N·m · 14.660766 rad/s, `robot_params.json` 바퀴 effort · velocity · damping 0.12 · armature 0.00125 (기어비² 환산), sensors max_wheel_speed 14.6608. 생성기 `시뮬레이션_모델_B안` 에서 다시 만들어 옮김 (sensors.yaml · sensors.json 은 바뀐 줄만). Isaac 점검 값 정상, 직진 0.298 m, 제자리 회전 69.2° → 47.4° (바퀴 토크 0.75 배).
