developlcy-oss/Lv2_Cartlidar_Assignment/workspace/urdf_and_usd/isaac/urdf/waffle_4wd_full.urdf

<?xml version="1.0" encoding="utf-8"?>
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
<robot name="waffle_4wd">
  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
  <link name="base_link">
    <inertial>
      <origin rpy="0 0 0" xyz="-0.0235591481 0.00157478298 0.112753793" />
      <mass value="3.45166562" />
      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
    </inertial>
    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
  </link>
  <link name="wheel_left_front_link">
    <inertial>
      <origin rpy="0 0 0" xyz="-3.73856456e-09 -4.9541261e-10 0.00327452002" />
      <mass value="0.029626966" />
      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
    </inertial>
    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
  </link>
  <link name="wheel_right_front_link">
    <inertial>
      <origin rpy="0 0 0" xyz="-3.73856456e-09 4.95412616e-10 -0.00327452002" />
      <mass value="0.029626966" />
      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
    </inertial>
    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
  </link>
  <link name="wheel_left_rear_link">
    <inertial>
      <origin rpy="0 0 0" xyz="-3.73856456e-09 -4.9541261e-10 0.00327452002" />
      <mass value="0.029626966" />
      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
    </inertial>
    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
  </link>
  <link name="wheel_right_rear_link">
    <inertial>
      <origin rpy="0 0 0" xyz="-3.73856456e-09 4.95412616e-10 -0.00327452002" />
      <mass value="0.029626966" />
      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
    </inertial>
    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
  </link>
  <joint name="wheel_left_front_joint" type="continuous">
    <parent link="base_link" />
    <child link="wheel_left_front_link" />
    <origin rpy="-1.570796 0.000000 0.000000" xyz="0.0925 0.154600 0.026250" />
    <axis xyz="0.000000 0.000000 1.000000" />
    <limit effort="1.35" velocity="14.660766" />
    <dynamics damping="0.001" friction="0" />
  </joint>
  <joint name="wheel_right_front_joint" type="continuous">
    <parent link="base_link" />
    <child link="wheel_right_front_link" />
    <origin rpy="-1.570796 0.000000 0.000000" xyz="0.0925 -0.154600 0.026250" />
    <axis xyz="0.000000 0.000000 1.000000" />
    <limit effort="1.35" velocity="14.660766" />
    <dynamics damping="0.001" friction="0" />
  </joint>
  <joint name="wheel_left_rear_joint" type="continuous">
    <parent link="base_link" />
    <child link="wheel_left_rear_link" />
    <origin rpy="-1.570796 0.000000 0.000000" xyz="-0.0675 0.154600 0.026250" />
    <axis xyz="0.000000 0.000000 1.000000" />
    <limit effort="1.35" velocity="14.660766" />
    <dynamics damping="0.001" friction="0" />
  </joint>
  <joint name="wheel_right_rear_joint" type="continuous">
    <parent link="base_link" />
    <child link="wheel_right_rear_link" />
    <origin rpy="-1.570796 0.000000 0.000000" xyz="-0.0675 -0.154600 0.026250" />
    <axis xyz="0.000000 0.000000 1.000000" />
    <limit effort="1.35" velocity="14.660766" />
    <dynamics damping="0.001" friction="0" />
  </joint>
  <link name="top_camera_rear_link" />
  <joint name="top_camera_rear_link_fixed" type="fixed">
    <parent link="base_link" />
    <child link="top_camera_rear_link" />
    <origin rpy="0 0.61440981034685982 3.1415906941844423" xyz="-0.20790974 3.7923139e-06 0.483622598" />
  </joint>
  <link name="top_camera_rear_optical_frame" />
  <joint name="top_camera_rear_optical_frame_fixed" type="fixed">
    <parent link="top_camera_rear_link" />
    <child link="top_camera_rear_optical_frame" />
    <origin rpy="-1.5707963267948966 6.5742318757224187e-23 -1.5707963267948966" xyz="1.3877787807814457e-17 4.2351647362715017e-22 -1.1102230246251565e-16" />
  </joint>
  <link name="top_camera_rear_infra1_optical_frame" />
  <joint name="top_camera_rear_infra1_optical_frame_fixed" type="fixed">
    <parent link="top_camera_rear_optical_frame" />
    <child link="top_camera_rear_infra1_optical_frame" />
    <origin rpy="0.0 0.0 0.0" xyz="-0.02502057515084745 0.0 0.0" />
  </joint>
  <link name="top_camera_rear_infra2_optical_frame" />
  <joint name="top_camera_rear_infra2_optical_frame_fixed" type="fixed">
    <parent link="top_camera_rear_optical_frame" />
    <child link="top_camera_rear_infra2_optical_frame" />
    <origin rpy="0.0 0.0 0.0" xyz="0.02502057515084745 0.0 0.0" />
  </joint>
  <link name="top_camera_rear_color_optical_frame" />
  <joint name="top_camera_rear_color_optical_frame_fixed" type="fixed">
    <parent link="top_camera_rear_optical_frame" />
    <child link="top_camera_rear_color_optical_frame" />
    <origin rpy="-0.006414625214056129 -0.00351446723480746 0.003661241236996282" xyz="-0.04011553432792425 7.01552780810744e-05 -0.000182516494533047" />
  </joint>
  <link name="top_camera_front_link" />
  <joint name="top_camera_front_link_fixed" type="fixed">
    <parent link="base_link" />
    <child link="top_camera_front_link" />
    <origin rpy="0 0.61440981034685982 1.9594053509349003e-06" xyz="-0.0480902599 3.7923139e-06 0.483622598" />
  </joint>
  <link name="top_camera_front_optical_frame" />
  <joint name="top_camera_front_optical_frame_fixed" type="fixed">
    <parent link="top_camera_front_link" />
    <child link="top_camera_front_optical_frame" />
    <origin rpy="-1.5707963267948966 -6.5742318757224187e-23 -1.5707963267948966" xyz="-5.5511151231257827e-17 0 -5.5511151231257827e-17" />
  </joint>
  <link name="top_camera_front_infra1_optical_frame" />
  <joint name="top_camera_front_infra1_optical_frame_fixed" type="fixed">
    <parent link="top_camera_front_optical_frame" />
    <child link="top_camera_front_infra1_optical_frame" />
    <origin rpy="0.0 0.0 0.0" xyz="-0.02502057515084745 0.0 0.0" />
  </joint>
  <link name="top_camera_front_infra2_optical_frame" />
  <joint name="top_camera_front_infra2_optical_frame_fixed" type="fixed">
    <parent link="top_camera_front_optical_frame" />
    <child link="top_camera_front_infra2_optical_frame" />
    <origin rpy="0.0 0.0 0.0" xyz="0.02502057515084745 0.0 0.0" />
  </joint>
  <link name="top_camera_front_color_optical_frame" />
  <joint name="top_camera_front_color_optical_frame_fixed" type="fixed">
    <parent link="top_camera_front_optical_frame" />
    <child link="top_camera_front_color_optical_frame" />
    <origin rpy="-0.006414625214056129 -0.00351446723480746 0.003661241236996282" xyz="-0.04011553432792425 7.01552780810744e-05 -0.000182516494533047" />
  </joint>
  <link name="base_footprint" />
  <link name="arm_base_link" />
  <link name="link2">
    <inertial>
      <origin rpy="0 0 0" xyz="0 0.000569 0.047433" />
      <mass value="0.104833" />
      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
    </inertial>
    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
  </link>
  <link name="link3">
    <inertial>
      <origin rpy="0 0 0" xyz="0.009162 0.000419 0.105999" />
      <mass value="0.142346" />
      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
    </inertial>
    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
  </link>
  <link name="link4">
    <inertial>
      <origin rpy="0 0 0" xyz="0.093290 0.000443 0.000000" />
      <mass value="0.134670" />
      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
    </inertial>
    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
  </link>
  <link name="link5">
    <inertial>
      <origin rpy="0 0 0" xyz="0.023194 0 0.006912" />
      <mass value="0.008694" />
      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
    </inertial>
    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
  </link>
  <link name="gripper_roll_link">
    <inertial>
      <origin rpy="0 0 0" xyz="0.048499 -0.000012 0.017596" />
      <mass value="0.267250" />
      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
    </inertial>
    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
  </link>
  <link name="gripper_left_link">
    <inertial>
      <origin rpy="0 0 0" xyz="0.007687 0.009183 0.000553" />
      <mass value="0.050414" />
      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
    </inertial>
    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
  </link>
  <link name="gripper_right_link">
    <inertial>
      <origin rpy="0 0 0" xyz="0.007681 -0.009183 -0.000553" />
      <mass value="0.050414" />
      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
    </inertial>
    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
  </link>
  <link name="tool_link" />
  <link name="arm_camera_link" />
  <link name="arm_camera_optical_frame" />
  <link name="gripper_motor_link">
    <inertial>
      <origin rpy="0 0 0" xyz="0 0 0" />
      <mass value="0.001" />
      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
    </inertial>
  </link>
  <link name="lds_front">
    <inertial>
      <origin rpy="0 0 0" xyz="-1.96272167e-05 -3.81448071e-19 -0.0110482239" />
      <mass value="0.042" />
      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
    </inertial>
    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
  </link>
  <link name="laser_front" />
  <link name="lds_rear">
    <inertial>
      <origin rpy="0 0 0" xyz="-1.96272167e-05 -3.81448071e-19 -0.0110482239" />
      <mass value="0.042" />
      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
    </inertial>
    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
  </link>
  <link name="laser_rear" />
  <link name="tfmini_bracket">
    <inertial>
      <origin rpy="0 0 0" xyz="0.0112301831 -1.22587929e-06 0.00577747606" />
      <mass value="0.00581055957" />
      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
    </inertial>
    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
  </link>
  <link name="tfmini_link">
    <inertial>
      <origin rpy="0 0 0" xyz="-0.0106056014 -1.59394844e-18 3.02235737e-05" />
      <mass value="0.012" />
      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
    </inertial>
    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
  </link>
  <link name="jetson_link">
    <inertial>
      <origin rpy="0 0 0" xyz="0.00347173567 0.00089678781 0.0131858117" />
      <mass value="0.176" />
      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
    </inertial>
    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
  </link>
  <link name="opencr_lower_link">
    <inertial>
      <origin rpy="0 0 0" xyz="0 0 0.0095" />
      <mass value="0.06" />
      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
    </inertial>
    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
  </link>
  <link name="opencr_upper_link">
    <inertial>
      <origin rpy="0 0 0" xyz="0 0 0.0095" />
      <mass value="0.06" />
      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
    </inertial>
    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
  </link>
  <joint name="base_footprint_joint" type="fixed">
    <parent link="base_link" />
    <child link="base_footprint" />
    <origin rpy="0 0 0" xyz="0 0 -0.00725" />
  </joint>
  <joint name="arm_base_joint" type="fixed">
    <origin rpy="0 0 0" xyz="0.096 0 0.131" />
    <parent link="base_link" />
    <child link="arm_base_link" />
  </joint>
  <joint name="joint1" type="revolute">
    <origin rpy="0 0 0" xyz="0 0 0" />
    <parent link="arm_base_link" />
    <child link="link2" />
    <axis xyz="0 0 1.000" />
    <limit effort="4.100000" lower="-3.14159" upper="3.14159" velocity="4.800000" />
    <dynamics damping="0.1" friction="0" />
  </joint>
  <joint name="joint2" type="revolute">
    <origin rpy="0 0 0" xyz="0 0 0.059500" />
    <parent link="link2" />
    <child link="link3" />
    <axis xyz="0 1.000 0" />
    <limit effort="4.100000" lower="-2.14" upper="1.6" velocity="4.800000" />
    <dynamics damping="0.1" friction="0" />
  </joint>
  <joint name="joint3" type="revolute">
    <origin rpy="0 0 0" xyz="0.024000 0 0.128000" />
    <parent link="link3" />
    <child link="link4" />
    <axis xyz="0 1.000 0" />
    <limit effort="4.100000" lower="-1.6" upper="1.6" velocity="4.800000" />
    <dynamics damping="0.1" friction="0" />
  </joint>
  <joint name="joint4" type="revolute">
    <origin rpy="0 0 0" xyz="0.124000 0 0" />
    <parent link="link4" />
    <child link="link5" />
    <axis xyz="0 1.000 0" />
    <limit effort="4.100000" lower="-1.92" upper="2.0" velocity="4.800000" />
    <dynamics damping="0.1" friction="0" />
  </joint>
  <joint name="joint5" type="revolute">
    <origin rpy="0 0 0" xyz="0.028000 0 0" />
    <parent link="link5" />
    <child link="gripper_roll_link" />
    <axis xyz="1.000 0 0" />
    <limit effort="4.100000" lower="-2.8" upper="2.8" velocity="4.800000" />
    <dynamics damping="0.1" friction="0" />
  </joint>
  <joint name="gripper_left_joint" type="prismatic">
    <origin rpy="0 0 0" xyz="0.094700 0.021000 0" />
    <parent link="gripper_roll_link" />
    <child link="gripper_left_link" />
    <axis xyz="0 1.000 0" />
    <limit effort="20.000000" lower="-0.011" upper="0.02" velocity="4.800000" />
    <dynamics damping="0.1" friction="0" />
  </joint>
  <joint name="gripper_right_joint" type="prismatic">
    <origin rpy="0 0 0" xyz="0.094700 -0.021000 0" />
    <parent link="gripper_roll_link" />
    <child link="gripper_right_link" />
    <axis xyz="0 -1.000 0" />
    <limit effort="20.000000" lower="-0.011" upper="0.02" velocity="4.800000" />
    <dynamics damping="0.1" friction="0" />
  </joint>
  <joint name="tool_joint" type="fixed">
    <origin rpy="0 0 0" xyz="0.139000 0 0" />
    <parent link="gripper_roll_link" />
    <child link="tool_link" />
  </joint>
  <joint name="arm_camera_joint" type="fixed">
    <origin rpy="0 0.261788 0" xyz="0.100256 0 0.077446" />
    <parent link="gripper_roll_link" />
    <child link="arm_camera_link" />
  </joint>
  <joint name="arm_camera_optical_joint" type="fixed">
    <origin rpy="-1.570796 0 -1.570796" xyz="0 0 0" />
    <parent link="arm_camera_link" />
    <child link="arm_camera_optical_frame" />
  </joint>
  <joint name="gripper_roll" type="revolute">
    <parent link="gripper_roll_link" />
    <child link="gripper_motor_link" />
    <origin rpy="0 0 0" xyz="0 0 0" />
    <axis xyz="1 0 0" />
    <limit effort="4.1" lower="-0.7946" upper="0.9541" velocity="4.8" />
  </joint>
  <joint name="lds_front_joint" type="fixed">
    <origin rpy="3.14159265 0 0" xyz="0.1318 0 0.0675" />
    <parent link="base_link" />
    <child link="lds_front" />
  </joint>
  <joint name="laser_front_joint" type="fixed">
    <origin rpy="0 0 0" xyz="0 0 0" />
    <parent link="lds_front" />
    <child link="laser_front" />
  </joint>
  <joint name="lds_rear_joint" type="fixed">
    <origin rpy="3.14159265 0 3.14159265" xyz="-0.1318 0 0.0675" />
    <parent link="base_link" />
    <child link="lds_rear" />
  </joint>
  <joint name="laser_rear_joint" type="fixed">
    <origin rpy="0 0 0" xyz="0 0 0" />
    <parent link="lds_rear" />
    <child link="laser_rear" />
  </joint>
  <joint name="tfmini_bracket_joint" type="fixed">
    <origin rpy="0 0 0" xyz="0.103 0 0.012" />
    <parent link="base_link" />
    <child link="tfmini_bracket" />
  </joint>
  <joint name="tfmini_joint" type="fixed">
    <origin rpy="0 0 0" xyz="0.027 0 0.0123" />
    <parent link="tfmini_bracket" />
    <child link="tfmini_link" />
  </joint>
  <joint name="jetson_joint" type="fixed">
    <origin rpy="0 0 1.57079633" xyz="-0.0795 0 0.021" />
    <parent link="base_link" />
    <child link="jetson_link" />
  </joint>
  <joint name="opencr_lower_joint" type="fixed">
    <origin rpy="0 0 1.57079633" xyz="0.0095 0 0.018" />
    <parent link="base_link" />
    <child link="opencr_lower_link" />
  </joint>
  <joint name="opencr_upper_joint" type="fixed">
    <origin rpy="0 0 1.57079633" xyz="0.0095 0 0.0597" />
    <parent link="base_link" />
    <child link="opencr_upper_link" />
  </joint>
  <link name="imu_link" />
  <joint name="imu_joint" type="fixed">
    <origin rpy="0 0 0" xyz="0.0095 0 0.0202" />
    <parent link="base_link" />
    <child link="imu_link" />
  </joint>
</robot>
