developlcy-oss/Lv2_Cartlidar_Assignment/workspace/urdf_and_usd/waffle_4wd_description/urdf/waffle_4wd.urdf.xacro

<?xml version='1.0' encoding='utf-8'?>
<robot xmlns:xacro="http://www.ros.org/wiki/xacro" name="waffle_4wd">
  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
  <xacro:arg name="prefix" default=""/>
  <xacro:property name="prefix" value="$(arg prefix)"/>
  <xacro:arg name="collision" default="full"/>
  <xacro:property name="collision" value="$(arg collision)"/>
  <xacro:arg name="limit_margin" default="0"/>
  <xacro:property name="limit_margin" value="$(arg limit_margin)"/>
  <xacro:arg name="pucks" default="false"/>
  <xacro:property name="pucks" value="$(arg pucks)"/>
  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
  <link name="${prefix}base_link">
    <inertial>
      <origin xyz="-0.0235591481 0.00157478298 0.112753793" rpy="0 0 0"/>
      <mass value="3.45166562"/>
      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
    </inertial>
    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
    <xacro:if value="${collision == 'full'}">
      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
    </xacro:if>
    <xacro:if value="${collision == 'light'}">
      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
    </xacro:if>
  </link>
  <link name="${prefix}wheel_left_front_link">
    <inertial>
      <origin xyz="-3.73856456e-09 -4.9541261e-10 0.00327452002" rpy="0 0 0"/>
      <mass value="0.029626966"/>
      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
    </inertial>
    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
  </link>
  <link name="${prefix}wheel_right_front_link">
    <inertial>
      <origin xyz="-3.73856456e-09 4.95412616e-10 -0.00327452002" rpy="0 0 0"/>
      <mass value="0.029626966"/>
      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
    </inertial>
    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
  </link>
  <link name="${prefix}wheel_left_rear_link">
    <inertial>
      <origin xyz="-3.73856456e-09 -4.9541261e-10 0.00327452002" rpy="0 0 0"/>
      <mass value="0.029626966"/>
      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
    </inertial>
    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
  </link>
  <link name="${prefix}wheel_right_rear_link">
    <inertial>
      <origin xyz="-3.73856456e-09 4.95412616e-10 -0.00327452002" rpy="0 0 0"/>
      <mass value="0.029626966"/>
      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
    </inertial>
    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
  </link>
  <joint name="${prefix}wheel_left_front_joint" type="continuous">
    <parent link="${prefix}base_link"/>
    <child link="${prefix}wheel_left_front_link"/>
    <origin xyz="0.0925 0.154600 0.026250" rpy="-1.570796 0.000000 0.000000"/>
    <axis xyz="0.000000 0.000000 1.000000"/>
    <limit effort="1.35" velocity="14.660766"/>
    <dynamics damping="0.001" friction="0"/>
  </joint>
  <joint name="${prefix}wheel_right_front_joint" type="continuous">
    <parent link="${prefix}base_link"/>
    <child link="${prefix}wheel_right_front_link"/>
    <origin xyz="0.0925 -0.154600 0.026250" rpy="-1.570796 0.000000 0.000000"/>
    <axis xyz="0.000000 0.000000 1.000000"/>
    <limit effort="1.35" velocity="14.660766"/>
    <dynamics damping="0.001" friction="0"/>
  </joint>
  <joint name="${prefix}wheel_left_rear_joint" type="continuous">
    <parent link="${prefix}base_link"/>
    <child link="${prefix}wheel_left_rear_link"/>
    <origin xyz="-0.0675 0.154600 0.026250" rpy="-1.570796 0.000000 0.000000"/>
    <axis xyz="0.000000 0.000000 1.000000"/>
    <limit effort="1.35" velocity="14.660766"/>
    <dynamics damping="0.001" friction="0"/>
  </joint>
  <joint name="${prefix}wheel_right_rear_joint" type="continuous">
    <parent link="${prefix}base_link"/>
    <child link="${prefix}wheel_right_rear_link"/>
    <origin xyz="-0.0675 -0.154600 0.026250" rpy="-1.570796 0.000000 0.000000"/>
    <axis xyz="0.000000 0.000000 1.000000"/>
    <limit effort="1.35" velocity="14.660766"/>
    <dynamics damping="0.001" friction="0"/>
  </joint>
  <link name="${prefix}top_camera_rear_link"/>
  <joint name="${prefix}top_camera_rear_link_fixed" type="fixed">
    <parent link="${prefix}base_link"/>
    <child link="${prefix}top_camera_rear_link"/>
    <origin xyz="-0.20790974 3.7923139e-06 0.483622598" rpy="0 0.61440981034685982 3.1415906941844423"/>
  </joint>
  <link name="${prefix}top_camera_rear_optical_frame"/>
  <joint name="${prefix}top_camera_rear_optical_frame_fixed" type="fixed">
    <parent link="${prefix}top_camera_rear_link"/>
    <child link="${prefix}top_camera_rear_optical_frame"/>
    <origin xyz="1.3877787807814457e-17 4.2351647362715017e-22 -1.1102230246251565e-16" rpy="-1.5707963267948966 6.5742318757224187e-23 -1.5707963267948966"/>
  </joint>
  <link name="${prefix}top_camera_rear_infra1_optical_frame"/>
  <joint name="${prefix}top_camera_rear_infra1_optical_frame_fixed" type="fixed">
    <parent link="${prefix}top_camera_rear_optical_frame"/>
    <child link="${prefix}top_camera_rear_infra1_optical_frame"/>
    <origin xyz="-0.02502057515084745 0.0 0.0" rpy="0.0 0.0 0.0"/>
  </joint>
  <link name="${prefix}top_camera_rear_infra2_optical_frame"/>
  <joint name="${prefix}top_camera_rear_infra2_optical_frame_fixed" type="fixed">
    <parent link="${prefix}top_camera_rear_optical_frame"/>
    <child link="${prefix}top_camera_rear_infra2_optical_frame"/>
    <origin xyz="0.02502057515084745 0.0 0.0" rpy="0.0 0.0 0.0"/>
  </joint>
  <link name="${prefix}top_camera_rear_color_optical_frame"/>
  <joint name="${prefix}top_camera_rear_color_optical_frame_fixed" type="fixed">
    <parent link="${prefix}top_camera_rear_optical_frame"/>
    <child link="${prefix}top_camera_rear_color_optical_frame"/>
    <origin xyz="-0.04011553432792425 7.01552780810744e-05 -0.000182516494533047" rpy="-0.006414625214056129 -0.00351446723480746 0.003661241236996282"/>
  </joint>
  <link name="${prefix}top_camera_front_link"/>
  <joint name="${prefix}top_camera_front_link_fixed" type="fixed">
    <parent link="${prefix}base_link"/>
    <child link="${prefix}top_camera_front_link"/>
    <origin xyz="-0.0480902599 3.7923139e-06 0.483622598" rpy="0 0.61440981034685982 1.9594053509349003e-06"/>
  </joint>
  <link name="${prefix}top_camera_front_optical_frame"/>
  <joint name="${prefix}top_camera_front_optical_frame_fixed" type="fixed">
    <parent link="${prefix}top_camera_front_link"/>
    <child link="${prefix}top_camera_front_optical_frame"/>
    <origin xyz="-5.5511151231257827e-17 0 -5.5511151231257827e-17" rpy="-1.5707963267948966 -6.5742318757224187e-23 -1.5707963267948966"/>
  </joint>
  <link name="${prefix}top_camera_front_infra1_optical_frame"/>
  <joint name="${prefix}top_camera_front_infra1_optical_frame_fixed" type="fixed">
    <parent link="${prefix}top_camera_front_optical_frame"/>
    <child link="${prefix}top_camera_front_infra1_optical_frame"/>
    <origin xyz="-0.02502057515084745 0.0 0.0" rpy="0.0 0.0 0.0"/>
  </joint>
  <link name="${prefix}top_camera_front_infra2_optical_frame"/>
  <joint name="${prefix}top_camera_front_infra2_optical_frame_fixed" type="fixed">
    <parent link="${prefix}top_camera_front_optical_frame"/>
    <child link="${prefix}top_camera_front_infra2_optical_frame"/>
    <origin xyz="0.02502057515084745 0.0 0.0" rpy="0.0 0.0 0.0"/>
  </joint>
  <link name="${prefix}top_camera_front_color_optical_frame"/>
  <joint name="${prefix}top_camera_front_color_optical_frame_fixed" type="fixed">
    <parent link="${prefix}top_camera_front_optical_frame"/>
    <child link="${prefix}top_camera_front_color_optical_frame"/>
    <origin xyz="-0.04011553432792425 7.01552780810744e-05 -0.000182516494533047" rpy="-0.006414625214056129 -0.00351446723480746 0.003661241236996282"/>
  </joint>
  <link name="${prefix}base_footprint"/>
  <link name="${prefix}arm_base_link"/>
  <link name="${prefix}link2">
    <inertial>
      <origin xyz="0 0.000569 0.047433" rpy="0 0 0"/>
      <mass value="0.104833"/>
      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
    </inertial>
    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
  </link>
  <link name="${prefix}link3">
    <inertial>
      <origin xyz="0.009162 0.000419 0.105999" rpy="0 0 0"/>
      <mass value="0.142346"/>
      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
    </inertial>
    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
  </link>
  <link name="${prefix}link4">
    <inertial>
      <origin xyz="0.093290 0.000443 0.000000" rpy="0 0 0"/>
      <mass value="0.134670"/>
      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
    </inertial>
    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
  </link>
  <link name="${prefix}link5">
    <inertial>
      <origin xyz="0.023194 0 0.006912" rpy="0 0 0"/>
      <mass value="0.008694"/>
      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
    </inertial>
    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
  </link>
  <link name="${prefix}gripper_roll_link">
    <inertial>
      <origin xyz="0.048499 -0.000012 0.017596" rpy="0 0 0"/>
      <mass value="0.267250"/>
      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
    </inertial>
    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
  </link>
  <link name="${prefix}gripper_left_link">
    <inertial>
      <origin xyz="0.007687 0.009183 0.000553" rpy="0 0 0"/>
      <mass value="0.050414"/>
      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
    </inertial>
    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
  </link>
  <link name="${prefix}gripper_right_link">
    <inertial>
      <origin xyz="0.007681 -0.009183 -0.000553" rpy="0 0 0"/>
      <mass value="0.050414"/>
      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
    </inertial>
    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
  </link>
  <link name="${prefix}tool_link"/>
  <link name="${prefix}arm_camera_link"/>
  <link name="${prefix}arm_camera_optical_frame"/>
  <link name="${prefix}gripper_motor_link">
    <inertial>
      <origin xyz="0 0 0" rpy="0 0 0"/>
      <mass value="0.001"/>
      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
    </inertial>
  </link>
  <link name="${prefix}lds_front">
    <inertial>
      <origin xyz="-1.96272167e-05 -3.81448071e-19 -0.0110482239" rpy="0 0 0"/>
      <mass value="0.042"/>
      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
    </inertial>
    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
  </link>
  <link name="${prefix}laser_front"/>
  <link name="${prefix}lds_rear">
    <inertial>
      <origin xyz="-1.96272167e-05 -3.81448071e-19 -0.0110482239" rpy="0 0 0"/>
      <mass value="0.042"/>
      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
    </inertial>
    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
  </link>
  <link name="${prefix}laser_rear"/>
  <link name="${prefix}tfmini_bracket">
    <inertial>
      <origin xyz="0.0112301831 -1.22587929e-06 0.00577747606" rpy="0 0 0"/>
      <mass value="0.00581055957"/>
      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
    </inertial>
    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
  </link>
  <link name="${prefix}tfmini_link">
    <inertial>
      <origin xyz="-0.0106056014 -1.59394844e-18 3.02235737e-05" rpy="0 0 0"/>
      <mass value="0.012"/>
      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
    </inertial>
    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
  </link>
  <link name="${prefix}jetson_link">
    <inertial>
      <origin xyz="0.00347173567 0.00089678781 0.0131858117" rpy="0 0 0"/>
      <mass value="0.176"/>
      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
    </inertial>
    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
  </link>
  <link name="${prefix}opencr_lower_link">
    <inertial>
      <origin xyz="0 0 0.0095" rpy="0 0 0"/>
      <mass value="0.06"/>
      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
    </inertial>
    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
  </link>
  <link name="${prefix}opencr_upper_link">
    <inertial>
      <origin xyz="0 0 0.0095" rpy="0 0 0"/>
      <mass value="0.06"/>
      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
    </inertial>
    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
  </link>
  <joint name="${prefix}base_footprint_joint" type="fixed">
    <parent link="${prefix}base_link"/>
    <child link="${prefix}base_footprint"/>
    <origin xyz="0 0 -0.00725" rpy="0 0 0"/>
  </joint>
  <joint name="${prefix}arm_base_joint" type="fixed">
    <origin xyz="0.096 0 0.131" rpy="0 0 0"/>
    <parent link="${prefix}base_link"/>
    <child link="${prefix}arm_base_link"/>
  </joint>
  <joint name="${prefix}joint1" type="revolute">
    <origin xyz="0 0 0" rpy="0 0 0"/>
    <parent link="${prefix}arm_base_link"/>
    <child link="${prefix}link2"/>
    <axis xyz="0 0 1.000"/>
    <limit lower="${-3.141590 - limit_margin}" upper="${3.141590 + limit_margin}" effort="4.100000" velocity="4.800000"/>
    <dynamics damping="0.1" friction="0"/>
  </joint>
  <joint name="${prefix}joint2" type="revolute">
    <origin xyz="0 0 0.059500" rpy="0 0 0"/>
    <parent link="${prefix}link2"/>
    <child link="${prefix}link3"/>
    <axis xyz="0 1.000 0"/>
    <limit lower="${-2.140000 - limit_margin}" upper="${1.600000 + limit_margin}" effort="4.100000" velocity="4.800000"/>
    <dynamics damping="0.1" friction="0"/>
  </joint>
  <joint name="${prefix}joint3" type="revolute">
    <origin xyz="0.024000 0 0.128000" rpy="0 0 0"/>
    <parent link="${prefix}link3"/>
    <child link="${prefix}link4"/>
    <axis xyz="0 1.000 0"/>
    <limit lower="${-1.600000 - limit_margin}" upper="${1.600000 + limit_margin}" effort="4.100000" velocity="4.800000"/>
    <dynamics damping="0.1" friction="0"/>
  </joint>
  <joint name="${prefix}joint4" type="revolute">
    <origin xyz="0.124000 0 0" rpy="0 0 0"/>
    <parent link="${prefix}link4"/>
    <child link="${prefix}link5"/>
    <axis xyz="0 1.000 0"/>
    <limit lower="${-1.920000 - limit_margin}" upper="${2.000000 + limit_margin}" effort="4.100000" velocity="4.800000"/>
    <dynamics damping="0.1" friction="0"/>
  </joint>
  <joint name="${prefix}joint5" type="revolute">
    <origin xyz="0.028000 0 0" rpy="0 0 0"/>
    <parent link="${prefix}link5"/>
    <child link="${prefix}gripper_roll_link"/>
    <axis xyz="1.000 0 0"/>
    <limit lower="${-2.800000 - limit_margin}" upper="${2.800000 + limit_margin}" effort="4.100000" velocity="4.800000"/>
    <dynamics damping="0.1" friction="0"/>
  </joint>
  <joint name="${prefix}gripper_left_joint" type="prismatic">
    <origin xyz="0.094700 0.021000 0" rpy="0 0 0"/>
    <parent link="${prefix}gripper_roll_link"/>
    <child link="${prefix}gripper_left_link"/>
    <axis xyz="0 1.000 0"/>
    <limit lower="${-0.011000 - limit_margin}" upper="${0.020000 + limit_margin}" effort="20.000000" velocity="4.800000"/>
    <dynamics damping="0.1" friction="0"/>
  </joint>
  <joint name="${prefix}gripper_right_joint" type="prismatic">
    <origin xyz="0.094700 -0.021000 0" rpy="0 0 0"/>
    <parent link="${prefix}gripper_roll_link"/>
    <child link="${prefix}gripper_right_link"/>
    <axis xyz="0 -1.000 0"/>
    <limit lower="${-0.011000 - limit_margin}" upper="${0.020000 + limit_margin}" effort="20.000000" velocity="4.800000"/>
    <dynamics damping="0.1" friction="0"/>
  </joint>
  <joint name="${prefix}tool_joint" type="fixed">
    <origin xyz="0.139000 0 0" rpy="0 0 0"/>
    <parent link="${prefix}gripper_roll_link"/>
    <child link="${prefix}tool_link"/>
  </joint>
  <joint name="${prefix}arm_camera_joint" type="fixed">
    <origin xyz="0.100256 0 0.077446" rpy="0 0.261788 0"/>
    <parent link="${prefix}gripper_roll_link"/>
    <child link="${prefix}arm_camera_link"/>
  </joint>
  <joint name="${prefix}arm_camera_optical_joint" type="fixed">
    <origin xyz="0 0 0" rpy="-1.570796 0 -1.570796"/>
    <parent link="${prefix}arm_camera_link"/>
    <child link="${prefix}arm_camera_optical_frame"/>
  </joint>
  <joint name="${prefix}gripper_roll" type="revolute">
    <parent link="${prefix}gripper_roll_link"/>
    <child link="${prefix}gripper_motor_link"/>
    <origin xyz="0 0 0" rpy="0 0 0"/>
    <axis xyz="1 0 0"/>
    <limit lower="${-0.794600 - limit_margin}" upper="${0.954100 + limit_margin}" effort="4.1" velocity="4.8"/>
  </joint>
  <joint name="${prefix}lds_front_joint" type="fixed">
    <origin xyz="0.1318 0 0.0675" rpy="3.14159265 0 0"/>
    <parent link="${prefix}base_link"/>
    <child link="${prefix}lds_front"/>
  </joint>
  <joint name="${prefix}laser_front_joint" type="fixed">
    <origin xyz="0 0 0" rpy="0 0 0"/>
    <parent link="${prefix}lds_front"/>
    <child link="${prefix}laser_front"/>
  </joint>
  <joint name="${prefix}lds_rear_joint" type="fixed">
    <origin xyz="-0.1318 0 0.0675" rpy="3.14159265 0 3.14159265"/>
    <parent link="${prefix}base_link"/>
    <child link="${prefix}lds_rear"/>
  </joint>
  <joint name="${prefix}laser_rear_joint" type="fixed">
    <origin xyz="0 0 0" rpy="0 0 0"/>
    <parent link="${prefix}lds_rear"/>
    <child link="${prefix}laser_rear"/>
  </joint>
  <joint name="${prefix}tfmini_bracket_joint" type="fixed">
    <origin xyz="0.103 0 0.012" rpy="0 0 0"/>
    <parent link="${prefix}base_link"/>
    <child link="${prefix}tfmini_bracket"/>
  </joint>
  <joint name="${prefix}tfmini_joint" type="fixed">
    <origin xyz="0.027 0 0.0123" rpy="0 0 0"/>
    <parent link="${prefix}tfmini_bracket"/>
    <child link="${prefix}tfmini_link"/>
  </joint>
  <joint name="${prefix}jetson_joint" type="fixed">
    <origin xyz="-0.0795 0 0.021" rpy="0 0 1.57079633"/>
    <parent link="${prefix}base_link"/>
    <child link="${prefix}jetson_link"/>
  </joint>
  <joint name="${prefix}opencr_lower_joint" type="fixed">
    <origin xyz="0.0095 0 0.018" rpy="0 0 1.57079633"/>
    <parent link="${prefix}base_link"/>
    <child link="${prefix}opencr_lower_link"/>
  </joint>
  <joint name="${prefix}opencr_upper_joint" type="fixed">
    <origin xyz="0.0095 0 0.0597" rpy="0 0 1.57079633"/>
    <parent link="${prefix}base_link"/>
    <child link="${prefix}opencr_upper_link"/>
  </joint>
  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
  <link name="${prefix}imu_link"/>
  <joint name="${prefix}imu_joint" type="fixed">
    <origin xyz="0.0095 0 0.0202" rpy="0 0 0"/>
    <parent link="${prefix}base_link"/>
    <child link="${prefix}imu_link"/>
  </joint>
  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
  <xacro:if value="${pucks}">
    <link name="${prefix}puck_R_1">
      <inertial>
        <origin xyz="0 0 0" rpy="0 0 0"/>
        <mass value="0.013"/>
        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
      </inertial>
      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
    </link>
    <joint name="${prefix}puck_R_1_joint" type="fixed">
      <parent link="${prefix}base_link"/>
      <child link="${prefix}puck_R_1"/>
      <origin xyz="0.0556699 0.0826891 0.150000001" rpy="0 -0 2.02458193"/>
    </joint>
    <link name="${prefix}puck_R_2">
      <inertial>
        <origin xyz="0 0 0" rpy="0 0 0"/>
        <mass value="0.017"/>
        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
      </inertial>
      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
    </link>
    <joint name="${prefix}puck_R_2_joint" type="fixed">
      <parent link="${prefix}base_link"/>
      <child link="${prefix}puck_R_2"/>
      <origin xyz="0.0113136 0.0359473 0.150000001" rpy="0 -0 2.74016693"/>
    </joint>
    <link name="${prefix}puck_R_3">
      <inertial>
        <origin xyz="0 0 0" rpy="0 0 0"/>
        <mass value="0.013"/>
        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
      </inertial>
      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
    </link>
    <joint name="${prefix}puck_R_3_joint" type="fixed">
      <parent link="${prefix}base_link"/>
      <child link="${prefix}puck_R_3"/>
      <origin xyz="0.0113136 -0.0359473 0.150000001" rpy="0 -0 -2.74016693"/>
    </joint>
    <link name="${prefix}puck_R_4">
      <inertial>
        <origin xyz="0 0 0" rpy="0 0 0"/>
        <mass value="0.017"/>
        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
      </inertial>
      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
    </link>
    <joint name="${prefix}puck_R_4_joint" type="fixed">
      <parent link="${prefix}base_link"/>
      <child link="${prefix}puck_R_4"/>
      <origin xyz="0.0556699 -0.0826891 0.150000001" rpy="0 -0 -2.02458193"/>
    </joint>
    <link name="${prefix}puck_G_1">
      <inertial>
        <origin xyz="0 0 0" rpy="0 0 0"/>
        <mass value="0.017"/>
        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
      </inertial>
      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
    </link>
    <joint name="${prefix}puck_G_1_joint" type="fixed">
      <parent link="${prefix}base_link"/>
      <child link="${prefix}puck_G_1"/>
      <origin xyz="-0.013571 0.0903231 0.156000001" rpy="0 -0 2.4521876"/>
    </joint>
    <link name="${prefix}puck_G_2">
      <inertial>
        <origin xyz="0 0 0" rpy="0 0 0"/>
        <mass value="0.013"/>
        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
      </inertial>
      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
    </link>
    <joint name="${prefix}puck_G_2_joint" type="fixed">
      <parent link="${prefix}base_link"/>
      <child link="${prefix}puck_G_2"/>
      <origin xyz="-0.042077 0.0331492 0.156000001" rpy="0 -0 2.9059732"/>
    </joint>
    <link name="${prefix}puck_G_3">
      <inertial>
        <origin xyz="0 0 0" rpy="0 0 0"/>
        <mass value="0.017"/>
        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
      </inertial>
      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
    </link>
    <joint name="${prefix}puck_G_3_joint" type="fixed">
      <parent link="${prefix}base_link"/>
      <child link="${prefix}puck_G_3"/>
      <origin xyz="-0.042077 -0.0331492 0.156000001" rpy="0 -0 -2.9059732"/>
    </joint>
    <link name="${prefix}puck_G_4">
      <inertial>
        <origin xyz="0 0 0" rpy="0 0 0"/>
        <mass value="0.013"/>
        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
      </inertial>
      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
    </link>
    <joint name="${prefix}puck_G_4_joint" type="fixed">
      <parent link="${prefix}base_link"/>
      <child link="${prefix}puck_G_4"/>
      <origin xyz="-0.013571 -0.0903231 0.156000001" rpy="0 -0 -2.4521876"/>
    </joint>
    <link name="${prefix}puck_B_1">
      <inertial>
        <origin xyz="0 0 0" rpy="0 0 0"/>
        <mass value="0.013"/>
        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
      </inertial>
      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
    </link>
    <joint name="${prefix}puck_B_1_joint" type="fixed">
      <parent link="${prefix}base_link"/>
      <child link="${prefix}puck_B_1"/>
      <origin xyz="-0.090826 0.0397111 0.162000001" rpy="0 -0 2.93215314"/>
    </joint>
    <link name="${prefix}puck_B_2">
      <inertial>
        <origin xyz="0 0 0" rpy="0 0 0"/>
        <mass value="0.017"/>
        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
      </inertial>
      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
    </link>
    <joint name="${prefix}puck_B_2_joint" type="fixed">
      <parent link="${prefix}base_link"/>
      <child link="${prefix}puck_B_2"/>
      <origin xyz="-0.090826 -0.0397111 0.162000001" rpy="0 -0 -2.93215314"/>
    </joint>
  </xacro:if>
</robot>
