developlcy-oss/Lv2_Cartlidar_Assignment/workspace/ros2_ws/src/opencr_hardware/urdf/robot.urdf.xacro

<?xml version="1.0"?>
<!-- 퍽 운반 로봇 URDF (Firmware 팀) — TF 트리 · ros2_control.
     링크 위치 · 관절 원점은 값이 확정되지 않아 ★ 표시한 자리값이다 (Perception 팀이 센서 장착 위치 제공).
     형상(visual/collision)은 넣지 않았다. waffle_4wd 메시를 쓰려면 base_link 에 visual 을 추가한다. -->
<robot name="puckbot" xmlns:xacro="http://www.ros.org/wiki/xacro">
  <xacro:arg name="wheel_count" default="4"/>   <!-- 주행 펌웨어 WHEEL_COUNT 와 같게 (2026-10-26 가운데 2개 제거) -->
  <xacro:arg name="use_gripper" default="false"/>
  <xacro:arg name="ports" default="/dev/ttyACM0,/dev/ttyACM1"/>
  <xacro:arg name="joy_required" default="true"/>
  <!-- 구동 방식: belt = 증속벨트 1:2.0 (v7 44T → 22T, 2026-11-14 설계 · 1:1.5 는 2026-10-27 장착), direct = 직결 (urdfv2). 바퀴 y · 한계 · 기어비가 같이 바뀐다 -->
  <xacro:arg name="drive" default="belt"/>
  <xacro:arg name="backend" default="opencr"/>   <!-- 하드웨어 플러그인: opencr (실물) | mock (장치 없이) | isaac (opencr.ros2_control.xacro) -->
  <!-- 예전 이름 sim 은 launch 에서만 받는다 (sim:=true → backend:=isaac). xacro 에 직접 주면 모르는 인자로 무시돼 실물로 펼쳐지므로 막음 -->
  <xacro:arg name="sim" default="false"/>
  <xacro:if value="$(arg sim)">
    ${xacro.fatal("sim 은 예전 이름 — xacro 에는 backend:=isaac")}
  </xacro:if>
  <xacro:include filename="$(find opencr_hardware)/urdf/opencr.ros2_control.xacro"/>

  <xacro:property name="wheel_count" value="$(arg wheel_count)"/>
  <xacro:property name="drive" value="$(arg drive)"/>
  <xacro:if value="${drive not in ['direct', 'belt']}">
    ${xacro.fatal("drive 는 direct 또는 belt: " + drive)}
  </xacro:if>
  <xacro:property name="belt" value="${drive == 'belt'}"/>
  <!-- 좌표 기준 = 팀 기준 모델 workspace/urdf_and_usd/waffle_4wd_description (B안, PR #50).
       base_link 원점 = 그 모델과 같음 (TurtleBot3 Waffle 1층 하판 가운데, 하판 밑면 3.0 mm 아래 = 바닥 위 7.25 mm. 하판은 바닥 위 10.25~19.25 mm, 2026-11-13 바퀴 반지름 0.0335. 실측법 Downloads 실측_바퀴/실측_방법.md).
       센서 · 바퀴 x · 축 높이는 그 모델 값. 바퀴 |y| 는 drive_<belt|direct>.yaml wheel_separation 과 묶여 있어 그대로 둔다.
       관절 이름은 ros2_control · 컨트롤러 설정 때문에 기존 이름 유지:
       wheel_left_front = wheel_fl · wheel_left_rear = wheel_rl · wheel_right_front = wheel_fr · wheel_right_rear = wheel_rr -->
  <!-- belt: 증속벨트 설계 (구동_증속벨트 drive_belt.scad · ref/wheels_shifted15.stl) — 바퀴를 바깥으로 15 mm, x · 축 높이는 직결과 같음.
       y 0.1585 는 설계 차체 기준 절대값 (설계 직결 |y| 143.5 ≠ urdfv2 직결 137.2, 기준 모델 0.1546) ★ 장착 후 바퀴 간격 실측 -->
  <xacro:property name="wheel_y" value="${0.1585 if belt else 0.1372}"/>   <!-- 바퀴 중심 |y| (간격 belt 0.317 · direct 0.2744) -->
  <xacro:property name="wheel_x_front" value="0.0925"/>   <!-- 앞바퀴 x (기준 모델) -->
  <xacro:property name="wheel_x_rear" value="-0.0675"/>   <!-- 뒤바퀴 x (기준 모델) -->
  <xacro:property name="wheel_gear" value="${2.0 if belt else 1.0}"/>      <!-- 바퀴 각속도 / 모터 각속도 (v7 모터 44T → 바퀴 22T, 이전 v6 36T → 24T = 1.5) -->
  <xacro:property name="wheel_z" value="0.02625"/>    <!-- 바퀴 중심 z (base_link 위, 기준 모델) -->
  <xacro:property name="wheel_radius" value="0.0335"/> <!-- Ø67 (2026-11-13 홈 채운 림 R31.5 + 타이어, 이전 Ø66 0.033). controllers_4wd.yaml wheel_radius 와 같게 -->

  <link name="base_link"/>
  <!-- 바닥 투영: 바퀴 중심 아래 반지름만큼 = base_link 아래 7.25 mm (기준 모델과 같음) -->
  <link name="base_footprint"/>
  <joint name="base_footprint_joint" type="fixed">
    <parent link="base_link"/>
    <child link="base_footprint"/>
    <origin xyz="0 0 ${wheel_z - wheel_radius}" rpy="0 0 0"/>
  </joint>

  <!-- 바퀴 축 = +y (4개 모두) → + 회전 = 앞으로 굴러감 (urdfv2 와 같음). 오른쪽 모터 반전은 펌웨어 WHEEL_DIR 가 한다 -->
  <xacro:macro name="wheel" params="name x y">
    <link name="${name}_link"/>
    <joint name="${name}_joint" type="continuous">
      <parent link="base_link"/>
      <child link="${name}_link"/>
      <origin xyz="${x} ${y} ${wheel_z}" rpy="0 0 0"/>
      <axis xyz="0 1 0"/>
      <!-- XM430-W210 11.1 V (3S 배터리 공칭, #15 2026-11-09): 2.7 N·m, 무부하 70 rpm (7.330383 rad/s)
           → 바퀴 기준 토크 ÷ 기어비, 속도 × 기어비. belt (v7 1:2.0) 1.35 N·m · 14.660766 rad/s = Isaac 모델과 같음 -->
      <limit effort="${2.7 / wheel_gear}" velocity="${7.330383 * wheel_gear}"/>
    </joint>
  </xacro:macro>
  <xacro:wheel name="wheel_left_front" x="${wheel_x_front}" y="${wheel_y}"/>
  <xacro:wheel name="wheel_left_rear" x="${wheel_x_rear}" y="${wheel_y}"/>
  <xacro:wheel name="wheel_right_front" x="${wheel_x_front}" y="${-wheel_y}"/>
  <xacro:wheel name="wheel_right_rear" x="${wheel_x_rear}" y="${-wheel_y}"/>
  <xacro:if value="${wheel_count == 6}">
    <xacro:wheel name="wheel_left_mid" x="0" y="${wheel_y}"/>
    <xacro:wheel name="wheel_right_mid" x="0" y="${-wheel_y}"/>
  </xacro:if>

  <!-- 센서 (정적): 위치 · 방향은 기준 모델 waffle_4wd_description 값 ★ 실물 나오면 확인 -->
  <xacro:macro name="fixed_link" params="name parent xyz rpy">
    <link name="${name}"/>
    <joint name="${name}_joint" type="fixed">
      <parent link="${parent}"/>
      <child link="${name}"/>
      <origin xyz="${xyz}" rpy="${rpy}"/>
    </joint>
  </xacro:macro>
  <!-- OpenCR 내장 IMU (주행 보드, 2층으로 쌓은 OpenCR 중 아래 보드 하나만 쓴다). ekf 가 이 TF 로 yaw rate 를 base_link 로 돌린다.
       보드는 바로 놓여 있다 (보드 z 위, 2026-11-02 확인). 위에서 봐서 반시계로 돌리면 /imu/data angular_velocity.z 는 양수.
       실물 보드는 +y 가 차체 앞이다 (2026-11-09 실물: 앞을 들면 가속도 y 가 +) → yaw -90°. Isaac 은 IMU 가 차체 축 그대로라 0 -->
  <xacro:fixed_link name="imu_link" parent="base_link" xyz="0.0095 0 0.0202" rpy="0 0 ${-pi/2 if '$(arg backend)' == 'opencr' else 0.0}"/>
  <!-- LDS-03 은 뒤집어 장착 → roll π. 기준 모델 lds_front · lds_rear (laser_* 는 그 자리와 같음). 안 뒤집으면 스캔 좌우가 뒤집힌다 (docs/frames_tf.md)
       LDS-03 브라켓 v2 (2026-11-13 실물 확인, #249): 기준 모델 a1cea6e 와 같은 (±0.1318, 0, 0.0675). 이전 v1 (±0.1089, 0, 0.0755) -->
  <xacro:fixed_link name="laser_front" parent="base_link" xyz="0.1318 0 0.0675" rpy="3.141593 0 0"/>
  <xacro:fixed_link name="laser_rear" parent="base_link" xyz="-0.1318 0 0.0675" rpy="3.141593 0 3.141593"/>
  <!-- D435: realsense2_camera (camera_name top_camera_front · top_camera_rear) 의 TF 뿌리는 <camera_name>_link = 왼쪽 IR (깊이 원점).
       그 아래 광학 프레임은 드라이버가 공장 외부 보정값으로 낸다 (여기서 또 만들면 TF 부모가 둘이 된다).
       기준 모델 top_camera_*_link 는 두 IR 의 가운데라, 왼쪽 IR (광학 x −0.02502 = 카메라 기준 왼쪽) 로 옮겼다: 앞 y +0.02502 · 뒤 y −0.02502 -->
  <!-- 앞 D435 피치는 실물 실측값 (2026-11-12): 기준 모델 0.6144098 (35.20°) 보다 2.59° 덜 숙여져 0.5692410 (32.62°).
       노트북 화면 태그 판 PnP 4 번(−2.50 ~ −2.65°) · 깊이 책상 평면(−2.42°)이 같은 값. 롤은 한계 0.7° 안이라 그대로, 요는 아직 재지 않음.
       뒤 D435 피치도 실물 실측값 (2026-11-12 · 13): 기준 모델 0.6144098 (35.20°) 보다 1.25° 덜 숙여져 0.5926 (33.95°).
       깊이 바닥 평면 RD +1.25° (판 정지 +0.8 ~ +1.5°), 고친 값으로 다른 바닥 자리 RD2 · RD3 남은 +0.19 · +0.18°. 롤은 한계 0.7° 안이라 그대로 -->
  <xacro:fixed_link name="top_camera_front_link" parent="base_link" xyz="-0.0480903 0.0250244 0.4836226" rpy="0 0.5692410 0"/>
  <xacro:fixed_link name="top_camera_rear_link" parent="base_link" xyz="-0.2079097 -0.0250168 0.4836226" rpy="0 0.5926 3.141593"/>
  <!-- 팔 받침: joint2 축이 기준 모델과 같은 자리 (base_link 기준 0.096 0 0.1905) 에 오게 둔다.
       기준 모델은 arm_base_link → joint2 0.0595 이지만 이 파일 · manipulator.yaml 링크 길이는 그대로 둔다 (0.077) -->
  <xacro:fixed_link name="arm_base_link" parent="base_link" xyz="0.096 0 0.1135" rpy="0 0 0"/>

  <!-- 팔 (joint1 요 · joint2~4 피치 · joint5 손목 롤 · gripper_roll) — 길이는 manipulator.yaml 과 같게 ★ -->
  <xacro:macro name="arm_joint" params="name parent child xyz axis lower upper">
    <link name="${child}"/>
    <joint name="${name}" type="revolute">
      <parent link="${parent}"/>
      <child link="${child}"/>
      <origin xyz="${xyz}" rpy="0 0 0"/>
      <axis xyz="${axis}"/>
      <limit lower="${lower}" upper="${upper}" effort="4.1" velocity="4.8"/>
    </joint>
  </xacro:macro>
  <!-- 팔 관절 한계 = 펌웨어 config.h ARM_MIN/MAX_RAD (2026-10-27 arm_bench 이식: 대기 자세 A안 · J1 ±180° · 그리퍼 다시 결합).
       6 번째 칸 (gripper_roll) 은 실물로는 그리퍼 개폐 모터 (ID 15, 열림 1550 · 닫힘 2650 tick = -0.7946 ~ 0.9541 rad) — 이름은 Controller 코드 때문에 그대로 ★ -->
  <xacro:arm_joint name="joint1" parent="arm_base_link" child="link1" xyz="0 0 0.077" axis="0 0 1" lower="-3.14159" upper="3.14159"/>
  <xacro:arm_joint name="joint2" parent="link1" child="link2" xyz="0 0 0" axis="0 1 0" lower="-2.14" upper="1.6"/>
  <xacro:arm_joint name="joint3" parent="link2" child="link3" xyz="0.024 0 0.128" axis="0 1 0" lower="-1.6" upper="1.6"/>
  <xacro:arm_joint name="joint4" parent="link3" child="link4" xyz="0.124 0 0" axis="0 1 0" lower="-1.92" upper="2.0"/>
  <xacro:arm_joint name="joint5" parent="link4" child="link5" xyz="0.04 0 0" axis="1 0 0" lower="-2.8" upper="2.8"/>
  <xacro:arm_joint name="gripper_roll" parent="link5" child="gripper_roll_link" xyz="0.041 0 0" axis="1 0 0" lower="-0.7946" upper="0.9541"/>
  <!-- Arducam: 그리퍼 몸체에 장착 (2026-10-28 확인). UVC 드라이버 frame_id = arm_camera_optical_frame (광학 축: +z 앞 · +x 오른쪽 · +y 아래)
       부모는 손목 롤 뒤 link5 (gripper_roll_link 는 그리퍼 개폐 모터라 그 아래 두면 집게를 여닫을 때 카메라 좌표가 돈다).
       위치 · 방향은 기준 모델 arm_camera_joint (joint4 축에서 0.128256 0 0.077446, 아래로 15°) — link5 는 joint4 축에서 x 0.04 -->
  <xacro:fixed_link name="arm_camera_link" parent="link5" xyz="0.088256 0 0.077446" rpy="0 0.261788 0"/>
  <xacro:fixed_link name="arm_camera_optical_frame" parent="arm_camera_link" xyz="0 0 0" rpy="-1.570796 0 -1.570796"/>
  <!-- TFmini Plus: 차체 1층 플레이트 앞 가운데 받침대 (2026-10-28 확인, 받침대 설계 2026-10-31). 퍽이 놓인 박스 앞면 거리 → drive FINE · obstacle_stop.
       원점 = 렌즈면, +x 앞. 기준 모델 tfmini_link: 바닥 위 31.05 mm = base_link(바닥 위 6.75 mm) 기준 z +0.0243 ★ 실측
       팔 끝 → 퍽 거리(/arm_range)는 TFmini 가 아니라 perception 계산값 (manipulator range_frame = tool_link) -->
  <xacro:fixed_link name="tfmini_link" parent="base_link" xyz="0.130 0 0.0243" rpy="0 0 0"/>

  <xacro:fixed_link name="tool_link" parent="gripper_roll_link" xyz="0.086 0 0" rpy="0 0 0"/>

  <xacro:opencr_ros2_control ports="$(arg ports)" wheel_count="${wheel_count}" use_gripper="$(arg use_gripper)" joy_required="$(arg joy_required)" wheel_gear="${wheel_gear}" backend="$(arg backend)"/>
</robot>
