developlcy-oss/Lv2_Cartlidar_Assignment/workspace/tools/arm_bench/urdf/arm_bench.urdf

<?xml version='1.0' encoding='utf-8'?>
<robot name="arm_bench">
  <!-- 자동 생성: tools/make_arm_urdf.py (2026-10-27 12:49). 원천 /home/pa31/GIT/FreeCAD/TeamRobot/URDF/cartridar_01.urdf (sha256 e8a56eeed6d59e14) 의 link1 아래 팔만. 루트 arm_base = 받침대 윗면 (J1 서보 바닥), link1 은 그 위 17 mm. 직접 고치지 말 것 -->
  <!-- 관절 한계 = 펌웨어 config.h ARM_MIN/MAX_RAD (실물). 원천과 다른 관절: joint1 -3.142~+3.142, joint2 -1.500~+1.500, joint3 -1.500~+1.400, joint4 -1.700~+2.164, wrist_roll_joint -3.142~+3.142 -->
  <material name="c_060060060">
    <color rgba="0.60 0.60 0.60 1" />
  </material>
  <material name="c_025025030">
    <color rgba="0.25 0.25 0.30 1" />
  </material>
  <material name="c_015015015">
    <color rgba="0.15 0.15 0.15 1" />
  </material>
  <material name="c_095055010">
    <color rgba="0.95 0.55 0.10 1" />
  </material>
  <material name="c_030030035">
    <color rgba="0.30 0.30 0.35 1" />
  </material>
  <material name="c_080080080">
    <color rgba="0.80 0.80 0.80 1" />
  </material>
  <material name="c_095050010">
    <color rgba="0.95 0.50 0.10 1" />
  </material>
  <material name="c_035035035">
    <color rgba="0.35 0.35 0.35 1" />
  </material>
  <material name="c_025025025">
    <color rgba="0.25 0.25 0.25 1" />
  </material>
  <link name="arm_base" />
  <joint name="arm_mount_joint" type="fixed">
    <parent link="arm_base" />
    <child link="link1" />
    <origin xyz="0 0 0.017" rpy="0 0 0" />
  </joint>
  <link name="link1">
    <inertial>
      <origin xyz="0.000309 0 -0.000122" rpy="0 0 0" />
      <mass value="0.094011" />
      <inertia ixx="1.4859e-05" ixy="0.0000e+00" ixz="-2.1216e-07" iyy="2.6020e-05" iyz="0.0000e+00" izz="2.2894e-05" />
    </inertial>
    <visual>
      <origin xyz="0 0 0" rpy="0 0 0" />
      <geometry>
        <mesh filename="meshes/link1_0.stl" />
      </geometry>
      <material name="c_015015015" />
    </visual>
    <collision>
      <origin xyz="0 0 0.003200" rpy="0 0 0" />
      <geometry>
        <box size="0.046500 0.028500 0.040400" />
      </geometry>
    </collision>
  </link>
  <link name="link2">
    <inertial>
      <origin xyz="0 0.000569 0.047433" rpy="0 0 0" />
      <mass value="0.104833" />
      <inertia ixx="3.3802e-05" ixy="0.0000e+00" ixz="0.0000e+00" iyy="2.9569e-05" iyz="-2.2122e-07" izz="1.7610e-05" />
    </inertial>
    <visual>
      <origin xyz="0 0 0" rpy="0 0 0" />
      <geometry>
        <mesh filename="meshes/link2_0.stl" />
      </geometry>
      <material name="c_080080080" />
    </visual>
    <visual>
      <origin xyz="0 0 0" rpy="0 0 0" />
      <geometry>
        <mesh filename="meshes/link2_1.stl" />
      </geometry>
      <material name="c_015015015" />
    </visual>
    <collision>
      <origin xyz="0 0.013841 0.024750" rpy="0 0 0" />
      <geometry>
        <box size="0.028000 0.009319 0.011500" />
      </geometry>
    </collision>
    <collision>
      <origin xyz="0 0.004645 0.019750" rpy="0 0 0" />
      <geometry>
        <box size="0.028000 0.009310 0.001500" />
      </geometry>
    </collision>
    <collision>
      <origin xyz="0 -0.004645 0.019750" rpy="0 0 0" />
      <geometry>
        <box size="0.028000 0.009310 0.001500" />
      </geometry>
    </collision>
    <collision>
      <origin xyz="0 -0.013841 0.024750" rpy="0 0 0" />
      <geometry>
        <box size="0.028000 0.009319 0.011500" />
      </geometry>
    </collision>
    <collision>
      <origin xyz="0 0.002200 0.047500" rpy="0 0 0" />
      <geometry>
        <box size="0.028500 0.042400 0.046500" />
      </geometry>
    </collision>
  </link>
  <link name="link3">
    <inertial>
      <origin xyz="0.009162 0.000419 0.105999" rpy="0 0 0" />
      <mass value="0.142346" />
      <inertia ixx="2.3711e-04" ixy="-2.7514e-07" ixz="-2.6667e-05" iyy="2.4488e-04" iyz="-1.3127e-06" izz="4.2967e-05" />
    </inertial>
    <visual>
      <origin xyz="0 0 0" rpy="0 0 0" />
      <geometry>
        <mesh filename="meshes/link3_0.stl" />
      </geometry>
      <material name="c_080080080" />
    </visual>
    <visual>
      <origin xyz="0 0 0" rpy="0 0 0" />
      <geometry>
        <mesh filename="meshes/link3_1.stl" />
      </geometry>
      <material name="c_015015015" />
    </visual>
    <collision>
      <origin xyz="0 0.015745 0.013000" rpy="0 0 0" />
      <geometry>
        <box size="0.025000 0.010510 0.031000" />
      </geometry>
    </collision>
    <collision>
      <origin xyz="0 0.005250 0.025250" rpy="0 0 0" />
      <geometry>
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
      <geometry>
        <box size="0.007960 0.008000 0.005667" />
      </geometry>
    </collision>
    <collision>
      <origin xyz="0.044600 -0.001964 0" rpy="0 0 0" />
      <geometry>
        <box size="0.037000 0.004300 0.014000" />
      </geometry>
    </collision>
  </link>
  <link name="end_effector_link" />
  <link name="gripper_camera_link" />
  <link name="gripper_camera_optical_frame" />
  <joint name="joint1" type="revolute">
    <origin xyz="0.012000 0 0" rpy="0 0 0" />
    <parent link="link1" />
    <child link="link2" />
    <axis xyz="0 0 1.000" />
    <limit lower="-3.141590" upper="3.141590" effort="4.100000" velocity="4.800000" />
    <dynamics damping="0.1" friction="0" />
  </joint>
  <joint name="joint2" type="revolute">
    <origin xyz="0 0 0.059500" rpy="0 0 0" />
    <parent link="link2" />
    <child link="link3" />
    <axis xyz="0 1.000 0" />
    <limit lower="-2.140000" upper="1.600000" effort="4.100000" velocity="4.800000" />
    <dynamics damping="0.1" friction="0" />
  </joint>
  <joint name="joint3" type="revolute">
    <origin xyz="0.024000 0 0.128000" rpy="0 0 0" />
    <parent link="link3" />
    <child link="link4" />
    <axis xyz="0 1.000 0" />
    <limit lower="-1.600000" upper="1.600000" effort="4.100000" velocity="4.800000" />
    <dynamics damping="0.1" friction="0" />
  </joint>
  <joint name="joint4" type="revolute">
    <origin xyz="0.124000 0 0" rpy="0 0 0" />
    <parent link="link4" />
    <child link="link5" />
    <axis xyz="0 1.000 0" />
    <limit lower="-1.920000" upper="2.000000" effort="4.100000" velocity="4.800000" />
    <dynamics damping="0.1" friction="0" />
  </joint>
  <joint name="wrist_roll_joint" type="revolute">
    <origin xyz="0.028000 0 0" rpy="0 0 0" />
    <parent link="link5" />
    <child link="gripper_link" />
    <axis xyz="1.000 0 0" />
    <limit lower="-2.800000" upper="2.800000" effort="4.100000" velocity="4.800000" />
    <dynamics damping="0.1" friction="0" />
  </joint>
  <joint name="gripper_left_joint" type="prismatic">
    <origin xyz="0.094700 0.021000 0" rpy="0 0 0" />
    <parent link="gripper_link" />
    <child link="gripper_left_link" />
    <axis xyz="0 1.000 0" />
    <limit lower="-0.011000" upper="0.020000" effort="20.000000" velocity="4.800000" />
    <dynamics damping="0.1" friction="0" />
  </joint>
  <joint name="gripper_right_joint" type="prismatic">
    <origin xyz="0.094700 -0.021000 0" rpy="0 0 0" />
    <parent link="gripper_link" />
    <child link="gripper_right_link" />
    <axis xyz="0 -1.000 0" />
    <limit lower="-0.011000" upper="0.020000" effort="20.000000" velocity="4.800000" />
    <dynamics damping="0.1" friction="0" />
  </joint>
  <joint name="end_effector_joint" type="fixed">
    <origin xyz="0.139000 0 0" rpy="0 0 0" />
    <parent link="gripper_link" />
    <child link="end_effector_link" />
  </joint>
  <joint name="gripper_camera_joint" type="fixed">
    <origin xyz="0.100256 0 0.077446" rpy="0 0.261788 0" />
    <parent link="gripper_link" />
    <child link="gripper_camera_link" />
  </joint>
  <joint name="gripper_camera_optical_joint" type="fixed">
    <origin xyz="0 0 0" rpy="-1.570796 0 -1.570796" />
    <parent link="gripper_camera_link" />
    <child link="gripper_camera_optical_frame" />
  </joint>
  <link name="arm_base_link" />
  <joint name="arm_base_link_joint" type="fixed">
    <parent link="link1" />
    <child link="arm_base_link" />
    <origin xyz="0.012 0 0" rpy="0 0 0" />
  </joint>
  <link name="gripper_motor_link" />
  <joint name="gripper_motor_joint" type="revolute">
    <parent link="gripper_link" />
    <child link="gripper_motor_link" />
    <origin xyz="0 0 0" rpy="0 0 0" />
    <axis xyz="1 0 0" />
    <limit lower="-0.794600" upper="0.954100" effort="4.1" velocity="4.8" />
  </joint>
</robot>
