developlcy-oss/Lv2_Cartlidar_Assignment/workspace/ros2_ws/src/opencr_hardware/src/opencr_hardware.cpp

#include "opencr_hardware/opencr_hardware.hpp"

#include <algorithm>
#include <cctype>
#include <chrono>
#include <cmath>
#include <cstdio>
#include <iterator>
#include <limits>
#include <optional>
#include <sstream>

#include "battery_status.hpp"
#include "hardware_interface/types/hardware_interface_type_values.hpp"
#include "pluginlib/class_list_macros.hpp"
#include "robot_interfaces/names.hpp"

namespace opencr_hardware
{
namespace names = robot_interfaces::names;
namespace qos = robot_interfaces::qos;
namespace hi = hardware_interface;
using hi::return_type;

namespace
{
std::string param_or(const std::unordered_map<std::string, std::string> & m, const std::string & key,
  const std::string & def)
{
  auto it = m.find(key);
  return it == m.end() ? def : it->second;
}
// "3004,653,..." → 팔 칸 수 (6) 만큼의 tick (0~4095). 개수 · 숫자 · 범위가 틀리면 false
bool parse_ticks(const std::string & text, std::vector<int> & out)
{
  out.clear();
  std::stringstream ss(text);
  std::string item;
  while (std::getline(ss, item, ',')) {
    const auto b = item.find_first_not_of(" \t\n"), e = item.find_last_not_of(" \t\n");
    if (b == std::string::npos) {return false;}
    item = item.substr(b, e - b + 1);
    size_t used = 0;
    int v = 0;
    try {v = std::stoi(item, &used);} catch (const std::exception &) {return false;}
    if (used != item.size() || v < 0 || v > 4095) {return false;}
    out.push_back(v);
  }
  return out.size() == static_cast<size_t>(opencr_proto::ARM_JOINTS);
}
// 팔 STATE rad → 모터 tick (펌웨어 ARM_DIR 모두 +1, 가운데 2048). 손으로 한 바퀴 넘게 돌리면 0~4095 밖으로 쌓인다
long arm_tick(double rad) {return std::lround(2048.0 + rad * 4096.0 / (2.0 * M_PI));}

const char * IMU_SUFFIX[10] = {
  "orientation.x", "orientation.y", "orientation.z", "orientation.w",
  "angular_velocity.x", "angular_velocity.y", "angular_velocity.z",
  "linear_acceleration.x", "linear_acceleration.y", "linear_acceleration.z"};
}  // namespace

// 참/거짓 인자: true · false (대소문자 무관 — xacro 는 True · False 로 펼친다) 와 1 · 0 만 받음. 다른 글은 오타로 보고 nullopt
std::optional<bool> param_flag(const std::unordered_map<std::string, std::string> & m, const std::string & key, bool def)
{
  auto it = m.find(key);
  if (it == m.end()) {return def;}
  std::string v = it->second;
  std::transform(v.begin(), v.end(), v.begin(), [](unsigned char c) {return static_cast<char>(std::tolower(c));});
  if (v == "true" || v == "1") {return true;}
  if (v == "false" || v == "0") {return false;}
  return std::nullopt;
}

hi::CallbackReturn OpenCRHardware::on_init(const hi::HardwareComponentInterfaceParams & params)
{
  if (hi::SystemInterface::on_init(params) != CallbackReturn::SUCCESS) {
    return CallbackReturn::ERROR;
  }
  const auto & hw = info_.hardware_parameters;
  port_ = param_or(hw, "ports", param_or(hw, "port", port_));
  comm_timeout_s_ = std::stod(param_or(hw, "comm_timeout_s", "0.5"));
  first_state_timeout_s_ = std::stod(param_or(hw, "first_state_timeout_s", "2.0"));
  joy_timeout_s_ = std::stod(param_or(hw, "joy_timeout_s", "0.5"));
  // REARM 뒤 팔 명령이 따라가는 최대 속도 (rad/s, 관절 1 ~ 5). 0 = 끔 (예전처럼 한 번에) — estop_latch.hpp ArmRearmSlew
  rearm_slew_ = ArmRearmSlew(std::stod(param_or(hw, "rearm_slew_rad_s", "0.3")), opencr_proto::ARM_JOINTS - 1);
  estop_button_ = std::stoi(param_or(hw, "estop_button", "6"));
  reset_button_ = std::stoi(param_or(hw, "reset_button", "7"));
  battery_warn_v_ = std::stod(param_or(hw, "battery_warn_v", "11.1"));
  battery_error_v_ = std::stod(param_or(hw, "battery_error_v", "10.5"));
  battery_cells_ = std::stoi(param_or(hw, "battery_cells", "3"));
  battery_capacity_ah_ = std::stod(param_or(hw, "battery_capacity_ah", "1.8"));
  if (battery_cells_ < 1 || battery_error_v_ >= battery_warn_v_) {
    RCLCPP_FATAL(get_logger(), "배터리 설정 오류: battery_cells %d (1 이상) · battery_error_v %.2f < battery_warn_v %.2f 여야 함",
      battery_cells_, battery_error_v_, battery_warn_v_);
    return CallbackReturn::ERROR;
  }
  const auto joy_required = param_flag(hw, "joy_required", true);
  const auto listen_only = param_flag(hw, "listen_only", false);
  const auto auto_rearm = param_flag(hw, "auto_rearm", false);
  if (!joy_required || !listen_only || !auto_rearm) {
    RCLCPP_FATAL(get_logger(), "joy_required · listen_only · auto_rearm 은 true 또는 false 여야 함");
    return CallbackReturn::ERROR;
  }
  joy_required_ = *joy_required;
  listen_only_ = *listen_only;
  auto_rearm_ = *auto_rearm;

  wheel_gear_ = std::stod(param_or(hw, "wheel_gear", "1.0"));
  if (!std::isfinite(wheel_gear_) || wheel_gear_ <= 0.0) {
    RCLCPP_FATAL(get_logger(), "wheel_gear %.3f — 0 보다 커야 함", wheel_gear_);
    return CallbackReturn::ERROR;
  }
  RCLCPP_INFO(get_logger(), "바퀴 기어비 %.2f (바퀴 / 모터)", wheel_gear_);

  // 팔 대기 자세 범위 (2026-11-09): 둘 다 주거나 둘 다 빼야 함. 하나만 있거나 글이 틀리면 검사가 몰래 꺼지지 않게 시작 거부
  const std::string standby_min = param_or(hw, "arm_standby_min_tick", "");
  const std::string standby_max = param_or(hw, "arm_standby_max_tick", "");
  if (!standby_min.empty() || !standby_max.empty()) {
    if (!parse_ticks(standby_min, standby_min_tick_) || !parse_ticks(standby_max, standby_max_tick_)) {
      RCLCPP_FATAL(get_logger(), "arm_standby_min_tick · arm_standby_max_tick 은 0~4095 tick %d 개씩 (쉼표로): '%s' / '%s'",
        opencr_proto::ARM_JOINTS, standby_min.c_str(), standby_max.c_str());
      return CallbackReturn::ERROR;
    }
    for (int k = 0; k < opencr_proto::ARM_JOINTS; ++k) {
      if (standby_min_tick_[k] > standby_max_tick_[k]) {
        RCLCPP_FATAL(get_logger(), "팔 대기 자세 범위 칸 %d: 최소 %d > 최대 %d", k, standby_min_tick_[k], standby_max_tick_[k]);
        return CallbackReturn::ERROR;
      }
    }
    RCLCPP_INFO(get_logger(), "팔 대기 자세 검사 켬 (처음 켤 때 범위 밖이면 시작 거부): %s ~ %s",
      standby_min.c_str(), standby_max.c_str());
  }
  if (listen_only_) {RCLCPP_WARN(get_logger(), "listen_only: CMD 를 보내지 않음 (STATE 수신만 확인)");}
  if (auto_rearm_) {RCLCPP_WARN(get_logger(), "auto_rearm: 리셋 버튼 없이 REARM — 벤치 시험 전용");}

  // 관절 ↔ 패킷 슬롯: <param name="role">wheel|arm|gripper</param> <param name="slot">N</param>
  std::vector<bool> wheel_used(opencr_proto::MAX_WHEELS, false), arm_used(opencr_proto::ARM_JOINTS, false);
  for (const auto & j : info_.joints) {
    const std::string role = param_or(j.parameters, "role", "");
    const int slot = std::stoi(param_or(j.parameters, "slot", "-1"));
    JointMap m{j.name, Role::WHEEL, slot};
    if (role == "wheel") {
      m.role = Role::WHEEL;
      if (slot < 0 || slot >= opencr_proto::MAX_WHEELS || wheel_used[slot]) {
        RCLCPP_FATAL(get_logger(), "바퀴 관절 %s: slot %d 잘못됨 (0~5, 중복 불가)", j.name.c_str(), slot);
        return CallbackReturn::ERROR;
      }
      wheel_used[slot] = true;
      if (j.command_interfaces.size() != 1 || j.command_interfaces[0].name != hi::HW_IF_VELOCITY) {
        RCLCPP_FATAL(get_logger(), "바퀴 관절 %s 는 velocity 명령 하나만 가져야 함", j.name.c_str());
        return CallbackReturn::ERROR;
      }
    } else if (role == "arm") {
      m.role = Role::ARM;
      if (slot < 0 || slot >= opencr_proto::ARM_JOINTS || arm_used[slot]) {
        RCLCPP_FATAL(get_logger(), "팔 관절 %s: slot %d 잘못됨 (0~5, 중복 불가)", j.name.c_str(), slot);
        return CallbackReturn::ERROR;
      }
      arm_used[slot] = true;
      if (j.command_interfaces.size() != 1 || j.command_interfaces[0].name != hi::HW_IF_POSITION) {
        RCLCPP_FATAL(get_logger(), "팔 관절 %s 는 position 명령 하나만 가져야 함", j.name.c_str());
        return CallbackReturn::ERROR;
      }
      // URDF command_interface min/max — 펌웨어는 범위 밖 CMD 를 통째로 거부하므로 보내기 전에 자른다
      const auto & ci = j.command_interfaces[0];
      if (!ci.min.empty()) {m.lo = std::stod(ci.min);}
      if (!ci.max.empty()) {m.hi = std::stod(ci.max);}
    } else if (role == "gripper") {
      m.role = Role::GRIPPER;
      m.slot = 0;
    } else {
      RCLCPP_FATAL(get_logger(), "관절 %s: role 파라미터가 wheel/arm/gripper 중 하나여야 함", j.name.c_str());
      return CallbackReturn::ERROR;
    }
    joints_.push_back(m);
  }
  if (!info_.sensors.empty()) {
    imu_name_ = info_.sensors.front().name;
  }
  RCLCPP_INFO(get_logger(), "OpenCRHardware: 관절 %zu개, IMU '%s', 후보 포트 %s", joints_.size(),
    imu_name_.c_str(), port_.c_str());
  return CallbackReturn::SUCCESS;
}

hi::CallbackReturn OpenCRHardware::on_configure(const rclcpp_lifecycle::State &)
{
  links_.clear();
  std::istringstream input(port_);
  std::string path;
  std::string err;
  while (std::getline(input, path, ',')) {
    const auto first = path.find_first_not_of(" \t");
    const auto last = path.find_last_not_of(" \t");
    if (first == std::string::npos) {continue;}
    path = path.substr(first, last - first + 1);
    auto link = std::make_unique<BoardLink>(path);
    if (!link->serial.open(path, B115200, err)) {
      RCLCPP_ERROR(get_logger(), "후보 포트 열기 실패: %s", err.c_str());
      links_.clear();
      return CallbackReturn::ERROR;
    }
    links_.push_back(std::move(link));
  }
  if (links_.size() != 2) {
    RCLCPP_ERROR(get_logger(), "역할 판별을 위해 후보 포트를 정확히 두 개 지정해야 합니다: %s", port_.c_str());
    links_.clear();
    return CallbackReturn::ERROR;
  }
  setup_ros_io();
  return CallbackReturn::SUCCESS;
}

int64_t OpenCRHardware::steady_ns()
{
  return std::chrono::duration_cast<std::chrono::nanoseconds>(
    std::chrono::steady_clock::now().time_since_epoch()).count();
}

// RC-100 STATE 칸 (float) → 정수. 음수 · NaN · 너무 큰 값은 0 (예전 펌웨어는 0 을 보냄 = 받은 적 없음)
// STATE 진단 칸 값 (float) → 0 ~ 255 (예전 펌웨어 · 이상한 값은 0)
static uint8_t diag_byte(float v)
{
  if (!std::isfinite(v) || v <= 0.f) {return 0;}
  return v >= 255.f ? 255 : static_cast<uint8_t>(std::lround(v));
}

// Hardware Error Status 비트 → 읽는 글 (e-Manual XM430)
static std::string hw_error_text(uint8_t v)
{
  if (v == 0) {return "정상";}
  std::string t;
  auto add = [&](uint8_t bit, const char * name) {
      if (v & bit) {t += t.empty() ? "" : " · "; t += name;}
    };
  add(opencr_proto::HWERR_INPUT_VOLTAGE, "입력 전압");
  add(opencr_proto::HWERR_OVERHEATING, "과열");
  add(opencr_proto::HWERR_ENCODER, "엔코더");
  add(opencr_proto::HWERR_ELECTRICAL_SHOCK, "전기 충격");
  add(opencr_proto::HWERR_OVERLOAD, "과부하");
  char hex[8];
  std::snprintf(hex, sizeof(hex), "0x%02X", v);
  return std::string(hex) + (t.empty() ? "" : " " + t);
}

static uint32_t rc100_value(float v)
{
  return (std::isfinite(v) && v >= 0.f && v < 1.0e9f) ? static_cast<uint32_t>(v) : 0u;
}
static constexpr const char * RC100_RAW_TOPIC = "/rc100/raw";   // std_msgs/UInt32MultiArray [버튼 비트, 마지막 패킷 뒤 ms + 1]

// /joy · /e_stop · /diagnostics — 하드웨어 컴포넌트 노드 (controller_manager executor 가 콜백 · 타이머를 돌림)
void OpenCRHardware::setup_ros_io()
{
  auto node = get_node();
  if (!node) {
    RCLCPP_WARN(get_logger(), "하드웨어 컴포넌트 노드 없음 — /joy · /e_stop · /diagnostics 비활성 "
      "(joy_required=%s)", joy_required_ ? "true → 계속 잠김" : "false");
    return;
  }
  joy_sub_ = node->create_subscription<sensor_msgs::msg::Joy>(names::JOY, rclcpp::SensorDataQoS(),
      [this](sensor_msgs::msg::Joy::ConstSharedPtr m) {
        auto btn = [&](int i) {return i >= 0 && i < static_cast<int>(m->buttons.size()) && m->buttons[i] != 0;};
        joy_estop_btn_.store(btn(estop_button_));
        joy_reset_btn_.store(btn(reset_button_));
        joy_rx_ns_.store(steady_ns());
      });
  estop_pub_ = node->create_publisher<std_msgs::msg::Bool>(names::E_STOP, qos::e_stop());
  diag_pub_ = node->create_publisher<diagnostic_msgs::msg::DiagnosticArray>(names::DIAGNOSTICS, 10);
  bat_wheel_pub_ = node->create_publisher<sensor_msgs::msg::BatteryState>(names::BATTERY_WHEEL, 10);
  bat_arm_pub_ = node->create_publisher<sensor_msgs::msg::BatteryState>(names::BATTERY_ARM, 10);
  estop_timer_ = node->create_wall_timer(std::chrono::milliseconds(100), [this]() {
        publish_estop();
        publish_diagnostics(false);   // 오류로 바뀌면 즉시
      });
  diag_timer_ = node->create_wall_timer(std::chrono::seconds(1), [this]() {publish_diagnostics(true);});
  // RC-100 → /rc100/raw (rc100_joy 노드가 /joy 로 바꿈). 버튼이 바뀌면 다음 10 ms 틱에 바로, 아니면 20 Hz.
  //   주행 보드 STATE 가 0.2 s 끊기면 내지 않음 → rc100_joy 가 /joy 를 멈춰 조이스틱 무수신 잠금
  rc100_pub_ = node->create_publisher<std_msgs::msg::UInt32MultiArray>(RC100_RAW_TOPIC, 10);
  rc100_timer_ = node->create_wall_timer(std::chrono::milliseconds(10), [this]() {
        const int64_t now = steady_ns(), rx = rc100_rx_ns_.load();
        if (rx == 0 || now - rx > 200'000'000) {return;}
        const uint32_t buttons = rc100_buttons_.load();
        if (buttons == rc100_sent_buttons_ && now - rc100_sent_ns_ < 50'000'000) {return;}
        std_msgs::msg::UInt32MultiArray m;
        m.data = {buttons, rc100_age_.load()};
        rc100_pub_->publish(m);
        rc100_sent_buttons_ = buttons;
        rc100_sent_ns_ = now;
      });
}

void OpenCRHardware::publish_estop()
{
  std_msgs::msg::Bool m;
  m.data = estop_.load();
  estop_pub_->publish(m);
}

void OpenCRHardware::publish_diagnostics(bool force)
{
  using diagnostic_msgs::msg::DiagnosticStatus;
  using diagnostic_msgs::msg::KeyValue;
  diagnostic_msgs::msg::DiagnosticArray arr;
  arr.header.stamp = get_node()->now();
  auto add = [&](const std::string & name, uint8_t level, const std::string & msg,
    std::vector<std::pair<std::string, std::string>> kv = {}) {
      DiagnosticStatus s;
      s.name = "opencr/" + name;   // 이름 규약 = 계약 (mission 이 opencr/ 로 거름)
      s.hardware_id = "opencr";
      s.level = level;
      s.message = msg;
      for (auto & p : kv) {KeyValue k; k.key = p.first; k.value = p.second; s.values.push_back(k);}
      arr.status.push_back(s);
    };
  const uint8_t err = fw_error_.load();
  const bool link = link_ok_.load();
  const float bat = battery_v_.load();
  const float arm_bat = arm_battery_v_.load();
  add("link", link ? DiagnosticStatus::OK : DiagnosticStatus::ERROR, link ? "정상" : "STATE 무수신",
    {{"bad_frames", std::to_string(bad_frames_.load())}, {"ports", port_}});
  const bool motor_bad = err & (opencr_proto::ERR_MOTOR_HW | opencr_proto::ERR_SYNCREAD |
      opencr_proto::ERR_MOTOR_CONFIG | opencr_proto::ERR_ROLE_MISMATCH | opencr_proto::ERR_FAULT);
  // 모터별 Hardware Error Status · 온도 (#259): 관절마다 '<관절>.hw_error' · '<관절>.temp_c' (0 = 예전 펌웨어 · 아직 못 읽음)
  std::vector<std::pair<std::string, std::string>> motor_kv = {{"error_bits", std::to_string(err)},
    {"fw_version", std::to_string(fw_version_.load())}, {"arm_hold", (err & opencr_proto::ERR_HOLD) ? "1" : "0"}};
  std::string hw_joints;
  for (const auto & j : joints_) {
    if (j.role == Role::GRIPPER) {continue;}
    const int k = (j.role == Role::WHEEL ? 0 : opencr_proto::MAX_WHEELS) + j.slot;
    const uint8_t hw = motor_hw_[k].load();
    motor_kv.push_back({j.name + ".hw_error", hw_error_text(hw)});
    motor_kv.push_back({j.name + ".temp_c", std::to_string(motor_temp_[k].load())});
    if (hw) {hw_joints += (hw_joints.empty() ? "" : ", ") + j.name + " " + hw_error_text(hw);}
  }
  add("motors", motor_bad ? DiagnosticStatus::ERROR : DiagnosticStatus::OK,
    (err & opencr_proto::ERR_MOTOR_CONFIG) ? "부팅 점검 실패 (응답 · 모델 · Homing Offset)" :
    (err & opencr_proto::ERR_FAULT) ? "펌웨어 FAULT" :
    (err & opencr_proto::ERR_MOTOR_HW) ? "모터 Hardware Error" + (hw_joints.empty() ? std::string() : ": " + hw_joints) :
    (err & opencr_proto::ERR_ROLE_MISMATCH) ? "CMD 역할 불일치" :
    (err & opencr_proto::ERR_SYNCREAD) ? "SyncRead 응답 부족" : "정상",
    motor_kv);
  // 배터리 (2026-11-11): 보드마다 전용 배터리 → 두 보드 각각 판정, 수준은 나쁜 쪽. 링크가 없으면 판정하지 않음 (link 항목이 ERROR)
  //   voltage 키 = 주행 보드 (예전 계약 그대로). 팔은 예전 펌웨어면 0 → "보고 없음"
  const BatteryReport wb = evaluate_battery(bat, battery_warn_v_, battery_error_v_, battery_cells_, true);
  const BatteryReport ab = evaluate_battery(arm_bat, battery_warn_v_, battery_error_v_, battery_cells_, false);
  const uint8_t bl = link ? std::max(wb.level, ab.level) : DiagnosticStatus::OK;
  auto fmt = [](const char * f, double v) {char b[16]; std::snprintf(b, sizeof(b), f, v); return std::string(b);};
  add("battery", bl, link ? battery_summary("주행", wb) + " · " + battery_summary("팔", ab) : std::string("링크 없음"),
    {{"voltage", fmt("%.2f", bat)},
      {"wheel_voltage", fmt("%.2f", bat)}, {"wheel_percent", fmt("%.0f", wb.percent)}, {"wheel_state", wb.state},
      {"arm_voltage", fmt("%.2f", arm_bat)}, {"arm_percent", fmt("%.0f", ab.percent)}, {"arm_state", ab.state}});
  if (force) {
    publish_battery_state(bat_wheel_pub_, "wheel_board", bat, link && wb.reported, wb.level, wb.percent);
    publish_battery_state(bat_arm_pub_, "arm_board", arm_bat, link && ab.reported, ab.level, ab.percent);
  }
  static const char * reasons[] = {"", "시작 — 리셋 버튼 필요", "OpenCR 링크 끊김", "물리 E-stop 스위치", "조이스틱 E-stop 버튼", "조이스틱 무수신",
    "OpenCR 팔 HOLD — 리셋 버튼으로 REARM"};
  const int rc = estop_reason_code_.load();
  add("estop", estop_.load() ? DiagnosticStatus::WARN : DiagnosticStatus::OK, estop_.load() ? std::string("잠김: ") + reasons[rc] : "해제");

  uint8_t worst = 0;
  for (const auto & s : arr.status) {worst = std::max(worst, s.level);}
  const bool became_error = worst >= DiagnosticStatus::ERROR && last_diag_level_ < DiagnosticStatus::ERROR;
  last_diag_level_ = worst;
  if (force || became_error) {diag_pub_->publish(arr);}
}

// sensor_msgs/BatteryState 1 Hz (diag_timer). 모르는 값 (전류 · 온도 · 충전량) 은 NaN, 셀 전압은 셀 수만큼 NaN (개별 측정 없음)
void OpenCRHardware::publish_battery_state(const rclcpp::Publisher<sensor_msgs::msg::BatteryState>::SharedPtr & pub,
  const char * location, float v, bool reported, uint8_t level, float percent)
{
  if (!pub) {return;}
  using sensor_msgs::msg::BatteryState;
  const float nan = std::numeric_limits<float>::quiet_NaN();
  BatteryState m;
  m.header.stamp = get_node()->now();
  m.header.frame_id = location;
  m.voltage = reported ? v : nan;
  m.temperature = nan;
  m.current = nan;
  m.charge = nan;
  m.capacity = nan;
  m.design_capacity = static_cast<float>(battery_capacity_ah_);
  m.percentage = reported ? percent / 100.f : nan;   // 0 ~ 1 (LiPo 휴지 전압 표 추정 — 부하 중에는 낮게)
  m.power_supply_status = reported ? BatteryState::POWER_SUPPLY_STATUS_DISCHARGING : BatteryState::POWER_SUPPLY_STATUS_UNKNOWN;
  m.power_supply_health = !reported ? BatteryState::POWER_SUPPLY_HEALTH_UNKNOWN :
    (level >= 2 ? BatteryState::POWER_SUPPLY_HEALTH_DEAD : BatteryState::POWER_SUPPLY_HEALTH_GOOD);
  m.power_supply_technology = BatteryState::POWER_SUPPLY_TECHNOLOGY_LIPO;
  m.present = reported;
  m.cell_voltage.assign(static_cast<size_t>(battery_cells_), nan);
  m.cell_temperature.assign(static_cast<size_t>(battery_cells_), nan);
  m.location = location;
  pub->publish(m);
}

hi::CallbackReturn OpenCRHardware::on_cleanup(const rclcpp_lifecycle::State &)
{
  joy_sub_.reset();
  estop_timer_.reset();
  diag_timer_.reset();
  bat_wheel_pub_.reset();
  bat_arm_pub_.reset();
  links_.clear();
  return CallbackReturn::SUCCESS;
}

bool OpenCRHardware::poll_serial()
{
  uint8_t buf[512];
  bool io_ok = true;
  for (auto & link : links_) {
    for (int k = 0; k < 16; ++k) {   // 각 포트에서 한 주기에 최대 8 KB
      const ssize_t n = link->serial.read_some(buf, sizeof(buf));
      if (n < 0) {io_ok = false; break;}
      if (n == 0) {break;}
      for (ssize_t i = 0; i < n; ++i) {
        if (link->parser.push(buf[i]) && link->parser.type() == opencr_proto::TYPE_STATE) {
          opencr_proto::State s;
          if (opencr_proto::decode_state(link->parser.payload(), link->parser.length(), s)) {
            link->state = s;
            link->have_state = true;
            link->last_state_time = steady_.now();
          }
        }
      }
    }
  }
  refresh_aggregate_state();
  uint32_t bad = 0;
  for (const auto & link : links_) {bad += link->parser.bad_frames();}
  bad_frames_.store(bad);
  return io_ok;
}

bool OpenCRHardware::roles_ready() const
{
  int wheels = 0, arms = 0;
  for (const auto & link : links_) {
    if (!link->have_state) {continue;}
    if (link->state.fw_version != opencr_proto::PROTOCOL_VERSION) {return false;}
    if (link->state.role == opencr_proto::ROLE_WHEEL) {++wheels;}
    else if (link->state.role == opencr_proto::ROLE_ARM) {++arms;}
  }
  return wheels == 1 && arms == 1;
}

void OpenCRHardware::refresh_aggregate_state()
{
  opencr_proto::State merged{};
  bool wheel = false, arm = false, version_mismatch = false;
  for (const auto & link : links_) {
    if (!link->have_state) {continue;}
    const auto & s = link->state;
    if (s.role == opencr_proto::ROLE_WHEEL) {
      wheel = true;
      for (int i = 0; i < opencr_proto::MAX_WHEELS; ++i) {
        merged.pos[i] = s.pos[i]; merged.vel[i] = s.vel[i]; merged.effort[i] = s.effort[i];
      }
      std::copy(std::begin(s.quat), std::end(s.quat), std::begin(merged.quat));
      std::copy(std::begin(s.gyro), std::end(s.gyro), std::begin(merged.gyro));
      std::copy(std::begin(s.accel), std::end(s.accel), std::begin(merged.accel));
      merged.battery_v = s.battery_v;
      rc100_buttons_.store(rc100_value(s.pos[opencr_proto::RC100_SLOT_BUTTONS]));
      rc100_age_.store(rc100_value(s.pos[opencr_proto::RC100_SLOT_AGE]));
      rc100_rx_ns_.store(steady_ns());
      for (int i = 0; i < opencr_proto::MAX_WHEELS; ++i) {
        const int d = opencr_proto::diag_slot(opencr_proto::ROLE_WHEEL, i);
        motor_hw_[i].store(diag_byte(s.vel[d]));
        motor_temp_[i].store(diag_byte(s.effort[d]));
      }
    } else if (s.role == opencr_proto::ROLE_ARM) {
      arm = true;
      for (int i = 0; i < opencr_proto::ARM_JOINTS; ++i) {
        const int k = opencr_proto::MAX_WHEELS + i;
        merged.pos[k] = s.pos[k]; merged.vel[k] = s.vel[k]; merged.effort[k] = s.effort[k];
        const int d = opencr_proto::diag_slot(opencr_proto::ROLE_ARM, i);
        motor_hw_[k].store(diag_byte(s.vel[d]));
        motor_temp_[k].store(diag_byte(s.effort[d]));
      }
      arm_battery_raw_ = s.battery_v;
    }
    merged.error |= s.error;
    if (s.fw_version != opencr_proto::PROTOCOL_VERSION) {
      merged.fw_version = s.fw_version;
      version_mismatch = true;
    }
  }
  have_state_ = wheel && arm;
  if (have_state_ && !version_mismatch) {merged.fw_version = opencr_proto::PROTOCOL_VERSION;}   // 불일치는 덮어쓰지 않음
  latest_ = merged;
}

bool OpenCRHardware::wait_first_state(double timeout_s)
{
  const auto t0 = steady_.now();
  while ((steady_.now() - t0).seconds() < timeout_s) {
    if (!poll_serial()) {return false;}
    // 두 보드가 이전 호스트 세션의 명령을 놓을 때까지 (ERR_CMD_TIMEOUT) 기다린다.
    // 펌웨어는 seq 가 뒤로 간 CMD 를 오래된 명령으로 버리므로, 무수신이 되어 seq 기준이 지워져야 새 세션의 seq 0 부터 받는다
    const bool idle = std::all_of(links_.begin(), links_.end(), [](const std::unique_ptr<BoardLink> & l) {
        return l->have_state && (l->state.error & opencr_proto::ERR_CMD_TIMEOUT);
      });
    if (roles_ready() && idle) {
      // 활성화 중에는 CMD 를 보내지 않는다 (D5-2) — 토크가 켜져 있던 팔이 호스트 재시작으로 처지지 않게.
      // 첫 CMD 는 write() 의 TORQUE_ON (잠김이면 + ESTOP). 팔은 REARM 까지 현재 위치에서 HOLD
      have_state_ = true;
      return true;
    }
    rclcpp::sleep_for(std::chrono::milliseconds(10));
  }
  return false;
}

// 처음 켤 때 (토크 꺼짐) 팔이 대기 자세 범위 안인지 (2026-11-09). 정해 둔 자세에서만 시작해야 켠 뒤 움직이는 길이 늘 같다.
// 팔 HOLD = 토크가 켜진 채 펌웨어가 붙잡고 있음 (호스트만 다시 켬, safety_core.h) → 손으로 옮길 수 없으므로 건너뜀
bool OpenCRHardware::check_arm_standby() const
{
  if (standby_min_tick_.empty() || listen_only_) {return true;}   // 범위 없음 (시험 · 다른 로봇) · CMD 를 안 보내는 확인 모드
  if (latest_.error & opencr_proto::ERR_HOLD) {
    RCLCPP_WARN(get_logger(), "팔 HOLD (토크가 켜진 채 호스트만 다시 시작) — 대기 자세 검사를 건너뜀");
    return true;
  }
  std::ostringstream bad;
  for (int k = 0; k < opencr_proto::ARM_JOINTS; ++k) {
    const long t = arm_tick(latest_.pos[opencr_proto::MAX_WHEELS + k]);
    const long lo = standby_min_tick_[k], hi = standby_max_tick_[k];
    if (t >= lo && t <= hi) {continue;}
    std::string name = "칸 " + std::to_string(k);
    for (const auto & j : joints_) {
      if (j.role == Role::ARM && j.slot == k) {name = j.name;}
    }
    const long off = t > hi ? t - hi : t - lo;
    char line[200];
    std::snprintf(line, sizeof(line), "\n  %s: %ld tick, 범위 %ld ~ %ld (%+ld tick = %+.1f°)", name.c_str(), t, lo, hi, off,
      off * 360.0 / 4096.0);
    bad << line;
    if (t < 0 || t > 4095) {bad << " — 한 바퀴 넘게 돌아 값이 쌓임: 12 V 를 껐다 켠 뒤 다시";}
  }
  if (bad.str().empty()) {
    RCLCPP_INFO(get_logger(), "팔 대기 자세 확인 — 여섯 칸 모두 범위 안");
    return true;
  }
  RCLCPP_ERROR(get_logger(), "팔이 대기 자세가 아님 — 토크를 켜지 않고 시작을 거부합니다:%s\n"
    "  지금은 토크가 꺼져 있습니다. 팔을 손으로 대기 자세에 놓은 뒤 다시 시작하세요", bad.str().c_str());
  return false;
}

hi::CallbackReturn OpenCRHardware::on_activate(const rclcpp_lifecycle::State &)
{
  bool any_open = false;
  for (const auto & link : links_) {any_open = any_open || link->serial.is_open();}
  if (!any_open && on_configure(rclcpp_lifecycle::State()) != CallbackReturn::SUCCESS) {
    return CallbackReturn::ERROR;
  }
  if (!wait_first_state(first_state_timeout_s_)) {
    if (roles_ready()) {
      RCLCPP_ERROR(get_logger(), "%.1f s 안에 두 보드가 무수신 상태(ERR_CMD_TIMEOUT)가 되지 않음 — 다른 프로그램이 CMD 를 보내는지 확인",
        first_state_timeout_s_);
    } else {
      RCLCPP_ERROR(get_logger(), "%.1f s 안에 WHEEL·ARM 역할 STATE를 모두 받지 못함", first_state_timeout_s_);
    }
    return CallbackReturn::ERROR;
  }
  // 펌웨어 버전 확인 — 다르면 패킷 해석이 어긋나므로 명령을 보내지 않음
  if (latest_.fw_version != opencr_proto::PROTOCOL_VERSION) {
    RCLCPP_ERROR(get_logger(), "두 보드 모두 프로토콜 v%u이어야 합니다 — 역할별 펌웨어를 다시 올리세요",
      opencr_proto::PROTOCOL_VERSION);
    return CallbackReturn::ERROR;
  }
  if (latest_.error & opencr_proto::ERR_MOTOR_CONFIG) {
    if (!listen_only_) {
      RCLCPP_ERROR(get_logger(), "OpenCR 부팅 점검 실패 (모터 응답 · 모델 · Homing Offset) — Dynamixel Wizard 로 확인");
      return CallbackReturn::ERROR;
    }
    // CMD 를 보내지 않으므로 모터 없이 연결한 보드도 STATE 수신 확인용으로 활성화한다
    RCLCPP_WARN(get_logger(), "listen_only: 부팅 점검 실패 보드 (모터 없음 등) — STATE 수신만 확인");
  }
  if (!check_arm_standby()) {
    return CallbackReturn::ERROR;   // 아직 CMD 를 한 번도 안 보냄 (D5-2) → 토크 꺼진 채
  }
  apply_state_to_interfaces();
  // 팔 명령 초기값 = 현재 위치 (토크 ON 순간 튀지 않게), 바퀴 = 0
  for (const auto & j : joints_) {
    const std::string cmd_if = j.name + "/" + (j.role == Role::WHEEL ? hi::HW_IF_VELOCITY : hi::HW_IF_POSITION);
    if (j.role == Role::WHEEL) {
      set_command(cmd_if, 0.0);
    } else if (j.role == Role::ARM) {
      const double q = latest_.pos[opencr_proto::MAX_WHEELS + j.slot];
      if (q < j.lo || q > j.hi) {
        RCLCPP_WARN(get_logger(), "%s 현재 위치 %.3f rad 가 명령 한계 [%.3f, %.3f] 밖 — 한계로 자른 값을 초기 명령으로",
          j.name.c_str(), q, j.lo, j.hi);
      }
      set_command(cmd_if, std::clamp(q, j.lo, j.hi));
    } else {
      set_command(cmd_if, 0.0);   // 그리퍼 피드백 없음 — 0(열림 기준)에서 시작 ★
    }
  }
  RCLCPP_INFO(get_logger(), "OpenCRHardware 활성화 (팔 명령 = 현재 위치)");
  return CallbackReturn::SUCCESS;
}

hi::CallbackReturn OpenCRHardware::on_deactivate(const rclcpp_lifecycle::State &)
{
  // 바퀴 0, 팔은 마지막 명령 위치 유지 (토크를 끄면 팔이 처지므로 끄지 않음)
  for (const auto & j : joints_) {
    if (j.role == Role::WHEEL) {set_command(j.name + "/" + hi::HW_IF_VELOCITY, 0.0);}
  }
  send_cmd(true);
  return CallbackReturn::SUCCESS;
}

void OpenCRHardware::set_state_if(const std::string & name, double v)
{
  if (has_state(name)) {set_state(name, v);}   // URDF 에 없는 상태 인터페이스는 건너뜀
}

void OpenCRHardware::apply_state_to_interfaces()
{
  for (const auto & j : joints_) {
    if (j.role == Role::GRIPPER) {
      // 그리퍼 개폐 피드백 없음 (액추에이터 미정) → 명령값을 상태로 되돌려 줌
      const double c = get_command<double>(j.name + "/" + hi::HW_IF_POSITION);
      set_state_if(j.name + "/" + hi::HW_IF_POSITION, std::isfinite(c) ? c : 0.0);
      continue;
    }
    const int k = (j.role == Role::WHEEL ? 0 : opencr_proto::MAX_WHEELS) + j.slot;
    const double g = j.role == Role::WHEEL ? wheel_gear_ : 1.0;   // 바퀴: 모터 축 → 바퀴 (전류는 모터 값 그대로, A)
    set_state_if(j.name + "/" + hi::HW_IF_POSITION, latest_.pos[k] * g);
    set_state_if(j.name + "/" + hi::HW_IF_VELOCITY, latest_.vel[k] * g);
    set_state_if(j.name + "/" + hi::HW_IF_EFFORT, latest_.effort[k]);
  }
  if (!imu_name_.empty()) {
    const float v[10] = {latest_.quat[1], latest_.quat[2], latest_.quat[3], latest_.quat[0],
      latest_.gyro[0], latest_.gyro[1], latest_.gyro[2],
      latest_.accel[0], latest_.accel[1], latest_.accel[2]};
    for (int i = 0; i < 10; ++i) {
      set_state_if(imu_name_ + "/" + IMU_SUFFIX[i], v[i]);
    }
  }
}

void OpenCRHardware::update_estop()
{
  EstopInputs in;
  in.joy_required = joy_required_;
  in.joy_fresh = (steady_ns() - joy_rx_ns_.load()) * 1e-9 <= joy_timeout_s_;
  in.estop_button = joy_estop_btn_.load();
  in.reset_button = joy_reset_btn_.load();
  in.physical_pressed = latest_.error & opencr_proto::ERR_HW_ESTOP;
  in.link_ok = link_ok_.load();
  // 팔 HOLD 상승 (무수신 · ESTOP · 토크 ON) → 잠금. /e_stop 으로 manipulator 가 자세를 멈추고 운용자가 리셋한다
  const bool arm_hold = latest_.error & opencr_proto::ERR_HOLD;
  in.trip = arm_hold && !prev_arm_hold_;
  prev_arm_hold_ = arm_hold;
  const bool was = estop_.load();
  const bool now_latched = latch_.update(in);
  estop_.store(now_latched);
  if (now_latched != was) {
    const std::string & r = latch_.reason();
    estop_reason_code_.store(!now_latched ? 0 : r.find("시작") != std::string::npos ? 1 :
      r.find("링크") != std::string::npos ? 2 : r.find("물리") != std::string::npos ? 3 :
      r.find("버튼") != std::string::npos ? 4 : r.find("HOLD") != std::string::npos ? 6 : 5);
    RCLCPP_WARN(get_logger(), "E-stop %s %s", now_latched ? "잠김:" : "해제", r.c_str());
  }
  const bool request = rearm_request(was, now_latched, in.reset_button, prev_reset_btn_, auto_rearm_);
  prev_reset_btn_ = in.reset_button;
  rearm_flag_ = rearm_.update(now_latched, request, arm_hold, latest_.error & opencr_proto::ERR_FAULT);
}

return_type OpenCRHardware::read(const rclcpp::Time &, const rclcpp::Duration &)
{
  const bool io_ok = poll_serial();
  const auto now = steady_.now();
  bool wheel_fresh = false, arm_fresh = false;
  for (const auto & link : links_) {
    if (!link->have_state || (now - link->last_state_time).seconds() > comm_timeout_s_) {continue;}
    if (link->state.fw_version != opencr_proto::PROTOCOL_VERSION) {continue;}   // 운용 중 버전이 바뀐 보드 = 링크 오류
    if (link->state.role == opencr_proto::ROLE_WHEEL) {wheel_fresh = true;}
    else if (link->state.role == opencr_proto::ROLE_ARM) {arm_fresh = true;}
  }
  const bool fresh = wheel_fresh && arm_fresh;
  link_ok_.store(io_ok && fresh);
  update_estop();
  if (!io_ok || !fresh) {
    // 한쪽 링크만 살아 있으면 그 보드에 정지 명령을 보내고, 끊긴 보드에는 펌웨어 타임아웃이 적용된다.
    send_cmd(true);
    RCLCPP_ERROR(get_logger(), "WHEEL·ARM OpenCR 중 하나 이상 링크 오류 (시리얼 분리 또는 상태 타임아웃)");
    return return_type::ERROR;
  }
  fw_error_.store(latest_.error);
  fw_version_.store(latest_.fw_version);
  battery_v_.store(latest_.battery_v);
  arm_battery_v_.store(arm_battery_raw_);
  if (latest_.error != last_error_) {
    if (latest_.error) {
      RCLCPP_WARN(get_logger(), "OpenCR 오류 비트 0x%02X (SyncRead 누락 %d · 명령 타임아웃 %d · 물리 E-stop %d · 모터 HW %d · 역할 불일치 %d"
        " · 팔 HOLD %d · FAULT %d)",
        latest_.error, !!(latest_.error & opencr_proto::ERR_SYNCREAD),
        !!(latest_.error & opencr_proto::ERR_CMD_TIMEOUT), !!(latest_.error & opencr_proto::ERR_HW_ESTOP),
        !!(latest_.error & opencr_proto::ERR_MOTOR_HW), !!(latest_.error & opencr_proto::ERR_ROLE_MISMATCH),
        !!(latest_.error & opencr_proto::ERR_HOLD), !!(latest_.error & opencr_proto::ERR_FAULT));
    }
    last_error_ = latest_.error;
  }
  // 모터별 Hardware Error Status 가 바뀌면 관절 이름 · 값 · 온도를 남김 — 12 V 를 끄면 모터 오류가 지워져 나중에 읽을 수 없음 (#259)
  for (const auto & j : joints_) {
    if (j.role == Role::GRIPPER) {continue;}
    const int k = (j.role == Role::WHEEL ? 0 : opencr_proto::MAX_WHEELS) + j.slot;
    const uint8_t hw = motor_hw_[k].load();
    if (hw == logged_motor_hw_[k]) {continue;}
    if (hw) {
      RCLCPP_ERROR(get_logger(), "모터 %s Hardware Error Status %s (온도 %u °C, 팔 OpenCR 12 V 를 끄기 전에 기록)",
        j.name.c_str(), hw_error_text(hw).c_str(), static_cast<unsigned>(motor_temp_[k].load()));
    } else {
      RCLCPP_WARN(get_logger(), "모터 %s Hardware Error Status 0 으로 돌아옴 (이전 %s)", j.name.c_str(),
        hw_error_text(logged_motor_hw_[k]).c_str());
    }
    logged_motor_hw_[k] = hw;
  }
  apply_state_to_interfaces();
  return return_type::OK;
}

bool OpenCRHardware::send_cmd(bool torque_on)
{
  if (listen_only_) {return true;}   // 통신 확인 전용: 어떤 CMD 도 보내지 않음
  bool wheel_sent = false, arm_sent = false, ok = true;
  for (const auto & link : links_) {
    if (!link->have_state) {continue;}
    const uint8_t role = link->state.role;
    if (role != opencr_proto::ROLE_WHEEL && role != opencr_proto::ROLE_ARM) {continue;}
    const bool sent = send_cmd_for_role(role, torque_on);
    ok = sent && ok;
    if (role == opencr_proto::ROLE_WHEEL) {wheel_sent = true;} else {arm_sent = true;}
  }
  return ok && wheel_sent && arm_sent;
}

bool OpenCRHardware::send_cmd_for_role(uint8_t role, bool torque_on)
{
  opencr_proto::Cmd c{};
  c.role = role;
  for (const auto & j : joints_) {
    if (role == opencr_proto::ROLE_WHEEL && j.role == Role::WHEEL) {
      const double v = get_command<double>(j.name + "/" + hi::HW_IF_VELOCITY);
      c.wheel_vel[j.slot] = std::isfinite(v) ? static_cast<float>(v / wheel_gear_) : 0.0f;   // 펌웨어는 모터 rad/s
    } else if (role == opencr_proto::ROLE_ARM && j.role == Role::ARM) {
      const double p = get_command<double>(j.name + "/" + hi::HW_IF_POSITION);
      const double q = std::isfinite(p) ? p : latest_.pos[opencr_proto::MAX_WHEELS + j.slot];
      c.arm_pos[j.slot] = static_cast<float>(std::clamp(q, j.lo, j.hi));   // 펌웨어는 범위 밖이면 CMD 전체를 거부
    } else if (role == opencr_proto::ROLE_ARM && j.role == Role::GRIPPER) {
      const double g = get_command<double>(j.name + "/" + hi::HW_IF_POSITION);
      if (std::isfinite(g)) {c.gripper_pos = static_cast<float>(g); c.flags |= opencr_proto::FLAG_GRIPPER_VALID;}
    }
  }
  if (role == opencr_proto::ROLE_ARM) {   // 잠긴 동안 펌웨어가 붙잡은 목표 → 풀린 뒤 천천히 따라감 (REARM 때 튀지 않게)
    rearm_slew_.apply(estop_.load() || !link_ok_.load(), c.arm_pos,
      &latest_.pos[opencr_proto::MAX_WHEELS], &latest_.vel[opencr_proto::MAX_WHEELS], cmd_dt_s_);
  }
  if (torque_on) {c.flags |= opencr_proto::FLAG_TORQUE_ON;}
  if (role == opencr_proto::ROLE_ARM && rearm_flag_) {c.flags |= opencr_proto::FLAG_REARM;}
  if (estop_.load() || !link_ok_.load()) {
    c.flags |= opencr_proto::FLAG_ESTOP;
    for (float & w : c.wheel_vel) {w = 0.0f;}
  }
  c.seq = seq_++;
  uint8_t frame[opencr_proto::MAX_FRAME];
  const size_t n = opencr_proto::encode_cmd(c, frame);
  for (const auto & link : links_) {
    if (link->have_state && link->state.role == role) {return link->serial.write_all(frame, n);}
  }
  return false;
}

return_type OpenCRHardware::write(const rclcpp::Time &, const rclcpp::Duration & period)
{
  cmd_dt_s_ = std::clamp(period.seconds(), 0.0, 0.1);
  if (!send_cmd(true)) {
    RCLCPP_ERROR(get_logger(), "CMD 송신 실패");
    return return_type::ERROR;
  }
  return return_type::OK;
}

}  // namespace opencr_hardware

PLUGINLIB_EXPORT_CLASS(opencr_hardware::OpenCRHardware, hardware_interface::SystemInterface)
