developlcy-oss/Lv2_Cartlidar_Assignment/workspace/ros2_ws/src/control/src/drive_node.cpp

// DriveNode (Controller 팀) — 바퀴 명령 주체는 이 노드 하나 (/cmd_vel_drive → twist_mux priority 50)
//   /drive/navigate      목표가 현재 위치와 xy_goal_tolerance 이내면 yaw 차이만큼 nav2 spin, 아니면 navigate_to_pose
//                        navigate.loc_gate (#121, control/loc_gate.hpp): /localization/status 가 OK 일 때만 보내고,
//                        진행 중 위치를 잃었다 OK 로 돌아오면 같은 목표를 다시 보냄 (잃은 동안 Nav2 가 실패해도 기다렸다 다시)
//   /drive/align         goal 수신 뒤 첫 새 result 의 ARM_ALIGN 비트로 모드를 정하고 끝까지 유지
//                        정밀: arm_offset → 회전, /tfmini/range (1층 TFmini → 박스 앞면, BoxRangeFilter) → 전후 (20 Hz)
//                        정밀 동안 obstacle_stop 정지 거리를 "목표 − align.box_stop_margin" 으로 낮추고 (파라미터 approach_stop_m)
//                        끝날 때(성공 · 실패 · 취소 · 선점) 박스 앞 (TFmini < align.box.park_release_m) 이면 "정차" 로 낮춘 값을 유지하고,
//                        TFmini 로 물러남을 확인한 뒤 0 으로 되돌린다 (#157, control/box_park.hpp). 정차 중에는 park_refresh_s 마다 다시 보냄
//                        (바로 되돌리면 0.13 < 평소 0.25 → twist_mux 잠금이 회전 · 후진 · Nav2 를 모두 막아 박스 앞에서 멈춤)
//                        먼 거리: object_pose(D435, base_link) → 회전 + 전진/후진, 범퍼 기준 거리, /scan 장애물 감시
//                        박스 (goal.box_only, #160 빈 장소 상자): 인식 결과를 기다리지 않음. 시작 yaw (odom) 유지 + TFmini → 전후.
//                        정지 거리 낮추기 · 박스 앞 정차는 정밀과 같음. 남는 좌우 · 각도는 mission measure_box 가 메움
//   (#157) /drive/navigate 를 정차 중에 받으면 먼저 곧게 후진 (navigate.backoff.*, 뒤 /scan · 뒤 카메라 확인) → 물러남 확인 뒤 Nav2
//   /drive/execute_skill 강화학습 정책 (robot_policy, CPU) → 속도
//                        turn_p<deg> · turn_m<deg> · turn_0 = 직전 FINE 정렬 방향 기준 제자리 회전 (#77, 정책 · skill.enabled 와 상관없음)
//   result · /tfmini/range · /scan · odom 은 header.stamp 300 ms 지나면 버림. 바퀴 goal 은 한 번에 하나.
//   후진 (v < 0) 은 scan.rear_camera 면 /perception/rear_obstacle (뒤 D435, 받은 지 stale_s 안) 도 확인 (#84):
//   COARSE = 실패로 끝냄, FINE · skill = 전후 속도만 0 (회전 허용)
#include <chrono>
#include <cmath>
#include <cstdio>
#include <memory>
#include <optional>
#include <string>
#include <utility>
#include <vector>

#include "geometry_msgs/msg/twist_stamped.hpp"
#include "nav2_msgs/action/navigate_to_pose.hpp"
#include "nav2_msgs/action/spin.hpp"
#include "nav_msgs/msg/odometry.hpp"
#include "rclcpp/rclcpp.hpp"
#include "robot_interfaces/names.hpp"
#include "rclcpp_action/rclcpp_action.hpp"
#include "rclcpp_components/register_node_macro.hpp"
#include "control/align_controller.hpp"
#include "control/box_park.hpp"
#include "control/loc_gate.hpp"
#include "control/turn_skill.hpp"
#include "robot_interfaces/srv/set_perception_mode.hpp"
#include "robot_interfaces/action/align_base.hpp"
#include "robot_interfaces/action/execute_skill.hpp"
#include "robot_interfaces/msg/perception_result.hpp"
#include "robot_policy/policy.hpp"
#include "sensor_msgs/msg/laser_scan.hpp"
#include "sensor_msgs/msg/range.hpp"
#include "std_msgs/msg/bool.hpp"
#include "std_msgs/msg/string.hpp"
#include "tf2/utils.hpp"
#include "tf2_geometry_msgs/tf2_geometry_msgs.hpp"
#include "tf2_ros/buffer.hpp"
#include "tf2_ros/transform_listener.hpp"

namespace control
{
namespace names = robot_interfaces::names;
namespace qos = robot_interfaces::qos;
using namespace std::chrono_literals;
using Nav = nav2_msgs::action::NavigateToPose;
using Spin = nav2_msgs::action::Spin;
using Align = robot_interfaces::action::AlignBase;
using Skill = robot_interfaces::action::ExecuteSkill;
using NavGH = rclcpp_action::ServerGoalHandle<Nav>;
using AlignGH = rclcpp_action::ServerGoalHandle<Align>;
using SkillGH = rclcpp_action::ServerGoalHandle<Skill>;
using PerceptionResult = robot_interfaces::msg::PerceptionResult;
using PerceptionMode = robot_interfaces::srv::SetPerceptionMode::Request;   // 모드 비트

class DriveNode : public rclcpp::Node
{
public:
  explicit DriveNode(const rclcpp::NodeOptions & options)
  : Node("drive_node", options)
  {
    AlignGains g;
    g.kp_yaw = declare_parameter("align.kp_yaw", g.kp_yaw);
    g.kp_lin = declare_parameter("align.kp_lin", g.kp_lin);
    g.max_ang = declare_parameter("align.max_angular", g.max_ang);
    g.max_lin = declare_parameter("align.max_linear", g.max_lin);
    g.lateral_tol = declare_parameter("align.lateral_tolerance", g.lateral_tol);
    g.settle_cycles = declare_parameter("align.settle_cycles", g.settle_cycles);
    fine_ = AlignController(g);
    CoarseGains cg;
    cg.kp_yaw = declare_parameter("align.coarse_kp_yaw", cg.kp_yaw);
    cg.kp_lin = declare_parameter("align.coarse_kp_lin", cg.kp_lin);
    cg.max_lin = declare_parameter("align.coarse_max_speed", cg.max_lin);
    cg.max_ang = declare_parameter("align.coarse_max_angular", cg.max_ang);
    cg.yaw_tol = declare_parameter("align.coarse_yaw_tolerance", cg.yaw_tol);
    coarse_ = CoarseAlign(cg);
    BoxApproachGains bg;
    bg.kp_yaw = declare_parameter("align.box_only.kp_yaw", bg.kp_yaw);
    bg.max_ang = declare_parameter("align.box_only.max_angular", bg.max_ang);
    bg.yaw_tol = declare_parameter("align.box_only.yaw_tolerance", bg.yaw_tol);
    bg.kp_lin = g.kp_lin;
    bg.max_lin = g.max_lin;
    bg.settle_cycles = g.settle_cycles;
    box_only_ = BoxApproach(bg);
    rate_hz_ = declare_parameter("align.rate_hz", 20.0);
    lost_s_ = declare_parameter("align.lost_timeout_s", 0.5);
    mode_wait_s_ = declare_parameter("align.mode_wait_s", 0.5);
    align_timeout_s_ = declare_parameter("align.timeout_s", 30.0);
    min_fine_target_ = declare_parameter("align.min_target_distance", 0.13);   // 박스 거리: 최소 측정 0.10 + 정지 여유
    BoxRangeConfig bc;
    bc.window = static_cast<int>(declare_parameter("align.box.window", bc.window));
    bc.min_samples = static_cast<int>(declare_parameter("align.box.min_samples", bc.min_samples));
    bc.spread_m = declare_parameter("align.box.spread_m", bc.spread_m);
    box_ = BoxRangeFilter(bc);
    box_stop_margin_ = declare_parameter("align.box.stop_margin", 0.03);
    box_stop_min_ = declare_parameter("align.box.stop_min", 0.10);
    obstacle_stop_node_ = declare_parameter("align.box.obstacle_stop_node", std::string("/obstacle_stop"));
    BoxParkConfig pc;
    pc.release_m = declare_parameter("align.box.park_release_m", pc.release_m);
    pc.release_count = static_cast<int>(declare_parameter("align.box.park_release_count", pc.release_count));
    pc.refresh_s = declare_parameter("align.box.park_refresh_s", pc.refresh_s);
    pc.backoff_speed = declare_parameter("navigate.backoff.speed", pc.backoff_speed);
    pc.backoff_max_m = declare_parameter("navigate.backoff.max_m", pc.backoff_max_m);
    pc.backoff_timeout_s = declare_parameter("navigate.backoff.timeout_s", pc.backoff_timeout_s);
    box_park_ = BoxPark(pc);
    coarse_min_ = declare_parameter("align.coarse_min", 0.3);
    default_tol_ = declare_parameter("align.default_tolerance", 0.01);
    front_offset_ = declare_parameter("base.front_offset", 0.1328);   // base_link → 차체 앞 끝 (B안) ★
    scan_half_ = declare_parameter("scan.half_angle", 0.349);        // ±20°
    scan_front_margin_ = declare_parameter("scan.front_margin", 0.10);
    scan_rear_stop_ = declare_parameter("scan.rear_stop", 0.30);
    require_scan_ = declare_parameter("scan.required", true);
    rear_camera_ = declare_parameter("scan.rear_camera", false);   // 뒤 D435 후진 확인 (카메라 없는 실행 · 시뮬은 false)
    stale_s_ = declare_parameter("stale_s", 0.3);
    xy_tol_ = declare_parameter("navigate.xy_goal_tolerance", 0.25);
    spin_time_ = declare_parameter("navigate.spin_time_allowance", 15.0);
    map_frame_ = declare_parameter("frames.map", std::string("map"));
    base_frame_ = declare_parameter("frames.base", std::string("base_link"));
    LocGateParams lg;
    lg.enabled = declare_parameter("navigate.loc_gate.enabled", lg.enabled);
    lg.wait_s = declare_parameter("navigate.loc_gate.wait_s", lg.wait_s);
    lg.stale_s = declare_parameter("navigate.loc_gate.stale_s", lg.stale_s);
    lg.start_states = declare_parameter("navigate.loc_gate.start_states", lg.start_states);
    lg.run_states = declare_parameter("navigate.loc_gate.run_states", lg.run_states);
    loc_gate_ = LocGate(lg);
    nav_action_name_ = declare_parameter("nav2_action", std::string("navigate_to_pose"));
    spin_action_name_ = declare_parameter("spin_action", std::string("spin"));
    skill_enabled_ = declare_parameter("skill.enabled", false);
    const auto policies_file = declare_parameter("skill.policies_file", std::string(""));
    max_v_ = declare_parameter("skill.max_linear", 0.3);
    max_w_ = declare_parameter("skill.max_angular", 1.5);
    scan_bins_ = declare_parameter("skill.scan_bins", 360);
    skill_front_margin_ = declare_parameter("skill.front_margin", 0.10);   // 범퍼 앞면에서 이 거리 안에 점 → 전진 0
    TurnGains tg;
    tg.kp = declare_parameter("turn.kp", tg.kp);
    tg.max_ang = declare_parameter("turn.max_angular", tg.max_ang);
    tg.min_ang = declare_parameter("turn.min_angular", tg.min_ang);
    tg.tol = declare_parameter("turn.tolerance_deg", 1.0) * M_PI / 180.0;
    tg.settle_cycles = declare_parameter("turn.settle_cycles", tg.settle_cycles);
    turn_ctl_ = TurnController(tg);
    turn_max_deg_ = declare_parameter("turn.max_deg", 30.0);
    turn_geo_.j1_x = declare_parameter("turn.j1_x", turn_geo_.j1_x);
    turn_geo_.center_x = declare_parameter("turn.center_x", turn_geo_.center_x);
    // 실제 회전 중심 = robot_geometry.yaml base.icr_x (EKF odom_icr 와 같은 값, #92). 기본 = 보정 없음
    turn_geo_.icr_x = declare_parameter("base.icr_x", turn_geo_.center_x);

    if (skill_enabled_) {
      std::vector<std::string> errs;
      policies_.load(policies_file, errs);
      for (const auto & e : errs) {RCLCPP_WARN(get_logger(), "정책 로드 실패: %s", e.c_str());}
      RCLCPP_INFO(get_logger(), "정책 %zu개 로드", policies_.names().size());
    }

    tf_buffer_ = std::make_unique<tf2_ros::Buffer>(get_clock());
    tf_listener_ = std::make_shared<tf2_ros::TransformListener>(*tf_buffer_);

    cbg_ = create_callback_group(rclcpp::CallbackGroupType::MutuallyExclusive);
    rclcpp::SubscriptionOptions so;
    so.callback_group = cbg_;
    cmd_pub_ = create_publisher<geometry_msgs::msg::TwistStamped>(names::CMD_VEL_DRIVE, 10);
    perc_sub_ = create_subscription<PerceptionResult>(names::PERCEPTION_RESULT, qos::result(),
        [this](PerceptionResult::ConstSharedPtr m) {result_ = m; result_rx_ = now();}, so);
    box_sub_ = create_subscription<sensor_msgs::msg::Range>(names::TFMINI_RANGE, qos::sensor(),
        [this](sensor_msgs::msg::Range::ConstSharedPtr m) {
          const bool ok = std::isfinite(m->range) && m->range >= m->min_range && m->range <= m->max_range;
          box_.push(rclcpp::Time(m->header.stamp, RCL_ROS_TIME).seconds(), ok ? std::optional<double>(m->range) : std::nullopt);
          if (box_park_.on_range(ok ? std::optional<double>(m->range) : std::nullopt)) {   // 물러남 확인 (#157)
            RCLCPP_INFO(get_logger(), "박스 앞 정차 해제: TFmini %.3f m — 평소 정지 거리로", m->range);
            set_box_approach(0.0);
          }
        }, so);
    obstacle_params_ = std::make_shared<rclcpp::AsyncParametersClient>(this, obstacle_stop_node_);
    scan_sub_ = create_subscription<sensor_msgs::msg::LaserScan>(names::SCAN, rclcpp::SensorDataQoS(),
        [this](sensor_msgs::msg::LaserScan::ConstSharedPtr m) {scan_ = m;}, so);
    odom_sub_ = create_subscription<nav_msgs::msg::Odometry>(names::ODOM_FILTERED, 10,
        [this](nav_msgs::msg::Odometry::ConstSharedPtr m) {odom_ = m;}, so);
    if (lg.enabled) {
      loc_sub_ = create_subscription<std_msgs::msg::String>(names::LOCALIZATION_STATUS, rclcpp::QoS(1).transient_local(),
          [this](std_msgs::msg::String::ConstSharedPtr m) {loc_gate_.status(m->data, now().seconds());}, so);
    }
    if (rear_camera_) {
      rear_sub_ = create_subscription<std_msgs::msg::Bool>(names::PERCEPTION_REAR_OBSTACLE, qos::latched_state(),
          [this](std_msgs::msg::Bool::ConstSharedPtr m) {rear_ = m->data; rear_rx_ = now();}, so);
      rear_reason_sub_ = create_subscription<std_msgs::msg::String>(names::PERCEPTION_REAR_OBSTACLE_REASON, qos::latched_state(),
          [this](std_msgs::msg::String::ConstSharedPtr m) {rear_reason_ = m->data;}, so);
    }

    nav_client_ = rclcpp_action::create_client<Nav>(this, nav_action_name_, cbg_);
    spin_client_ = rclcpp_action::create_client<Spin>(this, spin_action_name_, cbg_);

    nav_server_ = rclcpp_action::create_server<Nav>(this, names::DRIVE_NAVIGATE,
        [this](const rclcpp_action::GoalUUID &, std::shared_ptr<const Nav::Goal>) {
          return rclcpp_action::GoalResponse::ACCEPT_AND_EXECUTE;
        },
        [](std::shared_ptr<NavGH>) {return rclcpp_action::CancelResponse::ACCEPT;},
        [this](std::shared_ptr<NavGH> gh) {start_navigate(gh);},
        rcl_action_server_get_default_options(), cbg_);
    align_server_ = rclcpp_action::create_server<Align>(this, names::DRIVE_ALIGN,
        [this](const rclcpp_action::GoalUUID &, std::shared_ptr<const Align::Goal> g) {
          // target_distance 는 float32 → 0.13 이 0.12999999 로 와서 같은 값도 거부됨. 1e-4 m 여유로 비교
          if (g->target_distance < min_fine_target_ - 1e-4) {
            RCLCPP_WARN(get_logger(), "target_distance %.3f < %.2f m — 거부", g->target_distance, min_fine_target_);
            return rclcpp_action::GoalResponse::REJECT;
          }
          return rclcpp_action::GoalResponse::ACCEPT_AND_EXECUTE;
        },
        [](std::shared_ptr<AlignGH>) {return rclcpp_action::CancelResponse::ACCEPT;},
        [this](std::shared_ptr<AlignGH> gh) {start_align(gh);},
        rcl_action_server_get_default_options(), cbg_);
    skill_server_ = rclcpp_action::create_server<Skill>(this, names::DRIVE_SKILL,
        [this](const rclcpp_action::GoalUUID &, std::shared_ptr<const Skill::Goal> g) {
          if (const auto deg = parse_turn_deg(g->policy)) {   // 정해진 회전 — 정책 · skill.enabled 와 상관없음 (#77)
            if (std::fabs(*deg) > turn_max_deg_) {
              RCLCPP_WARN(get_logger(), "execute_skill 거부: %s 는 turn.max_deg %.0f° 초과", g->policy.c_str(), turn_max_deg_);
              return rclcpp_action::GoalResponse::REJECT;
            }
            return rclcpp_action::GoalResponse::ACCEPT_AND_EXECUTE;
          }
          std::string why;
          if (!skill_enabled_) {why = "skill.enabled=false";}
          else if (!policies_.find(g->policy)) {why = "정책 '" + g->policy + "' 없음";}
          else if (policies_.find(g->policy)->spec.action_kind != "base_twist") {why = "주행 정책이 아님";}
          if (!why.empty()) {
            RCLCPP_WARN(get_logger(), "execute_skill 거부: %s", why.c_str());
            return rclcpp_action::GoalResponse::REJECT;   // mission 이 fallback 실행
          }
          return rclcpp_action::GoalResponse::ACCEPT_AND_EXECUTE;
        },
        [](std::shared_ptr<SkillGH>) {return rclcpp_action::CancelResponse::ACCEPT;},
        [this](std::shared_ptr<SkillGH> gh) {start_skill(gh);},
        rcl_action_server_get_default_options(), cbg_);

    // 노드 시계 기준 (use_sim_time 이면 /clock) — wall timer 는 시뮬레이션 실시간 비율이 1 이 아니면 주기 · timeout 이 어긋남
    timer_ = rclcpp::create_timer(this, get_clock(), rclcpp::Duration::from_seconds(1.0 / rate_hz_),
        [this]() {tick();}, cbg_);
    RCLCPP_INFO(get_logger(), "drive_node 준비 (align %.0f Hz, 정책 %s)", rate_hz_,
      skill_enabled_ ? "사용" : "사용 안 함");
  }

private:
  bool fresh(const builtin_interfaces::msg::Time & stamp) const
  {
    const double age = (now() - rclcpp::Time(stamp, RCL_ROS_TIME)).seconds();
    return age <= stale_s_ && age >= -0.5;
  }

  void publish_cmd(double v, double w)
  {
    geometry_msgs::msg::TwistStamped t;
    t.header.stamp = now();
    t.header.frame_id = base_frame_;
    t.twist.linear.x = v;
    t.twist.angular.z = w;
    cmd_pub_->publish(t);
  }

  // ---------- 바퀴 goal 하나만 ----------
  template<typename GH, typename R>
  void end(std::shared_ptr<GH> & gh, bool ok, std::shared_ptr<R> r, bool canceled = false)
  {
    if (gh && gh->is_active()) {
      if (canceled) {gh->canceled(r);} else if (ok) {gh->succeed(r);} else {gh->abort(r);}
    }
    gh.reset();
  }

  void preempt_all(const std::string & why)
  {
    if (align_gh_) {
      end_box_approach();
      publish_cmd(0, 0);
      auto r = std::make_shared<Align::Result>();
      r->message = why;
      end(align_gh_, false, r);
    }
    if (skill_gh_) {
      publish_cmd(0, 0);
      auto r = std::make_shared<Skill::Result>();
      r->message = why;
      end(skill_gh_, false, r);
      stop_skill_timer();
    }
    if (nav_gh_) {
      cancel_nav2();
      end(nav_gh_, false, std::make_shared<Nav::Result>());
    }
  }

  // ---------- /drive/navigate ----------
  std::optional<geometry_msgs::msg::PoseStamped> current_pose(const std::string & frame)
  {
    try {
      const auto t = tf_buffer_->lookupTransform(frame, base_frame_, tf2::TimePointZero);
      geometry_msgs::msg::PoseStamped p;
      p.header = t.header;
      p.pose.position.x = t.transform.translation.x;
      p.pose.position.y = t.transform.translation.y;
      p.pose.orientation = t.transform.rotation;
      return p;
    } catch (const tf2::TransformException &) {
      return std::nullopt;
    }
  }

  void start_navigate(std::shared_ptr<NavGH> gh)
  {
    preempt_all("새 /drive/navigate goal 로 대체");
    ref_yaw_.reset();   // turn_* 기준 방향은 다음 FINE 정렬 성공으로 다시 정함
    nav_gh_ = gh;
    if (box_park_.parked()) {start_backoff(); return;}   // 박스 앞이면 먼저 후진 (#157) → tick_backoff 가 begin_nav
    begin_nav();
  }

  void begin_nav()
  {
    if (!loc_gate_.begin(now().seconds())) {   // 위치 추정 OK 를 기다렸다 tick 이 보냄 (#121)
      RCLCPP_WARN(get_logger(), "navigate: 위치 추정 %s → OK 기다림 (최대 %.0f s)",
        loc_gate_.describe(now().seconds()).c_str(), loc_gate_.params().wait_s);
      return;
    }
    dispatch_nav();
  }

  // nav_gh_ 의 목표를 Nav2 로 보냄 (가까우면 spin)
  void dispatch_nav()
  {
    const uint64_t gen = ++nav_gen_;
    const auto & goal = *nav_gh_->get_goal();
    const std::string frame = goal.pose.header.frame_id.empty() ? map_frame_ : goal.pose.header.frame_id;
    auto cur = current_pose(frame);
    if (cur) {
      const double dx = goal.pose.pose.position.x - cur->pose.position.x;
      const double dy = goal.pose.pose.position.y - cur->pose.position.y;
      if (std::hypot(dx, dy) <= xy_tol_) {
        // 시작 = 목표 위치인 navigate_to_pose 는 경로가 안 나오거나 회전 없이 성공 → spin 으로 처리
        double dyaw = tf2::getYaw(goal.pose.pose.orientation) - tf2::getYaw(cur->pose.orientation);
        dyaw = std::atan2(std::sin(dyaw), std::cos(dyaw));
        Spin::Goal s;
        s.target_yaw = static_cast<float>(dyaw);
        s.time_allowance = rclcpp::Duration::from_seconds(spin_time_);
        RCLCPP_INFO(get_logger(), "navigate → spin %.1f°", dyaw * 180 / M_PI);
        if (!spin_client_->action_server_is_ready()) {finish_nav(false, "nav2 spin 서버 없음"); return;}
        auto opts = rclcpp_action::Client<Spin>::SendGoalOptions();
        opts.goal_response_callback = [this, gen](rclcpp_action::ClientGoalHandle<Spin>::SharedPtr h) {
            if (gen != nav_gen_) {if (h) {spin_client_->async_cancel_goal(h);} return;}
            if (!h) {finish_nav(false, "spin 거부"); return;}
            spin_handle_ = h;
          };
        opts.result_callback = [this, gen](const rclcpp_action::ClientGoalHandle<Spin>::WrappedResult & res) {
            if (gen != nav_gen_) {return;}
            spin_handle_.reset();
            finish_nav(res.code == rclcpp_action::ResultCode::SUCCEEDED, "spin");
          };
        spin_client_->async_send_goal(s, opts);
        return;
      }
    }
    if (!nav_client_->action_server_is_ready()) {finish_nav(false, "nav2 navigate_to_pose 서버 없음"); return;}
    auto opts = rclcpp_action::Client<Nav>::SendGoalOptions();
    opts.goal_response_callback = [this, gen](rclcpp_action::ClientGoalHandle<Nav>::SharedPtr h) {
        if (gen != nav_gen_) {if (h) {nav_client_->async_cancel_goal(h);} return;}
        if (!h) {finish_nav(false, "nav2 가 goal 거부"); return;}
        nav2_handle_ = h;
      };
    opts.feedback_callback = [this, gen](rclcpp_action::ClientGoalHandle<Nav>::SharedPtr,
      const std::shared_ptr<const Nav::Feedback> fb) {
        if (gen == nav_gen_ && nav_gh_ && nav_gh_->is_active()) {nav_gh_->publish_feedback(std::make_shared<Nav::Feedback>(*fb));}
      };
    opts.result_callback = [this, gen](const rclcpp_action::ClientGoalHandle<Nav>::WrappedResult & res) {
        if (gen != nav_gen_) {return;}
        nav2_handle_.reset();
        const bool ok = res.code == rclcpp_action::ResultCode::SUCCEEDED;
        if (!ok && loc_gate_.onNavFailed(now().seconds())) {   // 위치를 잃은 동안 끝남 → OK 되면 다시 (#121)
          RCLCPP_WARN(get_logger(), "navigate_to_pose 실패 (위치 추정 %s) → OK 되면 같은 목표 다시",
            loc_gate_.describe(now().seconds()).c_str());
          return;
        }
        finish_nav(ok, "navigate_to_pose");
      };
    nav_client_->async_send_goal(goal, opts);
  }

  // ---------- 박스 앞 정차 중 navigate: 먼저 곧게 후진 (#157) ----------
  void start_backoff()
  {
    backoff_active_ = true;
    backoff_start_ = now();
    backoff_from_.reset();
    const auto & c = box_park_.config();
    RCLCPP_INFO(get_logger(), "navigate: 박스 앞 정차 중 → 먼저 후진 (%.2f m/s, TFmini %.2f m 이상 확인 또는 최대 %.2f m)",
      c.backoff_speed, c.release_m, c.backoff_max_m);
  }

  void tick_backoff()
  {
    const auto & c = box_park_.config();
    const double el = (now() - backoff_start_).seconds();
    double traveled = 0.0;
    if (odom_ && fresh(odom_->header.stamp)) {
      const auto & p = odom_->pose.pose.position;
      if (!backoff_from_) {backoff_from_ = std::make_pair(p.x, p.y);}
      traveled = std::hypot(p.x - backoff_from_->first, p.y - backoff_from_->second);
    }
    // 뒤 확인 = 정책 주행과 같은 규칙: 뒤 /scan ±scan.half_angle 에 scan.rear_stop, 뒤 카메라 (#84). /scan 이 없으면 기다림
    const bool scan_ok = scan_ && fresh(scan_->header.stamp);
    const bool rear_blocked = (!scan_ok && require_scan_) ||
      (scan_ok && scan_blocked(scan_->ranges, scan_->angle_min, scan_->angle_increment, M_PI, scan_half_, scan_rear_stop_)) ||
      rear_camera_blocks(-c.backoff_speed, rear_camera_, rear_state());
    switch (backoff_step(c, box_park_.parked(), traveled, el, rear_blocked)) {
      case BackoffStep::DRIVE:
        publish_cmd(-c.backoff_speed, 0.0);
        return;
      case BackoffStep::HOLD:
        publish_cmd(0, 0);
        RCLCPP_WARN_THROTTLE(get_logger(), *get_clock(), 1000, "후진 대기: 뒤 막힘 (/scan %s, 뒤 카메라 %s)",
          scan_ok ? "확인" : "없음", rear_why().c_str());
        return;
      case BackoffStep::TIMEOUT:
        publish_cmd(0, 0);
        backoff_active_ = false;
        finish_nav(false, "박스 앞 후진 시간 초과 (뒤 막힘 또는 물러남 확인 못 함)");   // 정차는 유지 → mission 재시도 때 다시 후진
        return;
      case BackoffStep::MAX_DISTANCE:
        RCLCPP_WARN(get_logger(), "후진 %.2f m 갔지만 TFmini 로 물러남을 확인 못 함 — 평소 정지 거리로 되돌리고 Nav2", traveled);
        box_park_.clear();
        set_box_approach(0.0);
        break;
      case BackoffStep::RELEASED:   // TFmini 콜백이 이미 평소 정지 거리로 되돌림
        break;
    }
    publish_cmd(0, 0);
    backoff_active_ = false;
    RCLCPP_INFO(get_logger(), "박스 앞 후진 끝 (%.2f m, %.1f s) → Nav2", traveled, el);
    begin_nav();
  }

  void cancel_nav2()
  {
    if (backoff_active_) {backoff_active_ = false; publish_cmd(0, 0);}
    ++nav_gen_;
    loc_gate_.reset();
    if (nav2_handle_) {nav_client_->async_cancel_goal(nav2_handle_); nav2_handle_.reset();}
    if (spin_handle_) {spin_client_->async_cancel_goal(spin_handle_); spin_handle_.reset();}
  }

  void finish_nav(bool ok, const std::string & what)
  {
    if (!ok) {RCLCPP_WARN(get_logger(), "navigate 실패 (%s)", what.c_str());}
    end(nav_gh_, ok, std::make_shared<Nav::Result>());
  }

  // ---------- /drive/align ----------
  enum class AlignMode { WAIT, COARSE, FINE, BOX };   // BOX = goal.box_only (#160)

  void start_align(std::shared_ptr<AlignGH> gh)
  {
    preempt_all("새 /drive/align goal 로 대체");
    ref_yaw_.reset();
    align_gh_ = gh;
    fine_.reset();
    coarse_.reset();
    box_only_.reset();
    align_mode_ = AlignMode::WAIT;
    align_start_ = now();
    last_valid_ = align_start_;
    align_target_ = gh->get_goal()->target_distance;
    box_.reset();
    align_tol_ = gh->get_goal()->tolerance > 0.0 ? gh->get_goal()->tolerance : default_tol_;
    box_yaw_.reset();
    if (gh->get_goal()->box_only) {   // 인식 결과 없이 바로 박스 모드: 지금 yaw 를 지킴 (#160)
      if (!odom_ || !fresh(odom_->header.stamp)) {finish_align(false, "박스 접근: /odometry/filtered 없음 (yaw 를 지킬 수 없음)"); return;}
      box_yaw_ = tf2::getYaw(odom_->pose.pose.orientation);
      enter_box_approach(AlignMode::BOX);
    }
  }

  // 정밀 · 박스: obstacle_stop 정지 거리를 낮추고 이 정렬이 맡음 (끝날 때 end_box_approach 가 정차 판단)
  void enter_box_approach(AlignMode mode)
  {
    align_mode_ = mode;
    last_valid_ = now();
    box_park_.clear();
    fine_stop_m_ = box_approach_stop(align_target_, box_stop_margin_, box_stop_min_);
    set_box_approach(fine_stop_m_);
    RCLCPP_INFO(get_logger(), "align 모드: %s, 목표 %.3f m",
      mode == AlignMode::BOX ? "박스 (퍽 없이, yaw 유지 + TFmini)" : "정밀(TFmini 박스 거리)", align_target_);
  }

  // 정렬이 끝날 때 (성공 · 실패 · 취소 · 선점) 낮춘 정지 거리 처리 (#157)
  //   FINE: 박스 앞 (TFmini < park_release_m · 무효) 이면 정차 = 낮춘 값 유지, 멀면 바로 되돌림
  //   COARSE · 모드 결정 전: 앞서 정차한 값이 있으면 유지 (TFmini 로 물러남을 확인하면 콜백이 되돌림)
  void end_box_approach()
  {
    if (!box_approach_set_) {return;}
    if (align_mode_ == AlignMode::FINE || align_mode_ == AlignMode::BOX) {
      const auto r = box_.value(now().seconds());
      if (box_park_.on_align_end(now().seconds(), fine_stop_m_, r)) {
        RCLCPP_INFO(get_logger(), "박스 앞 정차: TFmini %.3f m — 정지 거리 %.3f m 유지 (물러난 뒤 되돌림)", r ? *r : NAN, fine_stop_m_);
        return;
      }
    } else if (box_park_.parked()) {
      return;
    }
    set_box_approach(0.0);
  }

  // obstacle_stop 정지 거리 (0 = 평소로). 응답을 기다리지 않는다 — 실패하면 경고만 (정지 거리가 평소 값이면 박스 앞에서 서서 정렬이 시간 초과)
  void set_box_approach(double stop_m)
  {
    if (stop_m == 0.0 && !box_approach_set_) {return;}
    box_approach_set_ = stop_m != 0.0;
    if (!obstacle_params_->service_is_ready()) {
      RCLCPP_WARN(get_logger(), "%s 파라미터 서비스 없음 — 박스 접근 정지 거리 %.3f 를 넣지 못함", obstacle_stop_node_.c_str(), stop_m);
      return;
    }
    obstacle_params_->set_parameters({rclcpp::Parameter("approach_stop_m", stop_m)},
      [this, stop_m](std::shared_future<std::vector<rcl_interfaces::msg::SetParametersResult>> f) {
        const auto r = f.get();
        if (r.empty() || !r[0].successful) {
          RCLCPP_WARN(get_logger(), "obstacle_stop approach_stop_m=%.3f 거부: %s", stop_m, r.empty() ? "" : r[0].reason.c_str());
        }
      });
  }

  void finish_align(bool ok, const std::string & msg)
  {
    if (ok && (align_mode_ == AlignMode::FINE || align_mode_ == AlignMode::BOX)) {   // turn_* 기준 yaw₀ (#77)
      if (odom_ && fresh(odom_->header.stamp)) {
        ref_yaw_ = tf2::getYaw(odom_->pose.pose.orientation);
      } else {
        RCLCPP_WARN(get_logger(), "정밀 정렬 끝 yaw 를 /odometry/filtered 에서 못 읽음 — turn_* 를 쓸 수 없음");
      }
    }
    end_box_approach();
    publish_cmd(0, 0);
    auto r = std::make_shared<Align::Result>();
    r->success = ok;
    r->message = msg;
    RCLCPP_INFO(get_logger(), "align(%s) %s: %s",
      align_mode_ == AlignMode::FINE ? "정밀" : align_mode_ == AlignMode::BOX ? "박스" : "먼 거리",
      ok ? "성공" : "실패", msg.c_str());
    end(align_gh_, ok, r);
  }

  void tick_align()
  {
    if (align_gh_->is_canceling()) {
      end_box_approach();
      publish_cmd(0, 0);
      auto r = std::make_shared<Align::Result>();
      r->message = "취소됨";
      end(align_gh_, false, r, true);
      return;
    }
    const auto t = now();
    if ((t - align_start_).seconds() > align_timeout_s_) {finish_align(false, "시간 초과"); return;}

    if (align_mode_ == AlignMode::WAIT) {
      // goal 수신 뒤 stamp 인 첫 result 의 모드로 결정 — 이후 바꾸지 않음
      if (result_ && rclcpp::Time(result_->header.stamp, RCL_ROS_TIME) >= align_start_ && result_->mode != 0) {
        align_mode_ = (result_->mode & PerceptionMode::ARM_ALIGN) ? AlignMode::FINE : AlignMode::COARSE;
        if (align_mode_ == AlignMode::COARSE && align_target_ < coarse_min_) {
          finish_align(false, "먼 거리 모드인데 target_distance < align.coarse_min (팔을 편 채 접근 방지)");
          return;
        }
        last_valid_ = t;
        if (align_mode_ == AlignMode::FINE) {
          enter_box_approach(AlignMode::FINE);
        } else {
          RCLCPP_INFO(get_logger(), "align 모드: 먼 거리(범퍼), 목표 %.3f m", align_target_);
        }
      } else if ((t - align_start_).seconds() > mode_wait_s_) {
        finish_align(false, "0.5 s 안에 새 perception result 없음");
      }
      return;
    }

    auto fb = std::make_shared<Align::Feedback>();
    AlignCmd c;
    if (align_mode_ == AlignMode::BOX) {
      const bool odom_ok = odom_ && fresh(odom_->header.stamp);
      const auto box = box_.value(t.seconds());
      if (!odom_ok || !box) {
        publish_cmd(0, 0);
        if ((t - last_valid_).seconds() > lost_s_) {
          finish_align(false, !odom_ok ? "박스 접근: /odometry/filtered 끊김" :
            "박스 거리 무효 (/tfmini/range 끊김 · 무효 · 박스 모서리)");
        }
        return;
      }
      last_valid_ = t;
      const double yaw_err = wrap_pi(*box_yaw_ - tf2::getYaw(odom_->pose.pose.orientation));
      c = box_only_.step(yaw_err, *box, align_target_, align_tol_);
      fb->lateral_error = static_cast<float>(yaw_err);
      fb->distance = static_cast<float>(*box);
      if (rear_camera_blocks(c.v, rear_camera_, rear_state())) {
        RCLCPP_WARN_THROTTLE(get_logger(), *get_clock(), 1000, "박스 접근: 후방 장애물 (뒤 카메라: %s) — 후진 0", rear_why().c_str());
        c.v = 0.0;
      }
    } else if (align_mode_ == AlignMode::FINE) {
      const bool off_ok = result_ && fresh(result_->header.stamp) && (result_->mode & PerceptionMode::ARM_ALIGN) && result_->offset_valid;
      const auto box = box_.value(t.seconds());
      if (!off_ok || !box) {
        publish_cmd(0, 0);   // 정밀 중 값이 끊겨도 먼 거리로 바꾸지 않음 (팔을 편 채 범퍼 기준 접근 = 충돌)
        if ((t - last_valid_).seconds() > lost_s_) {
          finish_align(false, !off_ok ? "물체 놓침 (arm_offset)" : "박스 거리 무효 (/tfmini/range 끊김 · 무효 · 박스 모서리)");
        }
        return;
      }
      last_valid_ = t;
      c = fine_.step(result_->arm_offset.x, *box, align_target_, align_tol_);
      fb->lateral_error = static_cast<float>(result_->arm_offset.x);
      fb->distance = static_cast<float>(*box);
      if (rear_camera_blocks(c.v, rear_camera_, rear_state())) {
        RCLCPP_WARN_THROTTLE(get_logger(), *get_clock(), 1000, "정밀 정렬: 후방 장애물 (뒤 카메라: %s) — 후진 0", rear_why().c_str());
        c.v = 0.0;
      }
    } else {
      const bool obj_ok = result_ && fresh(result_->header.stamp) && result_->object_found;
      if (!obj_ok) {
        publish_cmd(0, 0);
        if ((t - last_valid_).seconds() > lost_s_) {finish_align(false, "물체 놓침 (object_pose)");}
        return;
      }
      last_valid_ = t;
      const auto & p = result_->object_pose.pose.position;
      c = coarse_.step(p.x, p.y, front_offset_, align_target_, std::max(align_tol_, 0.02));
      fb->lateral_error = static_cast<float>(std::atan2(p.y, p.x));
      fb->distance = static_cast<float>(p.x - front_offset_);
      // 직접 P 제어라 nav2 회피가 없음 → /scan 확인
      if (c.v != 0.0) {
        const bool scan_ok = scan_ && fresh(scan_->header.stamp);
        if (!scan_ok && require_scan_) {finish_align(false, "/scan 없음 — 먼 거리 접근 중지"); return;}
        if (scan_ok) {
          const bool fwd = c.v > 0;
          const double limit = fwd ? std::hypot(p.x, p.y) - scan_front_margin_ : scan_rear_stop_;
          if (scan_blocked(scan_->ranges, scan_->angle_min, scan_->angle_increment, fwd ? 0.0 : M_PI, scan_half_, limit)) {
            finish_align(false, fwd ? "전방 장애물 (물체보다 가까운 점)" : "후방 장애물 0.3 m");
            return;
          }
        }
        if (rear_camera_blocks(c.v, rear_camera_, rear_state())) {
          finish_align(false, "후방 장애물 (뒤 카메라: " + rear_why() + ")");
          return;
        }
      }
    }
    align_gh_->publish_feedback(fb);
    if (c.done) {finish_align(true, "허용오차 안에서 정지"); return;}
    publish_cmd(c.v, c.w);
  }

  // ---------- /drive/execute_skill ----------
  void start_skill(std::shared_ptr<SkillGH> gh)
  {
    preempt_all("새 execute_skill goal 로 대체");
    skill_gh_ = gh;
    skill_start_ = now();
    skill_timeout_ = gh->get_goal()->timeout > 0 ? gh->get_goal()->timeout : 30.0;
    turn_active_ = false;
    if (const auto deg = parse_turn_deg(gh->get_goal()->policy)) {
      skill_ = nullptr;
      if (!ref_yaw_) {
        finish_skill(false, "turn: 정렬 방향(yaw₀) 없음 — 직전 FINE 정렬 성공이 필요");
        return;
      }
      const double ang = turn_angle_rad(*deg, turn_geo_);
      turn_target_ = wrap_pi(*ref_yaw_ + ang);
      turn_total_ = 0.0;
      turn_last_odom_ = skill_start_;
      turn_ctl_.reset();
      turn_active_ = true;
      skill_timer_ = rclcpp::create_timer(this, get_clock(), rclcpp::Duration::from_seconds(1.0 / rate_hz_),
          [this]() {tick_skill();}, cbg_);
      RCLCPP_INFO(get_logger(), "skill %s 시작: yaw₀ %.2f° %+.2f° (이름 %+.2f°, icr_x %.4f), %.1f s",
        gh->get_goal()->policy.c_str(), *ref_yaw_ * 180 / M_PI, ang * 180 / M_PI, *deg, turn_geo_.icr_x, skill_timeout_);
      return;
    }
    skill_ = policies_.find(gh->get_goal()->policy);
    skill_timer_ = rclcpp::create_timer(this, get_clock(), rclcpp::Duration::from_seconds(1.0 / skill_->spec.rate_hz),
        [this]() {tick_skill();}, cbg_);
    RCLCPP_INFO(get_logger(), "skill %s 시작 (%.0f Hz, %.1f s)", skill_->spec.name.c_str(), skill_->spec.rate_hz, skill_timeout_);
  }

  // 타이머 콜백(tick_skill) 안에서 끝날 수 있으므로 파괴하지 않고 멈추기만 한다 (다음 start_skill 에서 교체)
  void stop_skill_timer()
  {
    if (skill_timer_) {skill_timer_->cancel();}
  }

  void finish_skill(bool ok, const std::string & msg, bool canceled = false)
  {
    publish_cmd(0, 0);
    stop_skill_timer();
    auto r = std::make_shared<Skill::Result>();
    r->success = ok;
    r->message = msg;
    RCLCPP_INFO(get_logger(), "skill %s: %s", ok ? "성공" : "실패", msg.c_str());
    end(skill_gh_, ok, r, canceled);
  }

  std::optional<std::vector<float>> scan_bins()
  {
    if (!scan_ || !fresh(scan_->header.stamp)) {return std::nullopt;}
    std::vector<float> b(scan_bins_, scan_->range_max);
    for (size_t i = 0; i < scan_->ranges.size(); ++i) {
      const float r = scan_->ranges[i];
      if (!std::isfinite(r) || r < scan_->range_min) {continue;}
      double a = scan_->angle_min + scan_->angle_increment * i;
      a = std::atan2(std::sin(a), std::cos(a));   // -π ~ π
      const int k = std::clamp(static_cast<int>((a + M_PI) / (2 * M_PI) * scan_bins_), 0, scan_bins_ - 1);
      b[k] = std::min(b[k], std::min(r, scan_->range_max));
    }
    return b;
  }

  void tick_skill()
  {
    if (!skill_gh_) {stop_skill_timer(); return;}
    if (skill_gh_->is_canceling()) {finish_skill(false, "취소됨", true); return;}
    const double el = (now() - skill_start_).seconds();
    if (turn_active_) {tick_turn(el); return;}
    if (el >= skill_timeout_) {
      if (skill_->spec.finish_on_timeout) {finish_skill(true, "정해진 시간 완료");} else {finish_skill(false, "시간 초과");}
      return;
    }
    robot_policy::ObsValues v;
    v["scan"] = scan_bins();
    if (odom_ && fresh(odom_->header.stamp)) {
      v["odom_twist"] = std::vector<float>{static_cast<float>(odom_->twist.twist.linear.x),
        static_cast<float>(odom_->twist.twist.linear.y), static_cast<float>(odom_->twist.twist.angular.z)};
    } else {
      v["odom_twist"] = std::nullopt;
    }
    if (result_ && fresh(result_->header.stamp) && result_->object_found) {
      const auto & p = result_->object_pose.pose.position;
      v["object_pose_base"] = std::vector<float>{static_cast<float>(p.x), static_cast<float>(p.y), static_cast<float>(p.z)};
    } else {
      v["object_pose_base"] = std::nullopt;
    }
    std::vector<float> obs, raw;
    std::string err;
    if (!robot_policy::ObservationBuilder(skill_->spec).build(v, obs, err)) {finish_skill(false, "필수 관측 무효: " + err); return;}
    if (!skill_->runner->run(obs, raw)) {finish_skill(false, "추론 실패"); return;}
    const auto a = robot_policy::ActionMapper(skill_->spec).map(raw);
    double cmd_v = std::clamp<double>(a[0], -max_v_, max_v_);
    const double cmd_w = std::clamp<double>(a[1], -max_w_, max_w_);
    // 정책 출력은 nav2 · collision_monitor 를 거치지 않음 → 진행 방향 /scan 확인 (align 과 같은 규칙)
    //   막힌 방향의 전후 속도만 0, 회전은 그대로 (정책이 돌아서 빠져나갈 수 있게)
    if (std::fabs(cmd_v) > 1e-3) {
      const bool scan_ok = scan_ && fresh(scan_->header.stamp);
      if (!scan_ok && require_scan_) {finish_skill(false, "/scan 없음 — 정책 주행 중지"); return;}
      if (scan_ok) {
        const bool fwd = cmd_v > 0;
        const double limit = fwd ? front_offset_ + skill_front_margin_ : scan_rear_stop_;
        if (scan_blocked(scan_->ranges, scan_->angle_min, scan_->angle_increment, fwd ? 0.0 : M_PI, scan_half_, limit)) {
          RCLCPP_WARN_THROTTLE(get_logger(), *get_clock(), 1000, "skill: %s 장애물 — 전후 속도 0", fwd ? "전방" : "후방");
          cmd_v = 0.0;
        }
      }
      if (rear_camera_blocks(cmd_v, rear_camera_, rear_state())) {
        RCLCPP_WARN_THROTTLE(get_logger(), *get_clock(), 1000, "skill: 후방 장애물 (뒤 카메라: %s) — 전후 속도 0", rear_why().c_str());
        cmd_v = 0.0;
      }
    }
    publish_cmd(cmd_v, cmd_w);
    auto fb = std::make_shared<Skill::Feedback>();
    fb->progress = static_cast<float>(el / skill_timeout_);
    skill_gh_->publish_feedback(fb);
  }

  // 제자리 회전 (v 0). 회전 여유는 계획기 BOX_GAP 이 보장 — 스캔면(82 mm)은 박스(70 mm)를 못 보므로 /scan 확인 없음
  void tick_turn(double el)
  {
    if (el >= skill_timeout_) {finish_skill(false, "turn: 시간 초과"); return;}
    if (!odom_ || !fresh(odom_->header.stamp)) {
      publish_cmd(0, 0);
      if ((now() - turn_last_odom_).seconds() > lost_s_) {finish_skill(false, "turn: /odometry/filtered 끊김");}
      return;
    }
    turn_last_odom_ = now();
    const double err = wrap_pi(turn_target_ - tf2::getYaw(odom_->pose.pose.orientation));
    if (turn_total_ <= 0.0) {turn_total_ = std::max(std::fabs(err), 1e-3);}
    const auto c = turn_ctl_.step(err);
    if (c.done) {
      char buf[64];
      std::snprintf(buf, sizeof(buf), "turn: 끝 yaw 오차 %.2f°", err * 180 / M_PI);
      finish_skill(true, buf);
      return;
    }
    publish_cmd(0.0, c.w);
    auto fb = std::make_shared<Skill::Feedback>();
    fb->progress = static_cast<float>(std::clamp(1.0 - std::fabs(err) / turn_total_, 0.0, 1.0));
    skill_gh_->publish_feedback(fb);
  }

  // 뒤 카메라 최신 값 (받은 지 stale_s 넘으면 없음 = nullopt)
  std::optional<bool> rear_state()
  {
    if (!rear_ || (now() - rear_rx_).seconds() > stale_s_) {return std::nullopt;}
    return rear_;
  }

  std::string rear_why()
  {
    if (!rear_state()) {return "값 없음 · 오래됨";}
    return rear_reason_.empty() ? "막힘" : rear_reason_;
  }

  void tick()
  {
    if (nav_gh_ && nav_gh_->is_canceling()) {
      cancel_nav2();
      end(nav_gh_, false, std::make_shared<Nav::Result>(), true);
    }
    if (nav_gh_) {
      if (backoff_active_) {tick_backoff();} else {tick_loc_gate();}
    }
    if (align_gh_) {tick_align();}
    if (box_park_.refresh_due(now().seconds())) {set_box_approach(box_park_.stop_m());}   // 정차 중 다시 보냄 (#157)
  }

  void tick_loc_gate()
  {
    const double t = now().seconds();
    switch (loc_gate_.tick(t, static_cast<bool>(nav2_handle_))) {
      case LocGate::Action::SEND:
        RCLCPP_INFO(get_logger(), "navigate: 위치 추정 OK → 목표 보냄");
        dispatch_nav();
        break;
      case LocGate::Action::RESEND:
        RCLCPP_WARN(get_logger(), "navigate: 위치를 다시 찾음 → 같은 목표 다시 보냄 (낡은 경로 버림)");
        cancel_nav2();
        dispatch_nav();
        break;
      case LocGate::Action::FAIL:
        finish_nav(false, "위치 추정 OK 기다림 시간 초과 (" + loc_gate_.describe(t) + ")");
        break;
      case LocGate::Action::NONE:
        break;
    }
  }

  // 파라미터
  double rate_hz_, lost_s_, mode_wait_s_, align_timeout_s_, min_fine_target_, coarse_min_, default_tol_, front_offset_;
  double scan_half_, scan_front_margin_, scan_rear_stop_, stale_s_, xy_tol_, spin_time_, max_v_, max_w_, skill_front_margin_;
  bool require_scan_, skill_enabled_, rear_camera_;
  int scan_bins_;
  std::string map_frame_, base_frame_, nav_action_name_, spin_action_name_;
  AlignController fine_;
  LocGate loc_gate_;
  CoarseAlign coarse_;
  BoxApproach box_only_;
  std::optional<double> box_yaw_;   // 박스 접근 목표 yaw (odom, goal 받은 때)
  robot_policy::PolicyLibrary policies_;

  // 입력 (최신값, 300 ms 규칙은 쓸 때 확인)
  PerceptionResult::ConstSharedPtr result_;
  rclcpp::Time result_rx_{0, 0, RCL_ROS_TIME};
  BoxRangeFilter box_;   // /tfmini/range (박스 앞면)
  double box_stop_margin_ = 0.03, box_stop_min_ = 0.10;
  std::string obstacle_stop_node_;
  bool box_approach_set_ = false;
  // 박스 앞 정차 (#157)
  BoxPark box_park_;
  double fine_stop_m_ = 0.0;   // 이번 FINE 정렬이 넣은 정지 거리
  bool backoff_active_ = false;
  rclcpp::Time backoff_start_{0, 0, RCL_ROS_TIME};
  std::optional<std::pair<double, double>> backoff_from_;   // 후진 시작 odom (x, y)
  std::shared_ptr<rclcpp::AsyncParametersClient> obstacle_params_;
  sensor_msgs::msg::LaserScan::ConstSharedPtr scan_;
  nav_msgs::msg::Odometry::ConstSharedPtr odom_;
  std::optional<bool> rear_;   // /perception/rear_obstacle (#84)
  rclcpp::Time rear_rx_{0, 0, RCL_ROS_TIME};
  std::string rear_reason_;

  // goal
  std::shared_ptr<NavGH> nav_gh_;
  std::shared_ptr<AlignGH> align_gh_;
  std::shared_ptr<SkillGH> skill_gh_;
  rclcpp_action::ClientGoalHandle<Nav>::SharedPtr nav2_handle_;
  rclcpp_action::ClientGoalHandle<Spin>::SharedPtr spin_handle_;
  uint64_t nav_gen_ = 0;
  AlignMode align_mode_ = AlignMode::WAIT;
  rclcpp::Time align_start_{0, 0, RCL_ROS_TIME}, last_valid_{0, 0, RCL_ROS_TIME}, skill_start_{0, 0, RCL_ROS_TIME};
  double align_target_ = 0.15, align_tol_ = 0.01, skill_timeout_ = 30.0;
  robot_policy::LoadedPolicy * skill_ = nullptr;
  // turn_* (#77)
  TurnController turn_ctl_;
  TurnGeometry turn_geo_;
  std::optional<double> ref_yaw_;   // 직전 FINE 정렬 성공 때 yaw (odom frame)
  bool turn_active_ = false;
  double turn_target_ = 0.0, turn_total_ = 0.0, turn_max_deg_ = 30.0;
  rclcpp::Time turn_last_odom_{0, 0, RCL_ROS_TIME};

  rclcpp::CallbackGroup::SharedPtr cbg_;
  std::unique_ptr<tf2_ros::Buffer> tf_buffer_;
  std::shared_ptr<tf2_ros::TransformListener> tf_listener_;
  rclcpp::Publisher<geometry_msgs::msg::TwistStamped>::SharedPtr cmd_pub_;
  rclcpp::Subscription<PerceptionResult>::SharedPtr perc_sub_;
  rclcpp::Subscription<sensor_msgs::msg::Range>::SharedPtr box_sub_;
  rclcpp::Subscription<sensor_msgs::msg::LaserScan>::SharedPtr scan_sub_;
  rclcpp::Subscription<nav_msgs::msg::Odometry>::SharedPtr odom_sub_;
  rclcpp::Subscription<std_msgs::msg::String>::SharedPtr loc_sub_;
  rclcpp::Subscription<std_msgs::msg::Bool>::SharedPtr rear_sub_;
  rclcpp::Subscription<std_msgs::msg::String>::SharedPtr rear_reason_sub_;
  rclcpp_action::Client<Nav>::SharedPtr nav_client_;
  rclcpp_action::Client<Spin>::SharedPtr spin_client_;
  rclcpp_action::Server<Nav>::SharedPtr nav_server_;
  rclcpp_action::Server<Align>::SharedPtr align_server_;
  rclcpp_action::Server<Skill>::SharedPtr skill_server_;
  rclcpp::TimerBase::SharedPtr timer_, skill_timer_;
};

}  // namespace control

RCLCPP_COMPONENTS_REGISTER_NODE(control::DriveNode)
