developlcy-oss/Lv2_Cartlidar_Assignment/workspace/ros2_ws/src/control/config/manipulator.yaml

# manipulator_node 설정 (Controller 팀)
# (추정) 값은 URDF · 하드웨어 확정 후 수정
manipulator_node:
  ros__parameters:
    arm:
      joint_names: [joint1, joint2, joint3, joint4, joint5, gripper_roll]  # controllers.yaml arm_controller와 동일
      # 관절 한계 = URDF robot.urdf.xacro = 펌웨어 config.h ARM_MIN/MAX_RAD (#83, 세 곳 같게 — test_config_limits 가 확인)
      #   펌웨어는 범위 밖 CMD 를 통째로 거부한다. 6 번째 gripper_roll = 그리퍼 개폐 (열림 -0.764 · 닫힘 0.923)
      lower_limits: [-3.14159, -2.14, -1.6, -1.92, -2.8, -0.7946]
      upper_limits: [3.14159, 1.6, 1.6, 2.0, 2.8, 0.9541]
      max_joint_velocity: 0.5    # rad/s, 궤적 시간 계산용
      min_duration: 1.0          # s
      # 관절 목표 하나 이동 (자세 · 켜질 때 정리 · 집기 접근) 을 최소 저크 곡선 (include/control/min_jerk.hpp) 점으로 나누는 간격 [s].
      #   출발 · 도착 가속도가 튀지 않아 J2 늦음 · 넘침, 손목 끝 떨림이 줄어듦 (2026-11-13 실물 STOW → DRIVE). 0 = 끝점 하나 (예전 3 차)
      #   같은 시간에서 가장 빠른 순간 속도 = 1.875 × 평균 (3 차 1.5 배) ★ 실물 비교
      min_jerk_dt: 0.05
      joint_state_timeout: 1.0   # s

    # ArmIK — 기구 = 차체 URDF (robot.urdf.xacro) = 기준 모델 B안 = kinematics.py. include/control/arm_ik.hpp 머리말 참고
    ik:
      shoulder_height: 0.077     # arm_base_link → joint2 축 (robot.urdf.xacro joint1 z 0.077)
      upper_arm_x: 0.024         # joint2 → joint3
      upper_arm_z: 0.128
      forearm: 0.124             # joint3 → joint4
      wrist_to_tool: 0.167       # joint4 → tool_link (0.04 + 0.041 + 0.086, 팔레트 궤적 TCP 와 같은 점)
      # 관절 0점 보정 (joint1~5, 명령 = 모델 + offset). 2026-11-12 실물 cart11 보정 측정 6 점 (팔레트 칸 3-1 · 3-0 · 2-1, 상자 위 가운데 · 좌우 6 cm,
      #   IsaacLab .../manipulator/기록/실측/6_보정자세.csv, tools/arm_calib_fit.py --joints 1,2,3,4): RMS 6.7 mm, 맞출 때 안 쓴 앞쪽 처짐 자세 3 개 7 mm 안.
      #   ★ 팔레트 v5 (2026-11-13) 로 칸 자세가 바뀌어 다시 맞출 것: 재기 tools/arm_bench/real/meas_session.py 메뉴 10 · 4 (v5 칸) · 12,
      #     맞추기 workspace/tools/arm_calib/arm_calib_fit.py (저장소 판, README 참고)
      #   ★ 처짐까지 흡수한 '실효값' (관절 2 +27° 는 혼 어긋남이 아님) -> 측정한 곳 (앞 상자 위 집기 · 뒤 팔레트 칸) 근처에서만 믿을 것.
      #   이름 자세 (STOW · DRIVE · ALIGN 등 poses.*) 에는 안 들어감 (실물에서 정한 값). 0 으로 두면 이전과 같음
      joint_offsets: [-0.0283, -0.4788, 0.1641, 0.0955, 0.0]
      joint_signs: [1.0, 1.0, 1.0, 1.0, 1.0]     # 펌웨어 ARM_DIR 모두 +1 (2026-10-26 손으로 확인, URDF 방향과 같음)
      approach_pitches: [-0.7854, -1.5708, -1.0472]  # pick 시도 순서 (위로 +, -0.7854 = 45° 아래)
      allow_elbow_down: false
      use_object_yaw: false      # true면 object_pose yaw로 joint5 회전
      wrist_roll_default: 0.0
      gripper_roll_default: 0.0  # gripper.mode action · none 일 때만 6 번째 값

    # 이름 자세 이동 · 켜질 때 정리 안전 검사 (2026-11-14 실물: 칸 안 자세에서 pose DRIVE → 오른쪽 프로파일 충돌).
    #   둘 다 관절 공간 직선 이동이라 주변을 모름 → 뒤 · 옆 (|관절 1| > front_j1_max) 에서는 알려진 자세 (poses.* · 팔레트
    #   이동 자세 · 칸 앞 자세) 에서 start_tolerance [rad] 안일 때만 움직임. STOW 에서는 이름 자세 대신 켜질 때 정리로만. 켜질 때 정리는 STOW 또는 정리 자세 근처에서만. blocked = 이름 자세로 직접 안 보냄
    pose:
      start_tolerance: 0.2
      front_j1_max: 0.6        # rad. 관절 1 이 이 안 (앞쪽, 상자 보기 · 집기 뒤) 이면 이름 자세 이동 허용, 밖 (뒤 팔레트 · 옆) 이면 알려진 자세 근처만
      blocked: [STOW, READY]   # STOW 는 정리의 역순 (opencr_arm_tool) 으로만, READY 는 11-08 상단 카메라 충돌
    # 이름 자세 [joint1~5, 6 번째] (rad). gripper.mode=arm_joint 면 6 번째는 쓰지 않고 지금 그리퍼 명령을 유지
    poses:
      names: [STOW, DRIVE, ALIGN, READY, PLACE, TAG_VIEW, BOX_VIEW, TRANSIT_TILT]
      # STOW = 실물 대기 자세 (#166 · #144): J1 +90° 쪽, 차체 오른쪽 위에 접힘. 값 = opencr.ros2_control.xacro
      #   arm_standby_min_tick · max_tick 의 가운데 = (tick − 2048) × 2π/4096 (관절 1 ~ 5, 그리퍼는 아무 값이나 허용 · 0.923 = 닫힘). 전원을 끄기 전 이 자세로 접어 둠 (켤 때 범위 밖이면 하드웨어가 거부)
      STOW: [1.554, -2.088, 1.549, -1.868, 0.043, 0.923]
      # 주행 자세 (#114 → #144 → #219): 주행 중 팔. 2026-11-13 = ALIGN E2 + 집게 닫음. 이전 [-0.0245, -1.6122, 1.2901, 1.1888] 은
      #   관절 3 모터가 팔레트 v5 퍽과 겹침 (계산 2_1 −9 · 1_1 −1 mm, 실물 1열 퍽 충돌) → E2 는 퍽 15 mm · 차체 23 mm (관절 2 영점 −5° 틀어지면 8 mm, #266 다시 맞출 것)
      DRIVE: [0.0, -1.37, -0.01, 1.85, 0.0, 0.923]
      # 정밀 정렬 (approach FINE) 자세 (#188 · #218): FINE 시작 · 끝에서 팔 카메라에 퍽 2 개 (계산 · Isaac). 관절 1 · 5 = 0 (FINE 정렬 흐름 없음).
      #   잡는 점 base_link (0.149, 0, 0.285). 관절 4 한계 여유 0.133 rad ★ 실물 확인 전 (관절 영점 보정 뒤)
      ALIGN: [0.0, -1.37, -0.01, 1.85, 0.0, 0.0]   # 2026-11-12 #218 E2 (차체 23 mm · 실은 퍽 17.8 mm · 시야 82 px, 회전 반지름 2 ~ 4 mm 넘음). 이전 ALIGN_A [0, -1.854, 0.540, 1.645, 0] 은 차체 · G 줄 퍽에 닿음
      # READY = 10 월 추정값. 집게가 위로 +86° · 팔 카메라가 수평 위 71° (하늘) 를 보고 상단 카메라에 닿음 (11-08 실물) → mission 은 안 씀 (#188)
      READY: [0.0, 0.6, -1.2, -0.9, 0.0, 0.0]
      PLACE: [1.57, 0.4, -0.8, -1.1, 0.0, 0.0]
      TAG_VIEW: [0.0, 0.9, -1.4, 0.2, 0.0, 0.0]   # TODO 현장에서 태그가 보이도록 조정
      # 상자 윗면 내려다보기 (#74, B URDF: 카메라가 윗면 약 0.20 m 위에서 0.5° 기울기). joint4 1.95 는 한계 2.0 가까이 ★ 실물 확인
      BOX_VIEW: [0.0, -0.65, 0.0, 1.95, 0.0, 0.0]
      #   ↑ 범퍼 → 면 0.02 m 가정. FINE 0.127 m 자리에서는 장소 중심보다 0.12 m 앞을 봄 → mission verify 는 box_look (#65)
      # 팔레트 궤적 이동 자세 (pallet_place_traj.json transit q_front_tilt, 집게 45°). place 뒤 이 자세로 돌아옴
      #   2026-11-14 높이 이동 판 (pallet_traj_direct.py): 쥔 퍽 바닥 0.230 m (모든 칸 퍽 위 + 38 mm) · J1 축 0.10 m. 예전 [0.0, -1.32032, 0.67766, 1.42805, 0.0, 0.0] (퍽 바닥 0.156 = 1 열 퍽 윗면 아래)
      TRANSIT_TILT: [0.0, -0.89796, -0.10821, 1.79157, 0.0, 0.0]

    # 켜질 때 정리 자세 (include/control/startup_stow.hpp, #144). 켤 때는 늘 대기 자세 (STOW) 에서 시작하므로 (#166) 한 번 주행 자세로 편다.
    #   arm_controller 준비 · 팔 HOLD 해제 (리셋 버튼 = REARM, /diagnostics opencr/motors arm_hold 0) 뒤에 시작.
    #   HOLD 중에 보낸 명령은 펌웨어가 무시하다가 REARM 순간 그 자리로 한 번에 튀므로 HOLD 가 풀리기 전에는 보내지 않는다.
    #   그 전에 pose · pick · skill goal 을 받으면 하지 않음. 정리 중에 오는 goal 은 거절 (mission 은 재시도)
    #   ★ 충돌로 관절이 반 바퀴 돌아간 경우는 자동으로 풀지 않음 (회전 방향을 몰라 케이블이 감길 수 있음) — 손으로 되돌림
    startup:
      pose: DRIVE                # poses.names 중 하나. 빈 문자열 = 끔
      stages: ["3", "2", "4", "1", "5,6"]   # 관절 번호 묶음 순서 (6 = 그리퍼). 대기 → 주행 = J3 → J2 → J4 → J1 (2026-11-13 새 DRIVE, 계산 퍽 15 · 차체 23 mm ★ 실물 0.1 rad/s 로 첫 확인).
                                          #   이전 J3 → J2 → J1 → J4 (#165 실물 확인) 는 새 DRIVE 에서 J4 단계 집게가 위 카메라 기둥 상자와 −20 mm (계산)
      max_joint_velocity: 0.3    # rad/s, 평균 (#165 0.1 → 2026-11-13 opencr_arm_tool 0.2 추종 오차 0.028 rad · 전류 0.44 A 이하 → 0.3 ★ 실물 확인)
      # 정리를 마치기 전 (REARM 전 · 이동 중) pose · pick · execute_skill goal 을 거절 → 모든 명령이 정리 자세 (DRIVE) 에서 시작.
      #   2026-11-14 실물: 죽은 브링업에 걸어 둔 명령이 노드가 뜨자마자 들어와 정리가 취소됨 → 엉뚱한 자세에서 팔레트 궤적 시작
      block_goals: true
      skip_tolerance: 0.05       # rad, 묶음 관절이 모두 이 안이면 그 묶음은 건너뜀
      diag_wait: 5.0             # s, opencr 진단이 이 동안 한 번도 안 오면 (시뮬레이션 · mock) HOLD 확인 없이 진행
      warn_after: 15.0           # s, 이만큼 기다려도 arm_controller · /joint_states 가 없으면 경고 (관절 한계 밖 · OpenCR 활성화 실패)

    # 그리퍼: 실물은 6 번째 칸 gripper_roll 이 개폐 모터 (ID 15) → arm_joint (arm_controller 궤적의 6 번째 값)
    gripper:
      mode: arm_joint            # arm_joint | action (gripper_controller) | none (팔만 시험, 파지 확인 없음)
      open_position: -0.764      # rad, 1550 tick (arm_joint). action 모드면 컨트롤러 단위
      close_position: 0.923      # rad, 2650 tick. 막히면 펌웨어 GripGuard 가 막힌 자리 + 33 tick 으로 쥠
      move_time: 1.0             # s, 끝에서 끝 0.9 s (벤치 실측)
      settle_time: 0.4           # s, 닫은 뒤 위치로 판정할 때까지 (GripGuard 막힘 판정 0.3 s)
      grasp_margin: 0.15         # rad, 닫힘 명령보다 이만큼 넘게 덜 닫혔으면 잡음 (퍽 30 mm 에서 약 0.51 rad 에서 막힘) = 쥠 범위 상한
      # 쥠 범위 하한 (#201, include/control/grasp_detector.hpp): 이보다 덜 닫힌 채 멈춤 = 퍽보다 큰 물체에 막힘 · 안 닫힘 → 쥠 아님.
      #   11-11 실측 (#190 캘리퍼스, 각 1 회): 직육면체 쥠 0.471 · 원기둥 쥠 0.571 · 팔레트 칸에서 쥠 0.542 ~ 0.548 rad, 빈손 닫힘 0.922
      #   → 쥠 범위 [0.30, 0.773] 가운데. 0.30 rad ≈ 폭 41 mm (폭 ≈ 66.68 − 25.4 × (rad + 0.764) mm) 까지 받음
      #   ★ 각 10 회 반복 (#201) 로 하한 · 상한을 다시 볼 것
      grasp_min_position: 0.30
      # 쥠 범위 상한 = min(닫힘 − grasp_margin, 마지막 집게 명령 − 이 값). 정책 집기는 끝까지 안 닫고 손가락 −0.0075 m
      #   (toppick_rl.closed_m, 약 0.64 rad) 로 명령해서 빈손이어도 그 자리에서 멈춤 → 명령보다 이만큼 넘게 덜 닫혀야 (막혀야) 쥠.
      #   고정 동작 (닫기 0.923) 은 상한 0.773 그대로. 정책 닫기면 상한 약 0.61 — 원기둥 쥠 0.571 과 여유 0.04 ★ 실측 (#201)
      grasp_cmd_margin: 0.03
      # 연속 쥠 신호 /manipulator/grasped (std_msgs/Bool, 정책 · 진단): 같은 범위 안이 on_time 이어지면 1, 밖이 off_time 이어지면 0
      #   (모의 정책 판정 30 Hz 켜짐 8 · 꺼짐 3 스텝과 같은 시간, #201)
      grasp_on_time: 0.26        # s (30 Hz 에서 8 스텝 = 0.267 s 째 켜짐)
      grasp_off_time: 0.10       # s (30 Hz 에서 3 스텝째 꺼짐)
      grasp_rate: 30.0           # Hz
      fail_on_empty: true        # 끝까지 닫힘 = 빈손 → pick · pallet_unload 실패
      joint_name: gripper_joint  # action 모드
      max_effort: 0.0            # action 모드, 0 = 지정 안 함

    stale_timeout: 0.3           # 300ms 규칙 (계약): 촬영 시각 기준 이보다 오래된 인식 결과 · 거리는 버림 (예외 없음)

    # 강화학습 정책 (robot_policy, ONNX Runtime CPU). 노드 시작 시 로드, 실패하면 execute_skill 거절 → mission fallback
    # 관측 배치 · fill · rate_hz · obs_dim은 policies.yaml (학습 담당 제공)
    skill:
      enabled: false             # 모델 · ONNX Runtime 준비되면 true
      policies: [toppick_tilt]   # 이 노드가 로드할 policies.yaml 이름 (모델 파일이 있는 것만 — 하나라도 못 열면 전부 로드 안 됨). 예전 pick_cup_v1 은 모델 없음
      policies_file: ""          # 빈 문자열 = <robot_policy share>/config/policies.yaml (bringup이 같은 파일을 넘김)
      horizon: 1.5               # 스트리밍 1점 궤적 time_from_start = horizon / rate_hz (떨리면 조정)
      #   2026-11-12 Isaac: 명령 -> 팔 지연 0 ~ 66 ms 면 집기 정책 원기둥 75.7 % · 직육면체 86.3 %, 0 ~ 33 ms 면 91.4 · 93.1 % (k9).
      #   1.0 (= 33 ms) 으로 줄이는 시험 권장 — 팔 떨림 확인 뒤 바꿈
      max_joint_velocity: 0.5    # rad/s, 정책 목표 한 tick 변화량 ≤ 이 값 / rate_hz ★ 학습 환경 관절 속도 한계와 맞출 것
      # 2026-11-11 미션 skill toppick_tilt 를 이 정책으로 (빈 값 = toppick_tilt 이름 그대로). k7 쓰려면: enabled true,
      #   policies 에 sidepick45_k7 추가, toppick_tilt_policy: sidepick45_k7 (정책이 로드 안 되면 고정 동작 집기로 돎)
      toppick_tilt_policy: ""

    arm_base_frame: arm_base_link
    fixed_frame: odom            # 측정 시각 → 현재 변환 기준
    range_frame: tool_link       # /arm_range 기준 (perception arm.range.frame 과 같게, x = 팔 접근 방향)
    tf_cache_time: 10.0          # s (측정값은 300ms 안의 것만 쓴다)

    pick:
      # 목표 우선순위: ① 정밀 정렬 결과 → ② perception object_pose (300ms 안, object_found)
      offset_tolerance: 0.01     # ① 조건 |arm_offset| <= 이 값. TODO arm_offset 단위 확정 후 (Perception 협의)
      object_radius: 0.015       # ① /arm_range 측정 지점(퍽 표면) → 파지점(중심). 퍽 30 mm 의 반 (perception puck.half_width)
      approach_distance: 0.15    # 파지점 앞 접근 위치 거리 (m)
      # /arm_range = perception 이 D435 · Arducam 측위로 낸 "끝단(tool_link) → 정렬 중인 퍽 표면" 거리 (TFmini 아님 — TFmini 는 박스 거리, drive 전용)
      # 파지점 거리 = /arm_range + range_offset (끝단 기준이라 = 퍽 반지름)
      # 보정 목표 측정값 = approach_distance - range_offset = 0.135
      range_offset: 0.015
      range_mismatch_tolerance: 0.04  # 측정 기반 거리와 계획 거리 차이가 이보다 크면 /arm_range 무시 (이웃 퍽 간격 40 mm) (m)
      max_final_approach: 0.25   # 최종 전진 거리 상한 (m), 넘으면 abort
      lift_height: 0.05
      grasp_z_offset: 0.015      # 집게 끝(tool_link) = 퍽 중심 + 위로 이만큼 (팔레트 궤적 grasp_dz 와 같게)
      cartesian_step: 0.01       # 최종 접근 · 들어올리기 직선 경로 경유점 간격 (m)
      cartesian_speed: 0.05      # 직선 경로 끝단 속도 (m/s)
      max_waypoint_joint_step: 0.2  # 경유점 사이 관절 변화 상한 (rad), 넘으면 abort (특이점)

    # 미세 보정 (arm_offset · /arm_range)
    correction:
      enabled: true
      required: true             # true: 보정 실패(arm_offset 없음 · 반복 초과) 시 abort / false: 경고 후 진행
      max_iterations: 5
      offset_gain: 1.0           # TODO arm_offset 단위 확정 후 (m / 단위). 음수 = 보정 방향 반전, 0 = 좌우 보정 끔
      lateral_tolerance: 0.005   # m
      range_tolerance: 0.01      # m
      max_step: 0.02             # 한 번에 이동하는 최대 거리 (m)
      min_duration: 0.3          # s
      settle_time: 0.2           # 이동 후 이 시간 지난 데이터만 사용 (s)
      wait_timeout: 1.0          # 이 시간 안에 arm_offset 없으면 보정 실패 (s, required에 따라 abort/진행)

    # 주사위 미션 skill (/manipulator/execute_skill 이름, #63 #74). 같은 이름 정책이 로드돼 있으면 정책을 쓴다
    toppick:
      pitch: -0.7854             # toppick_tilt 집게 기울기 (45° 아래). pick 과 같은 과정
      approach_distance: 0.06    # 접근 위치 = 파지점에서 집게 축 반대로 (m)
      # ① 정밀 정렬 결과 (/arm_range) · 미세 보정을 toppick 에서도 쓸지. 45° 는 집게 축이 퍽을 보지 않고 접근 위치에서
      # 퍽이 팔 카메라 화면 밖이라 (#82) false → 목표 = 직전 target_look 이 잰 위치 (없으면 perception 추적 위치) 그대로 집음
      use_alignment: false
      latch_max_age: 30.0        # s, target_look 이 잰 위치를 toppick_tilt 가 쓸 수 있는 시간
      # 접근 경로 (2026-11-09 Isaac chain_pallet_eval 고정 동작 집기로 검증, urdf_and_usd/policy/manipulator/정책_학습기록.md 4.15 절):
      #   top  = 잡는 점에서 위로 approach_height · J1 쪽으로 approach_inward 인 자리 (벌림) -> 잡는 점까지 직선 (집게 45° 유지)
      #          실제 배치 A·B·C 이어서 84/88 (측정 오차 0) · 69/88 (σ 2 mm)
      #   axis = 집게 축 반대로 approach_distance (이전, pick 과 같음). 같은 시험에서 48/88 (운반 중 미끄럼 많음)
      approach_mode: top
      approach_height: 0.05      # m
      approach_inward: 0.03      # m
      radial_offset: 0.002       # m, 잡는 점을 J1 에서 먼 쪽으로 -> 퍽이 손 안 반경 −2 mm 에 (칸 넣기 −4 ~ 0 mm 만 받음)
      # 쥔 뒤 들기 (2026-11-14, pick.lift_height 대신 top 경로만). 예전 0.05 m 는 옆 퍽 (60 mm) 보다 낮아 다음 pallet_load 의
      #   관절 직선 이동 (든 자세 -> 궤적 첫 점) 중 쥔 퍽이 상자 위 옆 퍽을 침 (FK: 옆 퍽 윗면 −2.4 mm).
      #   0.085 + 높이 이동 궤적이면 옆 퍽 위 최소 +36 mm (옆 퍽 45 ~ 80 mm, 바깥 · 옆 방향 전부)
      lift_height: 0.085         # m
      lift_max_radius: 0.32      # m, J1 축에서 이보다 먼 퍽은 45° 로 0.085 곧장 못 듦 -> 들며 J1 쪽으로 (거리 − 이 값) 당김
    # 강화학습 집기 (skill.policies 에 toppick_tilt 를 넣고 skill.enabled true 면 같은 이름의 고정 IK 동작 대신 정책).
    #   policies.yaml toppick_tilt (tcp_delta(4), 관측 36 = include/control/toppick_obs.hpp), IK = arm_diff_ik.hpp. 값은 Isaac toppick_env_cfg 와 같게
    toppick_rl:
      base_frame: base_link      # 학습 관측 좌표 (arm_diff_ik 기구 = Isaac URDF base_link)
      # 2026-11-12 실측 (#190 · #201): 열림 66.7 mm, 쥔 퍽 0.47 ~ 0.57 rad, 빈손 닫힘 0.922 rad (23.8 mm). Onbeom 제안 (#201) 대응:
      #   쥔 퍽 -> −5.1 ~ −6.6 mm (학습 30 mm 퍽 −5.8 과 비슷, 쥠 범위 안), 빈손 닫힘 -> −11.6 mm (범위 밖 = 빈손 실패)
      finger_m_at_open: 0.0125
      finger_m_at_close: -0.0116
      open_m: 0.010              # 행동 > 0 → 손가락 0.010 m (61.6 mm) 에 해당하는 rad
      closed_m: -0.0075          # 행동 ≤ 0 → 손가락 −0.0075 m
      grasp_finger_min: -0.010   # 쥔 손가락 범위 (m)
      grasp_finger_max: -0.003
      grasp_dz: 0.015            # 잡는 점 = 퍽 중심 + 이 높이
      success_lift: 0.03         # 성공: 잡는 점이 처음 잡는 높이보다 이만큼 위 + 쥔 범위로
      success_hold: 1.0          #   이 시간 (s)
      neighbor_distance: 0.12    # 목표에서 이 안의 다른 퍽 = 옆 퍽 (같은 상자)
      target_match: 0.03         # 목표와 같은 퍽으로 볼 거리 (모양)
      default_is_box: false      # 모양을 모를 때
      max_joint_velocity: 2.0    # rad/s, 안전 상한 (학습은 앞섬 ±0.25 rad 만 제한)
      # 정책 전에 옮길 학습 시작 자세 (Isaac toppick_env_cfg READY_TILT, 모델 관절값 joint1~5) + 그리퍼 벌림 (open_m). [] = 옮기지 않음
      #   학습은 매 에피소드를 이 자세 (± 0.12 rad 잡음) 에서 시작 → target_look 자세에서 바로 돌리면 학습에 없던 상태 (#69)
      start_pose: [0.0, -0.462, 0.771, 0.476, 0.0]
      max_duration: 12.0         # s, 정책을 돌리는 시간 상한 (학습 에피소드 6 s). 넘으면 실패 → mission 이 target_look 부터 다시
    # 2026-11-11 세운 퍽 45° 집기 k7 (policies.yaml sidepick45_k7, 관측 33, Isaac Waffle-SidePick45Chain-Direct) 정책별 값.
    #   나머지 (IK · 성공 판정 · 손가락 대응) 는 toppick_rl.* 그대로 (같은 diff IK · 같은 값으로 학습)
    sidepick45_k7:
      obs_ref_pose: [0.0, -0.338, 0.559, 0.564, 0.0]   # joint_pos_rel 기준 = READY_POSE_45 (sidepick_env_cfg)
      neighbor_absent: [0.0, 0.0]                      # 옆 퍽 없음 관측 (toppick 은 (0, 0.5))
      start_pose: [0.0, -0.338, 0.559, 0.564, 0.0]     # 학습 에피소드 시작 = READY_POSE_45 (± ready_noise 0.08 rad)
      closed_m: -0.011                                  # 행동 ≤ 0 쥠 (학습 gripper_closed = FINGER_CLOSE). Isaac 넣기 평가 −0.0075 와 차이 작음
      # 관절 명령 한 틱 변화 상한 (rad/s). Isaac 노드 조건 2048 대 (11-12, 기록/10): 2.0 -> 원기둥 92.9 · 직육면체 90.4 %,
      #   3.0 -> 96.5 · 95.6, 4.0 -> 96.6 · 96.1, 없음 96.8 · 96.5 (학습은 목표 앞섬 ±0.25 rad 만). ★ 실물 관절 최대 속도 (#201) 확인 뒤
      max_joint_velocity: 4.0
    sidepick45_k8:   # 2026-11-12 k8 (k7 과 같은 값). 쓰려면 skill.policies 에 sidepick45_k8, toppick_tilt_policy: sidepick45_k8
      obs_ref_pose: [0.0, -0.338, 0.559, 0.564, 0.0]   # joint_pos_rel 기준 = READY_POSE_45 (sidepick_env_cfg)
      neighbor_absent: [0.0, 0.0]                      # 옆 퍽 없음 관측 (toppick 은 (0, 0.5))
      start_pose: [0.0, -0.338, 0.559, 0.564, 0.0]     # 학습 에피소드 시작 = READY_POSE_45 (± ready_noise 0.08 rad)
      closed_m: -0.011                                  # 행동 ≤ 0 쥠 (학습 gripper_closed = FINGER_CLOSE). Isaac 넣기 평가 −0.0075 와 차이 작음
      # 관절 명령 한 틱 변화 상한 (rad/s). Isaac 노드 조건 2048 대 (11-12, 기록/10): 2.0 -> 원기둥 92.9 · 직육면체 90.4 %,
      #   3.0 -> 96.5 · 95.6, 4.0 -> 96.6 · 96.1, 없음 96.8 · 96.5 (학습은 목표 앞섬 ±0.25 rad 만). ★ 실물 관절 최대 속도 (#201) 확인 뒤
      max_joint_velocity: 4.0
    sidepick45_k9:   # 2026-11-12 k9 (k8 과 같은 값, 실측 지연 학습). 쓰려면 skill.policies 에 sidepick45_k9, toppick_tilt_policy: sidepick45_k9
      obs_ref_pose: [0.0, -0.338, 0.559, 0.564, 0.0]   # joint_pos_rel 기준 = READY_POSE_45 (sidepick_env_cfg)
      neighbor_absent: [0.0, 0.0]                      # 옆 퍽 없음 관측 (toppick 은 (0, 0.5))
      start_pose: [0.0, -0.338, 0.559, 0.564, 0.0]     # 학습 에피소드 시작 = READY_POSE_45 (± ready_noise 0.08 rad)
      closed_m: -0.011                                  # 행동 ≤ 0 쥠 (학습 gripper_closed = FINGER_CLOSE). Isaac 넣기 평가 −0.0075 와 차이 작음
      # 관절 명령 한 틱 변화 상한 (rad/s). Isaac 노드 조건 2048 대 (11-12, 기록/10): 2.0 -> 원기둥 92.9 · 직육면체 90.4 %,
      #   3.0 -> 96.5 · 95.6, 4.0 -> 96.6 · 96.1, 없음 96.8 · 96.5 (학습은 목표 앞섬 ±0.25 rad 만). ★ 실물 관절 최대 속도 (#201) 확인 뒤
      max_joint_velocity: 4.0
    # target_look:<frame>:<x>:<y>:<z> 타겟체크자세 (#82, include/control/target_look_pose.hpp). 집기 전 팔 카메라로 퍽 윗면을 내려다봄
    #   카메라를 퍽 윗면에서 distances 만큼, 광축이 수평 아래 view_angles_deg 로 — 관절 한계 안에서 풀리는 첫 (거리, 각)
    #   인지 #82 타겟체크자세 4 개 (A · B · C앞 · C뒤) 는 모두 약 70° · 0.15~0.21 m (test_target_look_pose 가 같은 카메라 모형인지 확인)
    target_look:
      camera_x: 0.128256         # joint4 축 → 팔 카메라, 집게 축 방향 (robot.urdf.xacro arm_camera_link 0.088256 + link5 0.04)
      camera_z: 0.077446         # 집게 축에 수직 위
      camera_tilt: 0.261788      # 광축이 집게 축보다 아래로 (15°)
      view_angles_deg: [70.0, 72.0, 68.0, 75.0, 65.0, 78.0, 80.0, 62.0, 85.0, 60.0]   # 선호 순서
      distances: [0.17, 0.16, 0.18, 0.15, 0.19, 0.20, 0.21, 0.22]                     # m, 선호 순서 (먼저 바뀜)
      min_clearance: 0.04        # 집게 끝이 퍽 윗면보다 이만큼 위 (m)
      settle_time: 0.3           # s, 자세에 선 뒤 이보다 나중에 촬영된 /perception/pucks 만
      arm_wait: 1.0              # s, 이 동안은 팔 카메라 (태그) 퍽만, 지나면 D435 퍽도
      timeout: 3.0               # s, 예상 자리 퍽이 없으면 실패 (mission 재시도)
      match_distance: 0.04       # m, 예상 중심과 수평 거리. 이웃 퍽 (회전 뒤 0.08 m) 의 절반
    # box_look:<frame>:<x>:<y>:<z> (#65, mission verify): 장소 칸 중심 · 상자 윗면을 위에서 내려다봄. 카메라 장착 = target_look.*
    #   FINE 정렬 (범퍼 → 면 0.127 m) 뒤 장소 중심은 J1 0.267 m → 90° · 0.20 m 자세가 한계 안 (BOX_VIEW 고정 자세는 J1 0.149 m 를 봄)
    box_look:
      view_angles_deg: [90.0, 85.0, 80.0, 75.0, 70.0]   # 선호 순서 (90 = 바로 아래)
      distances: [0.20, 0.22, 0.18, 0.24, 0.26]         # m, 카메라 → 윗면 (인지 모의 약 0.20 m)
      min_clearance: 0.04        # 집게 끝이 윗면보다 이만큼 위
    # barcode_look:<frame>:<x>:<y>:<z> (#65, mission observe): 벽 바코드 라벨 중심을 거의 수평으로 봄.
    #   출발 자세에서 라벨은 J1 0.60 m · 높이 +0.33 m → 카메라 약 0.3 m 가 가장 가까움 (인지: 0.3 m 에서 읽음)
    barcode_look:
      view_angles_deg: [0.0, 5.0, -5.0, 10.0, -10.0, 15.0, -15.0]   # 선호 순서 (0 = 수평, − = 위로)
      distances: [0.25, 0.28, 0.30, 0.32, 0.35, 0.40]               # m, 가까운 것부터
      min_clearance: -1.0        # 높이 제한 없음 (라벨은 벽에 붙어 있어 집게 끝이 라벨보다 낮아도 됨)
    pallet:
      traj_file: ""              # 빈 문자열 = <control share>/config/pallet_place_traj.json (urdf_and_usd/policy/manipulator 사본)
      speed: 0.8                 # rad/s, 경유점 사이 관절 속도 (#75). 2026-11-11 Isaac 노드 방식 넣기 (궤적 place 구간 + 처짐 보정) 2048 대: 0.8 원기둥 97.8 % · 직육면체 97.2 %, 0.4 도 같음 -> 0.8 유지
      row3_hold_speed: 0.4       # rad/s, 3 열에 놓을 때 쥔 구간 (#75)
      require_held: true         # pallet_load 전에 그리퍼가 퍽을 쥐고 있는지 확인
      release_position: 0.0798   # rad = 2100 tick, 실측 36.4 mm (Isaac FINGER_RELEASED 37.6). 칸 안에서 놓을 때 · 꺼내러 들어갈 때 이만큼만 벌림 (끝까지 열면 칸 벽에 닿음, #75)
      place_dwell: 0.3           # s, 놓는 자세에서 벌리기 · 쥐기 전 머묾 (Isaac 0.3)
      # 2026-11-14 실물: ik.joint_offsets (J2 −27°, v3 칸으로 맞춘 실효값) 를 v5 궤적에 더하면 이동 자세에서 관절 3 (팔꿈치) 이
      #   60 mm 내려가 2 열 퍽 윗면 높이 → DRIVE 에서 첫 구간에 퍽 스토리지를 누름. v5 칸으로 다시 맞추기 (#266) 전까지 false
      apply_joint_offsets: false
      # 출발 자세 검사: 궤적 첫 점에서 start_tolerance [rad] 안이면 바로, start_poses 근처 (start_pose_tolerance) 면 첫 점까지
      #   prep_velocity [rad/s] 로 먼저 옮김 (DRIVE → 이동 자세, 팔꿈치 퍽 위 여유 계산 47 mm 이상), 아니면 거절 (꺼내기).
      #   놓기 (pallet_load) 는 집기 직후 (퍽 쥠) 면 예전처럼 바로
      start_tolerance: 0.05
      start_poses: [DRIVE, ALIGN, TRANSIT_TILT]
      start_pose_tolerance: 0.15
      prep_velocity: 0.3
      # 꺼내기 빈손이면 칸 안에 멈추지 않고 이동 자세까지 빠져나온 뒤 실패 (2026-11-14 실물: 칸 안에 머문 채 끝남)
      retreat_on_fail: true
    # 팔 처짐 보정 (include/control/sag_comp.hpp): 팔레트 칸 궤적을 50 Hz 로 계획 + bias 스트리밍 (/arm_controller/joint_trajectory),
    #   bias += ki · dt · (계획 − 측정). Isaac pallet_place_check.py --ki 4 와 같은 식 (보정 없이 4/24 → 24/24).
    #   펌웨어 P 800 · I 0 이라 퍽을 쥔 팔이 6 ~ 13 mm 처지고 칸 틈은 1 ~ 2 mm. gripper.mode action 이면 쓰지 않음
    sag:
      enabled: true              # ★ 실물 벤치에서 스트리밍 추종 확인. 문제가 있으면 false (= 경유점 궤적 한 번에, 보정 없음)
      ki: 4.0                    # 1/s
      bias_max: 0.15             # rad
      settle_time: 1.5           # s, 시작 자세에서 bias 를 먼저 맞춤 (칸마다 이만큼 늘어남)
      rate_hz: 50.0
      horizon: 0.06              # s, 스트리밍 한 점의 time_from_start
      max_error: 0.3             # rad, 측정이 계획에서 이보다 벗어나면 중지 (칸에 걸림)
    place:
      cells_file: ""             # 빈 문자열 = <mission_planner share>/config/approach_poses.yaml (L1~L3 cells, 지도 좌표)
      cells_frame: map           # 칸 좌표 frame (발제 원점 지도)
      pitch: -0.7854             # 놓기 집게 기울기 (45°)
      surface_height: 0.070      # 장소 상자 윗면 (바닥 기준, 발제 Z 70 mm). place_at 은 받은 z 를 씀
      puck_half_height: 0.030
      clearance: 0.002           # 놓을 때 퍽 바닥과 윗면 틈 (m)
      approach_distance: 0.04    # 놓기 전 집게 축 반대로 (m)
      retreat_distance: 0.04     # 놓은 뒤 빠지기 (m)
      # 2026-11-11 Isaac 주사위 연속 놓기 2048 대 (IsaacLab .../manipulator/dice_place_check.py): 판 전체 33.6 % -> 90.0 %
      release_position: 0.0798   # rad, 놓을 때 벌림 = pallet.release_position (36.4 mm). 끝까지 (−0.764, 81.6 mm) 면 먼저 놓은 옆 퍽을 밂 (칸 간격 60 mm)
      # 2026-11-11 꺼내기 -> 놓기 연결 (dice_place_check.py --unload): 놓기도 처짐 보정 스트리밍 (sag) 하면 판 전체 2.8 % -> 93.1 % (216 대) · 95.8 % (2048 대).
      #   이전 바깥 보정 7.7 · −2.7 mm 는 처짐 보정 없는 놓기용 (꺼내기 없이 맞춘 값, 연결에서는 틀림) -> sag 켜면 0
      sag: true                  # 놓기 (place_*) 도 처짐 보정 스트리밍 (sag.enabled 일 때), 꺼내기 끝 bias 이어 씀
      radial_offset_mm: 0.0      # ★ J1 바깥 보정 (가운데 칸 J1 0.2665 m 기준, 실측 뒤 고침)
      radial_offset_slope_mm: 0.0   # ★ 칸 (60 mm) 멀어질 때마다
      lateral_offset_mm: 1.8     # ★ 2026-11-12 놓는 점을 로봇 왼쪽으로 (Isaac 칸별 평균 오차 −1.8 mm). 실측 (place_measure.py) 뒤 고침
    floor_frame: base_footprint  # 바닥 frame. arm_base_link 높이 = 이 frame → arm_base_link TF
    arm_base_height: 0.120       # TF 가 없을 때 arm_base_link 바닥 높이 (B안 base_link 0.00675 + 0.1135) ★
