developlcy-oss/Lv2_Cartlidar_Assignment/workspace/ros2_ws/src/robot_policy/config/policies.yaml

# policies.yaml (학습 담당이 ONNX 와 함께 제공) — CPU 추론 (ONNX Runtime)
# 벡터 배치: observation 순서대로, required 항목 = [값...], 선택 항목 = [값..., valid] (valid 1 = 유효, 0 = fill 사용)
# fill = 학습(시뮬레이션)에서 안 보일 때 넣은 값과 같게. obs_dim 이 ONNX 입력 차원과 다르면 로드 실패
# 선택: offset · scale (정규화 (x - offset) * scale), action_low · action_high (clamp)
pick_cup_v1:
  model: models/pick_cup_v1.onnx
  rate_hz: 20
  obs_dim: 12                    # joint_pos 6 + arm_offset (3 + valid 1) + arm_range (1 + valid 1)
  observation:
    - {name: joint_pos, size: 6, required: true}
    - {name: arm_offset, size: 3, required: false, fill: [0.0, 0.0, 0.0]}
    - {name: arm_range, size: 1, required: false, fill: [12.0]}   # 안 보임 = 최대 거리 (0 은 "아주 가까움"이라 금지)
  action: joint_target(6)        # rad, 관절 한계로 clamp

slalom_v1:
  model: models/slalom_v1.onnx
  rate_hz: 20
  obs_dim: 367                   # scan 360 + odom_twist 3 + object_pose_base (3 + valid 1)
  observation:
    - {name: scan, size: 360, required: true}
    - {name: odom_twist, size: 3, required: true}
    - {name: object_pose_base, size: 3, required: false, fill: [0.0, 0.0, 0.0]}
  action: base_twist(2)          # vx (m/s), wz (rad/s)
  finish_on_timeout: true        # 단계의 timeout(초) 동안 주행하면 성공
  action_low: [-0.3, -1.5]
  action_high: [0.3, 1.5]

# 박스 위 퍽을 집게 45° 로 집기 (Isaac Waffle-TopPick-Direct, 등록 = urdf_and_usd/policy/manipulator/policies/registry.json).
#   학습 toppick_env.py _get_observations 와 같은 순서 · 단위 · 좌표 (base_link, m, rad). 모두 필수 (valid 칸 없음 → obs_dim 36 그대로)
#   행동 tcp_delta(4): 앞 3 = 잡는 점 변위 [-1, 1] x 0.005 m → control/arm_diff_ik (감쇠 최소제곱 IK, 자세 = 45° · 닫는 축 J1 접선),
#   4 번째 > 0 벌림 0.010 · ≤ 0 닫기 −0.0075 (gripper_left_joint 값, manipulator.yaml toppick_rl.finger_m_at_* 로 gripper_roll rad 에 대응).
#   쓰려면 manipulator.yaml skill.policies 에 toppick_tilt 를 넣고 skill.enabled true (bringup skill_enabled:=true, ONNX Runtime 빌드).
#   그러면 같은 이름 skill 이 고정 IK 동작 대신 이 정책 (manipulator_node tcp_delta, 관측 = control/toppick_obs.hpp). 기본은 고정 IK
toppick_tilt:
  model: models/toppick_tilt.onnx
  rate_hz: 30
  obs_dim: 36
  observation:
    - {name: joint_pos_rel, size: 5, required: true}      # joint1~5 − READY_POSE [0, 0.48, −0.76, 1.84, 0] (기울임 모드도 이 기준)
    - {name: joint_vel, size: 5, required: true}          # rad/s
    - {name: finger_pos, size: 1, required: true}         # gripper_left_joint (m, 벌림 mm = 41.6 + 2000 x 값)
    - {name: puck_pos, size: 3, required: true}           # 인식 퍽 중심 (base_link). target_look 이 잰 값 고정 (학습 70 % 고정)
    - {name: grasp_pos, size: 3, required: true}          # 잡는 점 = gripper_roll_link + (0.14, 0, 0) (FK, arm_diff_ik forward)
    - {name: puck_minus_grasp, size: 3, required: true}
    - {name: approach_axis, size: 3, required: true}      # gripper_roll_link +x (base_link)
    - {name: close_axis, size: 3, required: true}         # gripper_roll_link +y
    - {name: neighbor_rel, size: 2, required: true}       # 옆 퍽 − 퍽 (x, y). 옆 퍽 없음 = (0.0, 0.5) (NB_ABSENT)
    - {name: is_box, size: 1, required: true}             # 상자 모양 퍽 1, 원기둥 0
    - {name: roll_cos_sin, size: 2, required: true}       # 닫는 축 − J1 접선 각 (arm_diff_ik rollError) 의 cos · sin
    - {name: prev_action, size: 4, required: true}        # 직전 정책 출력 ([-1, 1] 자른 값, 첫 스텝 (0, 0, 0, 1))
    - {name: tilted, size: 1, required: true}             # 기울임 모드 1 (지금은 늘 1)
  action: tcp_delta(4)
  action_low: [-1.0, -1.0, -1.0, -1.0]
  action_high: [1.0, 1.0, 1.0, 1.0]

# 상자 위 누운 직육면체를 쥐고 들어 손 안에서 세운 뒤 상자 위 세울 자리 D 에 세워 놓고 손을 뺌 (#192 · #193, Isaac Waffle-LieUprightB7-Direct = r2g2,
#   노드 관측으로 학습: 퍽 · 긴 축 · 옆 퍽은 시작 때 잰 값 고정, 상자는 잰 값, 쥠은 손가락만. 노드 관절 속도 비례 축소 3.0 rad/s 와
#   놓음 규칙 (lie_upright.release_*) 도 학습에 들어 있음 → max_joint_velocity 를 3.0 넘게 올리려면 다시 평가,
#   학습 lieupright_env.py · 넘겨받은 묶음 lv2_next_module 261110_2010_lie_rl/handoff). 다시 집기는 이 정책 밖 (미션 toppick_tilt 고정 동작).
#   manipulator_node 는 skill.enabled 와 따로 lie_upright.enabled 로 로드 (미션 skill "lie_upright:<frame>:x:y:yaw_deg", control/lieupright.hpp).
#   관측 = base_link (m, rad), 모두 필수. 행동 tcp_delta(6): 잡는 점 변위 x · y · z × 0.005 m, 집게 숙임 β 변화 × 0.05 rad,
#   집게 롤 ρ 변화 × 0.06 rad, 집게 > 0 벌림 0.010 · ≤ 0 닫음 −0.011 (손가락 m). β · ρ 는 적분 (시작 π/4 · 0), 자세 + 변위 → 감쇠 최소제곱 IK
lie_upright:
  model: models/lieupright_r2g2.onnx
  rate_hz: 30
  obs_dim: 45
  observation:
    - {name: joint_pos_rel, size: 5, required: true}       # joint1~5 − READY_POSE_45 [0, −0.338, 0.559, 0.564, 0]
    - {name: joint_vel, size: 5, required: true}           # rad/s
    - {name: finger_pos, size: 1, required: true}          # gripper_left_joint (m)
    - {name: puck_pos, size: 3, required: true}            # 인식 누운 퍽 중심 (z = 상자 윗면 + 15 mm)
    - {name: long_axis_cos_sin2, size: 2, required: true}  # 긴 축 요 θ 의 cos 2θ · sin 2θ
    - {name: grasp_pos, size: 3, required: true}           # 잡는 점 (FK)
    - {name: approach_axis, size: 3, required: true}       # gripper_roll_link +x
    - {name: close_axis, size: 3, required: true}          # gripper_roll_link +y
    - {name: stand_spot, size: 3, required: true}          # 세울 자리 D (z = 상자 윗면 + 29 mm, 학습과 같게)
    - {name: neighbor_rel, size: 2, required: true}        # 옆 퍽 xy − 인식 퍽 xy (없으면 0, 0)
    - {name: neighbor_present, size: 1, required: true}
    - {name: box_center, size: 2, required: true}          # 상자 중심 xy
    - {name: box_yaw_cos_sin, size: 2, required: true}
    - {name: held, size: 1, required: true}                # 쥠: 손가락 −10.8 ~ −3 mm 연속 8 스텝 1, 연속 3 스텝 아니면 0
    - {name: rho_cos_sin_beta, size: 3, required: true}    # cos ρ, sin ρ, β
    - {name: prev_action, size: 6, required: true}         # 직전 행동 (자른 값, 놓은 뒤 집게 = 1, 첫 스텝 (0, 0, 0, 0, 0, 1))
  action: tcp_delta(6)
  action_low: [-1.0, -1.0, -1.0, -1.0, -1.0, -1.0]
  action_high: [1.0, 1.0, 1.0, 1.0, 1.0, 1.0]

# 세운 퍽 45° 집기 k7 (Isaac Waffle-SidePick45Chain-Direct = 미션 배치 Waffle-SidePick45Mission-Direct 와 같은 관측 · 행동, #199 · #193). 2026-11-11 등록.
#   학습 sidepick_env.py _get_observations 순서 · 단위 · 좌표 (base_link, m, rad). 모두 필수 (obs_dim 33).
#   ★ 노드 관측 조립은 아직 없음 (#193 PR, Onbeom). 조립 전에는 skill.policies 에 넣지 말 것 (toppick_obs 이름이 아니라 로드 거절).
#   행동 tcp_delta(4) = toppick_tilt 와 같은 IK (arm_diff_ik, 기울임 45°, 닫는 축 = J1 접선, cart_scale 0.005, rot_weight 0.3, damping 1e-4, lead 0.25 rad),
#   4 번째 > 0 벌림 0.010 m (61.6 mm) · ≤ 0 닫기 (학습 −0.011. 노드 방식 넣기에서는 −0.011 · −0.0075 차이 거의 없음).
#   시작 자세 (학습 리셋) = READY_POSE_45 [0, −0.338, 0.559, 0.564, 0] ± 0.08 rad, 손가락 벌림 0.010 -> 정책 전에 이 자세로 옮길 것 (toppick_rl.start_pose 처럼).
#   Isaac 미션 배치 (정지 0.1272 · 직육면체 ±17° 회전 접근) 집기 -> 칸 넣기 (노드 pallet_load 와 같은 궤적 재생 · 처짐 보정, 속도 0.8,
#   쥐기 끝까지 −0.011, 인식 ±1 mm) 2048 대: 원기둥 2006 (97.9 %) · 직육면체 1980 (96.7 %), 집기 통과 98 ~ 99 %.
sidepick45_k7:
  model: models/sidepick45_k7.onnx
  rate_hz: 30
  obs_dim: 33
  observation:
    - {name: joint_pos_rel, size: 5, required: true}      # joint1~5 − READY_POSE_45 [0, −0.338, 0.559, 0.564, 0] (lie_upright 와 같은 기준)
    - {name: joint_vel, size: 5, required: true}          # rad/s
    - {name: finger_pos, size: 1, required: true}         # gripper_left_joint (m, 벌림 mm = 41.6 + 2000 x 값)
    - {name: puck_pos, size: 3, required: true}           # 인식 퍽 중심 (base_link). 학습: 참값 + 에피소드 치우침 ±1 mm + 스텝 ±1 mm, 지연 3 ~ 9 스텝 · 갱신 3 ~ 10 스텝 · 끊김 (#191)
    - {name: grasp_pos, size: 3, required: true}          # 잡는 점 = gripper_roll_link + (0.14, 0, 0) (FK)
    - {name: puck_minus_grasp, size: 3, required: true}   # puck_pos − grasp_pos
    - {name: approach_axis, size: 3, required: true}      # gripper_roll_link +x (base_link)
    - {name: close_axis, size: 3, required: true}         # gripper_roll_link +y
    - {name: neighbor_rel, size: 2, required: true}       # 옆 퍽 − 퍽 (x, y). 옆 퍽 없음 = (0, 0) (toppick 의 (0, 0.5) 와 다름)
    - {name: is_box, size: 1, required: true}             # 직육면체 퍽 1, 원기둥 0
    - {name: prev_action, size: 4, required: true}        # 직전 정책 출력 ([-1, 1] 자른 값). 첫 스텝 (0, 0, 0, 1)
  action: tcp_delta(4)
  action_low: [-1.0, -1.0, -1.0, -1.0]
  action_high: [1.0, 1.0, 1.0, 1.0]

# 2026-11-12 k8 = k7 + 인식 오차 ±5 mm 이어 학습 600 반복 (Isaac, 노드 조건 2048 대: ±2 mm 98.4 · 96.6 %, ±5 mm 93.6 · 94.7 %, k7 보다 모두 나음). 관측 · 행동 k7 과 같음
sidepick45_k8:
  model: models/sidepick45_k8.onnx
  rate_hz: 30
  obs_dim: 33
  observation:
    - {name: joint_pos_rel, size: 5, required: true}      # joint1~5 − READY_POSE_45 [0, −0.338, 0.559, 0.564, 0] (lie_upright 와 같은 기준)
    - {name: joint_vel, size: 5, required: true}          # rad/s
    - {name: finger_pos, size: 1, required: true}         # gripper_left_joint (m, 벌림 mm = 41.6 + 2000 x 값)
    - {name: puck_pos, size: 3, required: true}           # 인식 퍽 중심 (base_link). 학습: 참값 + 에피소드 치우침 ±1 mm + 스텝 ±1 mm, 지연 3 ~ 9 스텝 · 갱신 3 ~ 10 스텝 · 끊김 (#191)
    - {name: grasp_pos, size: 3, required: true}          # 잡는 점 = gripper_roll_link + (0.14, 0, 0) (FK)
    - {name: puck_minus_grasp, size: 3, required: true}   # puck_pos − grasp_pos
    - {name: approach_axis, size: 3, required: true}      # gripper_roll_link +x (base_link)
    - {name: close_axis, size: 3, required: true}         # gripper_roll_link +y
    - {name: neighbor_rel, size: 2, required: true}       # 옆 퍽 − 퍽 (x, y). 옆 퍽 없음 = (0, 0) (toppick 의 (0, 0.5) 와 다름)
    - {name: is_box, size: 1, required: true}             # 직육면체 퍽 1, 원기둥 0
    - {name: prev_action, size: 4, required: true}        # 직전 정책 출력 ([-1, 1] 자른 값). 첫 스텝 (0, 0, 0, 1)
  action: tcp_delta(4)
  action_low: [-1.0, -1.0, -1.0, -1.0]
  action_high: [1.0, 1.0, 1.0, 1.0]

# 2026-11-12 k9 = k8 + 실측 지연 0 ~ 66 ms (명령 -> 팔 반응) 넣고 이어 학습. Isaac 노드 조건 (지연 건) 2048 대: 0 ~ 66 ms 원기둥 75.7 · 직육면체 86.3 % (k8 69.5 · 82.5),
#   0 ~ 33 ms 원기둥 91.4 · 직육면체 93.1 %. 관측 · 행동 k8 과 같음 (obs 33, tcp_delta(4), 30 Hz)
sidepick45_k9:
  model: models/sidepick45_k9.onnx
  rate_hz: 30
  obs_dim: 33
  observation:
    - {name: joint_pos_rel, size: 5, required: true}      # joint1~5 − READY_POSE_45 [0, −0.338, 0.559, 0.564, 0] (lie_upright 와 같은 기준)
    - {name: joint_vel, size: 5, required: true}          # rad/s
    - {name: finger_pos, size: 1, required: true}         # gripper_left_joint (m, 벌림 mm = 41.6 + 2000 x 값)
    - {name: puck_pos, size: 3, required: true}           # 인식 퍽 중심 (base_link). 학습: 참값 + 에피소드 치우침 ±1 mm + 스텝 ±1 mm, 지연 3 ~ 9 스텝 · 갱신 3 ~ 10 스텝 · 끊김 (#191)
    - {name: grasp_pos, size: 3, required: true}          # 잡는 점 = gripper_roll_link + (0.14, 0, 0) (FK)
    - {name: puck_minus_grasp, size: 3, required: true}   # puck_pos − grasp_pos
    - {name: approach_axis, size: 3, required: true}      # gripper_roll_link +x (base_link)
    - {name: close_axis, size: 3, required: true}         # gripper_roll_link +y
    - {name: neighbor_rel, size: 2, required: true}       # 옆 퍽 − 퍽 (x, y). 옆 퍽 없음 = (0, 0) (toppick 의 (0, 0.5) 와 다름)
    - {name: is_box, size: 1, required: true}             # 직육면체 퍽 1, 원기둥 0
    - {name: prev_action, size: 4, required: true}        # 직전 정책 출력 ([-1, 1] 자른 값). 첫 스텝 (0, 0, 0, 1)
  action: tcp_delta(4)
  action_low: [-1.0, -1.0, -1.0, -1.0]
  action_high: [1.0, 1.0, 1.0, 1.0]
