developlcy-oss/Lv2_Cartlidar_Assignment/workspace/ros2_ws/src/control/config/drive.yaml

drive_node:
  ros__parameters:
    nav2_action: navigate_to_pose
    spin_action: spin
    stale_s: 0.3                   # result · /tfmini/range · /scan · odom 300 ms 규칙
    navigate:
      xy_goal_tolerance: 0.05      # 이 안의 목표는 nav2 spin 으로. navigation/config/nav2_params.yaml goal checker xy_goal_tolerance 와 같게
                                   # (Gazebo 2026-11-04: 0.025 면 마지막 옆 2 ~ 3 cm 를 못 메워 실패, #114). 정밀 위치는 align COARSE · FINE
      spin_time_allowance: 15.0
      backoff:                     # 박스 앞 정차 중 navigate → Nav2 전에 곧게 후진 (#157). 뒤 /scan (scan.rear_stop) · 뒤 카메라가 막히면 멈춰 기다림
        speed: 0.08                # [m/s]
        max_m: 0.30                # FINE 자리 (TFmini 0.13) → 0.35 확인까지 약 0.22 m. 이만큼 가도 확인 못 하면 되돌리고 Nav2
        timeout_s: 8.0             # 막혀 기다린 시간 포함. 넘으면 navigate 실패 (mission 재시도)
      # 위치 추정 상태로 목표 막기 (#121, include/control/loc_gate.hpp). loc_monitor (/localization/status) 가 없는 실행은 false
      #   (bringup 은 use_loc_gate 인자로 덮어씀, 기본 = use_loc_lock)
      loc_gate:
        enabled: true
        wait_s: 60.0               # 보내기 전 · 잃은 동안 Nav2 실패 뒤 OK 를 기다리는 최대 시간 (인지 모의 도구와 같음)
        stale_s: 1.0               # 상태를 이만큼 못 받으면 나쁜 상태 (loc_monitor 10 Hz)
        start_states: ["OK"]       # 이 상태에서만 목표를 보냄 · 다시 보냄
        run_states: ["OK", "SUSPECT"]   # 진행 중 이 밖으로 나가면 "잃음" (twist_mux 잠금과 같은 기준, loc_monitor OK_STATES)
    base:
      front_offset: 0.1328         # base_link → 차체 앞 끝 x ★ B안 상판 앞 끝 (make_maze_scene BODY_X, TFmini 렌즈 x 0.130, 계획기 poses.FRONT). 실측값이 있으면 그 값 (#31)
    align:
      rate_hz: 20.0
      kp_yaw: 1.2                  # 정밀: rad/s per 정규화 가로 오차
      kp_lin: 1.0
      max_angular: 0.6
      max_linear: 0.08
      lateral_tolerance: 0.04
      settle_cycles: 10
      coarse_kp_yaw: 1.5           # 먼 거리
      coarse_kp_lin: 0.8
      coarse_max_speed: 0.15
      coarse_max_angular: 0.8
      coarse_yaw_tolerance: 0.05
      coarse_min: 0.30             # 먼 거리 모드에서 이보다 작은 목표는 거부
      mode_wait_s: 0.5             # goal 뒤 첫 새 result 를 기다리는 시간 (모드 결정)
      lost_timeout_s: 0.5
      timeout_s: 30.0
      min_target_distance: 0.13    # 정밀 목표 = TFmini 렌즈 → 박스 앞면 [m]. 최소 측정 0.10 + box.stop_margin
      default_tolerance: 0.01      # ★ TFmini 실측 보정 뒤 반복 정밀도에 맞출 것 (사양 ±5 cm, 보정 없이는 1 cm 를 못 맞춤)
      box:                         # 정밀 전후 거리 = /tfmini/range (1층 TFmini → 퍽이 놓인 박스 앞면, 205 × 205 × 70 mm)
        window: 5                  # 최근 측정 수 (TFmini 50 Hz → 0.1 s)
        min_samples: 3             # 이 수 이상 유효해야 씀
        spread_m: 0.03             # 창 안 최대 − 최소가 이보다 크면 무효 (빔이 박스 모서리에 걸림)
        stop_margin: 0.03          # 정밀 동안 obstacle_stop 정지 거리 = 목표 − 이 값 (TFmini 최소 0.10 이상)
        stop_min: 0.10
        obstacle_stop_node: /obstacle_stop
        # 박스 앞 정차 (#157): FINE 이 박스 앞에서 끝나면 낮춘 정지 거리를 유지하고, TFmini 가 이 거리 이상을 연속으로 재면 (물러남) 되돌림
        park_release_m: 0.35       # = perception lidar.yaml obstacle_stop release_m
        park_release_count: 3      # = obstacle_stop release_count
        park_refresh_s: 20.0       # 정차 중 낮춘 값 다시 보내기 (< obstacle_stop approach_max_s 60 — 그 자동 복귀는 drive_node 가 죽었을 때만)
    scan:
      required: true               # 먼 거리 접근은 /scan 없으면 중지
      half_angle: 0.349            # ±20°
      front_margin: 0.10           # 물체보다 0.1 m 이상 가까운 점 → 정지
      rear_stop: 0.30
      rear_camera: true            # 후진 때 /perception/rear_obstacle (뒤 D435) 도 확인, 값 없음 = 막힘 (#84). bringup use_perception:=false 면 끔
    skill:
      enabled: false               # robot_policy(ONNX Runtime) 연결 전까지 false → goal 거절 → mission fallback
      policies_file: ""            # 예: /home/jetson/robot_ws/install/robot_policy/share/robot_policy/config/policies.yaml
      max_linear: 0.3
      max_angular: 1.5
      scan_bins: 360
      front_margin: 0.10             # 정책 주행: 범퍼 앞면(base.front_offset) + 이 거리 안에 점 (±scan.half_angle) → 전진 0, 회전 허용 ★
    turn:                          # 상자 퍽 45° 집기 제자리 회전 turn_p<deg> · turn_m<deg> · turn_0 (#77). skill.enabled 와 상관없이 받음
      kp: 2.0                      # (rad/s) / rad, 되먹임 = /odometry/filtered yaw, 기준 = 직전 FINE 정렬 성공 때 yaw
      max_angular: 0.6
      min_angular: 0.15            # ★ 실물에서 제자리 회전이 시작되는 최소 속도로
      tolerance_deg: 1.0           # 끝 yaw 허용 (이슈 ±1.5°)
      settle_cycles: 6             # 20 Hz × 6 = 0.3 s
      max_deg: 30.0                # 이보다 큰 회전 이름은 거부
      j1_x: 0.096                  # base_link → J1 축 x (mission_planner poses.J1_X)
      center_x: -0.04035           # 계획기가 가정한 회전 중심 = 외곽 가운데 (poses.CENTER_X)
      # 실제 제자리 회전 중심 x 는 robot_geometry.yaml base.icr_x (EKF odom_icr 와 같은 값, #92). J1 옆 이동이 같게 각을 바꿈: 17.06° → 14.3°
