developlcy-oss/Lv2_Cartlidar_Assignment/workspace/ros2_ws/src/perception/include/perception/engine_hash.hpp

// 엔진 파일 무결성 검사: SHA-256 과 sha256sum 형식 파일 읽기 (TensorRT · ROS 없이 시험할 수 있게 헤더 하나로 둔다)
// 일부 바이트가 변조된 엔진은 TensorRT 가 읽어 들이고 경고 없이 검출을 못 한다(장애 주입 F12, 2026-11-06).
#pragma once

#include <array>
#include <cctype>
#include <cstddef>
#include <cstdint>
#include <cstdio>
#include <string>

namespace perception
{

inline std::string sha256_hex(const void * data, size_t size)
{
  static const std::array<uint32_t, 64> k = {
    0x428a2f98, 0x71374491, 0xb5c0fbcf, 0xe9b5dba5, 0x3956c25b, 0x59f111f1, 0x923f82a4, 0xab1c5ed5,
    0xd807aa98, 0x12835b01, 0x243185be, 0x550c7dc3, 0x72be5d74, 0x80deb1fe, 0x9bdc06a7, 0xc19bf174,
    0xe49b69c1, 0xefbe4786, 0x0fc19dc6, 0x240ca1cc, 0x2de92c6f, 0x4a7484aa, 0x5cb0a9dc, 0x76f988da,
    0x983e5152, 0xa831c66d, 0xb00327c8, 0xbf597fc7, 0xc6e00bf3, 0xd5a79147, 0x06ca6351, 0x14292967,
    0x27b70a85, 0x2e1b2138, 0x4d2c6dfc, 0x53380d13, 0x650a7354, 0x766a0abb, 0x81c2c92e, 0x92722c85,
    0xa2bfe8a1, 0xa81a664b, 0xc24b8b70, 0xc76c51a3, 0xd192e819, 0xd6990624, 0xf40e3585, 0x106aa070,
    0x19a4c116, 0x1e376c08, 0x2748774c, 0x34b0bcb5, 0x391c0cb3, 0x4ed8aa4a, 0x5b9cca4f, 0x682e6ff3,
    0x748f82ee, 0x78a5636f, 0x84c87814, 0x8cc70208, 0x90befffa, 0xa4506ceb, 0xbef9a3f7, 0xc67178f2};
  std::array<uint32_t, 8> h = {
    0x6a09e667, 0xbb67ae85, 0x3c6ef372, 0xa54ff53a, 0x510e527f, 0x9b05688c, 0x1f83d9ab, 0x5be0cd19};
  const auto rotr = [](uint32_t x, int n) {return (x >> n) | (x << (32 - n));};
  const auto block = [&](const uint8_t * p) {
      std::array<uint32_t, 64> w{};
      for (int i = 0; i < 16; ++i) {
        w[i] = (uint32_t(p[i * 4]) << 24) | (uint32_t(p[i * 4 + 1]) << 16) | (uint32_t(p[i * 4 + 2]) << 8) | uint32_t(p[i * 4 + 3]);
      }
      for (int i = 16; i < 64; ++i) {
        const uint32_t s0 = rotr(w[i - 15], 7) ^ rotr(w[i - 15], 18) ^ (w[i - 15] >> 3);
        const uint32_t s1 = rotr(w[i - 2], 17) ^ rotr(w[i - 2], 19) ^ (w[i - 2] >> 10);
        w[i] = w[i - 16] + s0 + w[i - 7] + s1;
      }
      auto v = h;
      for (int i = 0; i < 64; ++i) {
        const uint32_t s1 = rotr(v[4], 6) ^ rotr(v[4], 11) ^ rotr(v[4], 25);
        const uint32_t ch = (v[4] & v[5]) ^ (~v[4] & v[6]);
        const uint32_t t1 = v[7] + s1 + ch + k[i] + w[i];
        const uint32_t s0 = rotr(v[0], 2) ^ rotr(v[0], 13) ^ rotr(v[0], 22);
        const uint32_t mj = (v[0] & v[1]) ^ (v[0] & v[2]) ^ (v[1] & v[2]);
        v = {t1 + s0 + mj, v[0], v[1], v[2], v[3] + t1, v[4], v[5], v[6]};
      }
      for (int i = 0; i < 8; ++i) {h[i] += v[i];}
    };
  const auto * bytes = static_cast<const uint8_t *>(data);
  size_t off = 0;
  for (; size - off >= 64; off += 64) {block(bytes + off);}
  std::array<uint8_t, 128> tail{};
  const size_t rest = size - off;
  for (size_t i = 0; i < rest; ++i) {tail[i] = bytes[off + i];}
  tail[rest] = 0x80;
  const size_t len = rest + 9 <= 64 ? 64 : 128;
  const uint64_t bits = static_cast<uint64_t>(size) * 8;
  for (int i = 0; i < 8; ++i) {tail[len - 1 - i] = static_cast<uint8_t>(bits >> (8 * i));}
  block(tail.data());
  if (len == 128) {block(tail.data() + 64);}
  std::string out;
  char buf[9];
  for (uint32_t x : h) {
    std::snprintf(buf, sizeof(buf), "%08x", x);
    out += buf;
  }
  return out;
}

// sha256sum 출력 한 줄("<64자리 16진수>  파일 이름")에서 해시를 꺼낸다. 형식이 틀리면 빈 문자열
inline std::string parse_sha256_file(const std::string & text)
{
  size_t i = 0;
  while (i < text.size() && std::isspace(static_cast<unsigned char>(text[i]))) {++i;}
  std::string hex;
  for (; i < text.size() && !std::isspace(static_cast<unsigned char>(text[i])); ++i) {
    hex += static_cast<char>(std::tolower(static_cast<unsigned char>(text[i])));
  }
  if (hex.size() != 64) {return "";}
  for (char c : hex) {
    if (!std::isxdigit(static_cast<unsigned char>(c))) {return "";}
  }
  return hex;
}

}  // namespace perception
