developlcy-oss/Lv2_Cartlidar_Assignment/(commit log)

2026-10-26 perception: 바코드 찾기 기본값을 R3 설계 46차 Python 기준(sat_hi_max 38, sharp_min -0.10)과 맞춤
2026-10-27 chore: 시뮬레이션 인수인계 zip 3개와 COMMANDS 문서를 git 추적에서 뺌
    저장소 최상위에 둔 URDF·USD·verify zip(261027_1711)과 COMMANDS_waffle_4wd_sim.md 는
    팀원이 보기 쉽게 둔 로컬 자료라 GitHub 에 올리지 않는다.
2026-10-27 feat: 증속벨트반영, drive 인자로 구동 구성 선택
    [controllers_4wd.yaml, opencr.ros2_control.xacro, robot.urdf.xacro]
2026-10-28 feat: TF·카메라 프레임 규약 정리, URDF 시험 확장, USD 정적 검사 추가
    [robot.urdf.xacro]
2026-10-28 feat: Isaac Sim 6.2 브리지 추가, TopicBasedSystem 연결
    [opencr.ros2_control.xacro, robot.urdf.xacro]
2026-10-30 feat(perception): 퍽 조사 등록부 추가
2026-10-30 fix(perception): 팔 카메라 목표 연결과 재획득 보완
    [depth_split.hpp, detector.hpp, perception.yaml, tag_detector.hpp, test_arm_detect.cpp]
2026-10-30 feat: urdf, usd, 매니퓰레이터 강화학습 내용 추가
    [base_link_part146_hull00.stl, base_link_part146_hull01.stl, base_link_part146_hull02.stl, base_link_part146_hull03.stl, base_link_part146_hull04.stl, base_link_part146_hull05.stl, base_link_part146_hull06.stl, base_link_part146_hull07.stl]
2026-10-31 perception: 원기둥 점수를 원형 띠로 세고 옆면 라벨은 직육면체로, 화면 밖 확인 지점은 모름으로 둠
2026-11-02 fix(opencr_hardware): IMU 바로 놓인 보드 기준으로 imu_link 수정
    [robot.urdf.xacro]
2026-11-02 fix(perception_survey): 모양은 팔 태그 관측으로만 확정
2026-11-04 fix(localization): loc_monitor 콜백에서 TF 를 기다리지 않게 함 (코어가 적은 Jetson 에서 검사가 모두 막히던 것)
    콜백 안 lookup_transform(timeout 0.1 s)이 MultiThreadedExecutor 작업 스레드를 모두 막아, TF 수신이 밀리고 검사가 판 끝까지 건너뛰어졌다(Jetson 부하 측정 판 4 · 5, PC 2 코어로 재현). 조회는 기다리지 않고, 스캔 시각 TF 가 아직이면 짝을 줄에 두어 다음 스캔 때 다시 검사한다(tf_wait_s 0.3). 실행기는 SingleThreadedExecutor(다시 찾기는 따로 작업 스레드). PC 2 코어 3 판: CPU 94 → 5~9 %, 검사 10 Hz, LOST 0.
2026-11-04 fix(localization): 종료 신호 때 RCLError 로 exit 1 나던 것 없앰
    SIGINT 가 대기 집합을 만드는 중에 context 를 닫으면 rclpy.spin 이 RCLError 를 내 launch 에 'process has died' 로 남았다(PC 2 코어 재생 판 2 · 3, scan_body_mask · scan_merge). context 가 이미 닫힌 때의 RCLError 만 조용히 끝내고 그 밖은 그대로 올린다. 네 노드 정상 SIGINT 종료 코드 0 확인.
2026-11-05 feat: 통합 launch 에서 plan 모드 미션 · 위치 추정 · 계획기 함께 실행
2026-11-05 feat: TopPick 강화학습 집기 실기 연결 · 집기→칸 이어 평가 · 정책 등록과 TP4 손 안 가운데 쥐기
2026-11-05 chore: chain_pallet_eval 결과 json 추적 제외, toppick_tilt 정책 사용법 주석 정정
2026-11-05 fix(perception): YOLO 배포 엔진 E2 -> E3 (480 · 384 FP16)
    경기장 판정(@0.6, Jetson)에서 E3 가 세 카메라 모두 E2 보다 높음: 앞 0.974 · 0.990, 뒤 0.979 · 0.998, 팔 0.956 · 0.981. 형식은 E2 와 같고 가중치만 바뀜. 단위 213/213, A1 3차 · F1 24회 통과(모의).
    [perception.yaml]
2026-11-06 docs(localization): amcl.yaml 첫 줄의 낡은 '기본 carto' 문구 고침
2026-11-06 docs(perception): nms_threshold 주석을 YOLO11n 기준으로 정정
2026-11-06 feat: observe · verify 팔 자세를 계산 자세로 (#65)
2026-11-06 feat(perception): arm_offset 정렬 기준점 arm.align_point (#14)
2026-11-06 chore(perception): 동작하지 않는 mock 시험 삭제, 경고 · 시험 시간 제한 정리
2026-11-06 fix(perception): 엔진 해시 파일이 있으면 대조해 변조 엔진을 쓰지 않음
    [engine_hash.hpp, perception.yaml, test_engine_hash.cpp]
2026-11-06 fix(localization): AMCL 이 pose 를 안 내도 map→odom 이 살아 있으면 LOST 로 보지 않음
2026-11-06 docs(localization): map 을 바꾸면 loc_map 도 같이 바꾸도록 안내
2026-11-06 fix(perception): 실물 팔 카메라 바코드 라벨 찾기 · 막대 방향 흐림
    [barcode_reader.hpp, perception.yaml, test_barcode.cpp]
2026-11-06 fix(perception): 팔 태그 줄여 찾기 · 바닥 무늬 거르는 문턱
    [perception.yaml, tag_detector.hpp, test_read_tag.cpp]
2026-11-06 feat:강화학습 집기 시작 자세 · 시간 상한, 집기 실패 시 target_look 부터 재시도 (#69), ArmIK::forwardPitch 를 (-pi, pi] 로 접음
2026-11-06 feat: 위치를 잃은 동안 Nav2 단계는 기다리고, 오래 걸리면 PAUSED (#111)
2026-11-06 feat: Nav2 통합 실행 · drive 위치 추정 확인 (loc_gate) · Gazebo 미션 연동 시험, 허용 오차 · ArmIK 각도 정리
    - bringup: use_nav2 (navigation.launch.py, 위치 추정 한 번), use_amcl_node 기본 = use_nav2, use_loc_gate
    - drive: navigate.xy_goal_tolerance 0.05 (= Nav2 goal checker), loc_gate (#121, loc_gate.hpp · test_loc_gate)
    - control: ArmIK::forwardPitch (−π, π] 로 접음 (#110)
    - robot_interfaces: LOCALIZATION_STATUS, docs/interfaces.md
    - mission_planner: mock_robot --real_nav, test/gazebo_mission.sh (Gazebo 주행 + mock), 결과 #135
    Refs #114 #135
2026-11-06 docs: requirements 에 로봇 전체 실행 패키지 추가
2026-11-06 fix(mission_planner): 대기 자리 거리를 0.01 m 단위로 골라 좁은 북쪽 통로에서 갇히지 않게 (#135)
2026-11-07 fix(bringup): 팔 카메라를 OpenCV 드라이버로 바꾸고 1280x720 으로 연다 (#119)
2026-11-08 fix(navigation): 목표 · 시작 칸이 잠깐 막혀도 전역 지도 지우고 다시 계획 · Gazebo 시험은 ROS 통신을 이 PC 안으로 (#135)
2026-11-09 feat(perception): 팔 Arducam 1280x720 실측 보정 파일 추가 (#143)
2026-11-09 fix(bringup): arm_camera_info_url 기본값을 실측 보정 파일로 (auto, none = 보정 없이) (#143)
2026-11-09 fix(perception): 거꾸로 달린 팔 카메라 영상을 180도 돌려 발행
2026-11-09 fix(bringup): 팔 카메라 best effort 손실을 막도록 공유 메모리 키움
2026-11-09 fix(sim): 모의 팔 카메라를 실물 보정값 (1280x720, fx 865.4) 으로 맞춤, Gazebo 는 주점까지 (#145)
    [waffle_4wd.urdf, waffle_4wd.urdf.xacro, waffle_4wd_loaded.urdf]
2026-11-09 fix(perception): 팔 카메라 버퍼를 2개로 늘려 30 Hz 유지
2026-11-09 fix(navigation): gazebo_sim 에서 loc_monitor 를 켜면 loc_map 도 같은 SDF 지도로, gazebo_mission.sh 에 GZ_ARGS (#133)
2026-11-09 fix(sim): Gazebo 팔 카메라 주점을 180도 회전 발행 값으로 수정
    [waffle_4wd.urdf, waffle_4wd.urdf.xacro, waffle_4wd_loaded.urdf]
2026-11-09 refactor(interfaces): /arm/skill_state · /arm/safety_state 삭제 (#86)
2026-11-09 fix(perception): 팔 영상의 촬영 시각 TF 를 처리 주기 안에서 잠깐 기다림
    [perception.yaml, test_tf_lookup.cpp, tf_lookup.hpp]
2026-11-09 fix(perception): READ_TAG 태그 검색을 한 번으로 합치고 자세만 크기별로 계산
    [tag_detector.hpp, test_read_tag.cpp]
2026-11-09 test(opencr_hardware): 실기 URDF 와 Isaac URDF 비교 시험 추가 (#112)
2026-11-09 fix(opencr_hardware): 바퀴 한계를 11.1 V 값으로 맞춰 Isaac 모델과 통일 (#15)
    [robot.urdf.xacro]
2026-11-09 fix(opencr_hardware): 실물 IMU 보드 방향에 맞춰 imu_link yaw -90도
    [robot.urdf.xacro]
2026-11-09 feat(bringup): 실물 기본 지도를 발제 SDF 지도로 (#116)
2026-11-09 test(opencr_hardware): 실기 Isaac 비교에 imu_link 90도 차이를 알려진 차이로 등록
2026-11-09 docs(navigation): 실물 첫 실행 순서
2026-11-09 feat(mission_planner): 발제 후 검토 제출물을 만드는 mission_submit 추가
    문제 파일 (신호 · 바코드 · 퍽 12 개) 또는 placement.csv 하나로 발제 07 쪽
    제출물 5 종을 만든다: problem.md · signals.json · placement.csv ·
    할당 정답표 (유효 할당 전부) · 검증 기록 (발제 04 쪽 운영자 검증 ① ~ ④).
    퍽 ID = 퍽 AprilTag ID 0 ~ 11. 규칙 위반이면 검증 기록에 원인을 쓰고 종료 코드 2.
    시험 2 건: Q1 예제 통과 (정답 6 개, CSV 입력도 같은 결과), 불가능 사례 X2 실패.
2026-11-09 feat(mission_planner): 도전 B 할당 알고리즘 비교 제출물 (mission_challenge_b, challenge/B)
    cases_b.yaml 6 건 (유효 4 · 불가능 2) 을 순차 선택 (allocate_greedy) 과
    탐색 (y_options + enumerate_allocations) 으로 돌려 challenge/B/ 에
    cases.json · expected.json · results.csv · report.md 를 만든다. 결론은 결과에서 계산.
    결과: 탐색 6/6, 순차 선택 3/6. 순차 선택은 V3 뿐 아니라 V1 (Q1 예제) ·
    V2 에서도 R · G 가 Y 에 필요한 모양을 먼저 가져가 실패한다 -> cases_b.yaml
    V1 · V2 에 greedy_fails 추가. 순차 선택은 불가능한 문제와 순서 때문인 실패를
    같은 오류로 낸다.
    설치본에서 실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
    [results.csv]
2026-11-09 docs(submission): 중간 제출물 — 노드 · 토픽 · 상태도, 신호 · 바코드 · 집기 시험 결과, 미완료 Issue
    - nodes_topics_states.md: 노드 구성, 미션 경로 노드 · 토픽 그래프, 상태도 3 개
    (실행 상태 · plan 모드 단계 · loc_monitor 위치 상태), 채점 기록 파일
    - test_results.md: 모의 · 실물을 나눠 기록. 단위 시험은 2026-11-09 최신 소스로
    다시 빌드해 perception 199 · control 49 · opencr_hardware 107 · mission_planner 19 실패 0.
    실물 확인은 바코드 (로봇 없이) 뿐, 신호 · 집기 · 전체 미션은 실물 미시험
    - open_issues.md: 열린 Issue 21 건 (파트 라벨 · 담당) 과 경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
2026-11-09 docs(interfaces): perception_survey 토픽 · 서비스의 mission 연동 반영
    #39 #53 으로 mission_node 가 plan 모드 survey 단계에서
    /perception/survey/start · finish · revisit 를 부름 ("mission 연동 미구현" 문구 정정).
    mission 은 /perception/puck_survey 토픽을 구독하지 않고 finish 응답의 완료 파일 경로를 쓴다.
2026-11-09 feat(opencr_hardware): 팔이 대기 자세가 아니면 시작 거부
    [opencr.ros2_control.xacro]
2026-11-09 fix(control): 박스 앞 FINE 정렬 뒤 낮춘 비상 정지 거리를 유지하고 navigate 전에 후진 (#157)
    [box_park.hpp, drive.yaml, drive_node.cpp]
2026-11-09 fix(control): FINE 정렬 하한 비교에서 float32 0.13 을 거부하던 것 고침
    [drive_node.cpp]
2026-11-09 test(mission_planner): Gazebo 박스 앞 정차 시험 gazebo_box_park.sh (#157)
2026-11-09 docs(submission): open_issues.md 에 #161 · #165 integration 라벨 반영
2026-11-09 feat(policy): TP8 손 안 반경 보상 정책 등록 · 이어 평가에 다시 쥐기와 고정 동작 집기 추가
2026-11-09 feat(control): toppick_tilt 를 위에서 내려오는 접근 경로로 (Isaac 고정 집기 검증)
2026-11-09 fix(perception): 팔 카메라 태그 검색을 줄이고 앞 영상 둘레 추적 추가
    [perception.yaml, tag_detector.hpp, test_read_tag.cpp]
2026-11-09 feat(mission): verify 에서 장소별 퍽 ID · 위치 기록과 전체 ID 중복 · 누락 판정
    verify 동안 /perception/pucks 를 칸에 넣어 (칸, 태그 ID) 별로 쌓고 verify 줄 ids 에 남김. 마지막 verify 뒤 verify_ids 줄에 중복 · 누락 · 기대 밖 ID 판정. CheckDice.srv 는 그대로. 단위 시험 7 개 추가.
2026-11-09 docs(mission_planner): verify 기록에 칸별 퍽 ID · 위치와 verify_ids 판정 설명 추가
2026-11-10 feat(bringup): 기본 미션을 plan 모드로, 옛 태그 미션표는 tag 일 때만 불러옴
2026-11-10 docs: 실행 · 운용 순서를 plan 미션 기준으로
2026-11-10 docs(mission): align.coarse_distance 0.45 근거를 적고 TODO 지움
2026-11-10 docs(mission): coarse_distance 측정 센서와 하한 · 상한 설명을 분명히
2026-11-10 chore: 미션 로그 · 이미지 등 로그 파일을 git 에서 제외
2026-11-10 feat(opencr_hardware): 팔 벤치 도구에 단계 이동 · 대기 자세 확인
2026-11-10 feat(navigation): footprint 에 주행 자세 팔 (앞 0.25), bt_navigator 서비스 대기 5 s (#114)
2026-11-10 docs: 켜기 전 팔을 대기 자세에 (#166)
2026-11-10 fix(perception): 둘레 추적이 놓친 태그를 줄여·키워 다시 찾고 그래도 놓치면 그 장에서 전체 검색
    [tag_detector.hpp, test_read_tag.cpp]
2026-11-10 fix(perception): 신호등 빨강·노랑을 켜진 칸 높이로 가름
    [perception.yaml, signal_light.hpp, test_signal_light.cpp]
2026-11-10 fix(bringup): D435 앞·뒤 시리얼 기본값 등록
2026-11-10 fix(perception): 신호등 지난 점멸도 칸 높이로 다시 읽고, 분명한 묶음은 한 번에 확정
    초록 칸을 본 뒤 그 전에 센 빨강·노랑 점멸도 켜진 등 높이로 다시 읽는다. 빨강·노랑이 모두 높이로 분명한 묶음은 한 묶음으로 확정하고, 애매하면 같은 순서 두 묶음을 기다린다(signal.confirm_clear_cycles, signal.height_margin_pitch). 실물 무작위 12회 5판 모두 정답 확정(4판 약 25 s, 1판 51 s, 이전 77.5 s). PC perception gtest 214개 실패 0.
    [perception.yaml, signal_light.hpp, signal_sequence.hpp, test_signal.cpp, test_signal_light.cpp]
2026-11-10 feat(perception): /perception/snapshot 요청마다 팔 카메라 사진 3 장 저장
2026-11-10 feat(mission): 미션마다 기록 폴더, 이동 전후 사진 요청, 계획기 기록 · 퍽 등록표 사본
2026-11-10 feat(bringup): log_dir 인자로 mission · 계획기 기록 위치와 퍽 등록표 경로를 맞춤
2026-11-10 docs(mission_planner): 미션 기록 폴더 · 사진 · 사본 위치 설명
2026-11-10 feat(control, mission): 켜질 때 주행 자세로 자동 정리 · STOW 실물 대기 자세 · 스트리밍 HOLD 안전 정지 (#144)
    - manipulator_node: arm_controller 준비 · 팔 HOLD 해제(/diagnostics opencr/motors arm_hold 0) 뒤 한 번,
    startup.stages 순서(J3 → J2 → J1 → J4 → J5·그리퍼, #165 실물 순서)로 startup.pose(DRIVE)까지 0.1 rad/s
    - HOLD 중 명령은 REARM 순간 튀므로 해제 뒤에만, 정리 중 goal 거절 · 정리 전 goal 이면 생략 · HOLD 시 중단 후 재판단
    - startup_stow.hpp + test_startup_stow, /joint_states NaN 은 값 없음, ArmPose 실패 시 result.message
    - manipulator.yaml: DRIVE 자세 추가(#114), STOW = 실물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
2026-11-10 feat(policy): TP9 (벌림 50 mm) 와 고정 동작 집기 등록 · 같은 날 이어 평가 비교
2026-11-10 fix: .gitignore 코어 덤프 규칙이 core.py 를 무시하지 않게, 중간 제출 기록 표를 snapshot 기록에 맞춤 (#177 #187)
2026-11-10 feat(mission): 측량 완료 파일의 pose 를 퍽 등록표에 옮겨 씀 (#193)
    writePucksFromSurvey 변환을 survey_pucks.hpp 로 옮기고 pose (standing | lying) 를 더함. 없거나 null 이면 쓰지 않음 (계획기는 standing 으로 읽음), 그 밖의 값은 오류. 새 gtest test_survey_pucks.
2026-11-11 feat(control, mission): 빈 장소 상자 앞은 퍽 없이 TFmini 거리로 접근 (approach_box) (#160)
2026-11-11 feat(mission, control): FINE 정렬 팔 자세를 READY → ALIGN (팔 카메라가 퍽을 보는 자세, #188)
    - manipulator.yaml: ALIGN [0, -1.854, 0.540, 1.645, 0, 0] 추가 (#154 ALIGN_A: 팔 카메라 수평 아래 34°,
    Gazebo 에서 FINE 시작 0.40 m · 끝 0.127 m 모두 퍽 2 개 화면 안, 팔 앞 끝 x 0.179 · 회전 반지름 0.182)
    - READY 는 남기되 mission 은 안 씀 (집게 위 +86° · 카메라 수평 위 71° = 하늘, 11-08 실물 상단 카메라 충돌)
    - mission_node: approach 의 COARSE 뒤 팔 자세를 align.arm_pose (기본 ALIGN) 로
    - skill.policies: [pick_cup_v1] → [toppick_tilt] (pick_cup_v1 은 모델 파일이 없어, 켜면 정책 전체가 로드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
2026-11-11 feat(control): 누운 직육면체 세워 놓기 계산 (관측 45 · β/ρ IK · 세울 자리 · 쥠) (#193)
2026-11-11 feat(control): manipulator_node lie_upright 스킬 (상자 측정 → r2e → 세운 자리 target_look) (#193)
2026-11-11 feat(perception): place_box 측정 사전값 토픽 /perception/place_box/prior (#193)
2026-11-11 feat(robot_policy): lie_upright 정책 r2e 등록 (#192 #193)
2026-11-11 feat(control): 지금 집게 자세에서 β·ρ 구하기 (위로 빼기용) · 시험 (#193)
2026-11-11 fix(control): lie_upright 놓음은 세울 자리 위에서만, 끝난 뒤 위로 빼기, 목표 누적은 보낸 값, 세울 자리 높이 29 mm (#193)
    [manipulator_node.cpp]
2026-11-11 docs(robot_policy): lie_upright 세울 자리 높이 설명 (#193)
2026-11-11 feat(control, robot_policy): 주사위 놓기 벌림 · 처짐 보정, 팔레트 속도 0.4, 45° 집기 k7 정책 (관측 33) 등록
    Isaac 검증 (IsaacLab .../policy/manipulator, 2048 대) 결과를 노드 설정에 반영.
    - place_<L>_* (placeAt): 놓을 때 벌림 place.release_position (기본 = 이전 동작, yaml 0.0798 = 36.4 mm),
    J1 바깥 처짐 보정 place.radial_offset_mm · radial_offset_slope_mm (기본 0, yaml 7.7 · −2.7).
    주사위 눈 연속 놓기 (dice_place_check.py): 노드 그대로 33.6 % -> 37.6 mm 벌림 48.3 % -> + 보정 90.0 %.
    - pallet.speed 0.8 -> 0.4: 2 열 칸에서 퍽 모서리가 테두리에 걸려 기울어 못 앉음 (집기 -> 넣기 48 대 42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
2026-11-11 fix(control, robot_policy): pallet.speed 0.8 로 되돌림, k7 넣기 연결 결과를 노드 방식 평가로 고침
    Isaac 연결 평가를 노드 runPalletSlot 과 같게 (궤적 place 구간 재생 + 처짐 보정 ki 4 + place_dwell 0.3 s) 바꿔 다시 잼 (2048 대):
    - 속도 0.8 원기둥 2003 · 직육면체 1991, 0.4 원기둥 2002 · 직육면체 1988 -> 0.4 이득 없음, 0.8 유지
    - 쥐기 −0.011 (노드 기본) 원기둥 2006 (97.9 %) · 직육면체 1980 (96.7 %), −0.0075 와 차이 거의 없음
    앞 커밋의 '2 열 칸 테두리에 걸림' 은 평가 쪽 손 IK 넣기 탓이었음 (노드 각본 아님).
    [manipulator.yaml, policies.yaml]
2026-11-11 feat(policy): TopPick 들기 전 퍽 밀림 벌점 (-300) · 학습 인식 오차 5 mm (TP10)
2026-11-11 docs(policy): 11-10 TopPick 28000 반복 학습 기록 (벌림 50 mm)
2026-11-11 feat(opencr): 바퀴 속도 한계 7.51 rad/s (T4 네 바퀴 맞춤) · 보드별 배터리 상태 (부저 비프 · 진단 · BatteryState)
    [opencr.ros2_control.xacro]
2026-11-11 fix(localization): loc_monitor 다시 넣는 자세 이동 보정 · Gazebo LOC=1 (#151)
2026-11-11 feat(control): 놓기 (place_*) 도 처짐 보정 스트리밍, 꺼내기 bias 이어 씀 · 실측 기록 도구
    - placeAt: sag.enabled · place.sag 면 pre → tip 직선 → 벌림 → 머묾 → back → transit 을
    팔레트와 같은 처짐 보정 스트리밍 (bias += ki dt (계획 − 측정)) 으로. 꺼내기 스트림이 끝 자세를
    계획 + bias 로 유지 중이면 그 bias 를 이어 씀 (아니면 sag.settle_time 먼저 맞춤).
    - 원인 (Isaac dice_place_check.py --unload, 노드 꺼내기 → 연속 놓기): 놓기가 꺼내기 bias 를 버려
    팔이 약 10 mm 처지고 퍽이 상자 윗면을 눌러 넘어짐 -> 판 전체 2.8 %.
    고친 뒤 216 대 93.1 %, 2048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
    [manipulator.yaml, manipulator_node.cpp, sag_comp.hpp]
2026-11-11 feat(perception): YOLO E3 배포 모델 원본(pt · ONNX · 해시 · 엔진 빌드 방법) 추가
    [E3_train_results.csv]
2026-11-11 fix(perception): .gitignore 에 걸려 빠진 E3 pt · ONNX 추가
2026-11-11 feat(mission_planner): 부분 실물 시험 stop_after (observe · first_pick · first_place)
2026-11-11 feat(control): 관절 속도 제한 시 행동 전체를 비율로 줄이기 · 시험 (#193)
2026-11-11 fix(control): lie_upright 속도 제한 scale · 3.0 rad/s, 상자 보기 자세 차체 비접촉, 놓음 수평은 퍽 중심 추정 (#193)
    [manipulator_node.cpp]
2026-11-11 feat(bringup): 실물에서만 mission diagnostics.timeout 3.0 (opencr/* 진단 끊김 안전 정지)
2026-11-11 feat(mission, mission_planner): 복귀 기록 return · 채점 스크립트 mission_score · 채점표 대응 문서
2026-11-11 feat(control): 세운 퍽 45° 집기 k7 (sidepick45_k7, 관측 33) 노드 조립 · toppick_tilt 를 정책으로 돌리는 설정
2026-11-11 chore(manipulator RL): 릴리스 rl-20261110 판 sidepick 환경 · 자기 충돌 복사본 (#192)
    누운 직육면체 환경이 상속하는 릴리스 판이 dev 에 없어 새 이름 (lie_base_env · lie_base_env_cfg · lie_arm_selfcol) 으로 복사함. 원본 작성자 developlcy-oss. 원본과 다른 줄: lie_arm_selfcol · lie_base_env_cfg 0, lie_base_env diff 로 다른 줄 8 (원본 import 3 줄을 빼고 5 줄로 바꿈: lie_arm_selfcol · URDF_PATHS 가져오기와 URDF_FULL 정의 · lie_base_env_cfg), 머리말 3 줄 제외. dev 에 릴리스 판이 들어오면 지움.
2026-11-11 feat(manipulator RL): 누운 직육면체 세워 놓기 학습 환경 Waffle-LieUpright (#192)
    상자 위 누운 직육면체를 쥐고 들어 손 안에서 세운 뒤 세울 자리에 놓는 환경 (B ~ B7 단계, 정책 r2g2 는 B7: 관측을 미션 노드와 같게, 관절 속도 비례 축소 · 노드 놓음 규칙 포함) 과 평가 · 진단 도구, 시작 상태, 기록. 퍽 질량은 이 환경에서만 실측값 (13.5 · 17.5 g). Isaac 모의 r2g2: v 3.0 팔-상자 접촉 없는 성공 95.7 %, 미션 노드 순서 모의 정책 단계 98.9 %.
2026-11-11 feat(robot_policy): 누운 직육면체 세우기 정책 r2e → r2g2 (노드 관측 · 속도 비례 축소 3.0 · 놓음 규칙으로 학습, #193)
2026-11-11 docs(control): lie_upright 주석의 학습 설정을 r2g2 로, r2e 기록 수치는 r2e 로 표시
2026-11-11 fix(mission): 재검증 기록에서 한 장소 안 같은 ID 를 한 퍽으로 합침 (#172)
2026-11-12 perception: place_box 화면 밖으로 나가는 후보 제외
    퍽에 가린 변과 화면 밖 변을 같은 대비 0 으로 보아, 윗면 변이 많이 가릴 때 화면 밖 사각형(앞 옆면 · 바닥 경계)이 이기던 것을 막음. 화면 밖 표본을 따로 세어 한 변이라도 2 % 넘으면 후보에서 뺌, 정사영 범위 밖은 화면 밖으로 봄.
2026-11-12 feat(mission_planner): 운영 방식 hybrid (싣다가 L 퍽이 다 모이면 바로 내림) 기본값 (#197)
2026-11-12 feat(mission_planner): 같은 박스는 세운 퍽 먼저 집기 (#193)
2026-11-12 feat(sim): B안 모델 생성기 다시 반영 (증속벨트 v6.1 · 캐리어 v7 · LDS-03 브라켓 v2) + 퍽 충돌 형상 (#220)
    [belt_belt.stl, belt_guard.stl, belt_metal.stl, belt_printed.stl, bolts.stl, bracket_L_hull00.stl, bracket_L_hull01.stl, bracket_L_hull02.stl]
2026-11-12 perception: 앞 D435 로 장소 상자 재기 (/perception/place_box/measure_front)
    SEARCH_FRONT 모드에서 앞 D435 컬러 + camera_info K 로 place_box 를 돌려 상자 윗면 중심 · 요를 잼. 결과는 팔 측정과 같은 토픽, status 에 camera. 요청 뒤 찍힌 장만 씀. 사전값 정하기는 두 서비스가 start_place_box 를 같이 씀.
2026-11-12 mission: 비스듬히 서기 흐름 (oblique.enabled, 기본 꺼짐)
    measure_box 를 대기 자리로 옮겨 앞 D435 측정 → 제자리 회전 → BOX 보기 자리 → box_look 0.44 m · 50° → 팔 place_box. verify 는 approach_view + box_look 0.40 m · 55°. |β| > 30° 는 같은 TFmini 로 가고 경고 · 기록(tfmini_wide). 계산은 oblique.hpp, 시험 test_oblique.
2026-11-12 feat(control, robot_policy): k8 정책 · 실측 관절 영점 보정 · 정책별 관절 속도 상한 · 놓기 옆 보정 · 집게 실측 대응 · ALIGN E2
2026-11-12 feat(control): box_look 7 필드로 거리 · 각 지정 (#226)
2026-11-12 fix(opencr_hardware): arm_controller 새 궤적을 원하는 상태에서 시작 (실물 덜컹 1.3° → 0.05°, #165)
    [controllers_4wd.yaml, controllers_6wd.yaml]
2026-11-12 perception: place_box 윗면 크기 배율 · 시차 보정, 아래 테두리 · 먼 변 검사
    팔 카메라 높이(정기구학)가 1 cm 틀리면 퍽 9 개 · 밝은 조명에서 아래 테두리나 엉뚱한 사각형을 잡아 60 ~ 95 mm 틀림(모의). 배율 0.94 ~ 1.06 을 같이 찾고 시차를 고치며, 옆면 띠 · 먼 변 검사로 틀린 후보는 못 찾음으로 냄. 앞 D435 는 배율 1 만(front_scales).
2026-11-12 feat(mission_planner): 시작 박스 집기 자리 회전 범위 turn_range_deg (#226)
2026-11-12 feat(control): 집게 쥠 판정을 위치 범위로 · 연속 쥠 신호 /manipulator/grasped (#201)
    - gripperHolding: 측정 위치가 [gripper.grasp_min_position, close_position − grasp_margin] 안이면 쥠.
    예전에는 '닫힘보다 덜 닫힘' 한쪽만 봐서 열린 채 (안 닫힘 · 모터 고장) 도 쥠으로 봤음
    (pick · toppick · pallet_load/unload · place 판정이 모두 이 함수)
    - /manipulator/grasped (std_msgs/Bool, gripper.grasp_rate 30 Hz, arm_joint 만): 같은 범위,
    켜짐 grasp_on_time 0.26 s (8 스텝) · 꺼짐 grasp_off_time 0.10 s (3 스텝) — 모의 정책 판정과 같은 꼴
    - grasp_detector.hpp (gripInGraspRange · GraspHysteresis) + test_gr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
2026-11-12 fix(control): 쥠 판정 상한을 마지막 집게 명령 기준으로 — 정책의 덜 닫는 명령에서 빈손을 쥠으로 보지 않게 (#201)
    - 정책 집기는 끝까지 닫지 않고 손가락 −0.0075 m (toppick_rl.closed_m, 약 0.636 rad) 로 명령 → 빈손이어도 그 자리에서 멈춤.
    상한이 닫힘 끝 기준 (0.773) 뿐이면 그 자리를 쥠으로 잘못 봄 (이 문제는 예전 판정에도 있었음)
    - 상한 = min(close_position − grasp_margin, 마지막 집게 명령 − gripper.grasp_cmd_margin 0.03) (graspUpperBound)
    고정 동작 (닫기 0.923) 은 0.773 그대로, 정책 닫기면 약 0.606 — 원기둥 쥠 0.571 · 직육면체 0.471 은 쥠, 빈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
    [grasp_detector.hpp, manipulator.yaml, manipulator_node.cpp]
2026-11-12 fix(control): 강화학습 집기 성공에 위치 쥠 판정도 요구 — 빈손 success 막기 (#201)
    - toppick_rl 성공 조건이 손가락 범위 (grasp_finger −0.010 ~ −0.003 m) 만 봐서, 정책 닫기 값 closed_m −0.0075 자체가
    범위 안이라 빈손으로 닫아 들어도 성공으로 판정 (11-12 실물 집기 1: 빈손인데 success: true)
    - held 에 gripperHolding() (마지막 닫기 명령보다 grasp_cmd_margin 넘게 덜 닫힌 채 막힘) 을 AND
    - 퍽 쥠 0.47 ~ 0.57 rad < 상한 약 0.606 → 그대로 성공, 빈손 (명령 자리 약 0.636) → 성공 아님
    [manipulator_node.cpp]
2026-11-12 feat(mission_planner): 싣지 않을 팔레트 칸 avoid_slots (#219)
    #219 (G_2 · G_3 칸 문제) 의 계획기 쪽 우회책. 지정한 팔레트 칸에는 퍽을
    싣지 않는다. 기본값은 빈 목록이라 지정하지 않으면 지금 동작과 같다.
    - planner.py: parse_slots("2:1,2:2") -> [(2,1),(2,2)], 잘못된 입력은 ValueError.
    plan(avoid_slots=) 에서 검사 후 방식별로 넘기고, 경고에
    "팔레트 칸 … 안 씀 (avoid_slots, #219)" 을 남김.
    - hybrid: 1·2열 칸 수 (front_cap) 와 최대 적재 수 (capacity) 를 뺀 칸만큼
    줄여 plan_hybrid 에 넘김.
    - per_location: 칸 목록에서 빼고 모자라면 3열 칸을 앞에 채움.
    - sing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
2026-11-12 fix(bringup): sim 인자를 diag_timeout 보다 먼저 선언 (sim:= 없이 띄우면 launch 실패)
2026-11-12 test(mission_planner): Gazebo LOC=1 명령 시간 초과 감시 · Nav2 기동 실패 처리 (#151)
2026-11-12 opencr_hardware: 앞 D435 피치를 실물 실측값으로 (35.20° → 32.62°)
    실물 앞 D435 가 기준 모델보다 약 2.6° 덜 숙여짐. 화면 태그 판 PnP 4 번 · 깊이 책상 평면으로 확인, 고친 값의 남은 피치 +0.09 · +0.16°. test_model_compare 알려진 차이 표에 이유와 함께 넣음.
    [robot.urdf.xacro]
2026-11-12 feat(mission_planner): 팔레트 칸 배정에 퍽 모양 반영 · 열 안 차례 row_rule (#230)
2026-11-12 feat(navigation): 속도 한계 인자 · 시작 지연 · PathAlign 28
    Gazebo: 모서리 멈춤 3/3 → 0/3, 미션 Q1 DONE
2026-11-12 fix(opencr_hardware): diff_drive 회전 상한 2.0 → 1.0 rad/s (벨트 보호)
    [controllers_4wd.yaml]
2026-11-12 fix(opencr_firmware): 팔 ESTOP 처짐 목표 유지 · 관절 2·3 I 게인 · 손목 가속 제한 (#165)
    실물 cart11 측정 (2026-11-12, meas_session 메뉴 13 · 키보드 E-stop):
    - ESTOP 순간 목표를 처진 현재 위치로 바꿔 팔이 '툭' 내려가고 REARM 뒤
    덜컹 올라감 -> 멈춰 있고 (|vel| <= 5 raw) 목표와 차이가 처짐 정도
    (ESTOP_KEEP_GOAL_TICKS 60 tick) 안인 관절은 마지막 승인 목표 유지.
    움직이는 중이거나 차이가 크면 지금처럼 현재 위치에서 멈춤.
    - 관절 2 · 3 이 P 만으로 1 ~ 3° 처지고 방향에 따라 1.5 ~ 2° 다름
    -> ARM_POS_I_GAIN 관절 2 · 3 = 100 (D 는 엔코더 출렁임이 없어 0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
    [config.h, opencr_firmware.ino, safety_core.h, sil_board.hpp, test_firmware_sil.cpp]
2026-11-12 fix(opencr_hardware): 대기 자세 검사에서 그리퍼는 펌웨어 범위 전체 허용
    [opencr.ros2_control.xacro]
2026-11-12 fix(arm): E-stop · REARM 때 팔 튐 — 붙잡은 목표 유지 · REARM 뒤 천천히 따라감 (#165)
    2026-11-12 cart11 실물 (#242 펌웨어 뒤): x 순간 처짐은 사라졌지만 r 때 3 ~ 15° 튐.
    잠긴 동안 arm_controller 궤적은 계속 나아가고, REARM 순간 펌웨어가 그 자리로 한 번에 감.
    - opencr_hardware: ArmRearmSlew (estop_latch.hpp). 잠기는 순간 펌웨어가 붙잡는 목표를
    같은 규칙 (60 tick · 5 raw) 으로 추정하고, 풀린 뒤 호스트 명령까지 rearm_slew_rad_s
    (기본 0.3, 0 = 끔) 이하로 따라감. 관절 1 ~ 5 만. 단위 시험 3 개.
    - manipulator_node: /e_stop 상승 때 arm_controller reference 로 붙잡힌 목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
    [estop_latch.hpp, manipulator_node.cpp, opencr_hardware.cpp, opencr_hardware.hpp, test_estop_latch.cpp]
2026-11-12 feat(robot_policy, control): 세운 퍽 45° 집기 k9 (실측 지연 학습) 추가 · skill.horizon 시험 권장 주석
    - k9 = k8 + 실측 지연 0 ~ 66 ms (명령 -> 팔 반응, #190) 넣고 이어 학습. 관측 33 · 행동 tcp_delta(4) 는 k8 과 같음 (노드 코드 그대로).
    - Isaac 노드 조건 (퍽 좌표 ±2 mm 고정, 관절 변화 상한 4.0 rad/s, 지연 건) 2048 대:
    지연 0 ~ 66 ms: 원기둥 75.7 % · 직육면체 86.3 % (k8 69.5 · 82.5),
    지연 0 ~ 33 ms: 원기둥 91.4 % · 직육면체 93.1 %.
    - manipulator.yaml: sidepick45_k9 정책별 값 (k8 과 같음), skill.horizon 1.5 -> 1.0 (지연 50 -> 33 ms) 시험 권장 주석. 기본값은 바꾸지 않음.
    - 쓰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
2026-11-12 feat(tools): 실물 팔 실측 · 시험 도구 arm_bench/real (#190 · #192 · #165)
    2026-11-11 ~ 12 cart11 에서 쓴 도구를 팀 저장소에 둔다 (지금까지 젯슨 홈에만 있었음).
    kbd_joy (키보드 REARM · E-stop) · meas_session (실측 메뉴 · 떨림 측정, E-stop 때 goal 취소
    뒤 이어서) · pick_test · lie_test (영상 · 관절 · 로그 기록) · estop_rec (E-stop 시험 기록).
2026-11-12 mission: 시작 박스를 재서 회전각 · target_look 맞추기 (#226, start_box.enabled 기본 꺼짐)
    시작 박스 대기 자리에서 앞 D435 measure_front 로 상자를 재고, turn_* 를 남는 퍽 면 어긋남이 가장 작은 이름 각(turn_range_deg ∩ ±30°, icr_x 둘레)으로, target_look 을 잰 상자에서 낸 odom 자리로 바꿈. 계산 start_box.hpp + gtest, mock_robot 에 measure_front 가짜 · icr 둘레 회전 · events. |rot| ≥ 40° 면 ±45 부호 모호 경고.
2026-11-12 perception: 팔 place_box 배율 후보 5 → 3 개 (Jetson 처리 시간)
    실물 Jetson(카메라 3 대 + perception 부하)에서 팔 place_box 장당 p95 4.77 s 로 기준 3 s 를 넘음. 배율을 [0.96, 1.0, 1.04] 로 줄임(계산 약 2.9 s, 실물 다시 잼). 모의: 카메라 높이 ±0.01 m 112 장 15 mm 안, 가림 틀린 값 0, 회귀 같음.
2026-11-13 perception: udev 규칙에 TFmini · 라이다 실제 값 넣기
    TFmini 변환기(CP2102N)는 고유 시리얼로, 시리얼이 같은 라이다 두 대는
    USB 경로(ID_PATH, 앞 2.3.5 · 뒤 2.3.1)로 잡는다.
2026-11-13 opencr_hardware: 뒤 D435 피치를 실물 실측값 0.5926 rad 로
    깊이 바닥 평면에서 URDF 보다 1.25° 덜 숙여져 있음. 다른 바닥 자리에서 남은 피치 +0.19°. test_model_compare 알려진 차이 표에 한 줄.
    [robot.urdf.xacro]
2026-11-13 feat(tools): 팔 스킬 teleop arm_cmd.sh + Isaac 시뮬 스킬 서버 (꺼내기 · 놓기 연습)
    - arm_bench/real/arm_cmd.sh: sim · real 같은 명령으로 스킬 하나 (pick · load · unload · place · look · place_cell · raw, 시뮬 전용 transit · reset · cells · status · clear · fill)
    - arm_bench/real/sim_cmd.py: /sim_skill/cmd 보내고 /sim_skill/result 기다림 (끝 코드 0 · 1 · 2 · 3)
    - policy/manipulator/tools/sim_skill_server.py · sim_skill.sh: Isaac Lab 창 1 개, 노드와 같은 스킬 이름 (k9 집기 · 팔레트 처짐 보정 · placeAt), .gpu_lock
    - 지금은 IsaacLab 쪽 학습 코드 (act_delay · unload_traj · k9 .pt) 에 기댐 — tools/README.m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
2026-11-13 feat(tools): dice.sh 를 arm_cmd.sh 위로 합침 (#254 통합)
    - 넣는거 세션 dice.sh (#254) 를 가져오고, 실물 직접 전송 분기 (arm_cmd.sh 와 같은 스킬 이름 매핑) 를 빼서 스킬은 언제나 arm_cmd.sh 로 보냄
    - real/README.md: arm_cmd.sh · dice.sh 한 절로
2026-11-13 localization: scan_body_mask 가 스캔 점 수가 바뀌어도 죽지 않게
    실물 라이다가 한 바퀴 점 수를 399 · 400 으로 바꿔 내서 학습 마스크 OR 에서 ValueError 로 노드가 죽음. 긴 쪽 길이로 맞춰 합치고 단위 시험 추가.
2026-11-13 feat(opencr): RC-100 리모컨 주행 시험 (rc100:=true)
    바퀴 펌웨어가 BT-410 버튼을 STATE 빈 팔 칸에 실음 (v5 그대로)
    호스트 /rc100/raw → rc100_joy → /joy, Nav2 와 따로
2026-11-13 fix(opencr_firmware): RC-100 수신 UART1 → UART2 (Serial4)
    실물: BT-410 슬레이브는 UART2, UART1 은 0 바이트
    [opencr_firmware.ino, rc100_joy.py, sil_board.hpp, test_firmware_sil.cpp]
2026-11-13 fix(mission_planner): 팔레트 꺼내기 막는 쌍 반영 · 모양 벌점 28 m (#230)
2026-11-13 feat: 팔레트 v5 · Jetson 배터리 · 바퀴 R31.5 반영, 계획기 10칸 · 막는 쌍 v5, TP11 등록
    [belt_guard.stl, belt_metal.stl, belt_printed.stl, bolts.stl, brackets.stl, controllers_4wd.yaml, controllers_6wd.yaml, corner_FL_hull00.stl]
2026-11-13 refactor(mission · mission_planner): 시작 박스 · 비스듬히 서기 기하 값을 자세표 geom · robot_geometry 에서 읽기 (#226)
2026-11-13 fix(opencr_hardware · mission_planner): LDS-03 브라켓 v2 라이다 자리 반영 (#249)
    [robot.urdf.xacro]
2026-11-13 feat: 퍽 무게 실측 반영 · 팔 영점 보정 도구 arm_calib · 실측 메뉴 v5 칸
    [waffle_4wd.urdf.xacro, waffle_4wd_loaded.urdf]
2026-11-13 fix(navigation · sim): Gazebo 도 실물처럼 EKF (IMU yaw rate) 로 odom — 바퀴 회전 22 % 과대로 LOST 잦던 것 (#151)
2026-11-13 perf(mission_planner): 외곽 판정에서 장애물 외곽을 한 번만 계산 — World 시작 33 → 3 s (#265)
2026-11-13 perf(bringup): odom_icr 를 C++ 로 (Python CPU 약 3 분의 1, #265)
2026-11-13 fix: 주행 자세 DRIVE = E2 · 켤 때 순서 J3→J2→J4→J1 (관절 3 ↔ 팔레트 v5 퍽 충돌), TopPick 팔레트 퍽 틈 벌점 TP13
    [manipulator.yaml, manipulator_node.cpp, startup_stow.hpp]
2026-11-13 feat(control): 팔 관절 이동을 최소 저크 곡선으로 · 켜질 때 정리 속도 0.3 rad/s
2026-11-13 refactor(mission · mission_planner): 비스듬히 서기 장소 상자 반 변 · TFmini 렌즈 x 도 자세표 geom 에서 읽기 (#262)
2026-11-13 docs(mission_planner): avoid_slots 예시는 예전 DRIVE 우회책 — E2 뒤 기본 빈 값 (#219)
2026-11-13 fix(control): 팔레트 궤적 출발 시 팔꿈치가 퍽 스토리지를 누름 — 영점 보정 제외 · 출발 자세 검사 · 정리 전 명령 거절
    [manipulator.yaml, manipulator_node.cpp]
2026-11-13 feat(tools): arm_motion_check.py — 팔 자세 이동 bag 에서 속도 · 추종 오차 · 떨림 · 집게 숙임 표
2026-11-13 fix(control): 팔레트 궤적 영점 보정 제외 · 출발 자세 검사 · 정리 전 명령 거절 · 꺼내기 빈손이면 빠져나온 뒤 실패
    [manipulator.yaml, manipulator_node.cpp]
2026-11-13 fix(control): 이름 자세 · 켜질 때 정리를 알려진 자세 근처에서만 — 칸 안에서 pose DRIVE 로 프로파일 충돌
    - 2026-11-14 실물 (bringup_261114_0049.log): 빈 칸 꺼내기 실패로 칸 안 (J1 2.66 rad) 에 멈춘 채
    /manipulator/pose DRIVE → 관절 공간 직선 이동으로 J1 이 돌며 오른쪽 프로파일에 충돌
    - 같은 브링업에서 켜질 때 정리도 칸 안 자세에서 실행됨: 팔 HOLD (토크 켠 채 호스트만 재시작) 면
    하드웨어 대기 자세 검사를 건너뜀
    - pose.front_j1_max (0.6) · pose.start_tolerance (0.2): |J1| 이 크면 (뒤 · 옆) 알려진 자세 (poses.* ·
    팔레트 이동 자세 · 칸 앞 자세)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
    [manipulator.yaml, manipulator_node.cpp]
2026-11-14 fix(perception): 단독 실행용 TFmini 인자를 standalone_tfmini 로 — bringup use_tfmini 가 넘어와 tfmini_node 가 두 번 뜨던 것
2026-11-14 fix(control): 집은 퍽을 옆 퍽보다 높이 들고 팔레트는 높이 이동 · 칸 위 수직 넣기로
    - toppick_tilt (top 경로) 쥔 뒤 들기 0.05 → toppick.lift_height 0.085 m.
    예전 0.05 는 옆 퍽 (60 mm) 보다 낮아, 다음 pallet_load 의 관절 직선
    이동 (든 자세 → 궤적 첫 점) 중 쥔 퍽이 상자 위 옆 퍽을 침 (FK −2.4 mm).
    J1 축 toppick.lift_max_radius (0.32 m) 밖 퍽은 45° 로 곧장 못 들어
    들며 J1 쪽으로 (거리 − 0.32) 당김. pick (수평) 은 pick.lift_height 그대로.
    - 팔레트 궤적을 높이 이동 판으로 (pallet_traj_direct.py 새로 추가):
    퍽 바닥 0.230 m 에서 J1 회전 → 같은 높이로 칸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
    [manipulator.yaml, manipulator_node.cpp]
2026-11-14 feat(tools): Isaac 노드 동작 평가에 새 들기 · 칸 채우기 · 엄격 판정, 실물 pick_test 에 넣기 · 옆 퍽 다시 재기
    - chain_pallet_eval.py: 고정 동작 집기 들기 = ROS toppick.lift_height · lift_max_radius
    (--lift_h 0.085, --lift_rmax 0.32). --occ_all + --occ_rows planner|all 로 팔레트 칸에
    퍽을 미리 앉힘 (planner = 목표 열 · 뒤 열만, mission_planner 열 규칙). --traj 로 궤적 비교,
    --slots 로 칸 지정. 엄격 판정: 넣기 성공 + 옆 퍽 3 mm · 서 있음 · 팔 안 닿음 + 칸 퍽 1 N · 3 mm.
    - pick_test.py: J1 축에 가장 가까운 퍽부터 (mission 과 같음), --load 열 칸 이면 이어서
    pallet_load, --rec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
2026-11-14 fix(opencr_hardware): 컨트롤러를 spawner 하나로 · 서비스 시간 초과 늘림 — Jetson 시작 때 잠금 다툼으로 실패 (#275)
2026-11-14 test(bringup): bringup 을 N 번 띄워 컨트롤러 · /joint_states 를 세는 시험 (#275)
2026-11-14 fix(bringup): /joint_states 가 나온 뒤 인지 · 위치 추정 · 계획기 · Nav2 를 띄움 (#275 · #276)
2026-11-14 fix(opencr_hardware): spawner 응답 대기 60 → 15 s (응답을 잃으면 빨리 다시 물음, #275)
2026-11-14 fix(opencr_firmware · opencr_hardware): HOLD 중 막힌 관절 풀기 · 모터별 HW 오류 · 온도 STATE 진단 · 토크 ON 전 목표 쓰기 (#277 · #259)
    - 펌웨어 releaseStalledHold (#277 2): HOLD 중 멈춰 있고 목표 − 현재 > 20 tick 이 2 s 동안 3 tick 도 줄지 않으면
    그 관절 목표를 현재 위치로 (막힌 채 계속 밀지 않음). 처짐이 줄어드는 관절 · 작은 차이 · 움직이는 관절은 그대로.
    호스트 ArmRearmSlew 도 같은 규칙으로 추정 (REARM 때 현재 위치에서 출발).
    - 모터 진단 (#259 1): 각 보드가 STATE 의 안 쓰는 쪽 칸 vel · effort 에 모터별 Hardware Error Status · 온도
    (opencr_protocol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
    [config.h, estop_latch.hpp, opencr_firmware.ino, opencr_hardware.cpp, opencr_hardware.hpp, opencr_protocol.h, opencr_protocol.hpp]
2026-11-14 feat(drive · sim): 증속벨트 v7 (44T → 22T, 1:2.0) 기어비 · 바퀴 한계 · 모서리 형상 반영
    [belt_belt.stl, belt_guard.stl, belt_metal.stl, belt_printed.stl, bolts.stl, brackets.stl, corner_FL_hull00.stl, corner_FL_hull01.stl]
